mworion/MountWizzard4/README.rst

MountWizzard4
=============

.. note:: MountWizzard4 Version3 moved to a new repository
          https://github.com/mworion/MountWizzard4v3
          Only in case of interests in version 3, please
          refer to this repo. From now on MountWizzard4 repo
          is for version 4 and later.

Documentation:
--------------
There is a documentation available for MountWizzard4 (including the installation):
Please be noted that with the new installation you net not to install any python
package yourself!

https://mworion.github.io/MountWizzard4/index.html

Welcome to MountWizzard4 is a utility for 10micron users for improving the
workflow for astronomy work and imaging runs on Windows (10 and 11), OSx (Big Sur
- 26), Linux (Ubuntu 18.04 - 24.04) and some Linux ARM64 distributions
(Astroberry and StellarMate - both 64 bit). As a python application, it should
run in all environments supporting python 3.12-3.14 and PySide6 as a GUI
framework.

For being fully operational, MountWizzard4 needs either:

-   INDI server(s) (see: https://indilib.org) where your devices are connected to.

-   INDIGO server(s) (see: http://www.indigo-astronomy.org) where your devices
    are connected to.

-   ASCOM Alpaca remote server (see: https://ascom-standards.org/FAQs/Index.htm)
    abstracting your ASCOM devices or devices which speak native ASCOM Alpaca if
    you want to connect over IP with your environment.

-   For the core devices there is native ASCOM support (Windows platform only).
    Please be reminded, that ASCOM has 32bit and 64bit driver implementations
    and MW4 v4.x should **not** be installed in 32bit as it causes in some
    environments troubles. Please stay with a 64 bit python environment.

-   In addition an internet connection is used for some services which might be
    very helpful.

It is recommended to use mount firmware 3.4 or later as some
of the functions don't work with older firmware versions. It should not be a
problem using older versions. A HW pre2012 might also have some issues.

Versions, downloads
-------------------

(actually not relevant as no first release was issued)

|PYPI_VERSION| |PY_VERSIONS| |DownLoadsAbs| |DownLoadsMonth|

Code quality / tests:
^^^^^^^^^^^^^^^^^^^^^
|CODECOV| |PYTEST macOS| |PYTEST Windows| |PYTEST Ubuntu|

Code changes:
^^^^^^^^^^^^^
|OPEN_ISSUES| |CLOSED_ISSUES| |OPEN_PR|

Test install / run scripts:
^^^^^^^^^^^^^^^^^^^^^^^^^^^
|TEST_SCRIPTS_PYPI| |TEST_SCRIPTS_PACKAGES|

Test coverage:
^^^^^^^^^^^^^^
|CODECOV_CHART|

Commit status:
^^^^^^^^^^^^^^
|COMMITS_WEEK| |COMMITS_MAIN|

Changelog:

https://mworion.github.io/MountWizzard4/changelog/index.html

And there are some videos available for explanation in Youtube channel:

https://www.youtube.com/channel/UCJD-5qdLEcBTCugltqw1hXA/

Feedback discussions and issue reports:
---------------------------------------
Please report your issues: https://github.com/mworion/MountWizzard4/issues.
Please have a good description (maybe a screenshot if it‘s related to GUI) and
add the log file(s) to the issue. Any feedback welcome!

Please feel free to start any discussion:
https://github.com/mworion/MountWizzard4/discussions

Finally:
--------
MountWizzard4 is 'always' in development. The use this software is at your own
risk! No responsibility for damages to your mount or other equipment or your
environment, please take care yourself!

Hope this tool makes fun and helps for your hobby,

CS Michel

.. |PY_VERSIONS| image::
    https://img.shields.io/pypi/pyversions/mountwizzard4.svg

.. |PYTEST macOS| image::
    https://img.shields.io/github/actions/workflow/status/mworion/mountwizzard4/unit_macOS.yml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

.. |PYTEST Windows| image::
    https://img.shields.io/github/actions/workflow/status/mworion/mountwizzard4/unit_win.yml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

.. |PYTEST Ubuntu| image::
    https://img.shields.io/github/actions/workflow/status/mworion/mountwizzard4/unit_ubuntu.yml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

.. |CODECOV| image::
    https://codecov.io/gh/mworion/MountWizzard4/branch/main/graph/badge.svg
    :target: https://codecov.io/gh/mworion/MountWizzard4

.. |CODECOV_CHART| image::
    https://codecov.io/gh/mworion/MountWizzard4/branch/main/graphs/icicle.svg
    :target: https://codecov.io/gh/mworion/MountWizzard4
    :width: 80%
    :align: top

.. |OPEN_ISSUES| image::
    https://img.shields.io/github/issues-raw/mworion/mountwizzard4
    :target: https://github.com/mworion/MountWizzard4/issues

.. |CLOSED_ISSUES| image::
    https://img.shields.io/github/issues-closed-raw/mworion/mountwizzard4

.. |OPEN_PR| image::
    https://img.shields.io/github/issues-pr-raw/mworion/mountwizzard4

.. |COMMITS_MAIN| image::
    https://img.shields.io/github/commits-since/mworion/mountwizzard4/main
    :target: https://github.com/mworion/MountWizzard4/commits/main

.. |COMMITS_WEEK| image::
    https://img.shields.io/github/commit-activity/w/mworion/mountwizzard4

.. |TEST_SCRIPTS_PYPI| image::
    https://img.shields.io/github/actions/workflow/status/mworion/mountwizzard4/test_scripts_pypi.yml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

.. |TEST_SCRIPTS_PACKAGES| image::
    https://img.shields.io/github/actions/workflow/status/mworion/mountwizzard4/test_scripts_packages.yml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

.. |PYPI_VERSION| image::
    https://img.shields.io/pypi/v/mountwizzard4.svg
    :target: https://pypi.python.org/pypi/mountwizzard4

.. |DownLoadsAbs| image::
    https://static.pepy.tech/badge/mountwizzard4
    :target: https://pepy.tech/project/mountwizzard4

.. |DownLoadsMonth| image::
    https://static.pepy.tech/badge/mountwizzard4/month
    :target: https://pepy.tech/project/mountwizzard4
