mworion/MountWizzard4/2026-09-26-review.md

# MountWizzard4 – Project Review (2026-09-26)

Scope: `src/mw4` (excluding generated `src/mw4/gui/widgets`), `tests/`, `pyproject.toml`,
repository hygiene. Version reviewed: `4.0.0b34`.

Severity: **H** = likely bug / correctness risk, **M** = robustness / maintainability risk,
**L** = style / cleanup.

---

## 1. Overview

| Metric | Value |
|---|---|
| Python source files (w/o widgets, `__init__`) | 204 |
| Unit test files | 205 |
| Source lines (w/o widgets) | ~31.6k |
| Largest modules | `logic/buildData/alignstars.py` (840), `mountcontrol/obsSite.py` (740), `gui/styles/styleSheets.py` (703), `gui/mainWaddon/tabMount_Sett.py` (530) |
| `# pragma: no cover` in src | 0 |
| Fixture scopes | 166× `module`, 4× `function`  |

Overall the code base is in good shape: consistent src layout, near complete type
annotations, f‑strings, dataclasses/TypedDict, pathlib, context managers, timeouts on all
`requests` calls, no `eval`/`pickle`/`shell=True`/unsafe `yaml.load`, and a test file for
almost every module. The findings below are mainly about threading details, error
handling, protocol parsing robustness and architectural coupling.

---

## 2. Architecture

### 2.1 Strengths
- Clear layering `base` → `logic`/`mountcontrol` → `gui`; no `QtWidgets`/`QtGui` or
  `mw4.gui` imports found in `logic`, `base` or `mountcontrol`.
- `DeviceRegistry` + `DeviceEntry` give a uniform device lifecycle
  (`initConfig`/`storeConfig`/`startDevices`/`stopDevices`).
- Central `TimeManager` for cyclic updates instead of many scattered `QTimer`s.
- Generic worker infrastructure (`base/tpool.py`) with a per-worker mutex that prevents
  overlapping runs of the same job.
- Driver abstraction (INDI / ALPACA / ASCOM / SGPro / NINA) via common base classes
  (`AlpacaAscomCommon`, `DriverData`).

### 2.2 Findings

| # | Sev | Location | Finding |
|---|-----|---|---|
| A1 | M | `src/mw4/mainApp.py:34-111` | `MountWizzard4` acts as service locator / god object: 25 app-wide signals plus `threadPool`, `config`, `dReg`, `mainW`, `buildPoint`, `hipparcos`, `ephemeris`. Every component receives `app` and reaches through it (`self.app.dReg["mount"].obsSite...`), so dependencies are implicit and hard to test in isolation. Consider injecting only the needed collaborators or grouping signals into dedicated signal objects (UI, model, satellite). |
| A2 | M | `src/mw4/base/deviceEntry.py:28-80` | `DeviceEntry` re-exports many attributes of the wrapped instance (`signals`, `data`, `run`, `framework`, `obsSite`, `setting`, `location`, `timeJD`, `model`, …). This is a growing proxy that encodes mount-specific knowledge in a generic entry and encourages long attribute chains (law of Demeter). A typed accessor (`dReg.mount -> MountDevice`) would be clearer and type-checkable. |
| A3 | M | `src/mw4/base/deviceRegistry.py:47-52` | Test-only branch in production code: `if hasattr(app, "mount") and app.mount is not None:  # Test only`. The registry also writes back `app.mount = ...` as side effect. Test injection should happen via fixtures/monkeypatching, not via production branches. |
| A4 | M | `src/mw4/gui/mainWaddon/tabMount_Command.py:75` | GUI tab builds a `Connection` to the mount directly and talks the protocol. Protocol access belongs to `mountcontrol`; the tab should call a method on `MountDevice`. |
| A5 | M | `src/mw4/gui/mainWaddon/tabModel.py:44-46`, `tabModel_BuildPoints.py` | Model data handling (`ModelData`, model lists, point generation dispatch) lives in GUI mixins. Moving it to `logic/modelBuild` would improve testability and follow the stated logic/GUI separation. |
| A6 | L | `src/mw4/gui/mainWindow/mainWindow.py:72-88` | Main window wires many mount signals directly. Acceptable, but a single "mount state" view‑model signal would reduce coupling. |
| A7 | L | `src/mw4/logic/*` (34 files) | Logic depends on `PySide6.QtCore` (`QObject`, `Signal`, `QTimer`, `QMutex`). This is a deliberate design (Qt signals as event bus) and fine, but it means logic cannot be used headless without Qt. Document this decision. |
| A8 | L | camera, dome, cover, filter, focuser, lightPanel, telescope | Identical framework-dispatch boilerplate (`self.run = {"indi": ..., "alpaca": ..., "ascom": ...}`, `startCommunication`/`stopCommunication` forwarding). A shared `FrameworkDevice` base class would remove duplication. |

---

## 3. Threading / Concurrency

| # | Sev | Location | Finding |
|---|-----|---|---|
| T1 | H | `src/mw4/base/tpool.py:120-128` and `:80-82` | `worker.mutex.tryLock()` is executed in the calling (GUI) thread, `worker.mutex.unlock()` in the pool thread (`Worker.run` → `finally`). Qt documents that unlocking a `QMutex` from a different thread than the one that locked it is an error / undefined behaviour. It works today with the futex implementation but is not guaranteed. Use a thread-agnostic primitive (`threading.Lock`, a `QSemaphore(1)`, or an atomic "busy" flag) instead. |
| T2 | M | `src/mw4/base/tpool.py:115-126` | When an existing worker is reused, new `resultMethod`/`finishedMethod` arguments are silently ignored (only `args`/`kwargs` are replaced). Callers passing different callbacks on subsequent calls get the old ones. Either document or assert. |
| T3 | M | `src/mw4/base/alpacaAscomCommon.py:42,63,69,86,105` | `propertyExceptions` (plain `list`) is appended from the communication loop thread and read by other callers; membership test is O(n). Use a `set` and keep it thread-confined or protected. |
| T4 | M | `src/mw4/logic/camera/cameraSGPro.py:68-92` | Busy-wait loops `while self.parent.exposing and "..." not in self.data...: time.sleep(0.1)` have no timeout. If SGPro stops updating `Device.Message` (crash, disconnect) the worker thread spins until the user aborts; with `MAX_THREAD_COUNT = 30` a few stuck workers can starve the pool. Add a deadline. |
| T5 | M | `src/mw4/gui/mainWindow/mainWindow.py:171` | `closeEvent` blocks the GUI thread up to 10 s in `threadPool.waitForDone(10000)`; afterwards it continues regardless, so still-running workers may emit signals into destroyed Qt objects. Signal stop to long-running loops first and consider shorter, staged waits. |
| T6 | L | `src/mw4/logic/powerswitch/kmRelay.py:151`, `base/sgproClass.py:142` | `time.sleep` in workers – acceptable in pool threads, but not interruptible on shutdown. Prefer `threading.Event.wait()` like in `AlpacaAscomCommon`. |

---

## 4. Mount Communication (`mountcontrol`)

| # | Sev | Location | Finding |
|---|-----|---|---|
| M1 | H | `src/mw4/mountcontrol/obsSite.py:511-524` | `parsePointing` checks the number of chunks, but not the number of comma-separated fields: `responseSplit[0..7]` and `response[4].split(",")[1..4]` raise `IndexError` on a truncated/garbled answer. The exception escapes to `Worker.run` and is only logged as critical; polling state stays half-updated. Validate `len(responseSplit)` before assignment. |
| M2 | H | `src/mw4/mountcontrol/obsSite.py:553-560` | `parseSetTargetResponse` accesses `response[0][0:2]` and `response[0][2]` **before** the `len(response) != 4` check and without checking `len(response[0]) >= 3` → `IndexError` for short answers. Reorder checks. |
| M3 | M | `src/mw4/mountcontrol/firmware.py:54-58`, `obsSite.py:734` | Same pattern: direct index access on responses without length validation. |
| M4 | M | `src/mw4/mountcontrol/connection.py:334,358,377,413,463` | `except (OSError, Exception)` / `except (OSError, ValueError, TypeError, Exception)` – listing `Exception` makes the specific types meaningless and hides programming errors (e.g. `AttributeError`) as "socket error". Catch the concrete expected exceptions; let the rest reach the worker's error path. |
| M5 | M | `src/mw4/mountcontrol/connection.py:417-419` | `decode("ASCII")` raises `UnicodeDecodeError` for any non-ASCII byte besides `0xDF`; it is outside the `try` block (in `else`) and therefore escapes `receiveData`. Use `errors="replace"` or move into the guarded block. |
| M6 | M | `src/mw4/mountcontrol/connection.py:430-442` | A new `QTcpSocket` is created, connected and aborted for every command (connect timeout 10 s). This adds latency to every poll and many TIME_WAIT sockets on the mount; with 10+ concurrent pollers a hung mount blocks up to 10 workers for 10 s each. Consider a persistent, serialized connection or at least a shorter connect timeout. |
| M7 | L | `src/mw4/mountcontrol/connection.py:463-468` | `communicateRaw` returns the literal string `"Exception"` as value – callers cannot distinguish it from a real response. |
| M8 | L | `src/mw4/mountcontrol/mount.py:74,94` | `self.mountIsUp: bool = False` assigned twice in `__init__`. |

---

## 5. Device Drivers / Logic

| # | Sev | Location | Finding |
|---|-----|---|---|
| D1 | H | `src/mw4/base/alpacaAscomCommon.py:62-110` | Any exception – including transient `OSError`/timeouts – permanently blacklists the property/method in `propertyExceptions` for the lifetime of the object. If e.g. `Connected` times out once, `connectDevice()` and the disconnect detection in `runnerCommunicationLoop` stop working until restart. Distinguish "not implemented" (`NotImplementedException`, `AttributeError`) from transient communication errors and do not blacklist the latter (at least never `Connected`). |
| D2 | H | `src/mw4/base/alpacaAscomCommon.py:182-186` | `stopCommunication` sets `stopEvent` and then queues `Connected = False`. The loop exits on the next `stopEvent` check without processing the queue, so the device is never actually disconnected. Process the queue (or call `setDeviceProp` directly in the loop's exit path) before leaving. |
| D3 | L | `src/mw4/base/alpacaAscomCommon.py:54-55` | Dead code: `if valueProp == "ImageArray": pass`. |
| D4 | M | `src/mw4/logic/plateSolve/plateSolve.py:62-85` | `self.process` is an instance attribute shared across solves; `int(self.process.returncode)` after the `try` relies on it. Keep the `Popen` local (`with subprocess.Popen(...) as proc:`) to guarantee pipe cleanup; `stdout.decode()` should use `errors="replace"` (solver output may be non‑UTF‑8 on Windows). |
| D5 | L | `src/mw4/logic/dome/dome.py:196-200` | Without geometry, `x`/`y` are `None` and are passed on to `checkSlewNeeded`, which builds `np.array([x, y])`. Currently guarded by `checkTargetConditions()`, but the contract is implicit; return `None` explicitly or type as `float | None`. |
| D6 | L | `src/mw4/logic/dome/dome.py:161` | `targetInDomeShutter` uses `M - A` in the BC check; mathematically equivalent for a rectangle (AB ⟂ BC) but differs from the referenced formula (`M - B`) and is confusing. Also typo "mez" at line 172. |
| D7 | L | `src/mw4/logic/modelBuild/modelRun.py:118` | `next(self.modelRunIterator, False)` uses `False` as sentinel; use `None` for clarity and typing. |

---

## 6. Application Core / Configuration

| # | Sev | Location | Finding |
|---|-----|---|---|
| C1 | H | `src/mw4/mainApp.py:116-117` vs `:128` | Asymmetric config: `initConfig` reads the log level from `config["SettingUpdate"]["loglevel"]`, but `storeConfig` writes `config["loglevel"]` (top level). The stored value is never read back. |
| C2 | M | `src/mw4/gui/mainWindow/mainWindow.py:101-143`, `gui/extWindows/setting/tabSettUpdate.py:54` | `storeConfig` pattern `config[x] = {}` then refill: an exception half way leaves an empty section that is then saved. Build the dict locally and assign once. |
| C3 | L | `src/mw4/mainApp.py:105` | Commented-out code `# self.application.aboutToQuit.connect(...)`. |
| C4 | L | `src/mw4/mainApp.py:110-111` | Raw `sys.argv[1]` is pushed as a message; argument parsing belongs to `cli.py`. |

---

## 7. Python Usage & Tooling

| # | Sev | Location | Finding |
|---|-----|---|---|
| P1 | M | `pyproject.toml:34`, `README.rst:22`, `.github/copilot-instructions.md` | Inconsistent Python support: `requires-python = ">=3.12,<3.15"`, README says 3.11–3.13, instructions say 3.11. Align all three. |
| P2 | M | `pyproject.toml:36` vs `:27` | Classifier `Development Status :: 5 - Production/Stable` on beta version `4.0.0b34`. |
| P3 | M | `pyproject.toml:58-87` | All runtime dependencies hard pinned with `==`. Good for an application lock, but `uv.lock` already provides reproducibility; exact pins in `[project]` make installation next to other packages (e.g. in a user venv) fail easily. Consider `>=x,<next-major` in `pyproject` and keep exact versions in the lock file. |
| P4 | M | `pyproject.toml:150-153` | Ruff rule set lacks `B` (bugbear), `BLE`, `ANN`, `PL`, `N`, `TRY`. `ignore = ["N999", "BLE001"]` ignores rules from groups that are not even selected. Enabling `BLE` and `B` would have flagged M4; `ANN` would enforce the "type annotations everywhere" rule. No static type checker (mypy/pyright) is configured. |
| P5 | M | ~27 methods, e.g. `gui/extWindows/simulator/*.py`, `gui/styles/styles.py:70,155`, `gui/mainWindow/externalWindows.py:35,142`, `gui/mainWaddon/tabModel.py:210`, `gui/mainWaddon/tabModel_Manage.py:186`, `gui/extWindows/hemisphere/*.py` | Missing return type annotations (and some parameter annotations like `parent`, `mainW`), violating the project rule. |
| P6 | L | `src/mw4/base/tpool.py:45` | `os.path.basename` – use `Path(...).name` for consistency with the rest of the code base. |
| P7 | L | `pyproject.toml:9`, several files in `src_add/` | Header still says "GUI with PyQT5"; project uses PySide6. |
| P8 | L | `pyproject.toml:126` | `filterwarnings = ["ignore::DeprecationWarning"]` hides upcoming breakages of NumPy/Astropy/PySide6 in tests. Prefer `error::DeprecationWarning` for `mw4` modules only. |

---

## 8. Tests & Repository Hygiene

| # | Sev | Location | Finding |
|---|-----|---|---|
| R1 | M | `tests/unit_tests/mainApp/test_mainApp.py:~75` | Fixture teardown calls `app_instance.shutdown()`, which does not exist on `MountWizzard4`; the `AttributeError` is swallowed, so the app is never torn down between modules (threads/timers may leak into other tests). |
| R2 | M | `tests/unit_tests/logic/profiles/test_profile.py` | Real file I/O into `tests/work/config`; use `tmp_path` to avoid order dependence and parallel (`xdist`) conflicts. |
| R3 | L | 166 module-scoped fixtures | Consistent with the project rule, but state mutated in one test leaks into the next; tests must not rely on order. Keep an eye on this when running with `pytest-xdist`. |
| R4 | L | git index | Tracked `.DS_Store` files: `.github/`, `doc/`, `doc/config/`, `doc/workflows/`, `src/mw4/assets/`, `tests/` although `.gitignore` lists them. Remove with `git rm --cached`. |
| R5 | L | `tests/work/test.run`, `tests/work/empty.txt`, `log/` | Leftover artefacts / runtime logs in the working tree; verify they are intended. |

---

## 9. Recommended Priorities

1. **Correctness (H):** T1 (cross-thread mutex unlock), D1/D2 (ALPACA/ASCOM blacklisting and
   missing disconnect), M1/M2 (response parsing), C1 (log level config).
2. **Robustness (M):** M4/M5 (exception handling & decoding in `Connection`), T4 (timeouts in
   SGPro loops), T5 (shutdown sequence), R1 (test teardown).
3. **Tooling:** P1/P2 consistency, extend Ruff rules (`B`, `BLE`, `ANN`), add a type checker.
4. **Architecture (longer term):** A1/A2 reduce `app`/`DeviceEntry` reach-through, A4/A5
   move protocol and model logic out of GUI mixins, A8 shared framework-device base class.
