mworion/MountWizzard4/work_agent/2026-10-20_review_copilot.md

# MountWizzard4 – Code Review (2026-10-20)

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

## 1. Summary

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

| Area | Rating | Comment (re-rated 2026-10-23; was Architecture B, Maintainability B) |
|---|---|---|
| Architecture | A- | Layers enforced by import-linter, role protocols, typed registry, controllers; raw-dict configuration remains (A3) |
| Pythonic style  | B+ | Modern 3.12 typing, dataclasses, generators; some `hasattr`/dict plumbing |
| Maintainability | A- | Consistent conventions, shared `DeviceFacade`, tab controllers; ~12 long functions and docstring quality remain |
| Quality | A- | ruff clean, pyrefly 0 errors, 100 % coverage, few broad excepts (all justified), shared HTTP helper (Q3); thread-safety rule undocumented (Q5) |
| Testability | A- | 5.1k tests, strict 1:1 test-per-module layout (verified); heavy Qt/app stubbing, stress tests not in CI scope |
| Readability | B+ | camelCase consistent, short methods; a few outliers; origin visible in log format (R2 closed) |

## 2. Key figures

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

## 3. Strengths

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

## 4. Findings and recommendations

Priority: **H** high value, **M** medium, **L** low / cosmetic.

### 4.1 Architecture

| # | Pri | Finding | Recommendation |
|---|-----|---|---|
| A1 | H | ✅ **Done 2026-10-20 (WP 6.1–6.6)**: 8 role protocols in `base/appProtocol.py`, `AppProtocol` is their composition, signals grouped in `base/appSignals.py` (`app.signals.ui/.hemisphere/.model/.system`). **`app` is a god object.** `AppProtocol` exposes ~35 members including 25 signals; 842 `self.app.` uses in the GUI. Every tab/device implicitly depends on everything. | Split the Protocol into narrow role protocols (`HasConfig`, `HasThreadPool`, `HasDevices`, `HasMessaging`, `HasSignals`) and type each consumer with the smallest one. Group the 25 signals into 3–4 sub-objects (`app.signals.hemisphere`, `.model`, `.satellite`, `.ui`), mirroring the already existing `MountSignals`. |
| A2 | H | ✅ **Done 2026-10-20 (WP 5.1–5.6): typed `dReg.<device>` properties + `Literal` overloads.** **Stringly-typed device access**: 521 × `dReg["camera"]` etc. A typo is a runtime `KeyError`, no IDE completion, no typing of the returned instance (`DeviceEntry.instance` is effectively `Any`). | Expose typed attributes (`dReg.camera: Camera`, `dReg.dome: Dome`) or a `Literal[...]` key with `@overload` on `__getitem__`. Keep the dict internally for iteration. |
| A3 | H | **Configuration is an untyped nested dict** (`app.config[...]`, 438 accesses), each tab reads/writes its own keys in `initConfig`/`storeConfig`. Schema, defaults and migration are implicit and scattered. | Introduce per-component `@dataclass` config objects (already the case for device `run[framework].config`, see `collectConfigFromSingleDevice`) with `from_dict`/`to_dict` and defaults in one place. Add a schema/version field and a single migration hook. |
| A4 | M | ✅ **Done 2026-10-22 (plan A4):** `deviceRegistry` (composition root) moved out of `base`; `lint-imports` enforces `gui > logic > mountcontrol > base`, controllers ↛ drivers, independent controller areas, Qt-free foundations/controllers (2 documented QObject workers); ruff `TID251` bans `QtWidgets`/`QtGui`/`QtCharts` outside `gui`. Earlier: (◐ re-check 2026-10-20: `logic`/`mountcontrol` no longer import `gui`; only the type-only import in `base/appProtocol.py` remains; `audioManager` still uses `app.mainW`; 22 `logic` + 8 `mountcontrol` files import PySide6) **Layer leakage.** `logic` (15 files) and `mountcontrol` (4) import PySide6 – acceptable for `Signal`/`QThreadPool`, but `base/audioManager.py` reaches into `app.mainW` (a GUI object) and `logic` imports 1 GUI module. The stated "clear separation business logic vs GUI" is therefore only approximate. | Limit Qt in `logic` to `QObject`/`Signal`; pass a parent/handle into `AudioManager` instead of `app.mainW`; remove the `logic → gui` import (move shared item to `base`). Consider a small import-linter contract (`gui → logic → base`, never the reverse). |
| A5 | M | ✅ **Done 2026-10-22 (plan A5, phases 1–3):** controllers in `logic/controllers/{mount,image,satellites}`, tabs own a controller; tabs now 301 / 430 / 373 L (`tabMount_Sett` / `tabImage_Manage` / `tabSat_Track`). Earlier: (◐ partly done: image stats, tilt geometry and satellite track calculations moved to `logic/`; other tabs have only UI wiring left) **Inheritance/mixin for GUI composition.** Tabs are mixins plus `TabAddon`; several tabs (e.g. `tabMount_Sett.py` 504 L, `tabImage_Manage.py` 477 L, `tabSat_Track.py` 436 L) hold UI wiring, state and calculations together. | Keep widget wiring in the tab, move calculations/state transitions into plain classes in `logic` (testable without Qt). Prefer composition (tab owns a controller) over adding further mixins. |
| A6 | M | ✔ *done 2026-10-23: emitter/listener ownership documented in `base/appSignals.py`.* **Tab → tab decoupling** is largely honoured (only `TabAddon` is imported across tabs), but communication goes through the global `app` signals (`refreshModel`, `redrawHemisphere`, …). That is loose coupling in code, tight coupling in behaviour (any tab can fire any global signal). | Document ownership of each global signal (emitter vs. listeners); see A1 for grouping. |
| A7 | L | `MountWizzard4.__init__` has strict ordering requirements (`dReg` → `audioMgr` → `initConfig` → `buildPoint` → `mainW`) but this is encoded only by line order. | Split into small `setup*` steps with docstrings stating dependencies, or a tiny builder. |

### 4.2 Pythonic style

| # | Pri | Finding | Recommendation |
|---|-----|---|---|
| P1 | M | ✔ *done 2026-10-23, see `plan_P1_getattr_review.md`.* `hasattr`/`getattr` used 50 × (re-run 2026-10-20) (e.g. `hasattr(self.d[entry.name].instance, "signals")`, `hasattr(run[framework], "config")`). | Make "has signals / has config" part of a Protocol (`HasSignals`) or give every device default attributes; use `isinstance` against a runtime-checkable protocol. |
| P2 | M | Repeated `self.d[device].run[framework].config` chains in `DeviceRegistry.collectConfigFromSingleDevice` (4 evaluations per iteration). | Use local variables, and `dataclasses.asdict(config)` instead of manual field loop. |
| P3 | M | ◐ *2026-10-23: `run` typed, camera data keys are constants, `ProfileConfig` alias; see `plan_P3_typed_carriers.md`.* `dict[str, Any]` is the default data carrier (`Camera.data`, `run`, `config`). | Use `TypedDict` or dataclasses where keys are fixed; `run: dict[str, Any]` could be `dict[str, FrameworkDriver]` with a shared Protocol. |
| P4 | M | ✅ **Done 2026-10-20.** 173 logging calls used f-strings; all converted to lazy `%`-style, `G004` now enforced in ruff. | – |
| P5 | L | ✅ **Done 2026-10-20.** `generateAlignStars()` (825 lines) now returns a copy of the `ALIGN_STARS` constant in `logic/buildData/alignstars.py`; public API unchanged, the `PLR0915` ignore was dropped. | – |
| P6 | L | Many "constants" are instance attributes initialised to magic values (`posXASCOM`, `widthASCOM`, `exposureTime1`/`N`). Leading-underscore *attributes* (`_binning`, `_subFrame`) with property wrappers contradict the "no underscore" convention only partially. | Group into small dataclasses (`SubFrame`, `Binning`), keeping convention intact. |
| P7 | L | `# type: ignore` (3) and pyrefly `sub-config` that disables `bad-argument-type`, `bad-return`, `bad-assignment` for **all** of `mountcontrol`. | Accept as pragmatic for numpy/skyfield stubs, but track the 54 suppressed errors and tighten per-file over time (`pyrefly check --min-severity=warn` shows 30 additional warnings). |
| P8 | L | ✅ **Done 2026-10-20 (WP 8).** `base/platformInfo.py` is the only caller of `platform.system()` (was ≈60 hits); modules use `platformInfo.IS_WINDOWS` and `registerWindowsBackends`, tests patch the constants. Platform handling by `if platform.system() == "Windows":` in many modules (≈60 `platform` hits). | Centralise in `base/platform.py` (`IS_WINDOWS`) and use a back-end factory so devices don't branch inline. |

### 4.3 Maintainability

| # | Pri | Finding | Recommendation |
|---|-----|---|---|
| M1 | H | ✅ **Largely done 2026-10-23:** 6 functions > 50 L remain (largest 65 L, mostly declarative builders); A5 follow-up controllers for almanac/model exist. Earlier: **Oversized functions** (✅ roadmap 7: all `PLR0915` ignores removed, largest function 293 → 91 L, 25 → 16 over 50 L; remaining are mostly data tables, global statement budget still open): `measureAddons.dataPlots` 293 L, `devicePopupW.__init__` 154 L, `simulator/materials.__init__` 140 L, `simulator/telescope.create` 122 L, `tabSettDevice.__init__` 103 L, native-Qt dialog constructors 98–99 L. 25 functions > 50 lines in total. (mccabe ≤ 10 passes because they are linear, not branchy.) | Split into builder helpers (`createPlotAxes`, `createMaterial`, …); table-drive repetitive widget creation. Add a ruff `PLR0915` (too-many-statements) budget to prevent regrowth. |
| M2 | M | **Long parameter lists** in a few places: `qtInputDialog.__init__` 12 args, `tabSat_Search.calcSat` 9, `updateListSats` 8, `astroObjects.__init__` 8. | Use dataclass parameter objects or keyword-only args (`*,`). |
| M3 | M | ✅ **Done 2026-10-22 (plan M3).** The framework back-ends were already DRY (`*AlpacaAscomBase` + 9-line shells); the copy-paste sat in the nine device facades. They now share `logic/drivers/frameworks/deviceFacade.py` (`DeviceFacade[AppT]`: signals, back-end table, start/stop), −321 net source lines. Deliberately kept as they are (own signals, custom start/stop or fixed framework): `Measure`, `PlateSolve`, `Remote`, `KMRelay`, `SeeingWeather`, `DirectWeather`, `HidController`, `Keypad`. **Duplicated framework wrappers.** Per device there is `deviceIndi`, `deviceAlpaca`, `deviceSGPro`, `deviceAscom` plus shared `*Class.py` in `base`. This is a good pattern but likely contains copy-paste across devices (camera/focuser/dome/filter/cover). | Run a duplication scan (e.g. `pylint --enable=duplicate-code` or `jscpd`) and extract common bases/mixins for connect/disconnect/poll/error handling. |
| M4 | M | ✅ **Done:** driver framework classes live in `logic/drivers/frameworks/`, device packages under `logic/drivers/`, GUI-independent logic under `logic/controllers/<GUI area>/`; `base/` keeps infrastructure. `base/` mixes infrastructure (`tpool`, `loggerMW`, `bootstrap`) with domain-ish helpers (`transform`, `timeManager`, `ascomClass`, `sgproClass`, `indiClass`). | Move driver-protocol classes to `logic/drivers/` (or `base/drivers/`) to keep `base` dependency-free. |
| M5 | M | ✅ **Done 2026-10-20 (WP 8).** QSS moved to `assets/styles/{basic,mac,nonMac}.qss` templates with placeholders, rendered by `gui/styles/styles.py`; a golden-file test (`../tests/testData/styleGolden.json`) guards the output. Styles: `gui/styles/styleSheets.py` is 691 lines of Python-embedded QSS. | Move to `.qss` templates with placeholders; makes theming testable and diffable. |
| M6 | M | ✅ **Done 2026-10-20; signals now declared once in `AppSignals` (A1)** (contract test `test_concreteAppProvidesAllProtocolMembers`). `AppProtocol` is kept manually in sync with `MountWizzard4` (signals declared twice). `drawHorizonPoints` exists only on the concrete class but nothing consumes it, so its absence from the Protocol is intended. | Longer term: derive the signal list from one place (see A1). |
| M7 | L | Docstring style/language quality varies (e.g. typos in `alignstars` docstring: "assdataets", lower-case sentence starts, mixed numpy/rst). | Pick one style (Google or NumPy) and let ruff `D`-rules (limited subset) check public APIs. |
| M8 | L | `DeviceRegistry.addDevices(app)` takes `app` although `self.app` already exists; `("refraction", lambda _app: None, None, False)` is a placeholder device entry. | Remove the redundant parameter; model "no instance" explicitly rather than with a lambda returning `None`. |

### 4.4 Quality, robustness, error handling

| # | Pri | Finding | Recommendation |
|---|-----|---|---|
| Q1 | M | ✅ **Done 2026-10-20.** `Worker.run` now has one `except Exception` branch that logs the full `traceback.format_exc()` and emits a short error string; the manual `tb_next` walk and `formatTbFrame` are gone. | – |
| Q2 | M | Broad excepts in `alpacaAscomCommon` (3) are justified by the driver boundary and documented in `per-file-ignores` – good. Keep a regression test per classification branch of `handleDeviceError`. | – |
| Q3 | M | ✅ **Done 2026-10-23:** `base/httpClient.py` (`request` with default timeout and retry on connection errors/timeouts, `safeRequest` logs and returns `None`); all `requests` calls in `src` use it. Earlier: (◐ re-check 2026-10-20: `S113` is enforced and every `requests` call has a `timeout`; no shared helper or retry policy yet) Network/IO paths (`requests`, `websocket-client`, `astroquery`, mount TCP in `mountcontrol/connection.py`, 462 L) – verify consistent timeouts, retries and error-to-signal mapping. | Introduce one `base/ethernet.py`-style helper for HTTP with default timeout and shared error handling; forbid bare `requests.get` without `timeout=` via ruff `S113`. |
| Q4 | L | `ascomClass.py` builds a Python snippet as a string (`"print(result if result else '', end='')"`) for execution via a subprocess. | Fine as a pragmatic COM isolation; make sure the string composition never includes user-controlled input (security review recommended, Windows only). |
| Q5 | L | Thread-safety relies on `QThreadPool` max 30 and a busy lock; shared mutable state (`Camera.data`, `app.config`) is mutated from workers and GUI thread. | Document the rule "workers return data via signals, GUI thread mutates state" and test it. |

### 4.5 Testability

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

### 4.6 Readability

| # | Pri | Finding | Recommendation |
|---|-----|---|---|
| R1 | M | Consistent camelCase (a deliberate, documented deviation from PEP 8; `N999` ignored). Reasonable for a Qt code base, but ruff `N`-rules cannot help enforce it. | Keep; add a tiny custom check or pre-commit grep for `snake_case` defs if drift appears. |
| R2 | M | ✅ **Closed 2026-10-23, no change:** the log format already prints file name and line number (`%(filename)20.20s`/`%(lineno)4s`), so the origin is not lost; migrating would break `setCustomLoggingLevel` on the `"MW4"` logger. Earlier: Module-level `log = logging.getLogger("MW4")` as a *class attribute* in 60 classes. | One logger per module (`logging.getLogger(__name__)`) is idiomatic and gives per-module filtering; current single-name logger loses origin unless the formatter prints `%(module)s`. |
| R3 | L | ✅ Partly done 2026-10-20: commented-out code in `keypad.py` removed. ✔ Done: long section banners replaced by one-line comments (src, src_add, tests). | – |
| R4 | L | ✔ Done: typos fixed, docstrings start capitalised, no German found. `continous` kept (UI/config key). | – |
| R5 | L | Header banner in `../pyproject.toml` (ASCII art) and per-file headers are noise-free, but the file header in modules differs from the project banner. ✔ Done: all modules, tests, tasks, doc and src_add use the 3-line project header. | – |

### 4.7 Repository hygiene and delivery

| # | Pri | Finding | Recommendation |
|---|-----|---|---|
| H1 | H | (◐ re-check 2026-10-22: `gists/`, `../work` and `log/` are no longer tracked; `.git` is 1.2 GB, almost all of it old history, mainly the generated `mw4/resource/resources.py`; `HEAD` still has 70 MB test images and duplicated runtime data, see `work_agent/plan_H1_repository_slimming.md`; **Decision 2026-10-23: no history rewrite (`git filter-repo`) – rejected due to broken hashes/forks/PRs/tags; history stays as is.**) `.git` is **1.4 GB**; large binaries (ephemeris `de440_mw4.bsp`, finals data, assets 16 MB) historically committed. | Move runtime dirs (`../work`, `log/`) out of version control (`.gitignore`), keep `gists/` in a separate repo or docs. Consider `git lfs` or download-on-first-start for big data; `git filter-repo` history rewrite is rejected (decision 2026-10-23). |
| H2 | M | `../.idea` and `.coverage` present in the working tree. (re-check 2026-10-20: `.coverage` is ignored, `.idea/` is still untracked and **not** in `.gitignore`.) | Add `../.idea` to `.gitignore`. |
| H3 | M | Exact pins on core scientific packages (`numpy==2.5.4`, `astropy==8.0.2`, `pyside6==6.12.0`, `photutils==3.1.1`) – good for reproducibility, but libraries consumers of the PyPI package get over-constrained. | Fine for an application. Keep Renovate/Dependabot to bump regularly; document the pin policy. |
| H4 | L | ✅ **Done 2026-10-20.** Console scripts reduced to `mw4` and `mountwizzard4`. | – |
| H5 | L | ✅ **Done 2026-10-20.** Classifier changed to `Development Status :: 4 - Beta`. | – |

## 5. Suggested roadmap

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

## 6. Conclusion

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
