mworion/MountWizzard4/doc/index.rst

Welcome to MountWizzard4!
-------------------------
MountWizzard4 is a general utility for 10micron users for improving the workflow 
for astronomy work. It runs on Windows11, Windows10, Mac OSX (beginning from
10.12 to 26.x) and Linux (Ubuntu from 16.04 to 26.04). If you have some knowledge
around Raspberry Pi's and other SOC, you might be able to install MountWizzard4 on
a RPi4 or RPi5.

The PDF version of the documentation could be found here: https://mworion.github.io/MountWizzard4/mountwizzard4.pdf

.. hint::   MountWizzard4 version 4 is a major release with many new features
            and improvements. Please check the changelog for details:
            https://mworion.github.io/MountWizzard4/changelog/changelog.html.
            Actually this is a beta version ! Please check the known limitations
            and report any issues you find. Install it to a new workdir and do not
            overwrite your existing v3 installation. You can have both versions
            installed at the same time.

Before starting
===============
First let us have a look to the basic architecture: MountWizzard4 is an application
installed on your external computer which is connected to the mount computer via
an IP connection. The best choice is to use a wired connection. As the 10micron
mounts also support a serial line, please be reminded MountWizzard4 does not! 
Many of the features are handled on the mount computer itself and MountWizzard4 
does the GUI frontend for the user by using the command protocol provided by 
10micron.



The basic idea is that MountWizzard4 will try to generate "digital twin" for 
the mount. All parameter changes for the mount will be sent to it and changes 
of it's state are polled to make status visible in MountWizzard4. Therefore 
regular polling of data is needed.

Overview
========
Beside this documentation there is a youtube channel available with descriptions,
previews, explanations:

https://www.youtube.com/channel/UCJD-5qdLEcBTCugltqw1hXA

For full operation MountWizzard4 supports several frameworks: INDI / INDIGO,
ASCOM, Alpaca and in addition Sequence Generator Pro and N.I.N.A. as camera device.

Known limitations
=================
MountWizzard4 v4 does support python 3.11 - 3.14 right now. The reason for that
is the lack of precompiled packages. Some features are limited to windows as 
they need the original 10micron updater program for execution. As python moves
with its releases forward, also MountWizzard4 will follow.

On windows please check if you are working in a 32bit or 64bit environment. You
need to choose the ASCOM setup (drivers etc.) and the python install accordingly.

If you are using the 10micron updater features on windows, MountWizzard4 remote
controls the updater application. Please do not interrupt this automation.

Reporting issues
================
To have an eye on your setup here are some topics which you could check:

- Mount connection available and stable. Wifi might have performance problems.
  Look for right network settings in mount and local setup.

- Good counter check is review settings, status bars, message window if something
  is going wrong.

To improve quality and usability any feedback is highly welcome! To maintain a 
good transparency and professional work for my, please respect the following
recommendations how to feed back.

.. note:: Please report issues / bugs here:

          https://github.com/mworion/MountWizzard4/issues.

          And if you have feature requests discussions or for all other topics of
          interest there is a good place to start here:

          https://github.com/mworion/MountWizzard4/discussions

In case of a bug report please have a good description (maybe a screenshot if it‘s
related to GUI) and add the log file(s). Normally you just could drop the log file
(or PNG in case of a screen shot) directly to the webpage issues on GitHub. In
some cases GitHub does not accept the file format (unfortunately for example FITs
files). I this case, please zip them and drop the zipped file. This will work. If
you have multiple files, please don‘t zip them to one file! I need them separated
and zipped causes more work.

If changes are made due to a feedback, new releases will have a link to the closed
issues on GitHub.

Table of contents
=================

.. toctree::
    :maxdepth: 3

    features
    install/index
    config/index
    workflows/index
    help/index
    architecture/index
    changelog/changelog
