mworion/MountWizzard4/gists/work_agent/2026-09-29-review.md

# MountWizzard4 – Code & Architecture Review

**Date:** 2026-09-29
**Previous review:** [2026-06-10-review.md](2026-06-10-review.md)
**Scope:** `src/mw4` (logic, gui, base, mountcontrol) and `tests/unit_tests`
**Baseline:** `671cdfce6` (beta34, 567 commits since the previous review)
**Dimensions reviewed:** PySide6 / Qt6 usage, Pythonic style, architecture,
simplicity, performance, maintainability, test health.

> This is an assessment with prioritized recommendations. It does **not** change
> any code. Findings point to concrete files and symbols so they can be acted on
> directly.

---

## 1. Executive Summary

Since the June review the codebase has improved noticeably. Six of the ten
recommendations are **fully resolved**: the pragmas, misplaced docstrings,
magic mount status codes, repetitive `addDevices`, per-second twilight and disk
computation, hard-coded thread count, and the missing `TabAddon` contract. Ruff
reports no findings and the full suite (4545 tests) passes serially.

The open items are the same structural ones as before: the **nested event loop
sleep** (`mainThreadSleep`), which now also runs inside the model build **logic**
layer, the **`app: Any` seams**, and the **untyped app-level signal hub**. The
new findings are about **dead leftovers from the reverted Alpaca server
discovery**, **test isolation under `pytest-xdist`**, and a **coverage setup
that does not yet match the Windows-only coverage policy**.

**Overall maturity rating:** Strong (4 / 5), trending up.

| Dimension | Jun | Sep | Short note |
|---|:---:|:---:|---|
| PySide6 / Qt6 | 4/5 | 4/5 | Blocking sleep still in 9 places, 3 `processEvents` loops |
| Pythonic style | 4/5 | 5/5 | Docstrings/pragmas fixed; Ruff clean |
| Architecture | 4/5 | 4/5 | `MountStatus` + `TabAddon` added; `app: Any` remains |
| Simplicity | 3/5 | 4/5 | Registry and status GUI now data-driven |
| Performance | 4/5 | 4/5 | Twilight/disk moved to 30 s; model loop busy-waits |
| Maintainability | 4/5 | 4/5 | Dead Alpaca-server code; xdist-unsafe tests |
| Test health |  –  | 4/5 | 4545 passed, 99 % coverage (Windows-only gaps on macOS) |

> **Status 2026-09-29:** recs 1–9 and 11 are done. `mainThreadSleep` is gone
> (the model run is event-driven), `app: Any` is gone, the signal payloads are
> typed, the `-n auto` runs are stable, and coverage is 100 % (4583 passed).
> Open: 10. See section 10.

---

## 2. Status of the 2026-06-10 Recommendations

| #  | Recommendation (June) | Status | Evidence |
|----|---|---|---|
| 1  | Replace `mainThreadSleep` nested loop | ✅ Done (Sep) | Implemented 2026-09-29 as Sep recs 1 + 2: all call sites replaced, `base/threadUtils.py` deleted (see section 10) |
| 2  | Remove `# pragma: no cover` | ✅ Done | No pragmas left in `src/mw4` |
| 3  | Fix misplaced string "docstrings" in `mainApp.py` | ✅ Done | Converted to `#` comments |
| 4  | `App` `Protocol` instead of `app: Any` | ✅ Done (Sep) | Implemented 2026-09-29 as Sep rec 6: `base/appProtocol.py`; 0 × `app: Any`, 0 × `mainW: Any` left (see section 10) |
| 5  | Split app-level signal hub into typed groups | 🟡 Partial | Time signals moved to `TimeManager`. Hub payloads typed in Sep rec 9 (`msg` is `(int, str, str, str)`); the split into groups is still open |
| 6  | Mount status enum / helpers | ✅ Done | `MountStatus(IntEnum)`, `ObsSite.isTracking`, `ObsSite.isParked`, used in `updateStatusGUI` |
| 7  | Data-drive `addDevices` and `updateStatusGUI` | ✅ Done | `deviceSpec` table in `DeviceRegistry.addDevices`; tuple list in `updateStatusGUI` |
| 8  | Move disk/twilight to a slower cadence | ✅ Done | `updateTwilightAndDisk` on `timeMgr.update30s` |
| 9  | `TabAddon` base for addon lifecycle hooks | ✅ Done | All tabs subclass `TabAddon`; `hasattr` guards removed from `MainWindowAddons` |
| 10 | Use `MAX_THREAD_COUNT` instead of hard-coded `30` | ✅ Done | `mainWindow.py` reads `self.app.MAX_THREAD_COUNT` |
| –  | Test hooks in production code (section 6) | ❌ Open | `MountWizzard4(test: int = 0)`, `hasattr(app, "mount")` injection in `DeviceRegistry.__init__` |

---

## 3. PySide6 / Qt6

### 3.1 `mainThreadSleep` now also drives model build logic (High) – ✅ resolved 2026-09-29 (recs 1 + 2)

[`base/threadUtils.py`](../../src/mw4/base/threadUtils.py) still runs a nested
`QEventLoop` to "sleep". Current call sites:

| File | Line(s) | Use |
|---|---|---|
| `logic/modelBuild/modelRun.py` | 211, 307  | Wait/pause loop and **main batch loop** |
| `gui/mainWaddon/tabModel.py` | 196 | 1 s pause |
| `gui/mainWindow/externalWindows.py` | 180 | 50 ms between window closes |
| `gui/extWindows/video/videoBase.py` | 142 | 1 s pause |
| `gui/extWindows/downloadPopupW.py` | 156 | 500 ms pause |
| `gui/extWindows/uploadPopupW.py` | 202, 209  | Polling + pause |
| `gui/extWindows/analyseW.py` | 464 | `mainThreadSleep(0)` used as `processEvents()` |

The worst case is `ModelRun.runThroughModelBuildData`:

```python
while not self.cancelBatch and not self.endBatch and not self.checkModelFinished():
    mainThreadSleep(500)
```

For the whole model run, the application runs inside a nested event loop. Any
re-entrant signal (start another model, close the window, switch profile) runs
on top of that stack. The code is also in the **logic** layer but depends on a
Qt event loop helper, which weakens the logic/GUI separation.

**Recommendation:** Make the model run event-driven. Replace the batch loop with
a state machine that moves forward on the existing signals (slew finished, image
saved, solve result), and use `QTimer.singleShot` for the timed waits. The GUI
helpers in `externalWindows`, `videoBase`, and the popups can use
`QTimer.singleShot(ms, continuation)` directly.

### 3.2 `QApplication.processEvents()` inside population loops (Medium)

[`tabAsteroid.py`](../../src/mw4/gui/mainWaddon/tabAsteroid.py) (l. 172),
[`tabComet.py`](../../src/mw4/gui/mainWaddon/tabComet.py) (l. 173) and
[`tabTools_Rename.py`](../../src/mw4/gui/mainWaddon/tabTools_Rename.py) (l. 142)
call `processEvents()` once per table row. This has the same re-entrancy risk as
3.1, and it slows large lists because every row triggers a full event pass.

**Recommendation:** Fill the table with `setUpdatesEnabled(False)` / `True`
around the loop, or insert the rows in chunks with `QTimer.singleShot(0, …)`.
For large catalogs, a `QAbstractTableModel` with a `QTableView` removes the
per-item cost completely.

### 3.3 Untyped signal payloads (Low/Medium, unchanged) – ✅ resolved 2026-09-29 (rec 9)

There are still 53 `Signal(object, …)` declarations. The main ones are
`mountcontrol/mountSignals.py` (12), `mainApp.py` (10) and
`gui/extWindows/keypadW.py` (8). `MountWizzard4.msg = Signal(object, object,
object, object)` is emitted with `(int, str, str, str)` everywhere and should be
typed like that.

### 3.4 Teardown noise in the test run (Low)

A serial full run ends with `QMutex: destroying locked mutex` and `RuntimeError:
Signal source has been deleted` from `MountTime.runnerMountUp`. That means a
worker still emits after its owning `QObject` has been deleted. It is harmless
in tests, but at application shutdown the same pattern can crash. Wait for the
worker or disconnect it before the owner goes away (the same approach as
`threadPool.waitForDone` in `closeEvent`).

---

## 4. Architecture

### 4.1 `app: Any` seams (Medium, unchanged) – ✅ resolved 2026-09-29 (rec 6)

53 constructors take `app: Any` and 24 take `mainW: Any`. This is still the
biggest gap between the strong typing policy and the real dependency surface.
The proposal in
[`2026-06-10-proposal-rec4-AppProtocol.md`](2026-06-10-proposal-rec4-AppProtocol.md)
is still valid. Now that `TabAddon`, `DeviceRegistry`, and `TimeManager` are
stable, it is a good time to implement it.

### 4.2 Dead code left from the reverted Alpaca server discovery (Medium, new)

Commit `9640a77f1` moved server discovery to a feature branch, but
[`devicePopupW.py`](../../src/mw4/gui/extWindows/devicePopupW.py) still contains:

- `setAlpacaServer()` (l. 278–283), which reads `self.ui.alpacaServerList`. That
  widget no longer exists in the generated UI or in `src_add/widgets`.
- The `elif framework == "alpacaServer":` branch in `discoverDevices` (l. 299–300),
  which calls `deviceInstance.discoverDeviceServer()`. That method is not
  defined anywhere in `src/mw4`.

Both paths are unreachable today and would raise `AttributeError` if they were
reached. They are also the only uncovered non-Windows lines in that module.

**Recommendation:** Remove both on the main branch and keep them only on the
feature branch.

### 4.3 Test hooks in production code (Low, unchanged)

`MountWizzard4(test: int = 0)` (connects `update10s` to `mainW.close`) and the
`hasattr(app, "mount")` injection in `DeviceRegistry.__init__` are still there.
Passing the mount instance (or a factory) into `DeviceRegistry` would keep the
production path free of test concerns.

---

## 5. Correctness Observations

### 5.1 Unit of `waitTimeExposure` (Low, needs checking) – ✅ fixed 2026-09-29 (rec 8, with rec 1)

In `ModelRun.startNewImageExposure`:

```python
waitTime = self.waitTimeExposure
while self.pauseBatch or waitTime > 0:
    mainThreadSleep(500)
    waitTime -= 1
```

The spin box (`waitTimeExposure`, 0–300, 0 decimals) reads as seconds. The loop
takes off one unit every 500 ms, so the real wait is **half** the configured
value. Check which unit is intended and either sleep 1000 ms per step or
subtract 0.5. This goes away with the timer-based rewrite from 3.1.

### 5.2 Broad `except Exception` in `tabSat_Search` (Low) – ✅ fixed 2026-09-29 (rec 11)

`SatSearch` (l. 280) catches `Exception` around the whole filter loop and logs
at `debug`. Real failures are hidden, and `sat` may be unbound in the log
message if the exception happens before the first iteration. Catch only the
expected exceptions and log at `warning`.

### 5.3 Dead branch in `AlpacaAscomCommon.getDeviceProp` (Low) – ✅ fixed 2026-09-29 (rec 11)

```python
if valueProp == "ImageArray":
    pass
```

This branch does nothing (l. 54–55). It is the only uncovered line in the
module. Remove it.

### 5.4 `PlateSolve.runSolverBin` (Informational) – ✅ fixed 2026-09-29 (rec 11)

The recent refactor to `communicate(timeout=…)` with `kill()` + drain on
timeout is correct and fully covered. Small cleanup: in the timeout branch,
`stdout, _ = self.process.communicate()` assigns a value that is never used, so
`self.process.communicate()` alone is enough.

---

## 6. Performance

- The single 100 ms timer with fan-out and the move of twilight/disk to 30 s are
  good.
- `ModelRun` busy-waits every 500 ms for the whole run (3.1). An event-driven
  flow removes that wake-up and the nested loop.
- `processEvents()` per table row (3.2) is the main UI performance problem for
  large asteroid/comet catalogs.
- Blocking `time.sleep` only runs in worker threads (`cameraSGPro`,
  `sgproClass`, `kmRelay.runnerPulse`), which is fine.

---

## 7. Test Health

| Metric | Result |
|---|---|
| Ruff check / format | ✅ clean (463 files) |
| Serial run (`pytest tests/unit_tests`) | ✅ 4545 passed, 38 skipped, ~19 s |
| Parallel run (`-n auto`) | ❌ 10 failed, 44 skipped (all pass serially) |
| Coverage (macOS, serial) | 99 % (63 of 18,461 statements missed) |

### 7.1 Tests are not isolated under `pytest-xdist` (Medium, new)

`pytest-xdist` is installed, but with `-n auto` these tests fail. All of them
pass serially:
`test_tabMount_Sett::test_updateSettingGUI_10..14`,
`test_measure::test_checkStart_1/2`, `test_modelRun::test_checkModelFinished_2`,
`test_modelRunSupport::test_loadModelsFromFile_2`,
`test_profile::test_loadProfileStart_3`.
The likely causes are the shared `tests/work/*` directories that module-scoped
fixtures write to and delete (e.g. `glob.glob("tests/work/image/*.fit*")` +
`os.remove`), and test-order-dependent module fixture state.

**Recommendation:** Use `tmp_path` / `tmp_path_factory` for file artifacts, or
mark the affected modules with `xdist_group`. Also set values that a test
depends on inside that test rather than relying on earlier tests.

### 7.2 Coverage config does not match the Windows policy (Low/Medium, new)

The project policy is to write Windows tests but count them for coverage only on
Windows. On macOS almost all of the missing 1 % is Windows-only code:
`base/ascomClass.py` (37 %), `logic/camera/cameraAscom.py` (0 %), and the
`if platform.system() == "Windows":` imports/branches in `camera`, `cover`,
`dome`, `filter`, `focuser`, `lightPanel`, `sensorWeather`, `telescope`, and
`pegasusUPB`. `[tool.coverage]` has no platform-dependent exclusion, so a
100 % gate can never pass on macOS or Linux.

**Recommendation:** Add platform-conditional coverage (for example
`coverage-conditional-plugin` with a `sys_platform != "win32"` rule, or a
per-OS `omit` for the `*Ascom*.py` modules). After that, the only real
non-Windows gaps are `alpacaAscomCommon.py:55` (5.3),
`indiClass.py:144` (`discoverMutex.tryLock()` contention path, needs a test),
and `devicePopupW.py:279-283, 300` (4.2, to be deleted).

---

## 8. Prioritized Recommendations

Effort: S (small), M (medium), L (large). Impact: ★ low → ★★★ high.

| #  | Recommendation | Impact | Effort |
|----|---|:---:|:---:|
| 1  | ✅ Make `ModelRun` event-driven; remove `mainThreadSleep` from logic layer  |  ★★★ | L |
| 2  | ✅ Replace remaining GUI `mainThreadSleep` calls with `QTimer.singleShot` |  ★★ | M |
| 3  | ✅ Remove dead Alpaca-server code from `devicePopupW.py` |  ★★ | S |
| 4  | ✅ Make tests xdist-safe (`tmp_path`, no shared `tests/work` mutation) |  ★★ | M |
| 5  | ✅ Platform-conditional coverage so the 100 % gate works on every OS |  ★★ | S |
| 6  | ✅ Introduce the `App` `Protocol` (see June proposal) |  ★★★ | M |
| 7  | ✅ Replace per-row `processEvents()` in Asteroid/Comet/Rename tabs |  ★★ | S |
| 8  | ✅ Check/fix the `waitTimeExposure` unit (half-wait) |  ★★ | S |
| 9  | ✅ Type the remaining `Signal(object, …)` payloads, starting with `msg` | ★ | M |
| 10 | Remove test hooks from `MountWizzard4` / `DeviceRegistry` | ★ | S |
| 11 | ✅ Small cleanups: `ImageArray` no-op branch, broad `except` in `tabSat_Search`, unused `stdout` in `runSolverBin`, add a test for `indiClass.py:144` | ★ | S |

### Suggested sequencing

1. **Quick wins (S):** 3, 5, 7, 8, 11. These are low risk and bring
   non-Windows coverage to a real 100 %.
2. **Test infrastructure (M):** 4. This makes `-n auto` usable and shortens
   feedback loops.
3. **Typing (M):** 6, then 9 on top of the `Protocol`.
4. **Concurrency refactor (L/M):** 1, then 2. This needs a short plan first
   because it touches `ModelRun`, `tabModel`, and the model status GUI.

---

## 9. Closing Note

Most of the June review has been implemented, and the code is cleaner, more
data-driven, and easier to type. The remaining structural risk is in one place:
the nested event loop used to sequence long operations, which now sits at the
core of the model build. Fixing that (#1) is the most valuable change. The
cheapest wins are removing the dead Alpaca-server code (#3) and making coverage
platform-aware (#5), which together let the project enforce its 100 % coverage
rule on every OS.

---

## 10. Implementation Update (2026-09-29)

Recommendations **1–9 and 11** are implemented (plans:
`plan-review-2026-09-29-rec-3-5-11.md`,
`plan-review-2026-09-29-rec-7-processEvents.md`,
`plan-review-2026-09-29-rec-4-xdist.md`,
`plan-review-2026-09-29-rec-6-AppProtocol.md`,
`plan-review-2026-09-29-rec-2-mainThreadSleep.md`,
`plan-review-2026-09-29-rec-1-modelRunEventDriven.md`,
`plan-review-2026-09-29-rec-9-typedSignals.md`).

| #  | Change | Status  |
|----|---|---|
| 2  | 3.1: GUI `mainThreadSleep` calls replaced. `analyseW.drawAll` drops the `mainThreadSleep(0)` event pass; `videoBase.restartVideo` and `downloadPopupW.closePopup` use `QTimer.singleShot`; `externalWindows.closeExtendedWindows` drops the 50 ms stagger (stays synchronous for the `closeEvent` path); `uploadPopupW.closePopup` no longer busy-waits — finalization is driven by the poll worker `finished` signal (`finishPollStatus` / `finalizeUpload`) and the close is a `QTimer.singleShot`. The `modelRun.py` sleeps (211, 307) and `tabModel.clearAlignAndBackup` (196) were done with rec 1 (see its row). | ✅ Done |
| 3  | `setAlpacaServer()` and the `alpacaServer` branch in `discoverDevices` removed from `devicePopupW.py` | ✅ Done |
| 5  | `coverage-conditional-plugin` added (dev). On non-Windows, `if platform.system() == "Windows":` blocks are excluded by a regex rule (no pragmas in source), and `base/ascomClass.py` and `logic/camera/cameraAscom.py` are omitted. On Windows, all of this code is still counted. | ✅ Done |
| 11 | `ImageArray` no-op removed; `runnerCalcSatList` now catches only `ArithmeticError`, `AttributeError`, `IndexError`, `TypeError`, `ValueError`, logs at `warning`, and uses the satellite name (never unbound); unused `stdout` removed from the `runSolverBin` timeout branch; new test `test_discoverDevices_mutexLocked` for `indiClass.py:144` | ✅ Done |
| 7  | 3.2: `fillAsteroidListName` / `fillCometListName` fill in one batch (`setRowCount(n)` instead of per-row `insertRow`, `setUpdatesEnabled(False)` inside `try/finally`, no `processEvents()`); the cell setup is data-driven and the number column uses the row index. `filterListAsteroids` / `filterListComets` get the same repaint suppression. Rename: file work moved to `runnerRenameFiles` in the thread pool (`workerRenameFiles`). The GUI thread snapshots the file list, target dir, object name and selector texts. Progress comes back through `RenameSignals.progress`, and the result message comes from the worker `result`. `renameStart` is disabled until the worker `finished` signal. The file is now renamed after it is closed. Snapshotting the list also fixes the glob-while-renaming issue. The unused `getNumberFiles` was removed. | ✅ Done |
| 4  | 7.1: `tests/conftest.py` gives each xdist worker its own sandbox. It symlinks the repo and copies `tests/work`, so no worker changes another worker's files. `--dist=loadfile` in `addopts` keeps each module on one worker, which protects module-scoped fixtures. Order-dependent tests were fixed in 33 modules: each test now sets the state it needs, autouse fixtures reset shared state, and locked workers are released. Leaks found along the way: real `TimeManager` timers left running by the `mainWindow` / `mainApp` fixtures (the `mainApp` fixture called a non-existent `shutdown()`), `SatData.satellites` class state, `groupImageActions` left disabled, and a cleanup that deleted the tracked `tests/work/config/empty.txt`. `mainApp.py:111` was only covered through pytest's own `argv`; it now has `test_init_withArgument`. Verified with a temporary order harness (per-module reverse order plus 12 shuffle seeds, `-n 8`): only the 3 native dialog `exec` tests fail, and those fail by design of the harness. | ✅ Done |
| 6  | 4.1: `base/appProtocol.py` with one `@runtime_checkable AppProtocol` (consumer surface only: 16 attributes, 23 signals as `SignalInstance`, `initConfig`, `storeConfig`; type-only `mw4` imports, no cycles). All 53 `app: Any` sites use `AppProtocol`, and all 24 `mainW: Any` sites use `"MainWindow"` (import under `TYPE_CHECKING`, which is excluded from coverage). `app: Any = None` defaults were removed. Latent production bugs fixed: `app.relay`, `app.measure` and `app.deviceStat` existed only on the test stub and now read via `app.dReg[...]`. `KMRelay.switch` / `pulse` return `bool`. Tests: `test_appProtocol.py`, plus `test_satisfiesAppProtocol` against the real `MountWizzard4`. Details below. | ✅ Done |
| 1, 8 | 3.1 / 5.1: `ModelData` is event-driven. `runModel` only starts the run. A pass ends when `collectPlateSolveResult` finds all points processed and queues `finishPass` (`QTimer.singleShot(0, …)` plus a `passActive` guard against re-entrancy from the "Slew not possible" path). `finishPass` starts the next retry pass or calls `finishModel`, which emits the new `finished(cancelled)` signal. `cancelRun` / `endRun` finish at once. The exposure wait is a single-shot `QTimer` (`checkPauseAndExpose`, 500 ms pause poll) and waits the full configured seconds (5.1 fixed). GUI: `runBatch` → `clearAlignAndBackup(startBatch)` (1 s `QTimer` instead of the sleep) → `startBatch` → `finishBatch` slot. `runFileModel` → `programFileModel` as continuation. Also fixed: the timing selection was ignored (`timing` vs `modelTiming`), the model name was never stored (`name` vs `modelName`), and combining several model files would raise `TypeError` (`Path + str`). `base/threadUtils.py` was deleted, and the stress tests use `QTest.qWait`. New tests include a 3-point flow run with a retry pass (`qtbot.waitSignal`). | ✅ Done |
| 9  | 3.3: 53 → 12 `object` declarations. Rules: PySide6 silently coerces primitives (`None`→`0`/`''`) and copies `dict`/`list` (a dict with non-`str` keys arrives as `{}`), so primitives are used only where every emit is proven, `dict`/`list` are never used, and domain classes (`Path`, `ObsSite`, `Model`, `TLEParams`, skyfield `Time`, …) are passed through by identity. Examples: `msg` `(int, str, str, str)`, `operationRunning` `(int)`, `playSound` / `remoteCommand` `(str)`, `showImage` / `showAnalyse` / `solveImage` `(Path)`, all `MountSignals` done-signals typed with their domain class, `mountIsUp` `(bool)`, HID / keypad / popup / `WorkerSignals.error` typed. The dead signals `material` and `domeDone` were removed. The test stub mirrors the hub types. Checked by a full serial `-s` run searched for `Cannot copy-convert`: 2 hits, both **real bugs** (a `cv2.error` object and a stray-comma **tuple** in `tabSat_Track.startProg` were shown as message text), fixed, then 0 hits. The remaining 12 `object` declarations are deliberate (lists, shared dicts, worker results, `None`-able payloads). | ✅ Done |

**Decision:** Windows-only code does not need 100 % coverage on macOS/Linux. It
is verified for coverage on Windows CI.

**Result (macOS, after rec 9):** Ruff clean. Serial: 4583 passed, 38
skipped, ~10.5 s. `-n auto`: 4583 passed, 38 skipped, ~8.5 s. Coverage **100 %**
both serially and with `-n auto` (18,492 statements, 0 missed).

**Remaining `processEvents()` calls** (outside the scope of 3.2):
`gui/utilities/pyqtgraph/gPlotBase.py:154` and
`gui/extWindows/splashScreen.py:31` (splash repaint at startup, acceptable).

**Found during rec 4 (not fixed, out of scope):** `MountMove.moveRaDecHid()`
turns a centred joystick (`[0, 0]`) into `"STOP"` and passes it to `moveRaDec()`.
`setButtons` has no `"STOP"` key, so this raises `KeyError`. The
`coord == [0, 0]` branch in `moveRaDec()` is unreachable.

**Still open:** 10 (and the `MountMove.moveRaDecHid` `"STOP"` bug above).
Follow-ups outside this list: `parent: Any` (51 sites), a static type checker
in CI, calling `modelData.cancelRun()` from `closeEvent` while a model is
running (3.4), splitting the app signal hub into groups (June rec 5), and
`test_loader_main::test_main_1`, which fails only under `pytest -s`.

### Rec 6 – `App` Protocol (plan: `plan-review-2026-09-29-rec-6-AppProtocol.md`) – ✅ Done

- `base/appProtocol.py`: one `@runtime_checkable AppProtocol`. It lists only the
  surface that consumers use (16 attributes, 23 signals as `SignalInstance`,
  `initConfig`, `storeConfig`). All `mw4` imports are type-only, so there are
  no import cycles.
- All 53 `app: Any` sites use `AppProtocol`, and all 24 `mainW: Any` sites use
  `"MainWindow"` (import under `TYPE_CHECKING`). `app: Any = None` defaults were
  removed (production always passes the app).
- Latent bugs found while mapping the surface and fixed: `app.relay`,
  `app.measure` and `app.deviceStat` existed only on the test stub
  (`AttributeError` in production). They now read via `app.dReg[...]`.
  `KMRelay.switch` / `pulse` now return `bool`, which `doRelayAction` expects.
  The stub no longer has these attributes.
- Tests: `test_appProtocol.py`, plus `test_satisfiesAppProtocol` against the
  real `MountWizzard4`. Coverage excludes `if TYPE_CHECKING:` blocks
  (`exclude_also`).
- Result: Ruff clean, 4559 passed, 38 skipped (serial and `-n auto`),
  coverage 100 %.
- Follow-ups: `parent: Any` (51 sites), static checker in CI (decision D3).
