mworion/MountWizzard4/gists/work_agent/CONVENIENCE_PROPERTIES_FEATURE.md

# DeviceEntry Convenience Properties - Implementation Complete ✅

## Feature Summary

Added convenience properties to `DeviceEntry` class to enable shorthand access to common instance attributes without requiring `.instance` prefix.

## Benefits

- **Cleaner syntax**: `dReg["device"].signals` instead of `dReg["device"].instance.signals`
- **Reduced verbosity**: Commonly-used attributes are directly accessible
- **Type safety**: Proper error handling when accessing on None instances
- **Backward compatible**: Old `.instance.attribute` syntax still works
- **Intent-revealing**: Makes code more readable and self-documenting

## Implementation

### Convenience Properties Added to DeviceEntry

| Property | Accesses | Use Case |
|---|---|---|
| `.signals` | `instance.signals` | Connect to device event signals |
| `.data` | `instance.data` | Access device data dictionary |
| `.framework` | `instance.framework` | Check/set INDI/ALPACA framework |
| `.run` | `instance.run` | Access available device drivers |

### Usage Examples

**Before (still supported):**
```python
camera_signals = app.dReg["camera"].instance.signals
camera_data = app.dReg["camera"].instance.data
framework = app.dReg["camera"].instance.framework
```

**After (new shorthand):**
```python
camera_signals = app.dReg["camera"].signals  # ✅ Cleaner!
camera_data = app.dReg["camera"].data  # ✅ Cleaner!
framework = app.dReg["camera"].framework  # ✅ Cleaner!
```

## Error Handling

When accessing convenience properties on devices with `instance=None`, a clear `AttributeError` is raised:

```python
# Raises AttributeError: Device 'refraction' instance is None
app.dReg["refraction"].signals
```

## Test Coverage

Added 6 new unit tests:

1. ✅ `test_deviceEntrySignalsProperty` - Verify signals property access
2. ✅ `test_deviceEntryDataProperty` - Verify data property access
3. ✅ `test_deviceEntryFrameworkProperty` - Verify framework property access
4. ✅ `test_deviceEntryRunProperty` - Verify run property access
5. ✅ `test_deviceEntrySignalsPropertyRaisesWhenInstanceNone` - Error handling
6. ✅ `test_deviceEntryDataPropertyRaisesWhenInstanceNone` - Error handling

**Test Results**: 23/23 passing (up from 17 initially)

## Implementation Details

### Code Structure

```python
@property
def signals(self) -> Any:
    """Convenience property to access instance.signals directly."""
    if self.instance is None:
        raise AttributeError(f"Device '{self.name}' instance is None")
    return self.instance.signals
```

**Advantages of this approach:**
- Clear error message (includes device name)
- Lazy evaluation (only creates property when accessed)
- Type hints for IDE support
- Consistent error handling across all properties

### Design Decisions

1. **Read-only properties**: These are convenience accessors, not setters
2. **None checks**: Explicit validation with meaningful error messages
3. **Limited scope**: Only added for most commonly-accessed attributes
4. **Backward compatible**: Existing `.instance` access still works

## Integration Path

This feature can be adopted gradually:
- Existing code using `.instance.signals` continues to work
- New code can use the shorter `.signals` syntax
- Both patterns can coexist during migration

## Commonly-Accessed Attributes on Devices

From codebase analysis, typical device instances have:
- `signals` - Qt signals for device events (used everywhere)
- `data` - Dictionary storing device state
- `framework` - Current INDI/ALPACA framework (used by logic)
- `run` - Dictionary of available drivers
- `defaultConfig` - Default configuration
- `deviceName` - Device identifier string

**Rationale for selected properties:**
- `signals`, `data`, `framework`, `run` are accessed most frequently
- These are stable attributes across all device types
- Others like `defaultConfig` are rarely accessed directly

## Files Modified

1. `src/mw4/base/deviceRegistry.py`
   - Added 4 convenience properties to DeviceEntry

2. `tests/unit_tests/base/test_deviceRegistry.py`
   - Added 6 new test functions (all passing)

## Future Enhancements

Could extend with additional convenience properties if needed:
- `defaultConfig` property
- Setter properties for writable attributes
- Method shortcuts for common operations

## Testing & Verification

✅ All unit tests passing (23/23)
✅ Convenience properties work with real device instances
✅ Error handling verified
✅ No breaking changes to existing code
✅ Backward compatible with `.instance` access

---

**Status**: ✅ **FEATURE COMPLETE AND TESTED**

The convenience properties provide a cleaner API while maintaining full backward compatibility.
