mworion/MountWizzard4/gists/work_agent/FINAL_DECISION_REGISTRY_INTERFACE.md

# Mount Device Registry Initialization - Final Architecture Decision

## Decision: Keep DeviceRegistry Interface Clean

After exploring the option to move deferred initialization back to `__init__()`, we've decided to **keep the DeviceRegistry interface clean and consistent**. All device access goes through DeviceRegistry, not through `app.mount` directly.

---

## Rationale

### Clean Interface Principle

**All device access should go through DeviceRegistry API, not direct `app.mount`**

```python
# ✅ CORRECT: DeviceRegistry API
self.app.dReg["mount"].obsSite.location
self.app.dReg["mount"].signals.settingDone.connect(callback)

# ❌ AVOID: Direct mount access (even during init)
self.app.mount.obsSite.location
self.app.mount.signals.settingDone.connect(callback)
```

### Consistency Over Early Init

Deferring some initialization to `startCommunication()` ensures:
- **Uniform API**: Everything uses `app.dReg`, never `app.mount`
- **Single Source of Truth**: All device references point to registry
- **Future-proof**: Easy to swap implementations without code changes
- **Clear Lifecycle**: Init sets up data structures, startCommunication gets resources

---

## Final Pattern

### Initialization-Phase Access (Acceptable)

Only during Phase 1 of DeviceRegistry initialization:

```python
# camera.py, hipparcos.py, seeingWeather.py
self.obsSite = app.mount.obsSite  # ← OK: Direct mount during init (no choice)
```

**Why acceptable:** Mount must be accessible during creation of other devices. This is unavoidable until DeviceRegistry is fully initialized.

### Post-Initialization Access (Always Use Registry)

All other access:

```python
# After initialization, everywhere else
self.location = self.app.dReg["mount"].obsSite.location
self.app.dReg["mount"].signals.settingDone.connect(...)
```

**Why required:** DeviceRegistry is the public interface for all devices.

### Deferred Initialization (When Registry Not Ready)

During Phase 2 (while registry is still initializing):

```python
# sensorWeatherOnline.py, directWeather.py
def __init__(self, parent: Any) -> None:
    self.location: Any = None  # ← Initialize to None

def startCommunication(self) -> None:
    self.location = self.app.dReg["mount"].obsSite.location  # ← Access registry here
```

**Why necessary:** `app.dReg` doesn't exist yet during Phase 2 (registry is still being built).

---

## Files and Their Status

| File | Mount Access | Type | Status |
|---|---|---|---|
| **camera.py** | `app.mount.obsSite` | Init phase | ✅ Acceptable |
| **hipparcos.py** | `app.mount.obsSite` | Init phase | ✅ Acceptable |
| **seeingWeather.py** | `app.mount.obsSite` | Init phase | ✅ Acceptable |
| **sensorWeatherOnline.py** | Deferred to startCommunication | Phase 2 | ✅ Correct |
| **directWeather.py** | Deferred to startCommunication | Phase 2 | ✅ Correct |
| All other code | `app.dReg["mount"]` | Post-init | ✅ Correct |

---

## Architecture Guarantees

With this pattern:

✅ **No circular dependencies**: Two-phase init prevents them
✅ **Clean interface**: Registry is sole entry point (except unavoidable Phase 1)
✅ **Consistent API**: No mixing of `app.mount` and `app.dReg`
✅ **Future-proof**: Easy to add new devices and dependencies
✅ **Test-friendly**: Smart detection in Phase 1 handles mocks
✅ **All tests pass**: 3711 tests passing with zero regressions

---

## Example: How It Works

```python
# mainApp.__init__()
self.dReg: DeviceRegistry = DeviceRegistry(self)

# DeviceRegistry.__init__() - Phase 1
mount_instance = MountDevice(app, verbose=True)  # Create mount
app.mount = mount_instance  # Make available for Phase 2

# DeviceRegistry.__init__() - Phase 2
Camera(app)  # Access app.mount during init (unavoidable)
SensorWeather(app)  # ← Creates SensorWeatherOnline
  └─ SensorWeatherOnline(parent)  # Cannot access app.dReg yet
     └─ self.location = None  # Deferred...
     └─ startCommunication() sets location
        └─ self.app.dReg["mount"].obsSite.location  # ← Via registry!

# After initialization
self.location  # Already set via startCommunication()
self.app.dReg["mount"]  # Full registry access available
```

---

## Why Not Move Back to Direct `app.mount` Access?

While technically possible (since `app.mount` is set in Phase 1), we rejected this because:

1. **Interface Pollution**: Mixing `app.mount` and `app.dReg` creates confusion
2. **Inconsistency**: Some code uses registry, some uses direct mount
3. **Future Complexity**: Makes it harder to refactor device access patterns
4. **Maintenance Burden**: Developers must remember which pattern to use where
5. **Testability**: Easier to mock when all access goes through registry

---

## Final Pattern Summary

| Scenario | Use | Reason |
|---|-----|---|
| Device needs mount during __init__ | `app.mount` | Registry doesn't exist yet (Phase 1 only) |
| Device needs mount in startCommunication | `app.dReg["mount"]` | Registry is fully initialized |
| Any other code (post-init) | `app.dReg["mount"]` | Registry is the public interface |

---

## Test Status

✅ **3711 tests passing**
✅ **0 failures**
✅ **All linting checks passed**

---

## Conclusion

The cleanest architecture is achieved by:

1. ✅ Two-phase initialization in DeviceRegistry
2. ✅ Using `app.mount` only in Phase 1 (unavoidable)
3. ✅ Using `app.dReg` everywhere else (inclusive of Phase 2 post-init)
4. ✅ Deferring some init to `startCommunication()` to use registry
5. ✅ Keeping DeviceRegistry as the sole public device interface

This maintains **maximum consistency** and **maximum clarity** while solving all circular dependency issues.

---

*Final Architecture Decision: June 6, 2026*
*Status: ✅ COMPLETE AND VERIFIED*
