mworion/MountWizzard4/gists/work_agent/HIDCONTROLLER_COVERAGE_IMPROVEMENT.md

# HidController Test Coverage Improvement

## Summary
Successfully improved test coverage for the `hidController` module from 98% to 100%.

## Issue Identified
The initial test coverage report showed 4 uncovered lines (167-170) in the `runnerHidController` method:
- Line 167: Warning log for device disconnection during runtime
- Line 168: Call to `handleDisconnect` method
- Line 169: Setting `deviceConnected` flag to False
- Line 170: Continue statement in the loop

These lines handle the scenario where a device becomes disconnected while the runner is actively monitoring it.

## Tests Added

### 1. `test_runnerHidController_handlesDisconnectionDuringRun()`
- **Purpose**: Tests the code path when a device is disconnected during runtime
- **Scenario**: Device initially connects successfully, then raises an OSError during read operations
- **Coverage**: Lines 166-170 in `runnerHidController`
- **Expected Behavior**: Runner gracefully handles the disconnection and exits properly

### 2. `test_runnerHidController_unknownDeviceType()`
- **Purpose**: Tests the code path when `convertData` receives a device name that doesn't match any known device type
- **Scenario**: Uses an "Unknown Controller" device
- **Coverage**: `convertData` method with unknown device type
- **Expected Behavior**: Returns default zero array [0, 0, 0, 0, 0, 0, 0]

### 3. `test_convertData_unknownDevice()`
- **Purpose**: Additional test for `convertData` with unknown device names
- **Scenario**: Passes raw input data to unknown device converter
- **Coverage**: Unknown device type fallback case
- **Expected Behavior**: Returns all zeros array

## Results
- **Initial Coverage**: 98% (164/164 statements, 4 missed)
- **Final Coverage**: 100% (164/164 statements, 0 missed)
- **Total Tests**: 54 tests (added 3 new tests)
- **All Tests Passing**: ✓ Yes
- **Code Quality**: ✓ Ruff formatting applied
- **Linting**: ✓ All checks passed

## Files Modified
- `tests/unit_tests/logic/hidController/test_hidController.py` - Added 3 new test functions

## Verification Steps Taken
1. Ran full test suite with coverage report
2. Applied Ruff formatting to ensure code quality
3. Verified all linting checks pass
4. Confirmed 100% code coverage on all statements
