mworion/MountWizzard4/gists/work_agent/SIGNAL_REFACTORING_SUMMARY.md

# Signal Refactoring Summary: Moved HID Controller Signals to Local Class

## Completion Status
✅ **COMPLETED** - All signals moved successfully, all tests passing

## Summary of Changes

### Signals Removed from mainApp.py
The following signals were removed from the main application class as they are no longer needed globally:
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
