mworion/MountWizzard4/doc/architecture/image/sat2_altitude.png

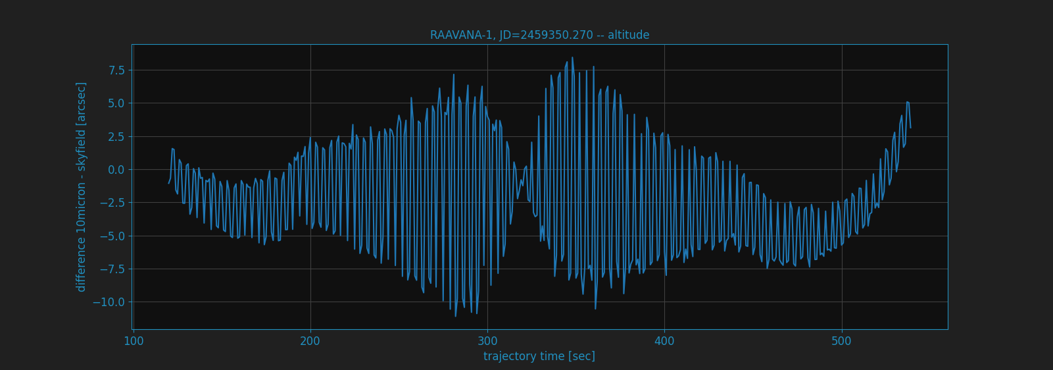
doc/architecture/image/sat2_altitude.png
