mworion/MountWizzard4/doc/architecture/image/sat2_azimuth.png

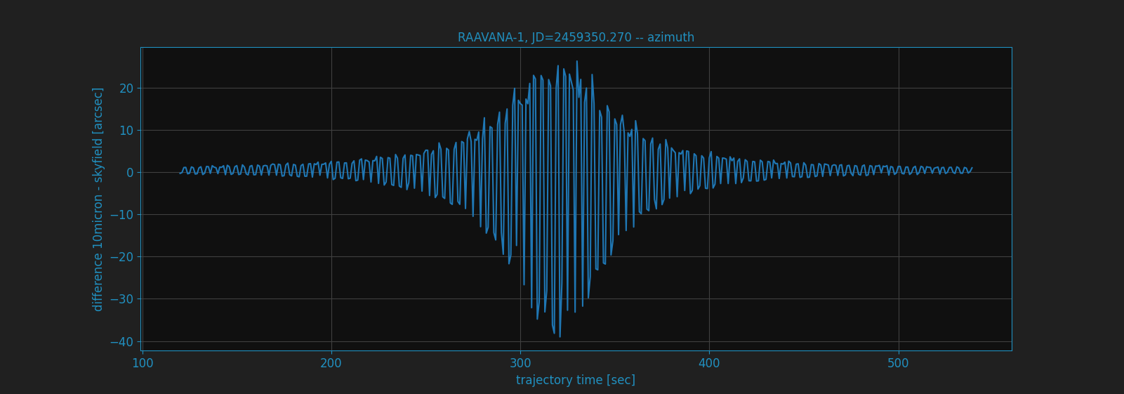
doc/architecture/image/sat2_azimuth.png
