mworion/MountWizzard4/doc/architecture/image/sat2_ra.png

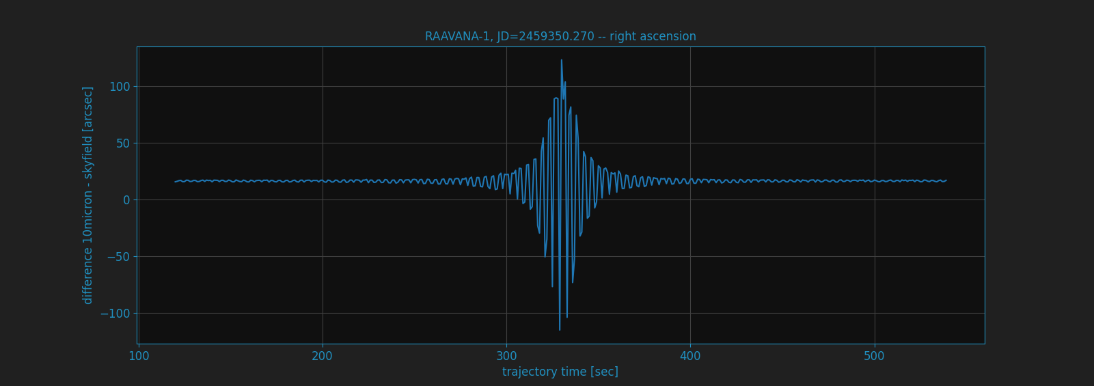
doc/architecture/image/sat2_ra.png
