mworion/MountWizzard4/doc/architecture/image/sat2_track.png

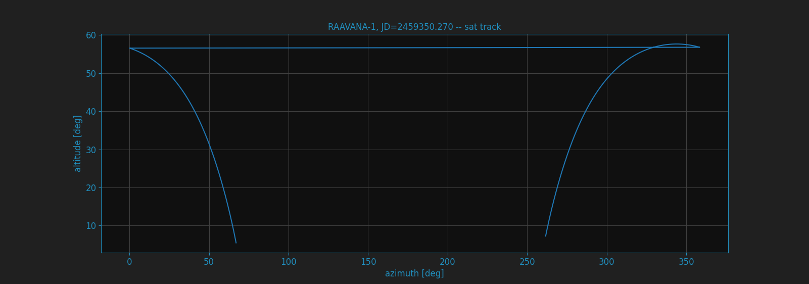
doc/architecture/image/sat2_track.png
