mworion/MountWizzard4/doc/architecture/image/sat_altitude.png

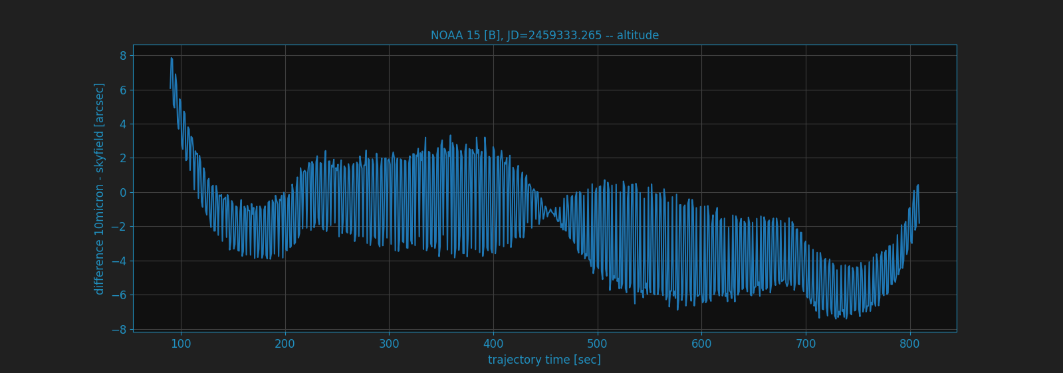
doc/architecture/image/sat_altitude.png
