mworion/MountWizzard4/doc/architecture/image/sat_azimuth.png

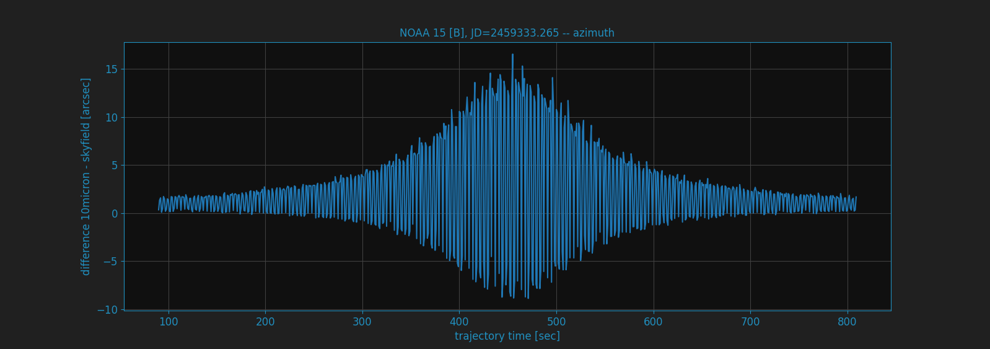
doc/architecture/image/sat_azimuth.png
