mworion/MountWizzard4/doc/architecture/image/sat_dec.png

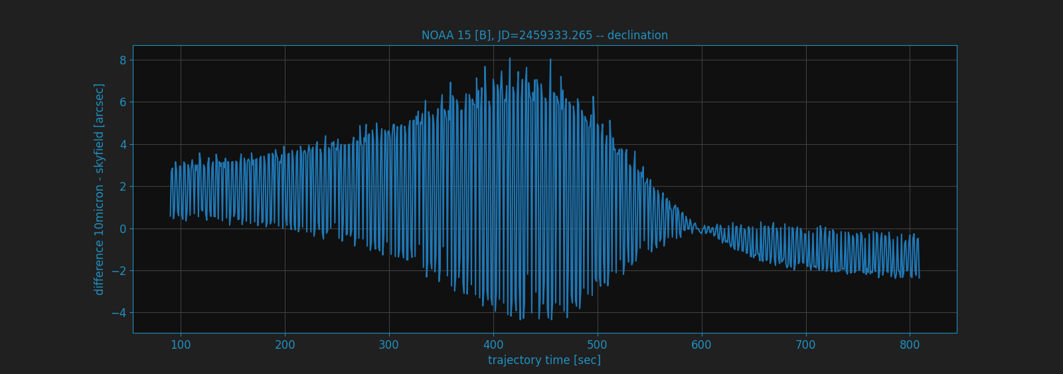
doc/architecture/image/sat_dec.png
