mworion/MountWizzard4/doc/architecture/image/sat_ra.png

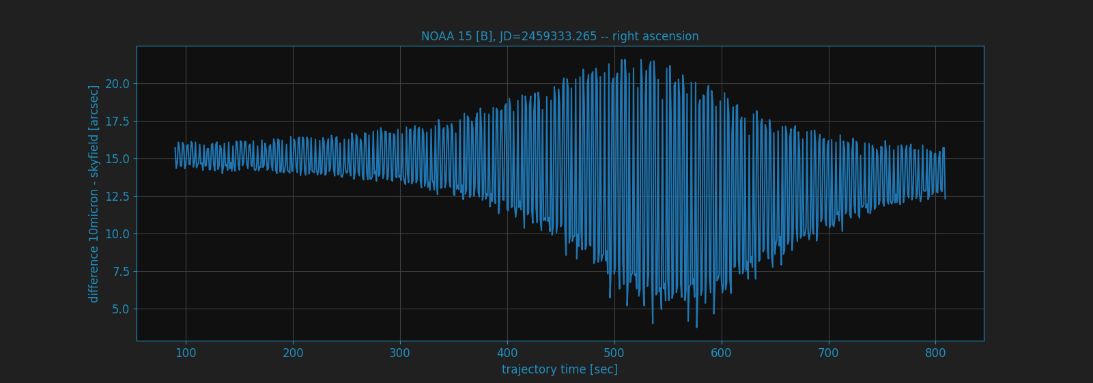
doc/architecture/image/sat_ra.png
