mworion/MountWizzard4/doc/architecture/image/sat_track.png

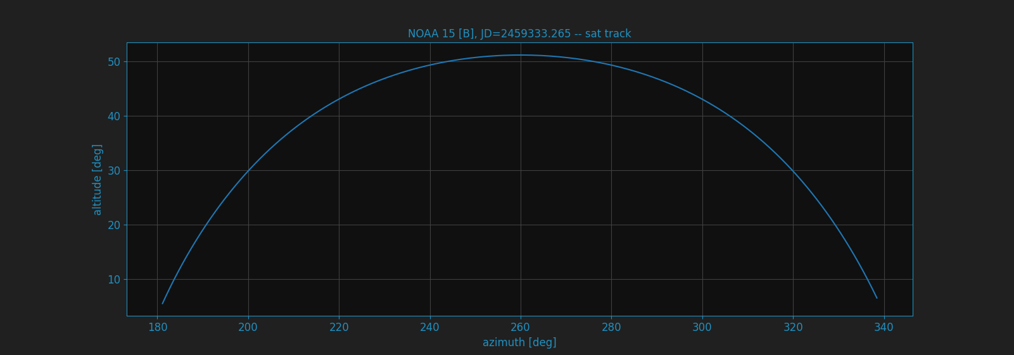
doc/architecture/image/sat_track.png
