mworion/MountWizzard4/doc/config/camera/image/camera_01.png

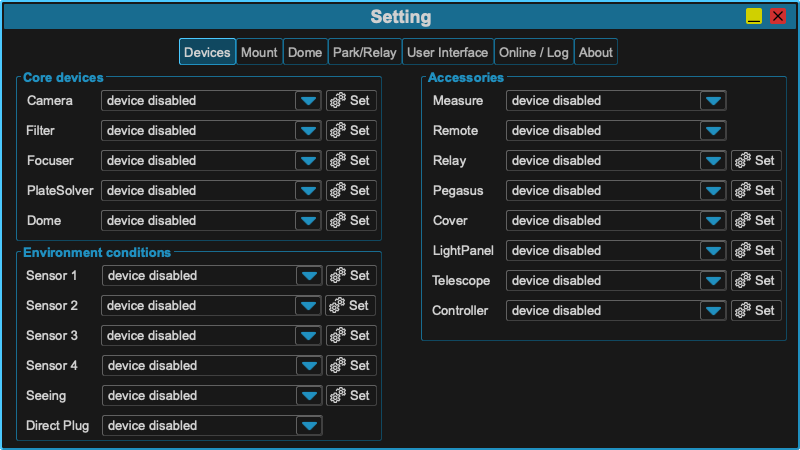
doc/config/camera/image/camera_01.png
