mworion/MountWizzard4/doc/config/camera/image/camera_02.png

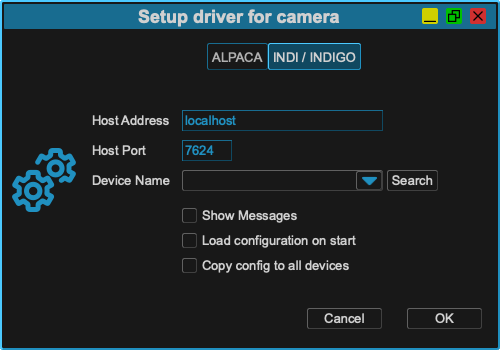
doc/config/camera/image/camera_02.png
