mworion/MountWizzard4/doc/config/camera/image/nina_alpaca_plugin.png

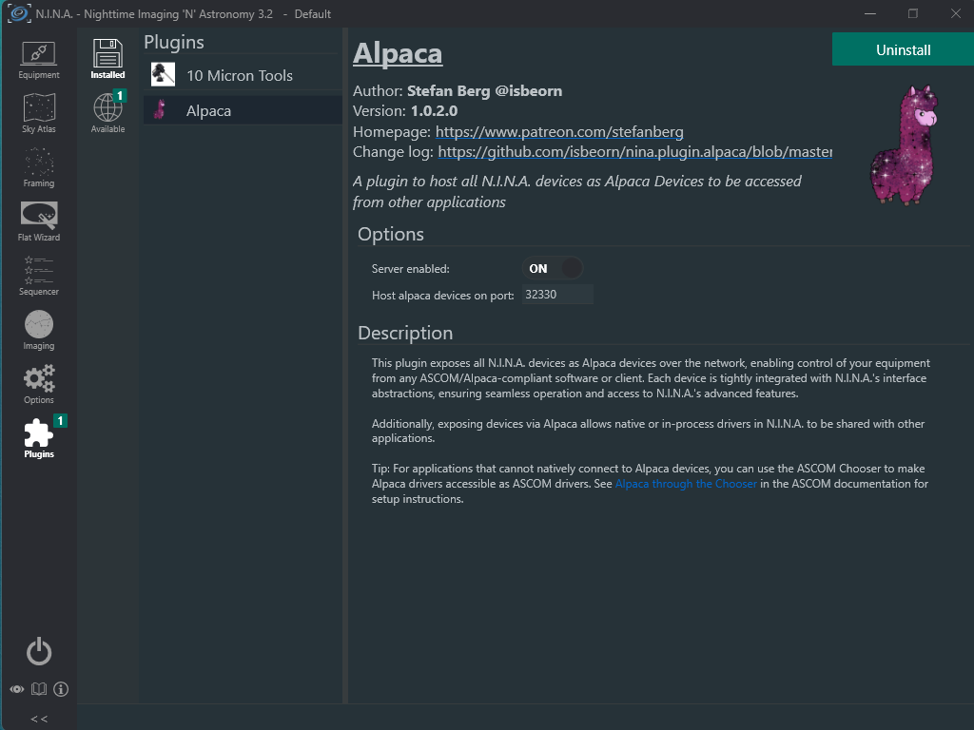
doc/config/camera/image/nina_alpaca_plugin.png
