mworion/MountWizzard4/doc/config/camera/image/nina_camera.png

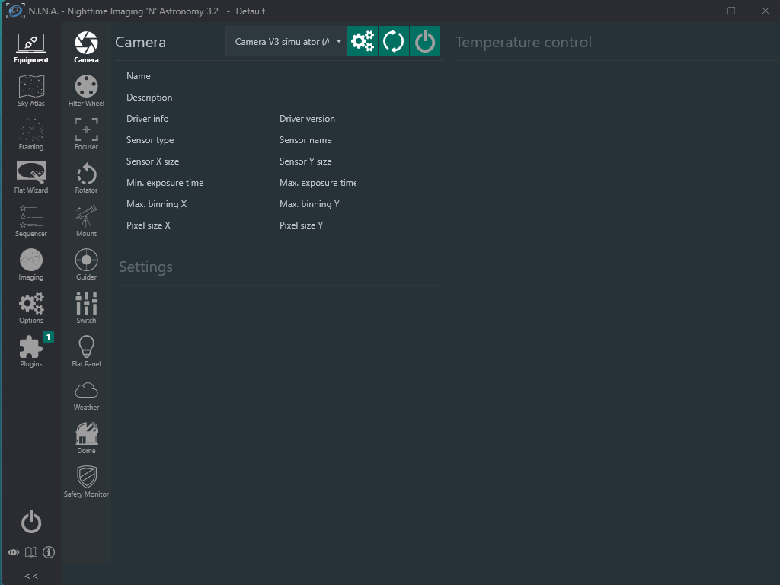
doc/config/camera/image/nina_camera.png
