mworion/MountWizzard4/doc/config/camera/image/select_nina.png

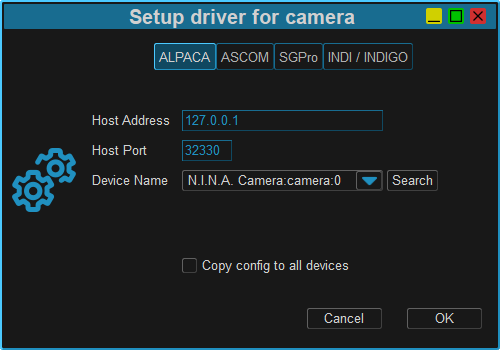
doc/config/camera/image/select_nina.png
