mworion/MountWizzard4/doc/config/dome/image/dome_clear_opening.png

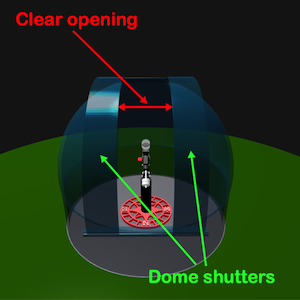
doc/config/dome/image/dome_clear_opening.png
