mworion/MountWizzard4/doc/config/dome/image/dome_clearance_zenith.png

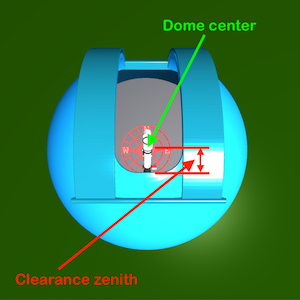
doc/config/dome/image/dome_clearance_zenith.png
