mworion/MountWizzard4/doc/config/dome/image/dome_opening_hysteresis.png

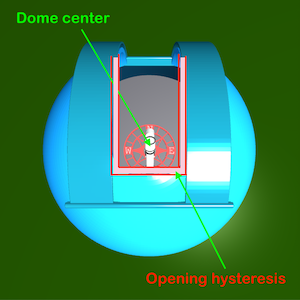
doc/config/dome/image/dome_opening_hysteresis.png
