mworion/MountWizzard4/doc/config/dome/image/dome_settings.png

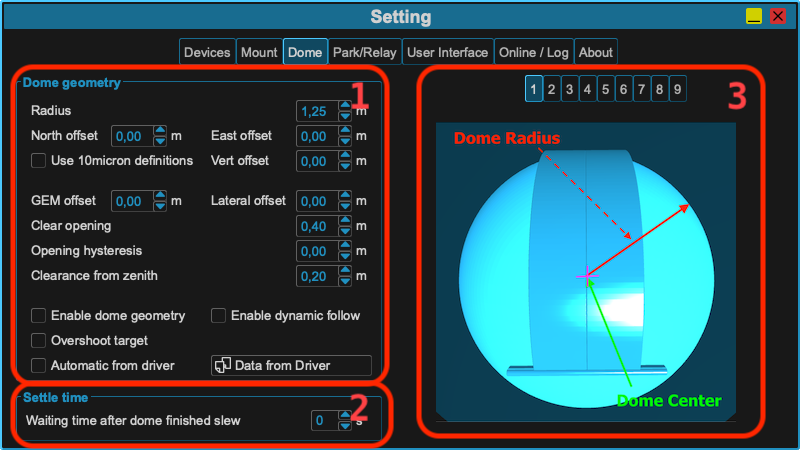
doc/config/dome/image/dome_settings.png
