mworion/MountWizzard4/doc/config/dome/image/east.png

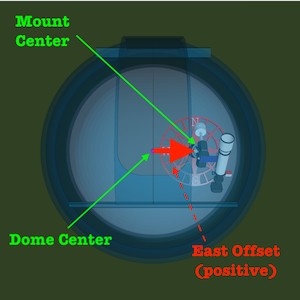
doc/config/dome/image/east.png
