mworion/MountWizzard4/doc/config/dome/image/gem.png

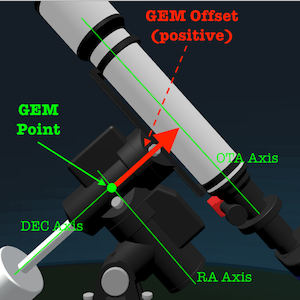
doc/config/dome/image/gem.png
