mworion/MountWizzard4/doc/config/dome/image/lat.png

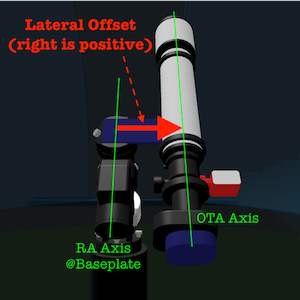
doc/config/dome/image/lat.png
