mworion/MountWizzard4/doc/config/dome/image/north.png

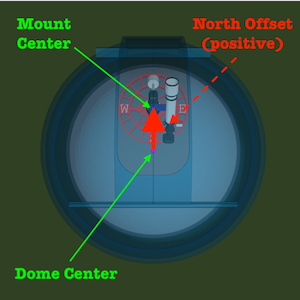
doc/config/dome/image/north.png
