mworion/MountWizzard4/doc/config/dome/image/radius.png

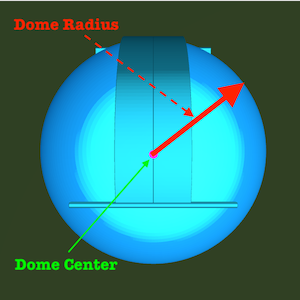
doc/config/dome/image/radius.png
