mworion/MountWizzard4/doc/config/dome/image/z_10micron.png

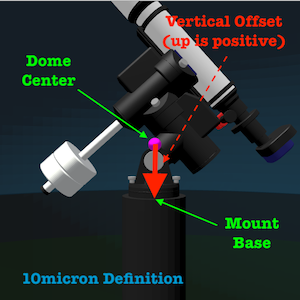
doc/config/dome/image/z_10micron.png
