mworion/MountWizzard4/doc/config/dome/image/z_ascom.png

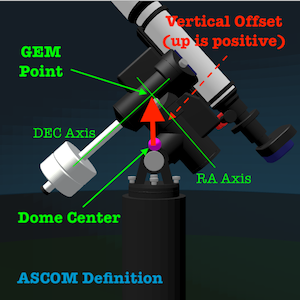
doc/config/dome/image/z_ascom.png
