mworion/MountWizzard4/doc/config/imaging/image/image_train.png

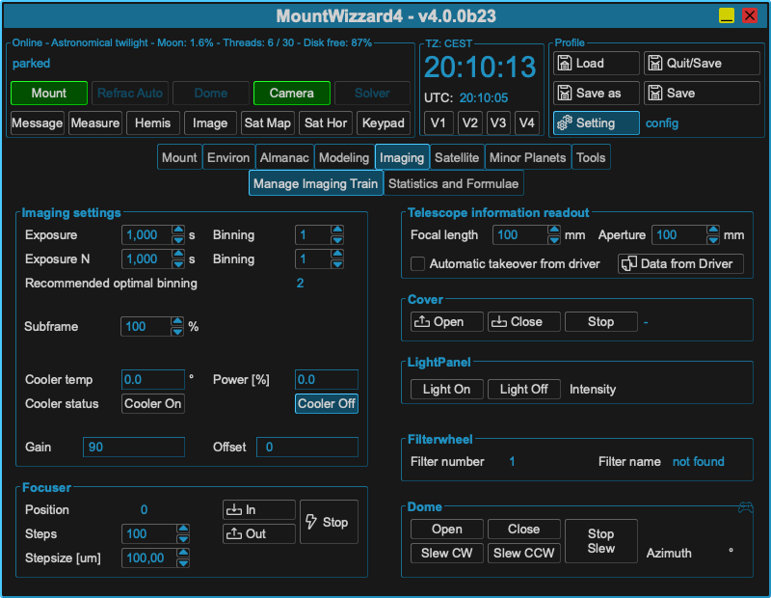
doc/config/imaging/image/image_train.png
