mworion/MountWizzard4/doc/config/imaging/image/parameters.png

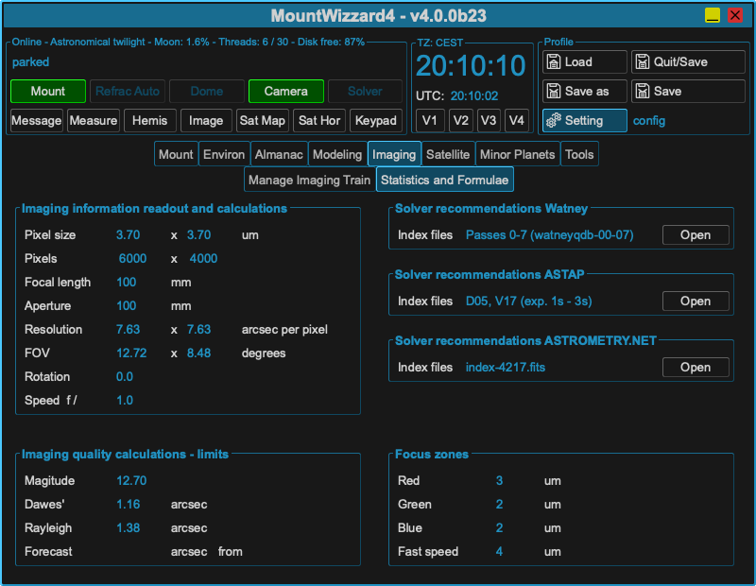
doc/config/imaging/image/parameters.png
