mworion/MountWizzard4/doc/config/mount/image/mount1.png

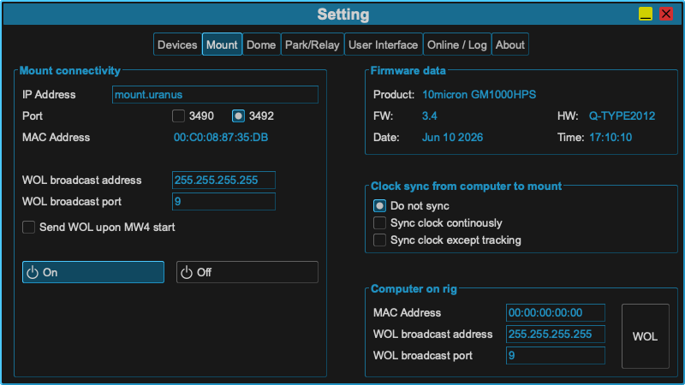
doc/config/mount/image/mount1.png
