mworion/MountWizzard4/doc/config/mount/image/mountSettlingTime.png

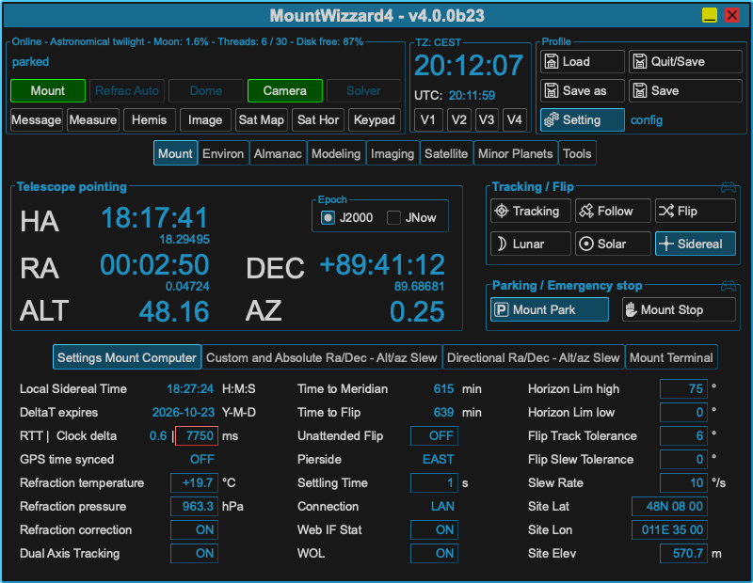
doc/config/mount/image/mountSettlingTime.png
