mworion/MountWizzard4/doc/config/mount/image/waitingTime.png

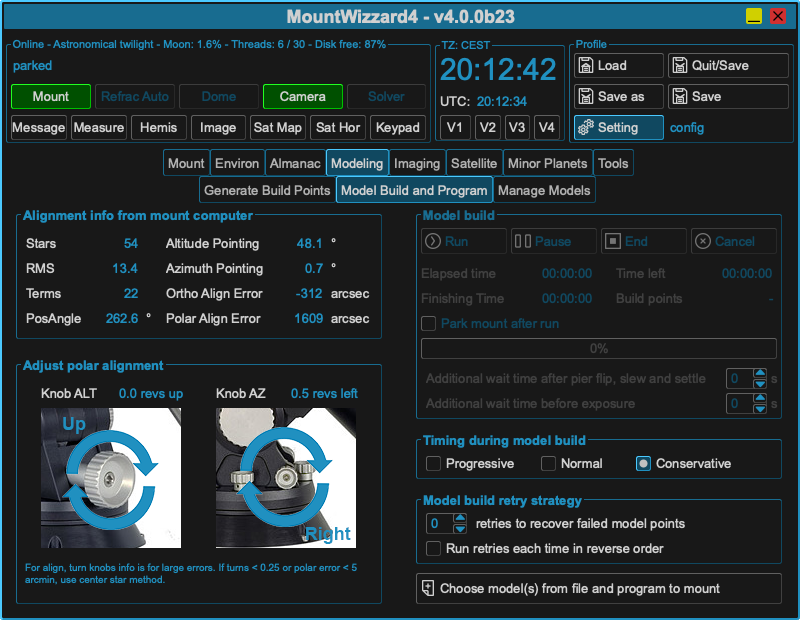
doc/config/mount/image/waitingTime.png
