mworion/MountWizzard4/doc/config/parkpos/image/parkpos.png

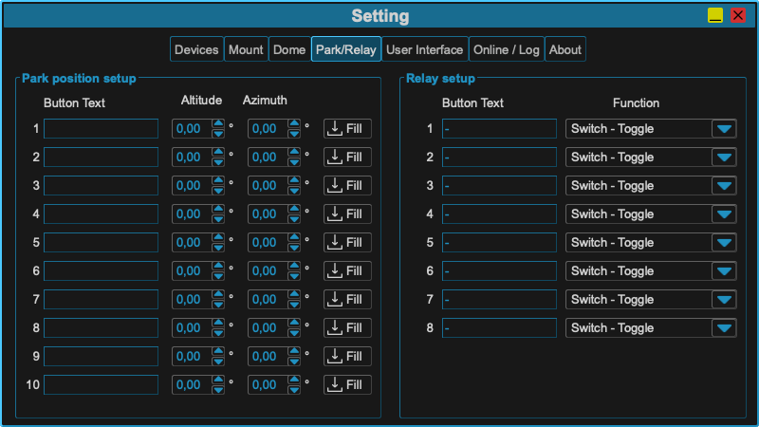
doc/config/parkpos/image/parkpos.png
