mworion/MountWizzard4/doc/config/terrain/image/teleport360.png

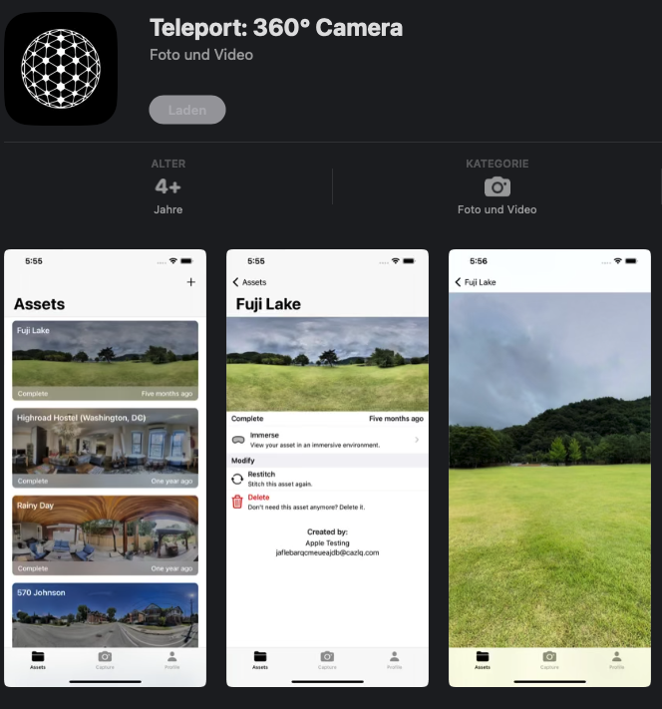
doc/config/terrain/image/teleport360.png
