mworion/MountWizzard4/doc/config/terrain/image/terrain.png

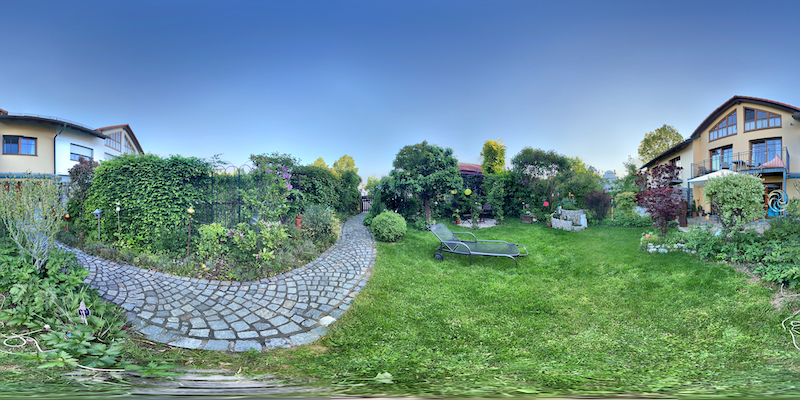
doc/config/terrain/image/terrain.png
