mworion/MountWizzard4/doc/config/terrain/image/terrain_hemisphere.png

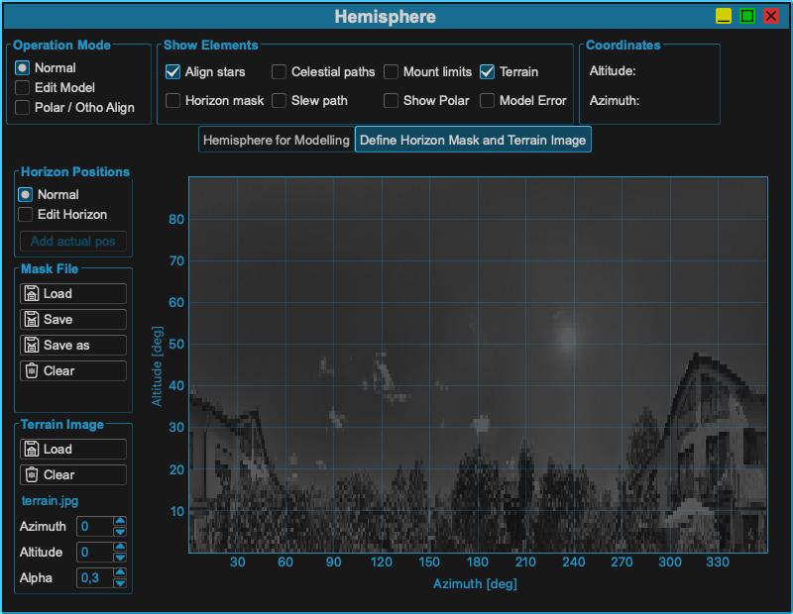
doc/config/terrain/image/terrain_hemisphere.png
