mworion/MountWizzard4/doc/config/terrain/image/terrain_hemisphere_polar.png

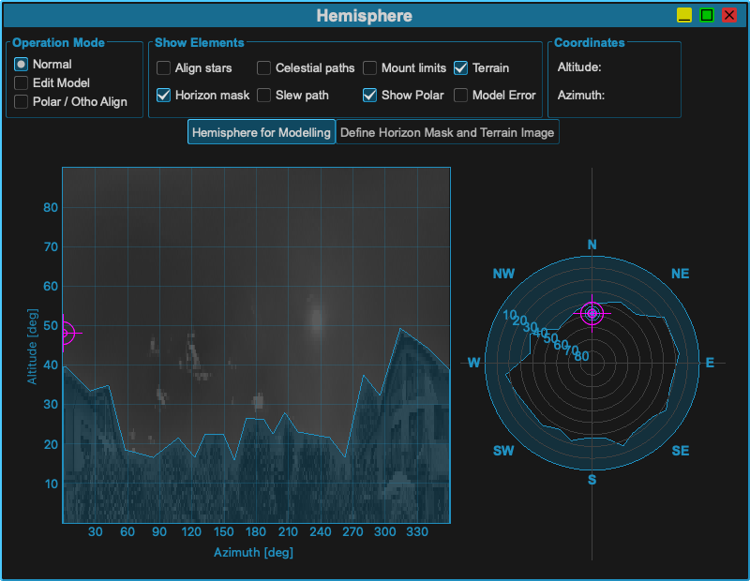
doc/config/terrain/image/terrain_hemisphere_polar.png
