mworion/MountWizzard4/doc/config/themes/image/light_day.png

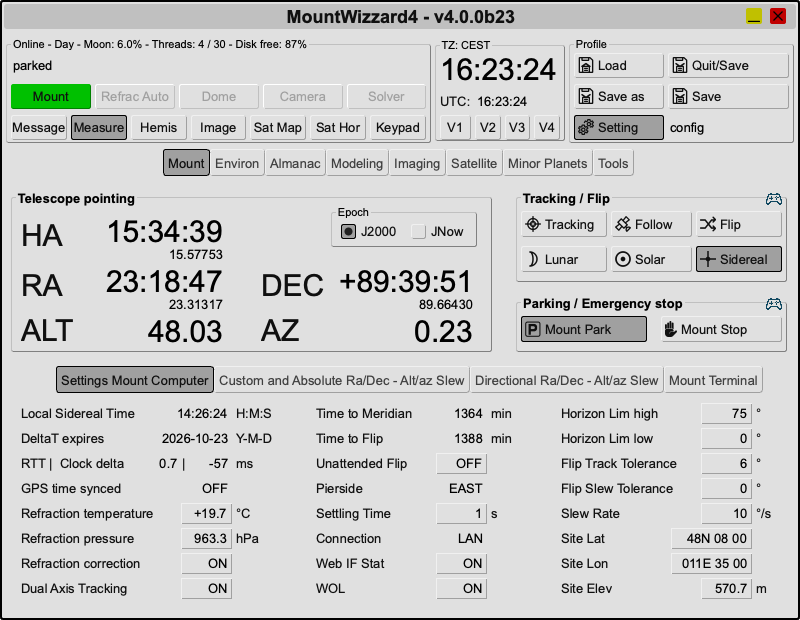
doc/config/themes/image/light_day.png
