mworion/MountWizzard4/doc/config/themes/image/main_30.png

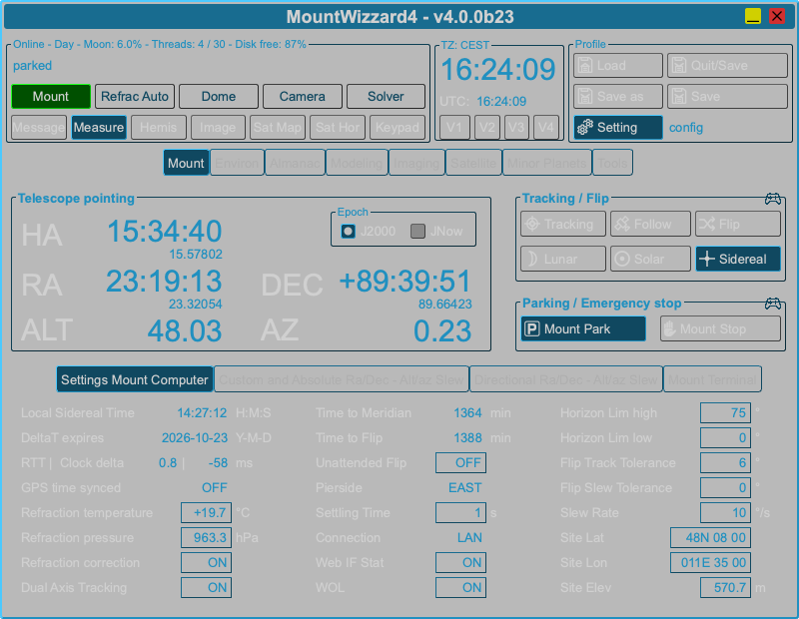
doc/config/themes/image/main_30.png
