mworion/MountWizzard4/doc/config/themes/image/main_50.png

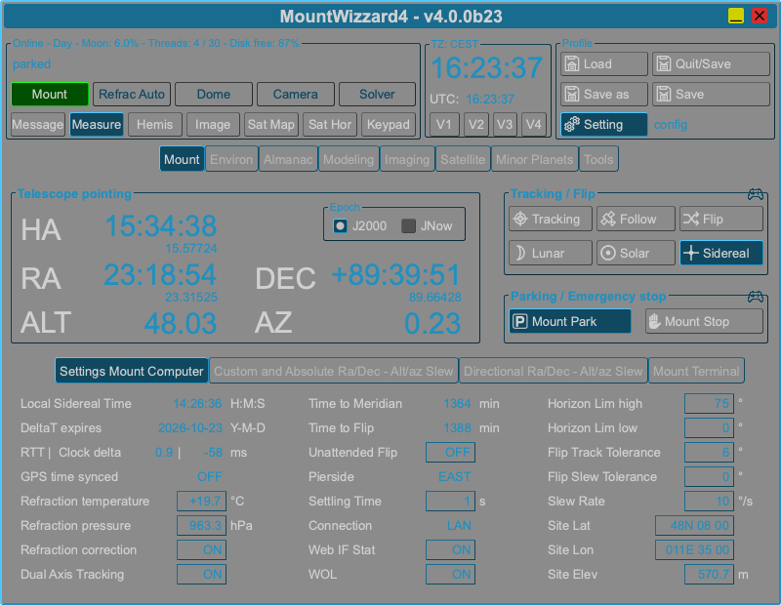
doc/config/themes/image/main_50.png
