mworion/MountWizzard4/doc/config/themes/image/red_night.png

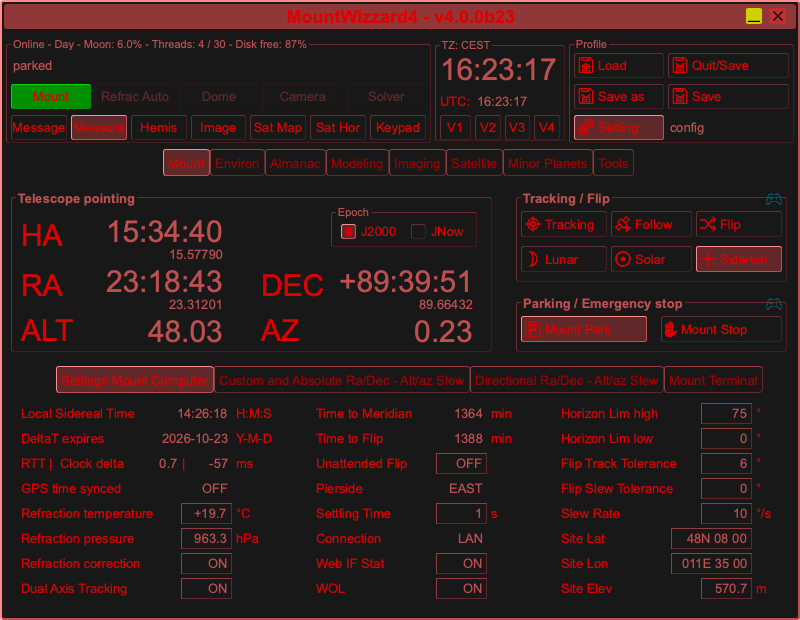
doc/config/themes/image/red_night.png
