mworion/MountWizzard4/doc/config/themes/image/red_night_50.png

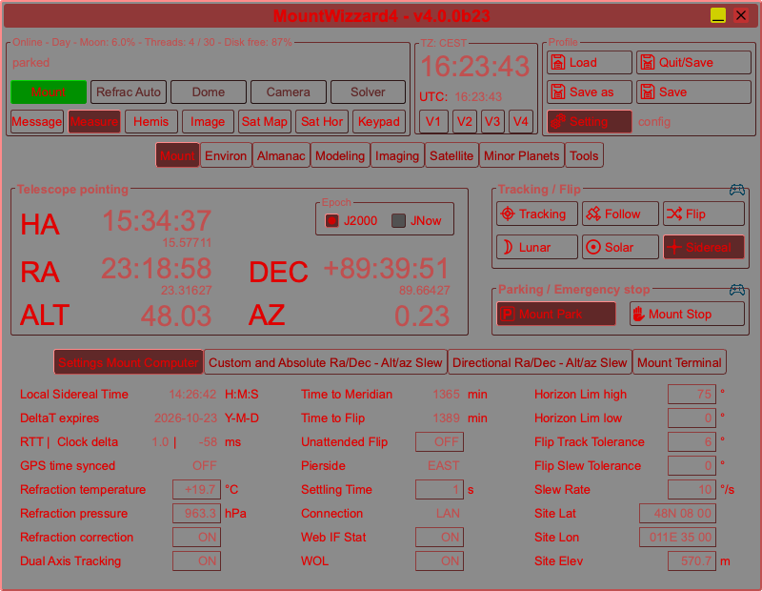
doc/config/themes/image/red_night_50.png
