mworion/MountWizzard4/doc/config/themes/image/theme_selector_1.png

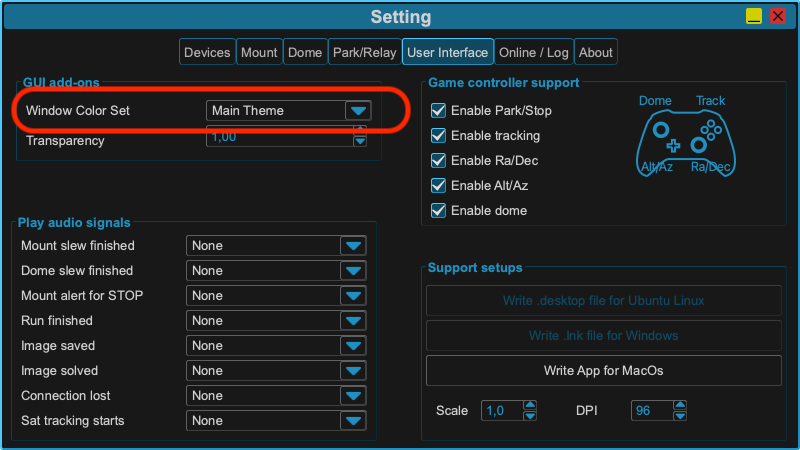
doc/config/themes/image/theme_selector_1.png
