mworion/MountWizzard4/src/mw4/assets/dome/east.png

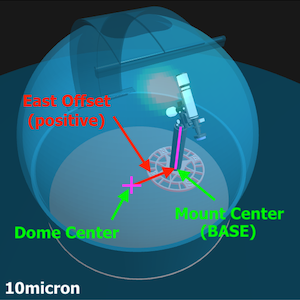
src/mw4/assets/dome/east.png
