mworion/MountWizzard4/src/mw4/assets/dome/hysteresis.png

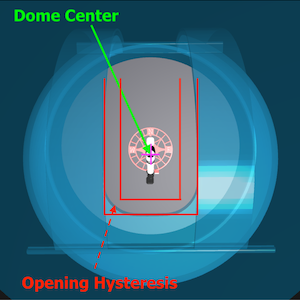
src/mw4/assets/dome/hysteresis.png
