mworion/MountWizzard4/src/mw4/assets/dome/northGEM.png

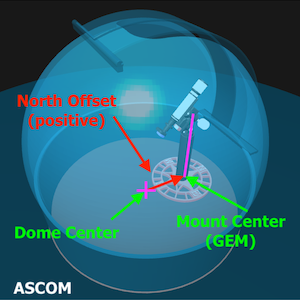
src/mw4/assets/dome/northGEM.png
