mworion/MountWizzard4/src/mw4/assets/dome/radius.png

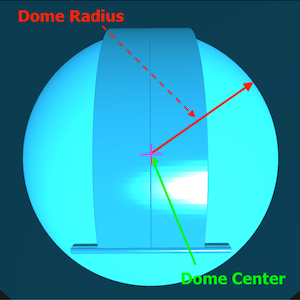
src/mw4/assets/dome/radius.png
