mworion/MountWizzard4/src/mw4/assets/dome/shutter.png

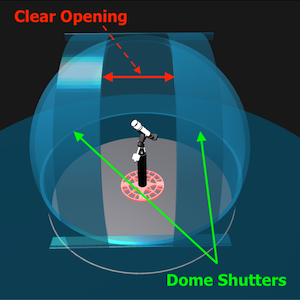
src/mw4/assets/dome/shutter.png
