mworion/MountWizzard4/src/mw4/assets/dome/vert.png

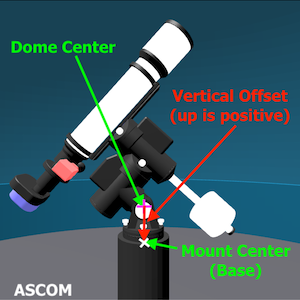
src/mw4/assets/dome/vert.png
