mworion/MountWizzard4/src/mw4/assets/dome/vertGEM.png

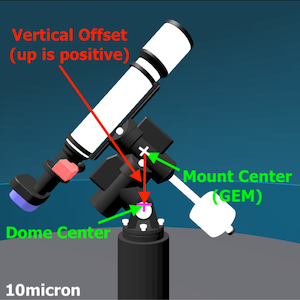
src/mw4/assets/dome/vertGEM.png
