mworion/MountWizzard4/src/mw4/assets/pics/altitude.png

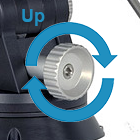
src/mw4/assets/pics/altitude.png
