mworion/MountWizzard4/src/mw4/assets/pics/azimuth.png

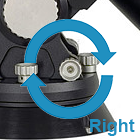
src/mw4/assets/pics/azimuth.png
