mworion/MountWizzard4/src/mw4/assets/pics/moon.png

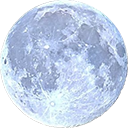
src/mw4/assets/pics/moon.png
