mworion/MountWizzard4/src/mw4/assets/model3D/dome-sphere.stl

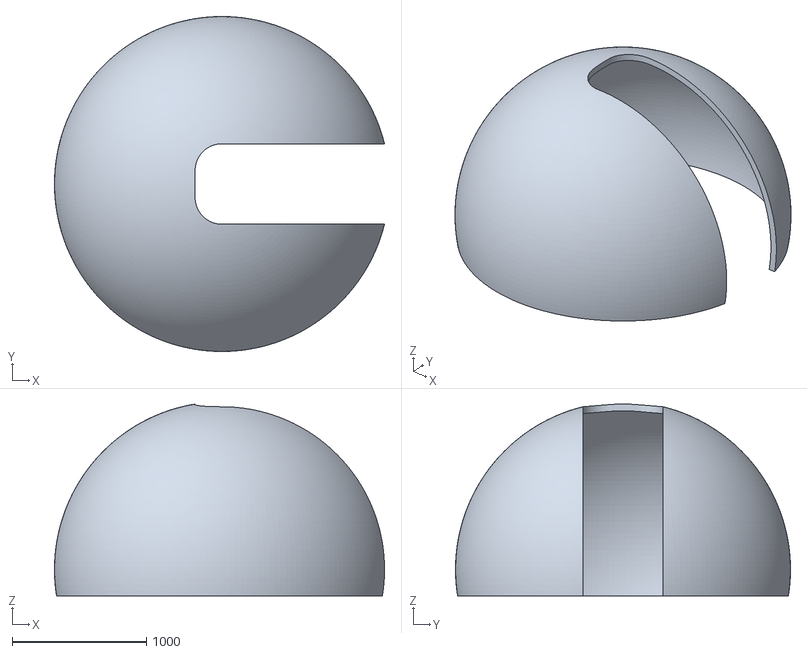
[picture p52: CAD file, 2021-01-07]
src/mw4/assets/model3D/dome-sphere.stl
2463.1 x 2499.6 x 1432.0
