mworion/MountWizzard4/src/mw4/assets/model3D/dome-slit2.stl

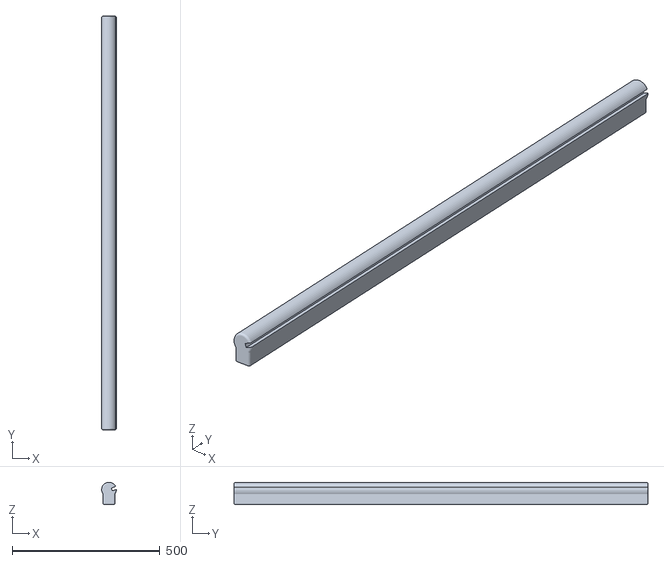
[picture p53: CAD file, 2020-06-21]
src/mw4/assets/model3D/dome-slit2.stl
49.9 x 1400.0 x 76.0
