mworion/MountWizzard4/src/mw4/assets/model3D/dome-slit1.stl

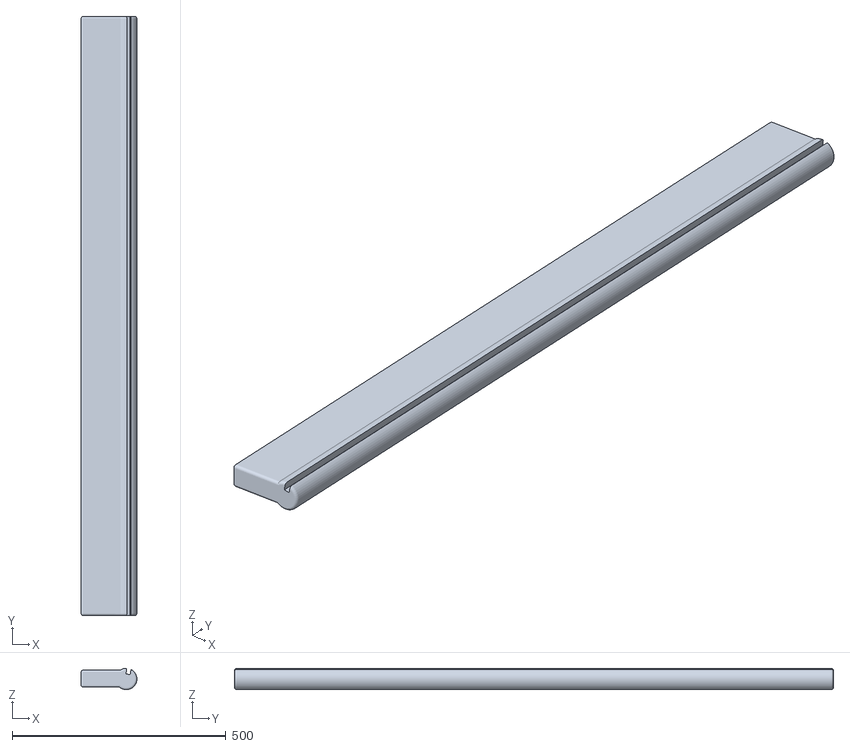
[picture p54: CAD file, 2020-06-21]
src/mw4/assets/model3D/dome-slit1.stl
130.5 x 1400.0 x 49.9
