mworion/MountWizzard4/src/mw4/assets/model3D/dome-door2.stl

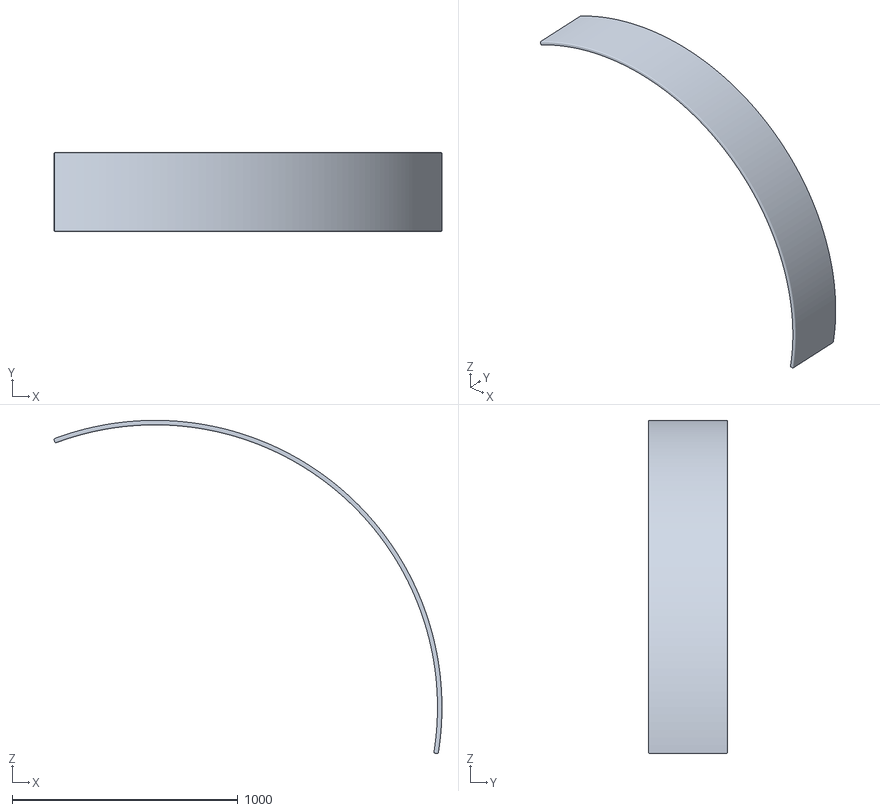
[picture p55: CAD file, 2020-06-20]
src/mw4/assets/model3D/dome-door2.stl
1717.1 x 350.0 x 1474.8
