mworion/MountWizzard4/src/mw4/assets/model3D/dome-wall.stl

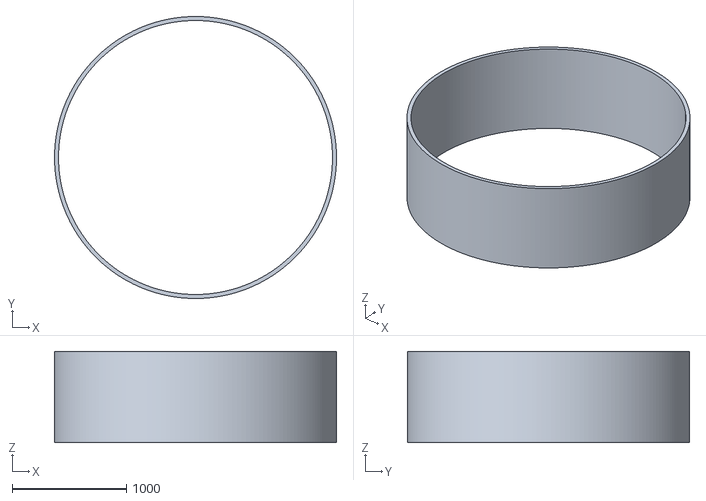
[picture p56: CAD file, 2020-06-20]
src/mw4/assets/model3D/dome-wall.stl
2470.6 x 2470.7 x 800.0
