mworion/MountWizzard4/src/mw4/assets/model3D/dome-column.stl

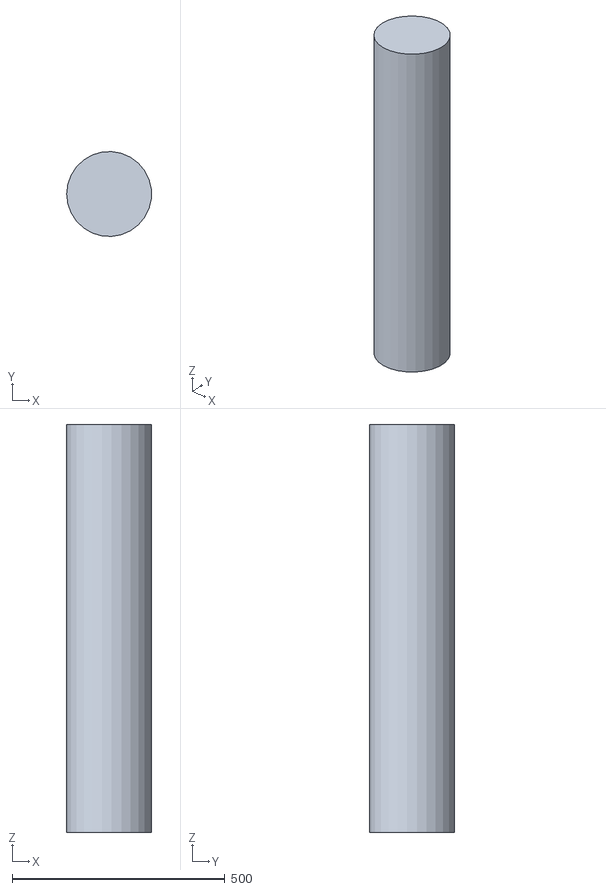
[picture p57: CAD file, 2020-06-18]
src/mw4/assets/model3D/dome-column.stl
199.3 x 199.7 x 960.0
