mworion/MountWizzard4/src/mw4/assets/model3D/mount-head-knobs.stl

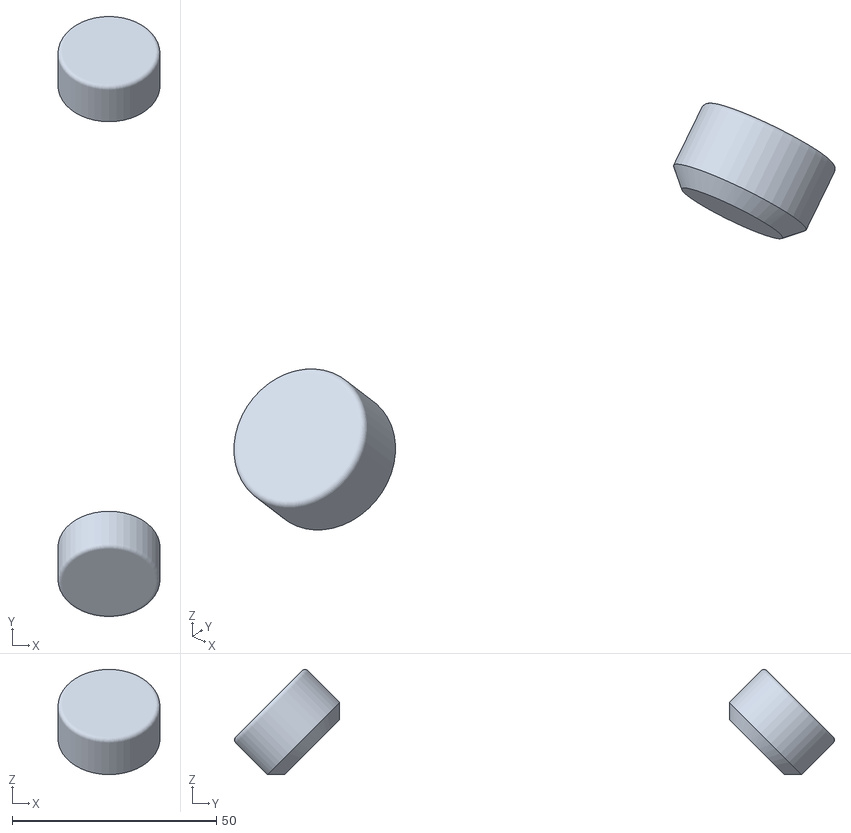
[picture p58: CAD file, 2020-06-18]
src/mw4/assets/model3D/mount-head-knobs.stl
25.0 x 146.8 x 25.7
