mworion/MountWizzard4/src/mw4/assets/model3D/mount-dec-knobs.stl

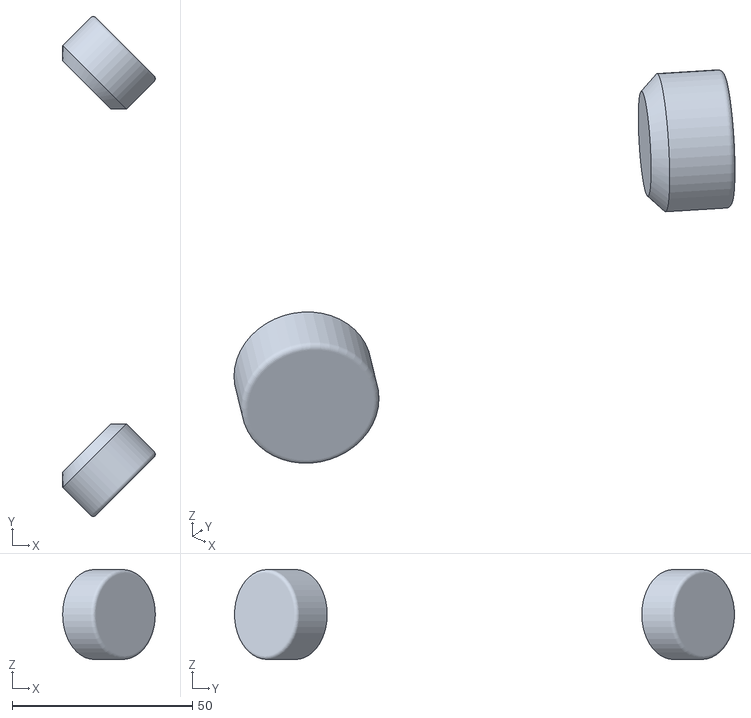
[picture p59: CAD file, 2020-06-18]
src/mw4/assets/model3D/mount-dec-knobs.stl
25.7 x 138.9 x 25.0
