mworion/MountWizzard4/src/mw4/assets/model3D/dome-base.stl

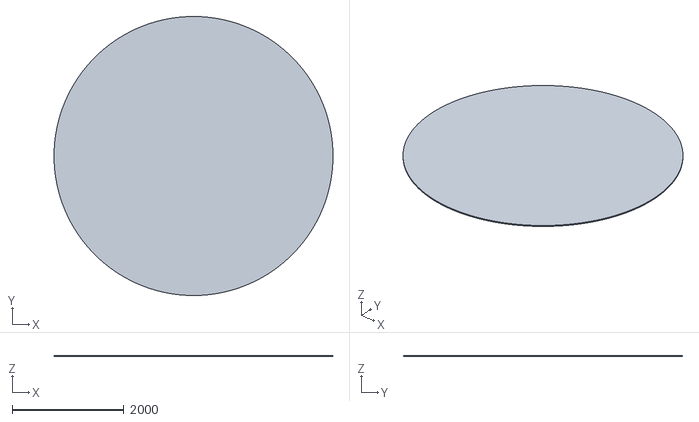
[picture p60: CAD file, 2020-06-13]
src/mw4/assets/model3D/dome-base.stl
4999.2 x 4999.6 x 20.0
