mworion/MountWizzard4/src/mw4/assets/model3D/dome-rose.stl

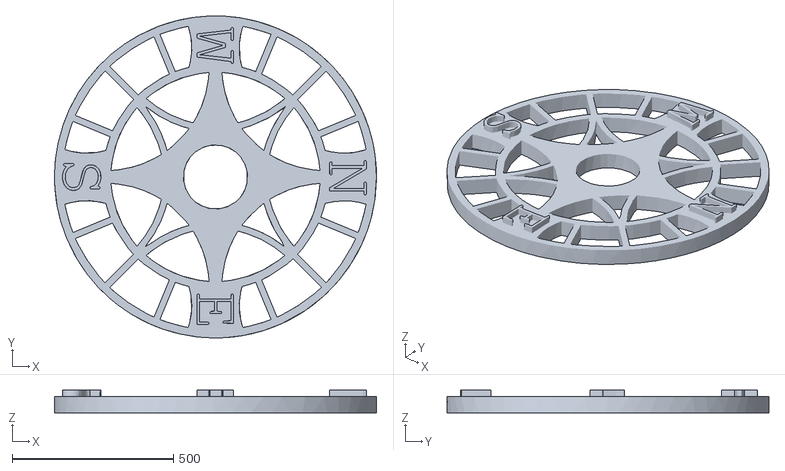
[picture p61: CAD file, 2020-06-13]
src/mw4/assets/model3D/dome-rose.stl
999.6 x 999.3 x 70.0
