mworion/MountWizzard4/src/mw4/assets/model3D/dome-rose-char.stl

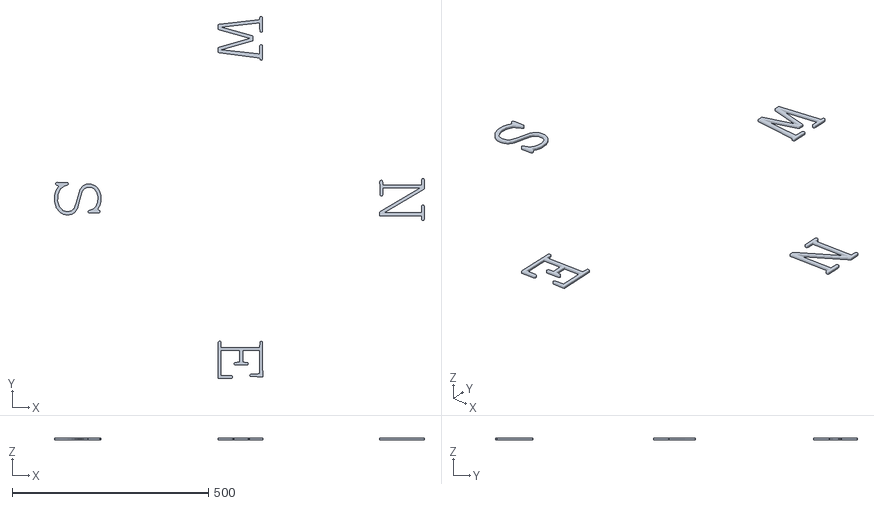
[picture p62: CAD file, 2020-06-13]
src/mw4/assets/model3D/dome-rose-char.stl
942.7 x 922.8 x 5.00
