mworion/MountWizzard4/src/mw4/assets/model3D/dome-floor.stl

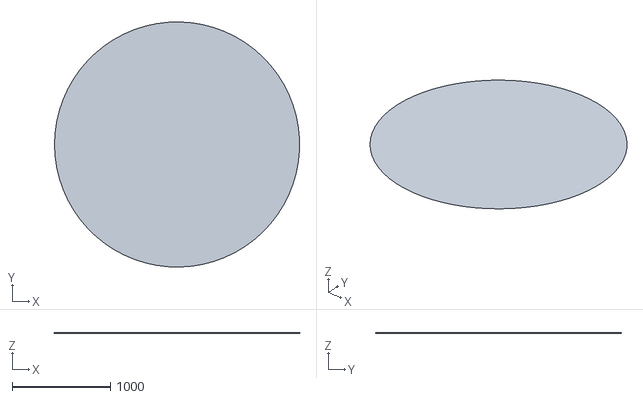
[picture p63: CAD file, 2020-06-13]
src/mw4/assets/model3D/dome-floor.stl
2498.6 x 2499.3 x 2.00
