mworion/MountWizzard4/src/mw4/assets/model3D/mount-ra.stl

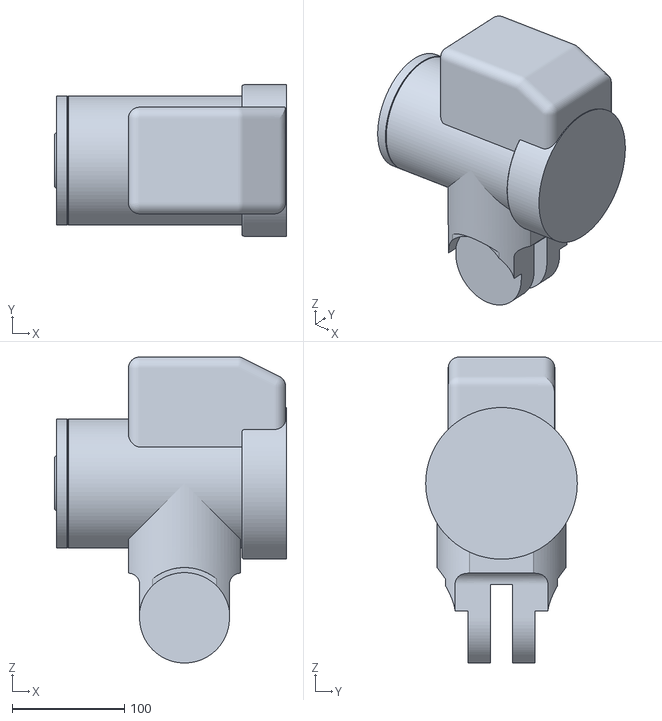
[picture p64: CAD file, 2020-06-12]
src/mw4/assets/model3D/mount-ra.stl
207.0 x 135.0 x 272.5
