mworion/MountWizzard4/src/mw4/assets/model3D/mount-dec.stl

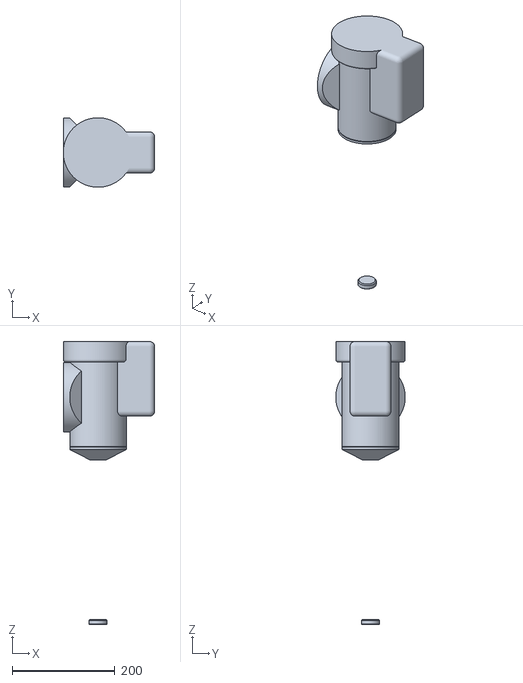
[picture p65: CAD file, 2020-06-12]
src/mw4/assets/model3D/mount-dec.stl
177.5 x 135.0 x 550.0
