mworion/MountWizzard4/src/mw4/assets/model3D/mount-dec-weights.stl

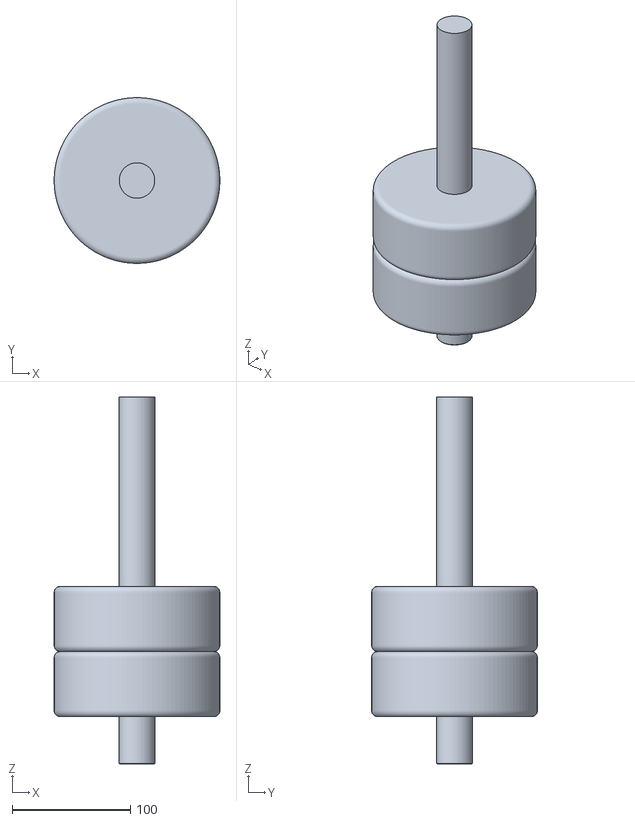
[picture p66: CAD file, 2020-06-12]
src/mw4/assets/model3D/mount-dec-weights.stl
140.0 x 140.0 x 310.0
