mworion/MountWizzard4/src/mw4/assets/model3D/ota-focus.stl

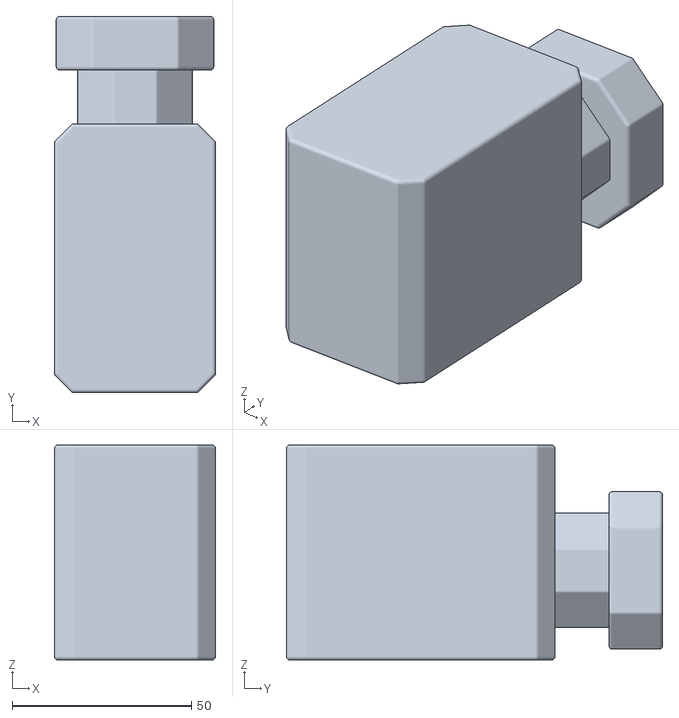
[picture p67: CAD file, 2020-06-12]
src/mw4/assets/model3D/ota-focus.stl
45.0 x 105.0 x 60.0
