mworion/MountWizzard4/src/mw4/assets/model3D/ota-imagetrain.stl

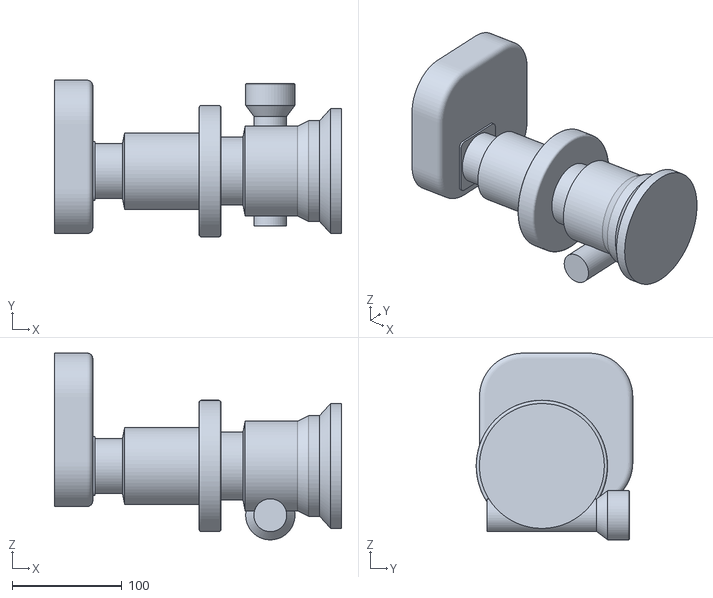
[picture p68: CAD file, 2020-06-12]
src/mw4/assets/model3D/ota-imagetrain.stl
262.0 x 143.0 x 170.5
