mworion/MountWizzard4/src/mw4/assets/model3D/ota-ccd.stl

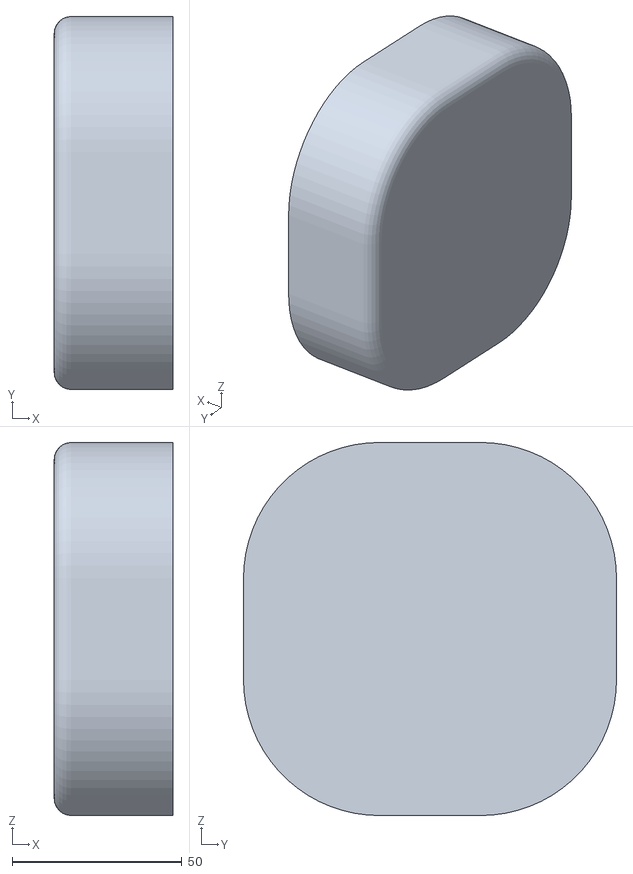
[picture p69: CAD file, 2020-06-12]
src/mw4/assets/model3D/ota-ccd.stl
35.0 x 110.0 x 110.0
