mworion/MountWizzard4/src/mw4/assets/model3D/ota-ring-s.stl

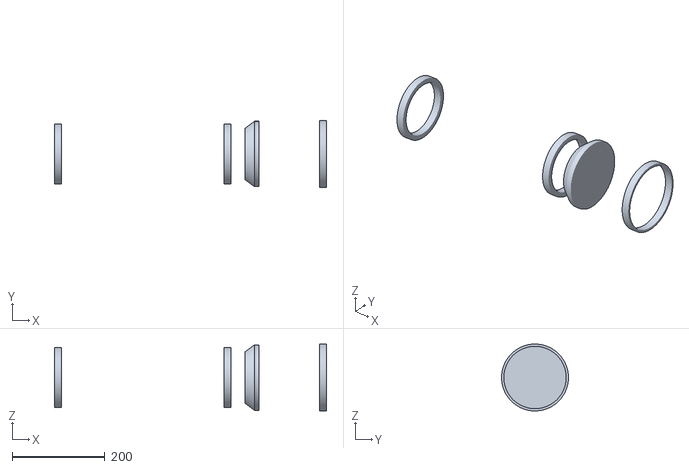
[picture p70: CAD file, 2020-06-12]
src/mw4/assets/model3D/ota-ring-s.stl
585.0 x 144.0 x 144.0
