mworion/MountWizzard4/src/mw4/assets/model3D/mount-base.stl

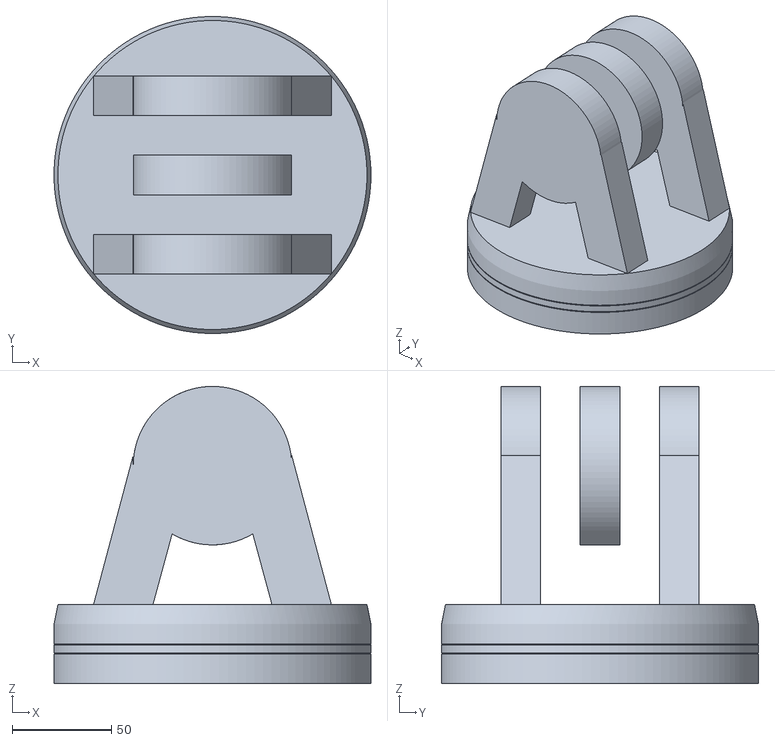
[picture p71: CAD file, 2020-06-12]
src/mw4/assets/model3D/mount-base.stl
160.0 x 160.0 x 150.0
