mworion/MountWizzard4/src/mw4/assets/model3D/mount-base-knobs.stl

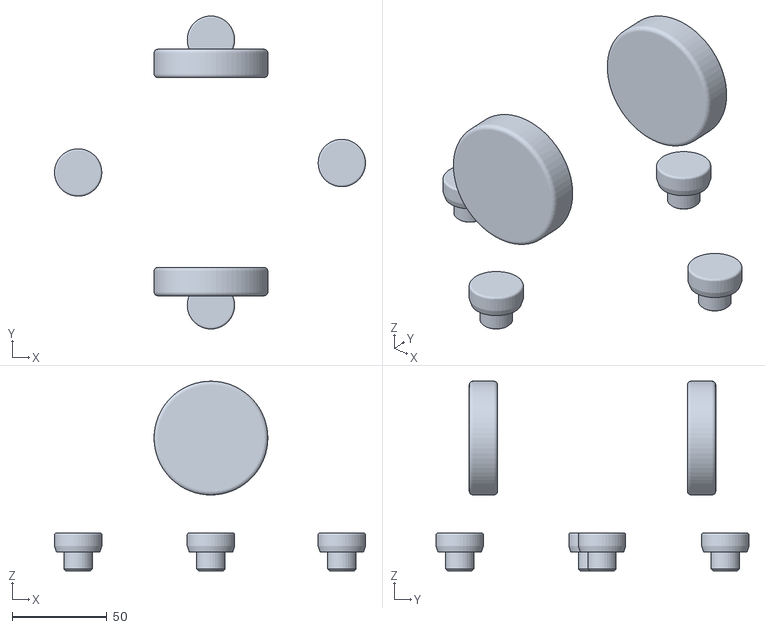
[picture p72: CAD file, 2020-06-12]
src/mw4/assets/model3D/mount-base-knobs.stl
164.0 x 165.0 x 100.0
