mworion/MountWizzard4/src/mw4/assets/model3D/ota-focus-top.stl

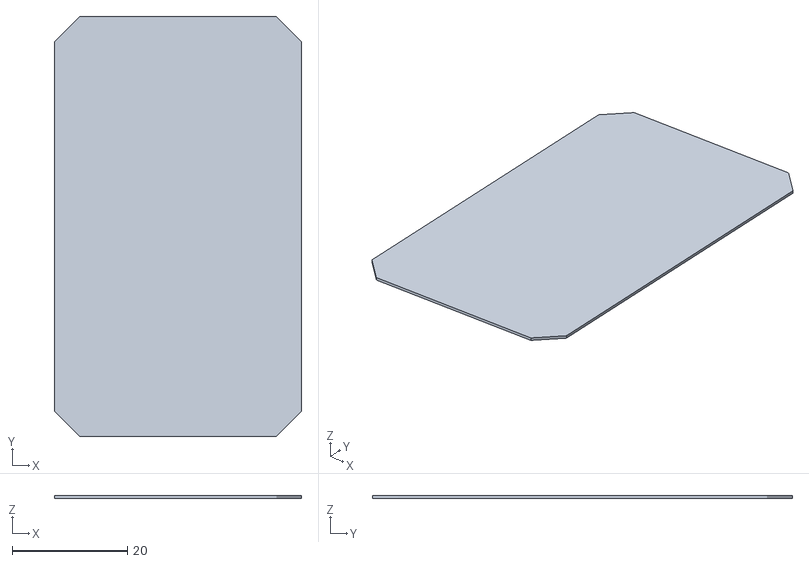
[picture p73: CAD file, 2020-06-12]
src/mw4/assets/model3D/ota-focus-top.stl
43.0 x 73.0 x 0.5
