mworion/MountWizzard4/src/mw4/assets/model3D/mount-head.stl

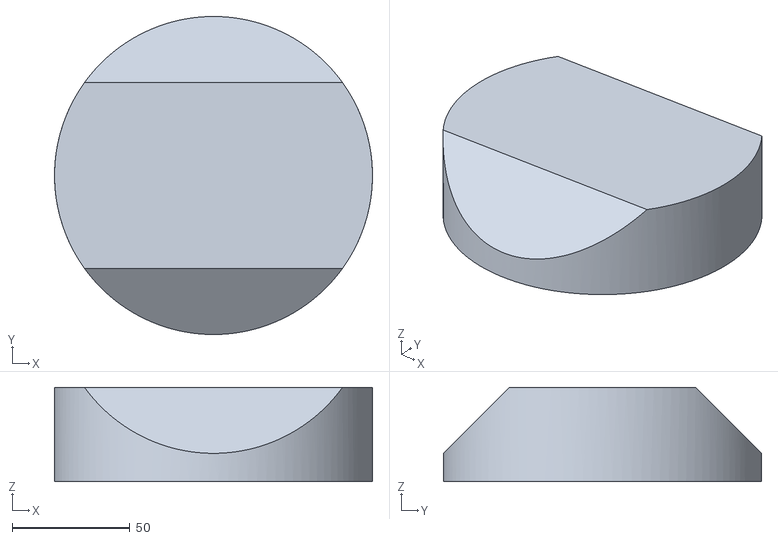
[picture p74: CAD file, 2020-06-12]
src/mw4/assets/model3D/mount-head.stl
135.0 x 135.0 x 40.0
