mworion/MountWizzard4/src/mw4/assets/model3D/ota-tube-s.stl

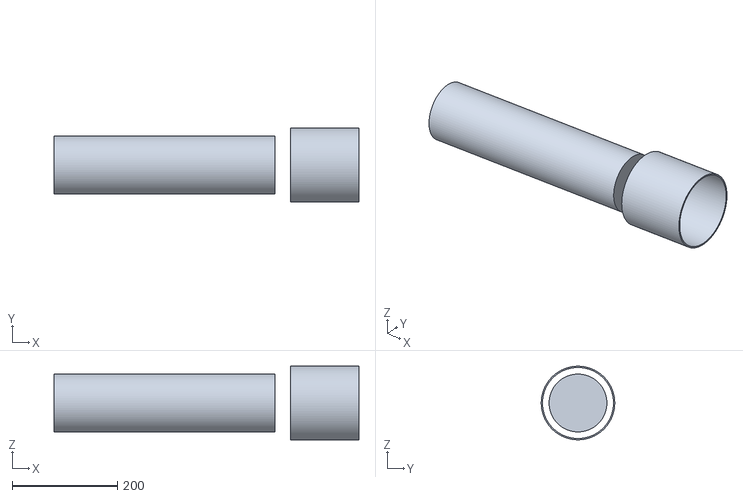
[picture p75: CAD file, 2020-06-12]
src/mw4/assets/model3D/ota-tube-s.stl
580.0 x 140.0 x 139.9
