mworion/MountWizzard4/src/mw4/assets/model3D/ota-plate.stl

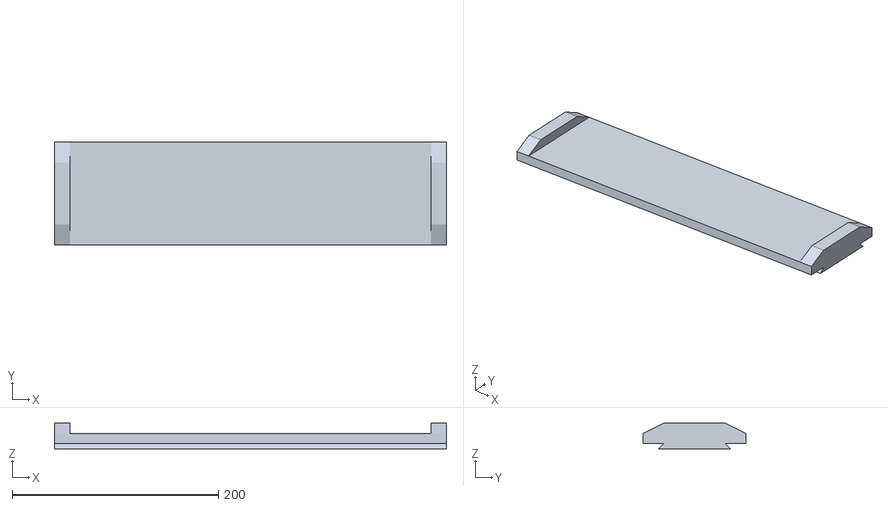
[picture p76: CAD file, 2020-06-12]
src/mw4/assets/model3D/ota-plate.stl
380.0 x 100.0 x 25.0
