mworion/MountWizzard4/(list of files, cad)

Other CAD files:
src/mw4/assets/model3D/dome-door1.stl
