mworion/MountWizzard4/docs/source/install_python.rst

Python Installation
===================
MW4 is a python3 application based on some python libraries and uses Qt as framework for
GUI. Different to past versions of MW there will be no one box solution (MAC bundle, EXE
File, etc.) available. As MW4 is python3 and comes with internal update functionality, it
uses a standard python3 environment. Ideally it is recommended in a virtualenv.

MW4 is tested on python3.7.6. The first step is to install the python3.7.x package if not
already installed. For all platforms there is an installer available. Please follow the
descriptions that comes with the installers. To give a short overview here are some quick
installation hints for all platforms. The installers for Windows and OSx can be downloaded
from python.org.

.. warning::
    Please do not use a newer version of python than 3.7.x! Some libraries bring precompiled
    binaries with them and they might not be available for a newer python version. The actual
    python3.7 version is python3.7.6! A good overview what could run is in the readme on
    github.

If you already have python3.7.x installed, you can skip this section and go directly to the
MW4 installation process. If you have to install python3.7.x this has to be done only once for
as many MW4 installations you might want.

There is a video on youtube with the install process python: https://youtu.be/xJxpx_SmrVc.

Windows
-------
Depending on your Windows version please download or directly run the web installer for 3.7.6
from:

https://www.python.org/ftp/python/3.7.6/python-3.7.6-amd64-webinstall.exe

and follow the installation procedure.

.. warning::
    Please take care, that during the installation the checkbox "Add Python Path" is selected.

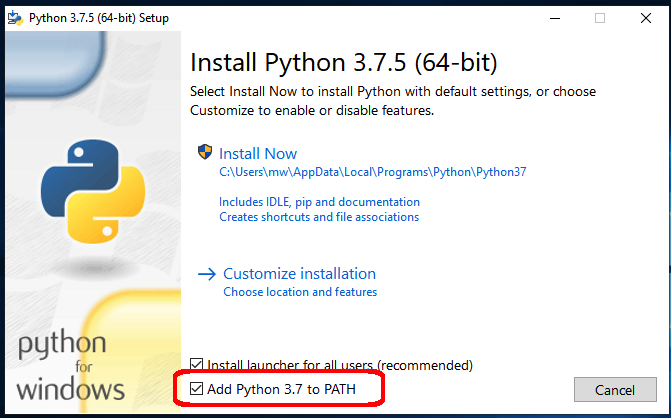
[picture p92: docs/source/_static/install_python_win_path.png]


Depending on your preference you could install python 3.7 for a single user or for all
users. MW4 does not need admin rights to run, so please feel free to choose the variant
you would like to use.

Mac OSx
-------
Depending on your OSx version please download the installer for 3.7 from:

https://www.python.org/downloads/mac-osx/

and follow the installation procedure. Depending on your preference you could install python
3.7.x for a single user or for all users. MW4 does not need admin rights to run, so please
feel free to choose the variant you would like to use.

Ubuntu
------
Referring to Ubuntu 18.04 LTS as it comes only with python3.6, you need to upgrade to
python3.7.x. This could be done by adding an appropriate repo, which enables this version.

.. warning::
    Please update to python3.7.x in a way, which fits best to your environment. There are many
    descriptions out, so please search for it in case you don't know exactly.

An example is from: https://linuxize.com/post/how-to-install-python-3-7-on-ubuntu-18-04/

.. code-block:: python

    sudo add-apt-repository ppa:deadsnakes/ppa
    sudo apt-get update
    sudo apt-get upgrade
    sudo apt-get install python3.7

Please check the right version and the availability of virtualenv in your setup.
