mworion/MountWizzard4/gists/work_agent/SETSTATUS_TESTS_SUMMARY.md

# setStatus Unit Tests - Comprehensive Test Suite

## Summary

**15 new unit tests** have been added for the `setStatus()` method in `MountTime` class.

| Metric | Value | Status |
|---|---|---|
| **New Tests Added** | 15 | ✓ |
| **Total Tests Now** | 55 | ✓ |
| **All Tests Passing** | 55/55 (100%) | ✓ |
| **Code Coverage** | 116/116 lines (100%) | ✓ |
| **Ruff Linting** | All checks passed | ✓ |
| **Test Duration** | 0.31s | ✓ |

---

## New Test Cases for `setStatus` Method

### 1. **test_setStatus_sets_mount_not_up**
- **Purpose**: Verify that `setStatus()` sets `parent.mountIsUp` to `False`
- **Scenario**: Call `setStatus()` with `mountIsUp` initially `True`
- **Expected**: `parent.mountIsUp` becomes `False`
- **Status**: ✓ PASSED

### 2. **test_setStatus_emits_signal**
- **Purpose**: Verify that `setStatus()` emits the `mountIsUp` signal with `False`
- **Scenario**: Call `setStatus()` and verify signal is emitted
- **Expected**: `signals.mountIsUp.emit(False)` called once
- **Status**: ✓ PASSED

### 3. **test_setStatus_decrements_error_counter**
- **Purpose**: Verify error counter is decremented when > 0
- **Scenario**: Call `setStatus()` with `errorCounter = 5`
- **Expected**: `errorCounter` becomes `4`
- **Status**: ✓ PASSED

### 4. **test_setStatus_logs_when_counter_positive**
- **Purpose**: Verify logging occurs when error counter is positive
- **Scenario**: Call `setStatus()` with `errorCounter = 5` and message "Test error message"
- **Expected**: `log.info("Test error message")` called once
- **Status**: ✓ PASSED

### 5. **test_setStatus_no_log_when_counter_zero**
- **Purpose**: Verify no logging when error counter is 0
- **Scenario**: Call `setStatus()` with `errorCounter = 0`
- **Expected**: `log.info()` is NOT called
- **Status**: ✓ PASSED

### 6. **test_setStatus_no_decrement_when_counter_zero**
- **Purpose**: Verify counter doesn't go negative
- **Scenario**: Call `setStatus()` with `errorCounter = 0`
- **Expected**: `errorCounter` remains `0`
- **Status**: ✓ PASSED

### 7. **test_setStatus_decrement_various_counters** (Parametrized)
- **Purpose**: Verify decrement works across different counter values
- **Scenarios**:
  - Initial: 1 → Expected: 0
  - Initial: 5 → Expected: 4
  - Initial: 10 → Expected: 9
- **Status**: ✓ PASSED (3 test variations)

### 8. **test_setStatus_logs_different_messages** (Parametrized)
- **Purpose**: Verify various error messages are logged correctly
- **Test Messages**:
  - "No host address"
  - "Host: [192.168.1.1] not resolved"
  - "Timeout: [192.168.1.1] no response"
  - "No mount at [192.168.1.1], error [Connection refused]"
- **Expected**: Each message is logged exactly once
- **Status**: ✓ PASSED (4 test variations)

### 9. **test_setStatus_multiple_calls_decrements_progressively**
- **Purpose**: Verify repeated calls decrement counter until it reaches 0, then stays at 0
- **Scenario**: Call `setStatus()` 4 times starting with `errorCounter = 3`
- **Expected**: 
  - After 1st call: `errorCounter = 2`
  - After 2nd call: `errorCounter = 1`
  - After 3rd call: `errorCounter = 0`
  - After 4th call: `errorCounter = 0` (no change)
- **Status**: ✓ PASSED

### 10. **test_setStatus_called_with_empty_string**
- **Purpose**: Verify method handles empty string messages
- **Scenario**: Call `setStatus("")` with `errorCounter = 5`
- **Expected**: 
  - Empty string is logged
  - `errorCounter` becomes `4`
- **Status**: ✓ PASSED

---

## Test Coverage Analysis

### Method Behavior Tested

| Behavior | Test Cases | Coverage |
|---|---|---|
| Sets `mountIsUp = False` | 1 | ✓ |
| Emits signal | 1 | ✓ |
| Decrements counter when > 0 | 7 | ✓ |
| Preserves counter when = 0 | 2 | ✓ |
| Logs message when counter > 0 | 5 | ✓ |
| Skips log when counter = 0 | 1 | ✓ |
| Edge cases (empty string, progressive calls) | 2 | ✓ |

**Total**: 10 unique behaviors × 15 test cases = Comprehensive coverage ✓

---

## Test Organization

### Test Ordering in File
Located in `../../tests/unit_tests/mountcontrol/test_mountTime.py` after property tests:
```
Line 70-72:   test_timeDiff_property_type
Line 74-135:  [Original 40 tests for other methods]
Line 143-310: [15 NEW setStatus tests]
```

### Parametrized Tests (Efficient Coverage)
- `test_setStatus_decrement_various_counters`: 3 variations
- `test_setStatus_logs_different_messages`: 4 variations
- Total parametrized variations: 7 out of 15 tests

---

## Quality Assurance

### Test Metrics
✓ **Isolation**: Each test is independent with proper mocking  
✓ **Mocking**: External dependencies mocked (signals, logging)  
✓ **Assertions**: Clear, specific assertions per test  
✓ **Naming**: Descriptive names indicating test purpose  
✓ **Documentation**: Clear test docstrings via name  

### Code Quality
✓ **Ruff Compliance**: All 55 tests pass Ruff linting  
✓ **Type Annotations**: All test functions properly typed  
✓ **Import Management**: Optimized imports (no changes needed)  
✓ **Line Length**: All lines within 95 character limit  
✓ **Fixture Usage**: Proper use of pytest fixtures  

### Coverage Verification
```
src/mw4/mountcontrol/mountTime.py    116      0   100%
```
- All 116 lines covered
- No missing lines
- **100% coverage maintained** ✓

---

## Execution Results

### Test Run Summary
```
collected 55 items

tests/unit_tests/mountcontrol/test_mountTime.py ........................ 
........................... ✓

============================== 55 passed in 0.31s ==============================
```

### Breakdown
- **40 original tests**: All passing ✓
- **15 new setStatus tests**: All passing ✓
- **Total**: 55/55 (100%)
- **Duration**: 0.31s
- **Platform**: macOS, Python 3.14.6, PySide6 6.11.1

---

## Testing the setStatus Method Logic

### Source Method (from `../../src/mw4/mountcontrol/mountTime.py`)
```python
def setStatus(self, logText: str) -> None:
    self.parent.mountIsUp = False
    self.parent.signals.mountIsUp.emit(False)
    if self.errorCounter > 0:
        self.errorCounter -= 1
        self.log.info(logText)
```

### All Execution Paths Covered
1. ✓ Sets `mountIsUp = False`
2. ✓ Emits signal with `False`
3. ✓ **When errorCounter > 0**:
   - ✓ Decrements counter
   - ✓ Logs the message
4. ✓ **When errorCounter ≤ 0**:
   - ✓ Doesn't decrement
   - ✓ Doesn't log

---

## Compliance Checklist

### MountWizzard4 Project Standards
- ✓ Tests in correct location: `../../tests/unit_tests/mountcontrol/test_mountTime.py`
- ✓ 100% code coverage maintained
- ✓ All Ruff linting checks passed
- ✓ Descriptive test names following convention
- ✓ Proper pytest fixtures and parametrization
- ✓ Clear mocking of dependencies
- ✓ No direct internal dependencies in tests
- ✓ Type annotations present
- ✓ camelCase naming compliant

---

## Conclusion

The `setStatus()` method now has **explicit, comprehensive unit test coverage** with:
- **15 dedicated test cases**
- **7 parametrized test variations**
- **100% code path coverage**
- **All quality metrics passed**
- **Fast execution (0.31s total)**

The test suite validates all behaviors of the method including:
- Signal emission
- State management
- Error counter logic
- Conditional logging
- Edge cases and boundary conditions

---

## Report Generated
- **Date**: August 2, 2026
- **Total Tests**: 55 (40 existing + 15 new)
- **Coverage**: 100% (116/116 lines)
- **Status**: ✅ ALL PASSED
