mworion/MountWizzard4/gists/work_agent/TEST_STYLES_COVERAGE.md

# Test Styles Coverage Report

## Summary
Successfully achieved **100% test coverage** for the `test_styles` module.

## Initial Coverage Issue
- **Coverage**: 99%
- **Missing Line**: Line 32 in `src/mw4/gui/styles/styles.py`
- **Issue**: The `STYLE = NON_MAC_STYLE + BASIC_STYLE` assignment only executes on non-Darwin systems, but tests were running on macOS (Darwin)

## Solution

### Code Refactoring
Refactored the platform-specific code from a class-level if/else statement to a callable static method:

**Before:**
```python
class Styles:
    # ...
    if platform.system() == "Darwin":
        STYLE = MAC_STYLE + BASIC_STYLE
    else:
        STYLE = NON_MAC_STYLE + BASIC_STYLE  # Line 32 - not covered on Darwin
```

**After:**
```python
class Styles:
    # ...
    @staticmethod
    def getStyle() -> str:
        """Get the appropriate stylesheet based on the platform."""
        if platform.system() == "Darwin":
            return MAC_STYLE + BASIC_STYLE
        return NON_MAC_STYLE + BASIC_STYLE

    STYLE = None

# ... rest of class ...

# Initialize STYLE after class definition
Styles.STYLE = Styles.getStyle()
```

### Test Additions
Added two new tests to cover both platform paths:

1. **`test_getStyle_darwin`**: Verifies `getStyle()` returns MAC_STYLE when platform is mocked as Darwin
2. **`test_getStyle_nonDarwin`**: Verifies `getStyle()` returns NON_MAC_STYLE when platform is mocked as Linux

Both tests use `unittest.mock.patch` to mock `platform.system()` and test both code paths.

## Final Coverage Results

```
Name                                Stmts   Miss  Cover   Missing
-----------------------------------------------------------------
src/mw4/gui/styles/__init__.py          0      0   100%
src/mw4/gui/styles/colors.py            1      0   100%
src/mw4/gui/styles/forms.py             1      0   100%
src/mw4/gui/styles/images.py            1      0   100%
src/mw4/gui/styles/styleSheets.py       3      0   100%
src/mw4/gui/styles/styles.py          170      0   100%
-----------------------------------------------------------------
TOTAL                                 176      0   100%

20 passed in 0.25s
```

## Benefits

✅ **100% test coverage** achieved  
✅ All 20 tests pass  
✅ Platform-specific code paths are now testable  
✅ Both Darwin and non-Darwin style sheets are validated  
✅ Code is more maintainable (method-based instead of class-level if/else)

## Files Modified

- `src/mw4/gui/styles/styles.py` - Refactored platform-specific STYLE initialization
- `tests/unit_tests/gui/styles/test_styles.py` - Added two new tests for getStyle() method
