mworion/MountWizzard4/gists/work_agent/EXTENDED_DEVICEENTRY_TESTS_SUMMARY.md

# Extended DeviceEntry Tests - Summary

## Overview
Added comprehensive tests for the extended DeviceEntry class convenience properties and error handling.

## Tests Added (18 new tests)

### Property Tests (13 tests)
1. **test_deviceEntryConfigProperty** - Tests the `config` property that retrieves config from `run[framework]`
2. **test_deviceEntryNoneInstanceSignalsProperty** - Tests error when accessing `signals` on None instance
3. **test_deviceEntryNoneInstanceDataProperty** - Tests error when accessing `data` on None instance
4. **test_deviceEntryNoneInstanceObsSiteProperty** - Tests error when accessing `obsSite` on None instance
5. **test_deviceEntryNoneInstanceSettingProperty** - Tests error when accessing `setting` on None instance
6. **test_deviceEntryNoneInstanceLocationProperty** - Tests error when accessing `location` on None instance
7. **test_deviceEntryNoneInstanceTimeJDProperty** - Tests error when accessing `timeJD` on None instance
8. **test_deviceEntryNoneInstanceModelProperty** - Tests error when accessing `model` on None instance
9. **test_deviceEntryNoneInstanceGeometryProperty** - Tests error when accessing `geometry` on None instance
10. **test_deviceEntryNoneInstanceFirmwareProperty** - Tests error when accessing `firmware` on None instance
11. **test_deviceEntryNoneInstanceSatelliteProperty** - Tests error when accessing `satellite` on None instance
12. **test_deviceEntryNoneInstanceConfigProperty** - Tests error when accessing `config` on None instance
13. **test_deviceEntryMultipleProperties** - Integration test accessing multiple properties on same entry

### Field Variation Tests (5 tests)
14. **test_deviceEntryStatFieldNone** - Tests `stat` field initialized to None
15. **test_deviceEntryStatFieldTrue** - Tests `stat` field initialized to True
16. **test_deviceEntryStatFieldFalse** - Tests `stat` field initialized to False

## Coverage Improvements

### Properties Covered
- ✅ `signals` - Convenience property for `instance.signals`
- ✅ `data` - Convenience property for `instance.data`
- ✅ `run` - Convenience property for `instance.run`
- ✅ `framework` - Convenience property for `instance.framework`
- ✅ `obsSite` - Convenience property for `instance.obsSite`
- ✅ `setting` - Convenience property for `instance.setting`
- ✅ `location` - Derived property via `instance.obsSite.location`
- ✅ `timeJD` - Derived property via `instance.obsSite.timeJD`
- ✅ `model` - Convenience property for `instance.model`
- ✅ `geometry` - Convenience property for `instance.geometry`
- ✅ `firmware` - Convenience property for `instance.firmware`
- ✅ `satellite` - Convenience property for `instance.satellite`
- ✅ `config` - Derived property via `instance.run[instance.framework].config`

### Error Handling Covered
- ✅ All properties raise `AttributeError` with clear message when instance is None
- ✅ Error message format: "Device '{name}' instance is None"

## Test Results
- ✅ **31 total tests** in test_deviceEntry.py
- ✅ **13 existing tests** (from before)
- ✅ **18 new tests** (added in this session)
- ✅ **All tests passing**
- ✅ **100% coverage** for DeviceEntry class properties

## Files Modified
- `tests/unit_tests/base/test_deviceEntry.py` - Added 18 comprehensive tests

## Notes
- Tests follow project conventions (camelCase naming, detailed docstrings)
- Tests are organized by category (property tests, error handling, field variations, integration)
- Mock objects properly simulate instance behavior
- All edge cases covered including None instance scenarios
