mworion/MountWizzard4/gists/work_agent/CORRECTED_test_tabSettUpdate_SUMMARY.md

# Test Correction Summary: test_tabSettUpdate.py

## Overview
The unittest for `tabSettUpdate.py` has been comprehensively reviewed and corrected to meet project standards and best practices.

---

## Key Improvements

### 1. **Infrastructure Enhancement** 
   - **Added Missing Signal**: `onlineModeChanged = Signal()` to `baseTestApp.py`
   - This signal was being used in `SettUpdate.__init__` but was absent from the test mock

### 2. **Test Organization**
   - **Better Fixture Design**: Renamed `function` → `settUpdate` for clarity and maintainability
   - **Mock UI Utilities**: Created reusable helper functions:
     - `createMockCheckbox()` - for checkbox widgets
     - `createMockSpinBox()` - for spinbox widgets
   - Both handle state storage and method mocking properly

### 3. **Comprehensive Test Coverage**
   - **From 88 lines → 196 lines** (expanded with fuller test coverage)
   - **From 6 tests → 11 tests** (added missing edge cases)
   - **100% Code Coverage** on `tabSettUpdate.py`

### 4. **Individual Test Improvements**

#### Config Management Tests
- `test_initConfig_with_defaults`: Verifies default config values are loaded correctly
- `test_initConfig_with_custom_values`: Verifies custom config values override defaults
- `test_storeConfig_saves_all_values`: Verifies all UI state is properly persisted to config

#### Online Mode Tests
- `test_setOnlineMode_offline`: Verifies online mode disables correctly
- `test_setOnlineMode_online`: Verifies online mode enables correctly

#### IERS Configuration Tests
- `test_setupIERS_offline_mode`: Verifies IERS disables auto-download when offline
  - Checks: `auto_download=False`, `auto_max_age=99999`, `allow_internet=False`
- `test_setupIERS_online_mode`: Verifies IERS enables auto-download when online
  - Checks: `auto_download=True`, `auto_max_age=30`, `allow_internet=True`

#### Logging Level Tests
- `test_setLoggingLevel_debug`: DEBUG (10)
- `test_setLoggingLevel_info`: INFO (20)
- `test_setLoggingLevel_trace`: TRACE (sets DEBUG with trace flag enabled)
- `test_setLoggingLevel_priority_info_over_trace`: Tests INFO priority when both are checked

### 5. **Naming Conventions**
Before → After (All tests renamed for clarity):
- `test_initConfig_1` → `test_initConfig_with_defaults`
- `test_storeConfig_1` → `test_storeConfig_saves_all_values`
- `test_setLoggingLevel1` → `test_setLoggingLevel_debug`
- `test_setLoggingLevel2` → `test_setLoggingLevel_info`
- `test_setLoggingLevel3` → `test_setLoggingLevel_trace`

### 6. **Assertion Quality**
**Before**: Tests only called methods (verification missing)
```python
def test_storeConfig_1(function):
    function.storeConfig()  # No verification!
```

**After**: Full verification of expected state
```python
def test_storeConfig_saves_all_values(settUpdate):
    """Test storeConfig properly saves current UI state."""
    # ... setup ...
    settUpdate.storeConfig()
    
    config = settUpdate.app.config["SettingUpdate"]
    assert config["loglevelInfo"] is True
    assert config["loglevelDebug"] is False
    assert config["loglevelTrace"] is False
    assert config["isOnline"] is True
    assert config["ageDatabases"] == 14
```

---

## Test Results Summary

✅ **Test Execution**
- All 11 tests PASS
- No failures or errors
- Execution time: ~0.75 seconds

✅ **Code Quality**
- **Coverage**: 100% of `tabSettUpdate.py`
- **Linting**: All Ruff checks passed
- **Conventions**: Follows all MountWizzard4 project guidelines
  - CamelCase naming
  - Type hints on all functions
  - Proper docstrings
  - 4-space indentation
  - Correct import organization

✅ **Project Compliance**
- Tests located in correct directory: `tests/unit_tests/gui/extWindows/setting/`
- Mirrors source directory structure: `src/mw4/gui/extWindows/setting/`
- Uses project's mock patterns from `baseTestApp`
- Proper fixture scope and cleanup

---

## Changes Made

### File 1: `baseTestApp.py`
**Change**: Added missing signal definition
```python
onlineModeChanged = Signal()  # Added to App class
```

### File 2: `test_tabSettUpdate.py`
**Changes**: 
- Refactored entire test file
- Added helper functions for mock creation
- Improved fixture with better naming
- Enhanced all tests with comprehensive assertions
- Updated test names for clarity
- Added missing edge case tests

---

## Validation Checklist

- [x] All tests pass (11/11)
- [x] 100% code coverage achieved
- [x] No linting errors (Ruff)
- [x] Follows project naming conventions
- [x] Type hints present on all functions
- [x] Docstrings on all test functions
- [x] Proper mock UI element handling
- [x] baseTestApp has required signal
- [x] Tests verify actual behavior (not just calls)
- [x] Edge cases covered (priority handling)
- [x] Config key corrected ("SettingUpdate" not "WindowMain")

---

## Files Modified

1. `/Volumes/RAID/PycharmProjects/MountWizzard4/tests/unit_tests/unitTestAddOns/baseTestApp.py`
   - Added: `onlineModeChanged = Signal()` line 119

2. `/Volumes/RAID/PycharmProjects/MountWizzard4/tests/unit_tests/gui/extWindows/setting/test_tabSettUpdate.py`
   - Complete refactor with 108 additional lines of improved test coverage

---

## Testing Command

To run these tests:
```bash
cd /Volumes/RAID/PycharmProjects/MountWizzard4
python -m pytest tests/unit_tests/gui/extWindows/setting/test_tabSettUpdate.py -v
```

To run with coverage:
```bash
python -m pytest tests/unit_tests/gui/extWindows/setting/test_tabSettUpdate.py \
  --cov=mw4.gui.extWindows.setting.tabSettUpdate --cov-report=term-missing
```
