mworion/MountWizzard4/gists/work_agent/PLAN_test_tabSettUpdate.md

# Plan: Fix unittest for tabSettUpdate

## Issues Identified and RESOLVED ✅

### 1. **Missing Signal in baseTestApp** ✅
   - **Issue**: `onlineModeChanged` signal was used in SettUpdate.__init__ but not defined in App stub
   - **Solution**: Added `onlineModeChanged = Signal()` to baseTestApp.py App class
   - **File**: `/Volumes/RAID/PycharmProjects/MountWizzard4/tests/unit_tests/unitTestAddOns/baseTestApp.py`

### 2. **Test Configuration Issues** ✅
   - **Issue**: test_initConfig_1 used wrong config key "WindowMain" instead of "SettingUpdate"
   - **Solution**: Fixed to use correct config key "SettingUpdate"
   - **Enhancement**: Added two test cases - one for defaults and one for custom values with full assertions
   - **Tests**: 
     - `test_initConfig_with_defaults` - verifies default values are loaded
     - `test_initConfig_with_custom_values` - verifies custom config values are loaded

### 3. **Poor Test Naming & Structure** ✅
   - **Issue**: Fixture named "function" instead of descriptive name
   - **Solution**: Renamed fixture to `settUpdate` for clarity
   - **Enhancement**: Added helper functions `createMockCheckbox()` and `createMockSpinBox()` to create proper mock UI elements
   
   - **Issue**: Test names used numeric suffixes (test_setLoggingLevel1, etc.)
   - **Solution**: Renamed tests with descriptive names:
     - `test_setLoggingLevel1` → `test_setLoggingLevel_debug`
     - `test_setLoggingLevel2` → `test_setLoggingLevel_info`
     - `test_setLoggingLevel3` → `test_setLoggingLevel_trace`

### 4. **Missing Test Coverage** ✅
   - **Issue**: Multiple tests didn't verify actual behavior
   - **Solution**: Added comprehensive assertions to all tests:
     - `test_storeConfig_1` → `test_storeConfig_saves_all_values` (now verifies config is stored)
     - `test_setupIERS_1/2` → `test_setupIERS_offline_mode` / `test_setupIERS_online_mode` (now verifies state changes)

### 5. **Missing Edge Cases** ✅
   - **Issue**: No tests for priority handling when multiple options checked
   - **Solution**: Added `test_setLoggingLevel_priority_info_over_trace`
   - **Coverage**: 100% of source code

### 6. **Mock UI Elements** ✅
   - **Issue**: UI fixture wasn't creating necessary mock widgets
   - **Solution**: Created helper functions to generate:
     - `createMockCheckbox()` - creates checkbox with proper isChecked()/setChecked() behavior
     - `createMockSpinBox()` - creates spinbox with proper value()/setValue() behavior
   - **Applied to**: loglevelInfo, loglevelDebug, loglevelTrace, isOnline, ageDatabases

---

## Test Results

✅ **All Tests Pass**: 11/11 tests passed
✅ **Code Coverage**: 100% of tabSettUpdate.py
✅ **Linting**: All checks passed (Ruff)
✅ **Follows Project Guidelines**:
   - Proper fixture naming
   - Comprehensive assertions
   - Descriptive test names
   - Mock UI elements with proper behavior
   - Type hints on helper functions
   - Docstrings on all functions
   - CamelCase naming conventions

---

## Files Modified

1. **`tests/unit_tests/unitTestAddOns/baseTestApp.py`**
   - Added: `onlineModeChanged = Signal()` to App class

2. **`tests/unit_tests/gui/extWindows/setting/test_tabSettUpdate.py`**
   - Entire file refactored with improvements listed above
   - From 88 lines to 196 lines (added comprehensive tests and helper functions)
   - Improved code quality and maintainability
