mworion/MountWizzard4/gists/work_agent/TEST_REVIEW_tabMount_Park.md

# Test Review: test_tabMount_Park.py

**Status**: ⚠️ **NEEDS FIXES** (1 failing test + multiple issues)

---

## Issues Found

### 🔴 Critical Issues

#### 1. **Failing Test: `test_updateParkButtonText_default_text`**
- **Location**: Line 152-153
- **Issue**: Test expects `"-"` but actual implementation returns empty string
- **Reason**: When config doesn't contain a key, `config.get()` returns `None`, and `setText(None)` results in an empty string, not `"-"`
- **Fix**: Change assertion to `assert function.parkButtons[0].text() == ""`

#### 2. **Incorrect slewToPark Tests**
- **Location**: Lines 157-247 (all `test_slewToPark_*` tests)
- **Issue**: Tests create mock attributes (`posAlt`, `posAz`, `posTexts`) that don't exist in the actual implementation
- **Root Cause**: The actual code uses `Angle(degrees=config.get(...))` to get values directly from config, not from instance attributes
- **Impact**: Tests pass but don't actually test the real implementation behavior
- **Fix**: Refactor these tests to properly mock config values and verify actual behavior

---

### ⚠️ Code Quality Issues

#### 3. **Non-Descriptive Fixture Name**
- **Location**: Line 9
- **Issue**: Fixture named `function` is too generic and unclear
- **Impact**: Reduces test readability and maintainability
- **Fix**: Rename to descriptive name like `park_widget` or `park_tab`
- **Project Rule**: Follow camelCase naming convention consistently

#### 4. **Repetitive Mock Pattern in Tests**
- **Location**: Lines 140-152, 165-174, 180-189, 195-204
- **Issue**: Multiple tests repeat the same pattern:
  ```python
  mock_msg = mock.MagicMock()
  original_msg = function.msg
  function.msg = mock_msg
  try:
      # test code
  finally:
      function.msg = original_msg
  ```
- **Fix**: Extract into a pytest fixture or context manager for better code reuse

#### 5. **Module-Scoped Fixture**
- **Location**: Line 8
- **Issue**: `scope="module"` on fixture means state is shared across all tests
- **Impact**: Tests might affect each other if any test modifies state
- **Fix**: Change to `scope="function"` for test isolation
- **Project Rule**: Tests should be independent

#### 6. **Superficial Attribute Existence Tests**
- **Location**: Lines 23-82
- **Issue**: Tests like `test_park_has_parkButtons_attribute` only check if attribute exists
- **Poor Value**: These tests add no real value; they'll pass as long as the class doesn't break
- **Fix**: Remove trivial tests or merge into behavioral tests

#### 7. **Missing Type Annotations on Test Functions**
- **Example**: `def test_park_class_exists():` (line 23)
- **Project Rule**: "Type annotations must be used for all functions"
- **Fix**: Add return type annotations (typically `-> None`)

#### 8. **No Test Documentation**
- **Issue**: Tests lack meaningful docstrings explaining WHAT is being tested and WHY
- **Example**: `test_updateParkButtonText_with_config` doesn't explain the purpose
- **Fix**: Add docstrings following project patterns

---

### 📋 Missing Test Coverage

#### 9. **Edge Cases Not Tested**
- Invalid park indices (< 0 or >= 10) in `slewToPark()`
- None/missing config values with different data types
- Empty config dictionary behavior
- Rapid consecutive calls to `slewToPark()`

#### 10. **Signal Connections Not Verified**
- Line 32-33 of implementation: parkButtons signal connections aren't tested
- `parkChanged` signal connection isn't tested

#### 11. **Button Enabled/Disabled State Not Verified**
- Implementation sets `setEnabled(bool(text))` but no test verifies this

---

## Test Execution Results

```
29 PASSED ✓
1 FAILED  ✗

FAILED: test_updateParkButtonText_default_text
- Expected: "-"
- Actual: ""
- Reason: setText(None) produces empty string
```

---

## Recommendations

### Essential (Before Merging)
1. ✅ Fix the failing test `test_updateParkButtonText_default_text`
2. ✅ Refactor `slewToPark` tests to match actual implementation
3. ✅ Change fixture scope from "module" to "function"
4. ✅ Rename fixture from `function` to `park_widget`

### Recommended (Code Quality)
5. Add type annotations to all test functions (return `-> None`)
6. Extract repeated mock setup pattern into fixture
7. Add docstrings to test functions
8. Add tests for signal connections
9. Add tests for button enabled/disabled state
10. Add edge case tests for invalid indices

### Optional (Nice to Have)
11. Remove trivial attribute existence tests
12. Add more comprehensive integration tests

---

## Test File Summary Statistics

| Metric | Value |
|---|---|
| Total Tests | 30 |
| Passing | 29 |
| Failing | 1 |
| Pass Rate | 96.7% |
| Line Length Max | 74 ✓ (limit: 95) |
| Imports | ✓ Organized |
| Code Coverage | Needs verification |

---

## Next Steps

1. **Run test with fixes** to achieve 100% pass rate
2. **Verify code coverage** is 100% for tabMount_Park.py
3. **Run ruff linter** to check for any style issues
4. **Re-run full test suite** to ensure no regressions
