mworion/MountWizzard4/gists/work_agent/TEST_UPDATES_VERIFICATION.md

# Test Updates Complete - Code Changes Synchronized

## Summary
Updated all tests in `test_qtInputDialog.py` to align with code changes in `qtInputDialog.py`.

## Key Changes Made

### 1. Parameter Name Update
- **Changed**: `defaultValue` → `actualValue` across all tests
- Updated 55 test functions and test fixture

### 2. Code Robustness
- Added proper None value handling
- Implemented upfront value parsing before widget assignment
- Graceful fallback to defaults (0 for int, 0.0 for double, "" for text)

### 3. Ternary Operator Optimization
Simplified if-else blocks to use Python ternary operators:
```python
# Format: value if condition else fallback
parsedValue = int(float(str(actualValue))) if actualValue is not None else 0
```

### 4. Method Improvements
- `validateInput()`: Properly validates input and handles spinbox auto-enforcement
- `onAccept()`: Converts widget values to strings for consistency
- `exec()`: Focuses on input widget and cleans up unnecessary code

## Test Results

| Metric | Result |
|---|---|
| Input Dialog Tests | 55/55 PASSED ✅ |
| Utilities Tests | 328/328 PASSED ✅ |
| Ruff Linting | CLEAN ✅ |
| Type Annotations | COMPLETE ✅ |

## Files Updated

### Modified
- `tests/unit_tests/gui/utilities/test_qtInputDialog.py` - Parameter names aligned
- `src/mw4/gui/utilities/qtInputDialog.py` - Code improvements and bug fixes

## All Tests Verified

✅ Text mode with default values
✅ Integer mode with range validation
✅ Float mode with decimal precision
✅ Echo mode support (Normal, Password)
✅ Min/max boundary enforcement
✅ Widget type verification
✅ Minimum height enforcement (25px)
✅ Class method functionality

## Status: ✓ COMPLETE

Tests are now fully synchronized with code changes. All functionality verified and working correctly.
