mworion/MountWizzard4/gists/work_agent/TESTING_PLAN.md

# Unit Test Review and Corrections Plan

## Summary
✅ **COMPLETED** - All 40 unit tests are now passing and properly aligned with source code.

---

## Issues Identified and Fixed

### 1. test_settingW.py - FIXED ✅
**Issue**: Test `test_window_has_all_tabs` checked for non-existent tabs in the source code.
- Line 120: Removed assertion for `tabSettMisc` (doesn't exist in source)
- Line 121: Removed assertion for `tabSettParkPos` (intentionally commented out in source)
- Line 122: Removed assertion for `tabSettRelay` (doesn't exist in source)

**Source Code Reality**: SettingWindow actually implements:
- ✅ tabSettDevice
- ✅ tabSettMount
- ✅ tabSettDome
- ✅ tabSettUpdate
- ✅ tabSettGui
- ✅ tabSettAudio

**Fix Applied**: 
- Updated test to only assert for tabs that actually exist in the source
- **Result**: 8/8 tests pass ✅

---

### 2. test_tabSettGui.py - FIXED ✅

**Issue 1**: Missing `gameControllerIsRunning` signal in test App mock
- The signal exists in `mainApp.py` (line 48) but was missing from `baseTestApp.py`
- **Fix**: Added `gameControllerIsRunning = Signal(bool)` to baseTestApp.py App class

**Issue 2**: Invalid UI element references
- Test referenced `unitTimeUTC` and `unitTimeLocal` which don't exist in the source code
- Test referenced `soundSatStartTracking` which wasn't initialized in the fixture
- **Fix Applied**:
  - Updated fixture to add `soundSatStartTracking` QComboBox with proper items
  - Updated `test_initConfig_with_defaults` to remove invalid assertions
  - Updated `test_storeConfig_saves_all_values` to remove invalid assertions and test only valid attributes

**Result**: 27/27 tests pass ✅

---

### 3. test_tabSettAudio.py - No Issues ✅
All tests already passing correctly. No changes needed.
**Result**: 5/5 tests pass ✅

---

## Test Results
```
collected 40 items

test_settingW.py                               8 PASSED  ✅
test_tabSettAudio.py                          5 PASSED  ✅
test_tabSettGui.py                           27 PASSED  ✅
                                    ─────────────────────
                           TOTAL:             40 PASSED  ✅
```

---

## Code Quality
- ✅ Ruff formatting: All checks passed
- ✅ No style violations
- ✅ All tests pass with correct functionality
- ✅ Fixture setup matches source code expectations

---

## Files Modified
1. `/Volumes/RAID/PycharmProjects/MountWizzard4/tests/unit_tests/unitTestAddOns/baseTestApp.py`
   - Added missing `gameControllerIsRunning` signal

2. `/Volumes/RAID/PycharmProjects/MountWizzard4/tests/unit_tests/gui/extWindows/setting/test_settingW.py`
   - Removed assertions for non-existent tabs

3. `/Volumes/RAID/PycharmProjects/MountWizzard4/tests/unit_tests/gui/extWindows/setting/test_tabSettGui.py`
   - Added `soundSatStartTracking` QComboBox to fixture
   - Updated `test_initConfig_with_defaults` to test valid attributes
   - Updated `test_storeConfig_saves_all_values` to test valid attributes

---

## Verification Commands
```bash
# Run all three test files
python -m pytest tests/unit_tests/gui/extWindows/setting/ -v

# Check Ruff formatting
python -m ruff check tests/unit_tests/
```

All tests pass successfully! ✅ 🎉
