mworion/MountWizzard4/tests/testData/mpc_comet_test.txt

    CJ71E010  1971 04  8.4027  1.261019  1.000557  152.2158  103.2844  110.5572  20201010   9.0  4.0  C/1971 E1 (Toba)                                          83,   64
    CJ72E010  1972 03 19.2791  0.961492  0.997901  258.5328  161.4653  124.1129  20201010   9.0  4.0  C/1972 E1 (Bradfield)                                    MPC  4601
    CJ72F010  1970 12 26.3603  3.359649  0.996044  128.9354   24.7360  175.6179  20201010   9.0  4.0  C/1972 F1 (Gehrels)                                       83,   64
    CJ72L010  1972 12 18.7167  4.229730  1.003255   56.4877  225.5180   79.5142  20201010   9.0  4.0  C/1972 L1 (Sandage)                                       83,   64
    CJ72U010  1973 01 31.4826  2.091435  0.999874  334.2303   43.4826  141.7866  20201010   9.0  4.0  C/1972 U1 (Kojima)                                        83,   64
    CJ72X010  1972 12 12.6180  4.830404  0.998199  266.9350  314.3401  112.7567  20201010   9.0  4.0  C/1972 X1 (Araya)                                         83,   64
    CJ73A010  1972 10 27.9749  2.518392  0.999573  346.5138  176.2246  138.2805  20201010   9.0  4.0  C/1973 A1 (Heck-Sause)                                    83,   64
    CJ73D010  1973 06 13.2229  1.321048  0.997267   73.6772  164.0036  121.5380  20201010   9.0  4.0  C/1973 D1 (Kohoutek)                                      83,   64
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
    CK18N010  2018 08  1.9195  1.309330  0.996194  354.6079  292.4428  159.4451  20201010  15.5  4.0  C/2018 N1 (NEOWISE)                                      MPC112393
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
