mworion/MountWizzard4/tests/testData/forecast.png

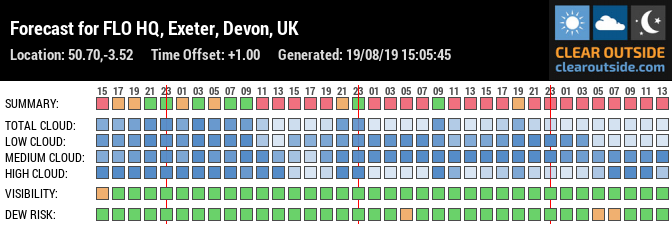
tests/testData/forecast.png
