mworion/MountWizzard4/tests/work/config/terrain.jpg

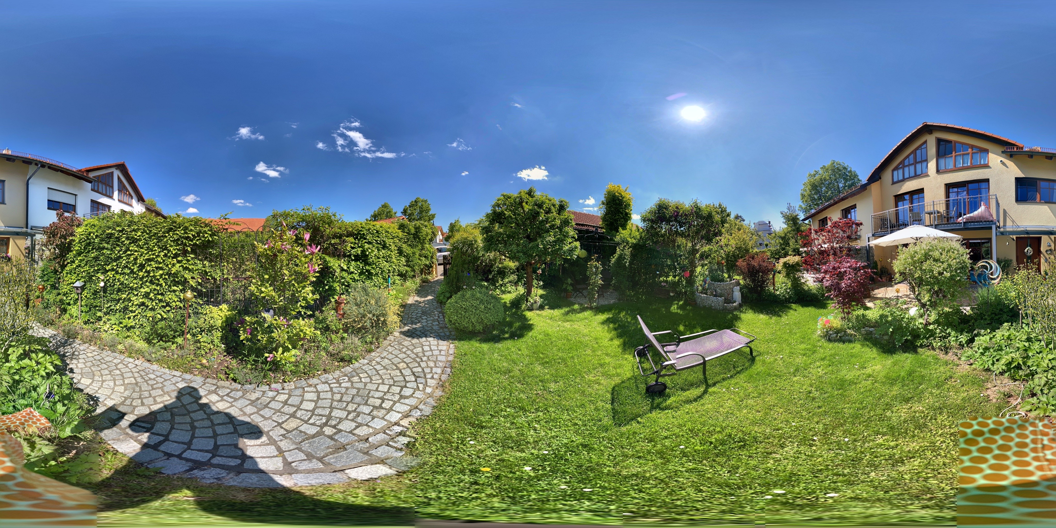
tests/work/config/terrain.jpg
