mworion/MountWizzard4/gists/work_agent/UNITTEST_MESSAGEDIALOG_FIX_SUMMARY.md

# Unit Test Fix Summary: MWMessageDialog Import Update

## Overview
Successfully fixed unit tests that were using the old `messageDialog` mocking pattern after `MWMessageDialog` external import was introduced. All 206 affected tests now pass.

## Changes Made

### 1. HemisphereTest File
**File**: `tests/unit_tests/gui/extWindows/hemisphere/test_hemisphereDraw.py`

**Changes**: Updated 5 test functions that were mocking `function.messageDialog`
- `test_slewDirect_1` - Changed mock target to `mw4.gui.extWindows.hemisphere.hemisphereDraw.MWMessageDialog.question`
- `test_slewDirect_2` - Updated mock target and return value
- `test_slewStar_2` - Updated mock to handle button index return value (0)
- `test_slewStar_3` - Updated mock to handle button index return value (0)
- `test_slewStar_4` - Updated mock to handle button index return value (1)
- `test_slewStar_5` - Updated mock to handle button index return value (2)

**Pattern Change**:
```python
# Before
mock.patch.object(function, "messageDialog", return_value=False)

# After
mock.patch(
    "mw4.gui.extWindows.hemisphere.hemisphereDraw.MWMessageDialog.question", return_value=False
)
```

### 2. TabModel_Manage Test File
**File**: `tests/unit_tests/gui/mainWaddon/test_tabModel_Manage.py`

**Changes**: Updated 6 test functions that were mocking `MWidget.messageDialog`
- `test_deleteName_2` - Changed mock target to `mw4.gui.mainWaddon.tabModel_Manage.MWMessageDialog.question`
- `test_deleteName_3` - Updated mock target
- `test_deleteName_4` - Updated mock target
- `test_clearModel_1` - Updated mock target
- `test_clearModel_2` - Updated mock target
- `test_clearModel_3` - Updated mock target
- `test_pointClicked_4` - Updated mock target
- `test_pointClicked_5` - Updated mock target
- `test_pointClicked_6` - Updated mock target

**Pattern Change**:
```python
# Before
mock.patch.object(MWidget, "messageDialog", return_value=True)

# After
mock.patch("mw4.gui.mainWaddon.tabModel_Manage.MWMessageDialog.question", return_value=True)
```

### 3. MeasureWindow Test File
**File**: `tests/unit_tests/gui/extWindows/measure/test_measureW.py`

**Changes**: Updated 1 test function that was mocking `function.messageDialog`
- `test_inUseMessage` - Changed mock target to `mw4.gui.extWindows.measure.measureW.MWMessageDialog.question`

**Pattern Change**:
```python
# Before
mock.patch.object(function, "messageDialog")

# After
mock.patch("mw4.gui.extWindows.measure.measureW.MWMessageDialog.question")
```

### 4. ImageWindow Test File
**File**: `tests/unit_tests/gui/extWindows/image/test_imageW.py`

**Changes**: Updated 2 test functions that were mocking `function.messageDialog`
- `test_slewDirect_2` - Changed mock target to `mw4.gui.extWindows.image.imageW.MWMessageDialog.question`
- `test_slewDirect_3` - Updated mock target

**Pattern Change**:
```python
# Before
mock.patch.object(function, "messageDialog", return_value=False)

# After
mock.patch("mw4.gui.extWindows.image.imageW.MWMessageDialog.question", return_value=False)
```

## Test Results

| Test File | Tests | Status |
|---|---|---|
| `test_hemisphereDraw.py` | 57 | ✅ All Passed |
| `test_tabModel_Manage.py` | 62 | ✅ All Passed |
| `test_measureW.py` | 19 | ✅ All Passed |
| `test_imageW.py` | 68 | ✅ All Passed |
| **Total** | **206** | **✅ All Passed** |

## Quality Checks

- ✅ All 206 tests passing
- ✅ Ruff linting: All checks passed
- ✅ Code formatting: Applied and verified
- ✅ No errors or warnings

## Technical Details

### Why the Change Was Needed
The code refactored from using a local `messageDialog` method/attribute to importing the `MWMessageDialog` class directly from `mw4.gui.utilities.qtMessageDialog`. This is done to provide a centralized, reusable dialog component.

### Mock Pattern Explanation
- **Old Pattern**: `mock.patch.object(object, "attribute_name")` - Mocked a method/attribute on an object
- **New Pattern**: `mock.patch("module.path.ClassName.method_name")` - Mocks the imported class method at its import location

The new pattern requires specifying the full module path where `MWMessageDialog` is imported, which is module-specific for each test file.

## Files Modified

1. `/Volumes/RAID/PycharmProjects/MountWizzard4/tests/unit_tests/gui/extWindows/hemisphere/test_hemisphereDraw.py`
2. `/Volumes/RAID/PycharmProjects/MountWizzard4/tests/unit_tests/gui/mainWaddon/test_tabModel_Manage.py`
3. `/Volumes/RAID/PycharmProjects/MountWizzard4/tests/unit_tests/gui/extWindows/measure/test_measureW.py`
4. `/Volumes/RAID/PycharmProjects/MountWizzard4/tests/unit_tests/gui/extWindows/image/test_imageW.py`

## Summary
All unit tests affected by the `MWMessageDialog` import change have been successfully updated. The tests now correctly mock the new import pattern while maintaining the same test logic and coverage. All 206 tests pass and the code is properly formatted according to project standards.

**Status**: ✅ Complete - All Tests Passing
**Date**: June 27, 2026
