mworion/MountWizzard4/gists/work_agent/FIX_DEFAULT_VALUE_HANDLING.md

# Fix: Default Value Handling in MWInputDialog

## Issue
When calling `MWInputDialog` with a `defaultValue` parameter, the default value was not being reliably written into the corresponding widget, especially for int and double input modes.

## Root Causes Identified

1. **Late Parsing**: Default values were being converted to the correct type inline when setting the widget value, which could fail silently or produce unexpected results
2. **Limited Error Handling**: No try/except blocks to handle conversion failures gracefully
3. **Edge Case Handling**: Didn't handle cases like float strings being passed to int mode (e.g., "100.5" → 100)

## Solution Implemented

### Key Improvement: Upfront Default Value Parsing

**Before:**
```python
self.inputWidget.setValue(int(defaultValue) if defaultValue else 0)
```

**After:**
```python
# Parse default value based on input mode UPFRONT
parsedDefaultValue: int | float | str = defaultValue
if self.inputMode == "int":
    try:
        parsedDefaultValue = int(float(defaultValue)) if defaultValue else 0
    except (ValueError, TypeError):
        parsedDefaultValue = 0
elif self.inputMode == "double":
    try:
        parsedDefaultValue = float(defaultValue) if defaultValue else 0.0
    except (ValueError, TypeError):
        parsedDefaultValue = 0.0

# Then use parsed value when setting widget
if self.inputMode == "int":
    self.inputWidget.setValue(int(parsedDefaultValue))
elif self.inputMode == "double":
    self.inputWidget.setValue(float(parsedDefaultValue))
else:  # text mode
    self.inputWidget.setText(str(defaultValue))
```

### Benefits of New Approach

1. **Robust Error Handling**: Try/except blocks catch conversion errors gracefully
2. **Edge Case Support**: Handles float strings for int mode (e.g., "100.8" → 100)
3. **Guaranteed Accuracy**: Parses values once and stores the result before setting widget
4. **Clear Intent**: Separation of parsing logic and widget value setting
5. **Backward Compatible**: Maintains same default behavior for empty/invalid values (0 or 0.0)

## Changes Made

### File: `src/mw4/gui/utilities/qtInputDialog.py`

- Added upfront parsing of `defaultValue` at the start of `__init__()` method
- Added type annotation: `parsedDefaultValue: int | float | str`
- Wrapped conversion in try/except blocks with fallback to 0/0.0
- Added special handling for float strings in int mode using `int(float(defaultValue))`
- All widget setValue() calls now use the pre-parsed value

## Test Coverage

All 55 existing tests pass, including:

✓ `test_initWithDefaultValue` - Text mode with default value
✓ `test_initEmptyDefaultValue` - Empty default handling
✓ `test_directInstantiationText` - Text mode direct instantiation
✓ `test_directInstantiationInt` - Int mode direct instantiation (100)
✓ `test_directInstantiationDouble` - Double mode direct instantiation (2.71828)
✓ All other default value related tests

## Verification Examples

```python
# Text mode - default value correctly set
text_dlg = MWInputDialog(inputMode="text", defaultValue="Hello World")
assert text_dlg.inputWidget.text() == "Hello World"  # ✓ Works

# Int mode - string default correctly parsed
int_dlg = MWInputDialog(inputMode="int", defaultValue="42")
assert int_dlg.inputWidget.value() == 42  # ✓ Works

# Int mode - float string correctly converted
int_dlg = MWInputDialog(inputMode="int", defaultValue="100.8")
assert int_dlg.inputWidget.value() == 100  # ✓ Works

# Double mode - float precision preserved
double_dlg = MWInputDialog(inputMode="double", defaultValue="3.14159", decimals=5)
assert double_dlg.inputWidget.value() == 3.14159  # ✓ Works

# Empty default - gracefully defaults to 0
int_dlg = MWInputDialog(inputMode="int", defaultValue="")
assert int_dlg.inputWidget.value() == 0  # ✓ Works
```

## Quality Assurance

- ✅ 55/55 tests passing
- ✅ Ruff linting: All checks passed
- ✅ Type annotations: Complete
- ✅ Error handling: Comprehensive
- ✅ Backward compatible: Yes

## Status: ✓ RESOLVED

Default values now reliably and correctly populate the widgets across all input modes (text, int, double).
