mworion/MountWizzard4/(threads)

Thread 5 (2020-01-16):

MW4 device settings do not switch to Alapaca when selected to do so.

ACMBakx, 2020-01-16:
I installed MW4 on my in-house laptop as per recommended procedure.
Only ASI1600 camera to connect physically.
Installation went without a problem.
MW4 starts up and runs update too.
In sett/config - devices I can select the dome driver only to switch to alpaca.
Other devices only show disabled and indi. No alpaca. Not even after selecting alpaca in the setup.
Camera is connected ok, because SGP and CCDCile can make contact and asco- rest shows green buttons.
Image downloads are really slowthrough alapaca by the way.
From 1-2 sec to 15-18 sec with ASI1600 and ASI071

Unless I can connect through alpaca I cannot do a test of MW4.

Just installed MW4 on my dome computer.
Same result.
All equipment is up and running, but MW4 sees only the dome as a Alpaca device.

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

[mw4-2020-01-16.log](https://github.com/mworion/MountWizzard4/files/4071799/mw4-2020-01-16.log)

rgds
Arie

mworion, 2020-01-17:
Hi Arie,

good to hear that installing went OK. I have to look into, what’s happening. As I said the first test I try to get the dome working, because we than could check if the geometry calculations are going well. I check and write later.

Michel

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

mworion, 2020-01-21:
Other devices still in 0.146b5 are not finished beside dome. So this will take some more time to implement. I currently doing implementation on the camera side as it is the next step for modeling.

Michel

Closed 2020-01-21.

Thread 6 (2020-01-18):

Tried to install MW4 on MacBook

ACMBakx, 2020-01-18:
I have an old MacBookPro (mid 2009) with OSX 10.11.6 on it.
To try to take a sneak peek at MW4 I wanted to install it on my Mac.
That's all INDI, so should not be a problem. I used the cloudmasters.eu suite years ago.
Installed Pyhon 3.7.1. (for OSX 10.9 and later) and ran the MW4 install script.
After installation ran run script and get a error message that some module is written for OSX 10.12 and later. So this was a unsuccessful attempt. My MBP is to old for this . . . . . maybe I am too?
 :-)
Just to let you know.

ACMBakx, 2020-01-18:
Last login: Sat Jan 18 14:28:25 on ttys000
MacBook-Pro-van-Arie:~ arie$ /Users/arie/Desktop/MAC_Scripts/MW4_Run.command ; exit;
Traceback (most recent call last):
  File "./venv/lib/python3.7/site-packages/mw4/loader.py", line 35, in <module>
    import PyQt5.QtCore
ImportError: dlopen(/Users/arie/Desktop/MAC_Scripts/venv/lib/python3.7/site-packages/PyQt5/QtCore.so, 2): Symbol not found: __os_activity_create
  Referenced from: /Users/arie/Desktop/MAC_Scripts/venv/lib/python3.7/site-packages/PyQt5/Qt/lib/QtCore.framework/Versions/5/QtCore (which was built for Mac OS X 10.12)
  Expected in: /usr/lib/libSystem.B.dylib
 in /Users/arie/Desktop/MAC_Scripts/venv/lib/python3.7/site-packages/PyQt5/Qt/lib/QtCore.framework/Versions/5/QtCore
logout
Saving session...
...copying shared history...
...saving history...truncating history files...
...completed.

[Proces voltooid]

mworion, 2020-01-18:
Hi Arie,

oh that’s a good point I have to add to the documentation. Some of the frameworks need 10.12 or later. I can’t do anything about this.

I uploaded a new version, where dome slew should work. Still the Alpaca part for camera is not finished. The download time look not that good as you state. Hopefully they get it improved soon (at least I read about it)

If you have a chance to test the dome (therefore you only need to setup the dome driver), you open the hemisphere window and double click in the chart. This is a traget point for slewing. if you accept, MW4 will slew dome and mount there. If you enabled the geometry correcting in setting / dome tab, it should be ok. Any deviations, please let me know.

Michel

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

ACMBakx, 2020-01-18:
Michel.

I shall test it a.s.a.p. in my dome and give you feedback.

Arie

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

ACMBakx, 2020-01-19:
What I see is that MW4 now takes the easy route by slaving the dome-driver to the mount. You can tell by the RED letters "Scope Sync ON" in the dome driver window. This is what I do currently when using MW3. But I have to set some 30s settling time for the mount, to allow the dome to catch up at high azimuth. Low azimuth is not so much a problem.

[1st testrunMW4&scopedome.zip](https://github.com/mworion/MountWizzard4/files/4082965/1st.testrunMW4.scopedome.zip)

Like that the calculations are done by the dome driver. Which is not a problem of course all beit that you need to get confirmation from the dome that it really has finished its slew before taking an image again. You  notice that the dome sometimes slews in 2 steps. At high alt the dome is turning sometimes in the opposite direction to line up the slot. These slews take a long time. When the mount does a flip to cross the meridian, the dome tries to chase it and goes often in the wrong direction. All this can be prevented like SGP does it, First send the dome to the required azimuth and then send the mount to follow. This means that MW has to do the calculation. This is not happening at the moment,
In MW4 I still cannot alter the geometry settings. They are in blue but I cannot change them.

Hope this helps for a first step.

mworion, 2020-01-21:
Hi Arie,

thanks for the video, it helped a lot. Please update to 0.146b5 (you have to enable beta releases in updater by checking the box). There should be no slaving. I just send two slew commands: one for the mount, one for the dome and MW will wait for both to end. MW4 will know in advance on which pier side the mount will be and calculates the correction for dome azimuth (hopefully correctly). How both devices reach their targeted position, MW4 does not care.

With 0.146b5 you should be also able to change the settings.

Michel

ACMBakx, 2020-01-21:
Michel,

I run the update script and do not see a button for beta releases

Arie

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

ACMBakx, 2020-01-21:
Found te button, but the INSTALL button remains black.
Actual version        0.145
Available version  [e connections a]  ??  I can not edit this line.
Should there be a path set to your repository?

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

mworion, 2020-01-21:
Arie, there might be a misunderstanding. I meant the update inside MW4, attached a picture showing that:
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
Michel

ACMBakx, 2020-01-22:
Hi,
I found this button. Available version is empty (fragment of text). Button INSTALL is dark.
I click the Beta button. Nothing happens. Still no version available.
Save&Quit MW.
Run update script.
Run run script.
Not updated.
Arie

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

mworion, 2020-01-22:
OK strange. Last question: Is the checkbox online above the installer checked as well ? If no, please check it, than the button should be available. Otherwise please post a log file for further investigations.
Michel

ACMBakx, 2020-01-22:
MW keeps on presenting surprises for me!
Found the button. Shows now version 0.146b to be available.
See attached.
Press button INSTALL. It lights up bright blue, but nothing happens still.
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
[mw4-2020-01-22.log](https://github.com/mworion/MountWizzard4/files/4099005/mw4-2020-01-22.log)
Ran update.bat a few times while MW was running and not running.

Arie

mworion, 2020-01-22:
Arie,
thanks for the log it makes things easier to debug. Has nothing to do with MW4. First for some reason the package manager found older version on the internet. I don't know why. I uploaded just for the sake of being consistent a new version 0.146 plain (which should be usable from the internal updater as well from the manual part (which btw does not install betas). I checked it and at least in my test environment i could make this update.
You could enable the message window (Button Message) on main window to follow the update process when doing it internally. There might be the rare situation that the first try end with an error, but you see that and just a second chance will do it.
It the log I see an error when accessing the work directory. That's not good. MW4 should install without admin rights and running as well without it. For some reason some directories are not accessible. Could you check permissions or did you do some part of the installation as admin ?
Michel

ACMBakx, 2020-01-23:
Update was ok this time. I set the dome and mount dimensions as I usually do.
Watch the video. The slews of both mount and dome run nicely simultanios, but the calculations are slightly off. Here you have some homework to do, :-)
[bandicam 2020-01-23 14-54-34-488.zip](https://github.com/mworion/MountWizzard4/files/4103437/bandicam.2020-01-23.14-54-34-488.zip)
[Uploading mw4-2020-01-23.log…]()

mworion, 2020-01-25:
Hi Arie,

thanks for testing and the feedback. the video helps. unfortunately the log file is not readable, but this does not matter,

Some things changed:

I definitly had a bug in calculation the GEM Offset as I store the specific mount geometry and just calculate the resulting value. My guess is, that you measured (as in other programs) the distance GEM point (cross point ra/dec) to center of OTA (0.26m). As I intended to make life easier, I though measuring just the OTA radius and getting the rest for free was not a good idea. My fault was to add the GM2000 distance GEM point to OTA plate, which lead to a bigger number in your case. This cause a major error.
-> I went back to the traditional GEM - OTA distance and dusted the image and texts as well. So it should be like all other programs now.

I wonder the 0.85m for you dome radius. I looked for small domes myself, never found it. Is this number right= ScopeDomes I’ve seen start from 1m radius. Why I am asking: With the big scope in a small dome, the correction reacts very sensitive on these numbers.

Another question: the offset north, east, vertical are measured from the center of your base pate of the mount where it is attached to the pier.

When I reviewed many use cases I’ve seen, that some users have domes, where the radius changes over height. Do you have such a setup as well ?

In any case I made all the correction and fixes to v0.147.1. I added some logging for geometry a well. So whenever you have the time and mood to test again, please update, set logging to deep debug. Im case of problems, please post log and the video (which really helped a lot)

Michel

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

ACMBakx, 2020-01-25:
Michel,

I think you nailed it!

Just ran a quick test. No logs no video's.
Impressive accuracy and behavior.
Also near and at the zenith.

Maybe it would be nice that as soon as the mount is un-parked the sync function would start.
It now starts at the first slew to a point.
Same as when you park the mount again. But maybe other users may not like this.

I tried to fool MW4 by manually positioning the dome in a wrong position. But he recovers very well from that.
I had to increase the dome radius to 1 m. Now the accuracy is even better.
SGP and the Scopedomedriver work best with 85cm. Don't ask me why.
I usually have to play a bit with the GEM numbers to get the best fit.

My dome is indeed tight. Only 2m in (outer)diameter.
With the Esprit100 it offers enough space, but with my 10"lacerta newton it is very tight.
The telescope is very close to the roof (and shutter motor).

I will produce a proper (deep)log and video at a later stage.
But for now I congratulate with the result.

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

mworion, 2020-01-25:
Arie,

thanks for the quick testing. To explain: I don't have a sync function implemented. I only slew the dome when i issue a slew command when explicit slewing the mount or during modeling process.

I would assume that you have a sync anyway when using SGPro.

And to be honest: when I issue the slew commands, I know where the mount will go before really starting the slewing of mount and dome. If SGPro or another software will issue a mount slew command I cannot step in and sync.

The radius should be the real one. Hopefully just measuring the distances and putting them in should result automatically in the optimal sync. I've seen some different implementations of how to calculate the deviations, some of them might be simpler, but approximations. I did it the hard way using plain straight forward 3d transformations for each element. So from mathematics it should be ok. Intension was to be able to show up a virtual 3d model of the mount geometry like it is done in APCC.

As soon as we are sure that we fixed this problem, watched the video and checked the logs, I will close the issue.

Michel

ACMBakx, 2020-01-26:
[MW4Test 2020-01-26 15-02-48-277.zip](https://github.com/mworion/MountWizzard4/files/4113588/MW4Test.2020-01-26.15-02-48-277.zip)
[MW4Test-2020-01-26.log](https://github.com/mworion/MountWizzard4/files/4113589/MW4Test-2020-01-26.log)

As promised the log and a video.
Dome setting: Radius set at 100cm and GEM hight at 12cm. Gem offset at 24cm The rest at zero.
These work best for my situation.
Tried to connect the camera as well. All green, but imaging hangs. Also with Simulator camera selected.
Hoped to run a small model. A failed image and failed solve would hopefully be ignored and skipped..
But MW stops after the 1st slew and waits indefenitely. Solve time-out was set at 30s.
I am sure you are working on this. Or I am overlooking a setting (as usual)

Arie

mworion, 2020-01-26:
Hi Arie,

thanks for continuously test with patience :-)
The camera could not work at all. Still working on it, but will take some time as I have right now limited time due to my job.
What I have seen in the video, at that i would like to understand, that I loose connection to dome (at least the button gets red from time to time. That's not good. I will do another release to get some more logging -> 0.147.3

Michel

ACMBakx, 2020-01-26:
Yep, everytime when the dome finishes the slew, it disconnects. Then it quickly reconnects to ascom rest.

If you could find a way to connect the camera and manage to transfer the image data quickly, you have a winner. MW is becoming more versatile than just a model builder.

Would it be very difficult to put the dome slewing into mw3. That would satisfy a lot of ascom users. But I guess that is not a priority right now.
Kay has presented you with a lot of homework already.

Glad to help.
Arie

Verstuurd vanaf mijn iPad

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

mworion, 2020-01-26:
OK, that's strange. As I only could check it with the dome simulator I don't see this behavior. What I did in 0.147.3 is to extend the timeout to 5 sec. But anyway, next time with the changed logging I should clear it up. As long as I don't have to first device on Alpaca up and running without problems, I will do the next one. If you don't mind post the log of the alpaca server as well.
Camera I should be able to manage, the speed is related to the actual transfer, but I've read that the would like to improve this situation, too.
Michel

ACMBakx, 2020-01-27:
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
I think I solved the issue with the disconnecting dome.
I recalled a reference made to ACP. I tried MaximDL a while ago and had dome connecting issues. Then I found out that I needed to set a certain tick in the Scopedome driver. (see attached)
With that set, there was no issue wit the dome anymore.
Up till today I had this option unselected. MaximDL is removed from my computer.
I started a testrun with the option unchecked and as expected the dome disconnected everytime after a slew. I stopped, changed the setting in the Scopedomedriver and restarted the testrun. As by magic the problem had disappeared.
It appears there is more happening under the hood of the Scopedomedriver than just setting aasynchronous model. What it is exactly you will have to ask the developer Jacek Palek at info@scopedome.com
Arie

mworion, 2020-02-04:
Close it right now. When having the camera working, starting a new issue, if upcoming or reopen if issues with the dome happen.

mworion, 2020-02-09:
Arie,

v0.148.2 should be able to connect to the ascom camera and do a picture. It's not ready, but you could check download speed. Please also update to the latest ASCOM ALPACA server (which has also some updates).

Hope you're equipment is save because of the thunderstorm coming soon.

Michel

Closed 2020-02-04.

Thread 8 (2020-01-25):

Some minor issues in MountWizzard4 GUI

kaythriemer, 2020-01-25:
Hi Michel,

first of all a big compliment for MountWizzard4.
During todays test I found some minor issues in the GUI.

* If I go to "Model Points" and open the "Hemisphere" Window I have the issue, that every mouse click on a up or down arrow (e.g. Points) results in two steps.
E.g. I want to increase the golden spiral from 50 to 75 point and I press once on the up arrow, it will be decreased  to 75 and than to 100.
If the Hemisphere Window is closed. The behaviour is as expected.

* The Polar Diagram in Hemisphere Window is not shown if I activate this option.

* Sometimes an empty tooltip box appears, e.g. if you move the mouse over the "Mount", "Environ",... Tabs or every "white" text in the Mount area, e.g. "HA", "RA",... "Local Sidereal Time",...

* there are also some wrong "mouse over" message texts. E.g. if you move your mouse to "WakeOnLan" to "ON"/"OFF" the wrong text is shown. There are many others, if you want I can summarize the findings.

* Mount-> Parking/Emergency stop -> "Mount Park" Button : wrong text, I think, it should be "Switches the parking state on and off..."

Thank you.
Take care.

Kay

mworion, 2020-01-25:
Hi Kay,

thanks for the kind feedback. To your issues:

> If I go to "Model Points" and open the "Hemisphere" Window I have the issue, that every mouse click on a up or down arrow (e.g. Points) results in two steps.
E.g. I want to increase the golden spiral from 50 to 75 point and I press once on the up arrow, it will be decreased to 75 and than to 100.
If the Hemisphere Window is closed. The behaviour is as expected.

Never saw that, because I'm on MAC. There it's not the case, but I could reproduce it like you explained on Ubuntu. Have to check why.

> The Polar Diagram in Hemisphere Window is not shown if I activate this option.

True. I removed it temporarily. I did some performance optimization for drawing (cpu usage went down from 70% to 8%), but it is complicated tweaking of matplotlib. Having two diagrams with moving points at the same time caused to much troubles. I'll recap that later on, but i should remove the entry.

> Sometimes an empty tooltip box appears, e.g. if you move the mouse over the "Mount", "Environ",... Tabs or every "white" text in the Mount area, e.g. "HA", "RA",... "Local Sidereal Time",...

Issue of the framework. You have the mouse over a widget (which is the case for showing up a tooltip), but it is empty. I have to find out how I could address this.

> there are also some wrong "mouse over" message texts. E.g. if you move your mouse to "WakeOnLan" to "ON"/"OFF" the wrong text is shown. There are many others, if you want I can summarize the findings.

That would be great to let me know. It's always a bunch of work and I miss often changes on this side.

Michel

kaythriemer, 2020-01-25:
Hi Michel,
here my summary.

Following tooltips are probably not correct.

* Mount
 -> "Parking/Emergency stop"
  --> "Mount Park" (Switches the parking state on and **off** ...)

 -> "Status and settings from mount computer"
 --> "DeltaT expires" typo in text
 --> "WakeOnLan" wrong text
 --> "Connection is" wrong text

* Environ
 -> Moon phase
  --> xx % -> typo in text

* Model Points
-> Generate model points as grid
 --> AltMin wrong text
 --> AltMax wrong text

-> Generate model points equally distributed
 --> Points wrong text
 --> green tick is missing on "Generate Golden Spiral"

-> Generate model points from tracks
 --> TimeShift wrong text

-> Auto sort points
 --> No Sorting wrong text

* Model Build
-> Alignment info from mount computer
 --> Stars  wrong text
 --> PosAngle  wrong text
 --> Altitude Pointing  wrong text
 --> Azimuth Pointing wrong text

* Manage Model
 -> Optimize actual model
 --> Show error values in polar plot: wrong text

* Satellite
 -> Satellite data file
  --> "drop down list" typo  in text  (shoufl --> should)

 -> TLE satellite data calculation
  --> unfortunately all fields containing the same text

* Sett./Conf.
 -> Imaging
 --> Actual parameters
  ---> Resolution shows "Configuration of settings"
  ---> FOV shows "Configuration of settings"

-> Mount /WeatherAPI
 ---> OpenWeatherMap API Key shows "Configuration of settings"
 ---> Computer on rig -> MAC Address shows "Configuration of settings"

-> Dome / Cover
 --> all values showing "Configuration of settings"

-> ParkPositions
  ---> all values showing default texts

-> Misc/Audio
--> Internet online connection
--->  online and update data files if necessary : wrong text

--> Update
---> Actual Version showing "Configuration of settings"
---> Available Version showing "Configuration of settings"
---> Release/Beta/Alpha  wrong text

--> Firmware data
  ---> all values showing "Configuration of settings"

--> Logging
---> Info/Debug/Deep Debug  wrong text

--> Play audio signals
 ---> Modeling finished wrong text
 ---> Image save wrong text
 ---> image solved wrong text

I understand, that keeping the tooltips up to date is a huge work and it is not funny.

Kay

mworion, 2020-01-25:
Kay,

no worries. If you fall over some more, please report back. Beside you first topic (double steps when increasing the number of points), other parts should be fixed in 0.147.2

Michel

kaythriemer, 2020-01-26:
Hi Michel,
thanks for the very fast deployment of version 0.147.2 .
I have already updated and will collect other findings.

Kay

One thing I found this morning: the tooltip for the Keypad has the same text as Satellite.
It is very pleasant, that the empty tooltip boxes are not occurring anymore.

mworion, 2020-01-26:
Kay,

> If I go to "Model Points" and open the "Hemisphere" Window I have the issue, that every mouse click on a up or down arrow (e.g. Points) results in two steps.
E.g. I want to increase the golden spiral from 50 to 75 point and I press once on the up arrow, it will be decreased to 75 and than to 100.
If the Hemisphere Window is closed. The behaviour is as expected.

with 0.147.6 the issue about double up when pressing should be solved. I don't see it anymore on ubuntu. If you could verify, please close the issue and open new ones if necessary.
Michel

kaythriemer, 2020-01-26:
Hi Michel,
now it works with version 0.147.6 also in Ubuntu, one klick on an up/down arrow decreases/increases the value one step.

Thank you for your support.
Kay

Closed 2020-01-26.

Thread 11 (2020-02-02):

Generate model points as grid - not generating points

kaythriemer, 2020-02-02:
Hi Michel,
actually I am faced with another issue during my tests of MW4. Sorry.

When I try to "Generate model points as grid" and press Generate grid no model points will be created/shown in Hemisphere view.
The other generate model methods (e.g. Golden Spiral) are working.
I am using MW4 v0.148.0 on Ubuntu 18.04.

Kay.

mworion, 2020-02-02:
Kay,

need a log for that. On my Ubuntu 18.04 system I get the points in hemisphere window.

Michel

kaythriemer, 2020-02-02:
Hi Michel,
please find attached the log.
I started MW4 and wait until mount and camera was connected . At 2020-02-02 21:14:00 I pressed the Generate button.
Unfortunately I don't see anything in the log. I activated deep debug
[mw4-2020-02-02.log](https://github.com/mworion/MountWizzard4/files/4145237/mw4-2020-02-02.log)

Thank you.
Kay

mworion, 2020-02-02:
Kay,

don't see anything either. Is it repeatable for you ? Please check if the limits set in Grid fit to the horizon limits set in the mount (they should be within the range). Otherwise MW4 removes them, because the mount won't slew to them.

Michel

kaythriemer, 2020-02-03:
Michel,
yes it is repeatable. It always does not create any model points, when I use "Generate model points as grid". In previous versions it was working.
 Also horizon limit in the mount is set to 0°.
If I use all the other methods , e.g. Golden Spiral, it generates the model points as expected.
Can I do any other debugging ?
Kay

mworion, 2020-02-03:
I think I will do a special build for testing that. Otherwise it will take too long.

kaythriemer, 2020-02-04:
Michel,
a short video,

just to show that other methods generating points and "Generate model points as grid" not.
[MW4.zip](https://github.com/mworion/MountWizzard4/files/4151459/MW4.zip)
Kay

mworion, 2020-02-04:
Video explained a lot. Problem is that you need equal numbers in columns. I put that constraint in the gut, but for some reason you have an unequal number in there. I have to fix it to avoid this situation. If you set an equal number in cols it should work.

Michel

kaythriemer, 2020-02-04:
Hi Michel,
thank you for your support. I will check this.
Kay.

kaythriemer, 2020-02-04:
Yes, using even number for columns solves this issue.
Thank you.
Kay

Closed 2020-02-04.

Thread 13 (2020-02-09):

Camera connection through Alpaca

ACMBakx, 2020-02-09:
Installed version 0.148.2 (internal update did not work, used update.bat instead)
[mw4-2020-02-09.log](https://github.com/mworion/MountWizzard4/files/4177278/mw4-2020-02-09.log)
Managed to connect everything (ignore weatherdevice) through Alpaca.
All green.
Opened image window and pressed Expose.
Image taken? But no download of it . . . . .

Checked in SGP. Alpaca connects camera ok. Download time is a lot shorter now.
8 seconds from a ASI071.

mworion, 2020-02-09:
Might be a problem on my side: You ASI071 is a color cam right? I transfer the image just to a simple array. This works flawless with the Simulator. I try to get another camera attached. But with the log out of now I learned that I used a property which is not supported by the ASI driver. I have to find out another one to do the same, but which is standard.

mworion, 2020-02-09:
Did a version 0.148.3 with a revised property. Hope this goes further. But still for the performance: I tried to implement fast download (but I do not know if the ASI supports it) and I don't know about the download speed via network. I tested it from a virtual machine (but the same computer) and my QSI690 size (3388x2712) takes about 5 seconds for download via network and 2 for the download from camera itself.

ACMBakx, 2020-02-09:
[mw4-2020-02-09.log](https://github.com/mworion/MountWizzard4/files/4177649/mw4-2020-02-09.log)
As of 20:47hrs
Still no image downoad in the image window.
ASI071 is indeed a OSC camera,
Shall I try with a ASI1600Mono camera? Tomorrow?.
I have a Atik16200 mono CCD too.

mworion, 2020-02-09:
OK one step further, did v0.148.4. Please try it with your ASC camera.

ACMBakx, 2020-02-10:
Worse. Image not even taken now.
[mw4-2020-02-10.log](https://github.com/mworion/MountWizzard4/files/4180154/mw4-2020-02-10.log)

mworion, 2020-04-15:
Hi,

please give 0.150.3 a try. Alpaca for camera and dome should work in a beta. I had it run for a full model in simulation mode (as I don't have ans ASCOM equipment running).

I close this point. In case of any problems, please reopen it.

Michel

mworion, 2020-04-18:
Hi Arie,

uploaded 0.150.5. Alpaca should be full functioning. Closing this point. If you find any new issues, please open a dedicated on.

Michel

ACMBakx, 2020-04-19:
I get everything connected now.
The camera even takes a picture.
But the image doesn’t look right when taking a single image.
Need further investigating.

Arie

Verstuurd vanaf mijn iPad

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

Closed 2020-04-18.

Thread 14 (2020-02-10):

Model build doesn't start

fenriques, 2020-02-10:
hi Michel,
tonight I tried to build a model with the new version 0.148.4, the telescope slews to the first point (labeled with '0'), engage tracking but doesn't image.
I then tested if camera was connected :  I used the 'image' tab and tried to capture 1s photo and solve it. Everything went fine.
I also tried different point generation algorithm and number of points but got the same results.
Attached the deep log.
Ferrante
[mw4-2020-02-10.log.zip](https://github.com/mworion/MountWizzard4/files/4182997/mw4-2020-02-10.log.zip)

mworion, 2020-02-12:
Hi Ferrante,

out of the log I don't see why. I will upload a new version 0.148.5 with more logging to it. If you only had 1 or two points on the hemisphere window, your were able to start modeling, but that was wrong, the mount needs at least 3 points and I kill the modeling process too late. This is corrected.
Never seen that before.

Michel

fenriques, 2020-02-12:
hi Michel,
ok I will update and try again. unfortunately not this evening because the weather is not good at the observatory location.

ferrante

fenriques, 2020-02-13:
hi Michel,
updated version and tried again but the model building doesn't work yet. It slews to first point, then doesn't start imaging.
Everything else is working fine: expose and solve from 'image' tab are giving the expected result.
Attached the log.
Hope you can find what I'm doing wrong.
ferrante
[mw4-2020-02-13.log.zip](https://github.com/mworion/MountWizzard4/files/4201240/mw4-2020-02-13.log.zip)

mworion, 2020-02-16:
Ferrante:
question: Do you use a dome? For me it seem's that MW4 wait for the dome to finish slew before starting the first image. As you are using a Talon, that's a Roll-On Roll-Off roof ? If so, please disable the dome driver as it only makes a following for the dome slit to be able to image.
Michel

fenriques, 2020-02-16:
hi Michel,
yes, I'm using the Talon 6 Roll on Roof. And you're right it was preventing imagining to start.
In the older version (MW3) I was not using it but configuring the the new one I activated it.
Thanks again for helping.

Btw I saw that in the new version you added a lot of features and MW is getting better and better. It's really a great software.

Closed 2020-02-16.

Thread 20 (2020-04-15):

Random crashes when leaving MW4 alone during image

Raddock, 2020-04-15:
Not sure what's causing this, but here's the latest log if it shows something. During an image session, while MW4 is regularly updating environmental data, it randomly crashes. Not sure what's causing this, as usually I'm away from the computer and notice it's crashed when I come back.

[mw4-2020-04-14.log.zip](https://github.com/mworion/MountWizzard4/files/4479083/mw4-2020-04-14.log.zip)

mworion, 2020-04-15:
Hi Andrew,

from the log I see:
- MW4 started 2 times
- In both cases MW4 was closed with save/quit
- I do not see in the log a broken sequence.
- I do see a reconnect error to the camera -> tried a fix with 0.150.1
- I see one connection error on the physical side (IP connection) which say's the the host closed the connection (means the Indi server).

I try to keep MW4 now open for many hours with an ASI178 connected, we'll see.

Michel

Raddock, 2020-04-15:
Strange, these crashes happen about once or twice a night. But having said that, I managed to run all night after the above crash and there were no more crashes. However I did see a message in the log about not being able to get data from the camera, but then it continued showing captured images. Anyhow, I thought I would attach another log so you could see the message. It would be towards the end of the log. Thanks for all your help Michel.

[mw4-2020-04-14.log 2.zip](https://github.com/mworion/MountWizzard4/files/4481190/mw4-2020-04-14.log.2.zip)

Raddock, 2020-04-15:
So, it's strange on my end. I have all the equipment wired right now. But my iMac Pro which I run KStars and MW4 on has both ethernet and WIFI. They connect simultaneously. I don't know how the computer determines which connections to go over WIFI or ethernet, but when I run a program like LAN scan, it shows some connections over WIFI and some over ethernet. I might just turn off WIFI on the computer and see if I can have everything going through ethernet.

mworion, 2020-04-15:
I have a Mac Pro and as soon as I go via LAN I disable the WiFi. Never had good results letting the Mac deciding what to do.

Raddock, 2020-04-19:
I ran over LAN during the last session. I think this was 0.150.2. It was a perfect run with no issues or disconnects. I didn't see any devices disconnect in the status window. I'll have another clear night next week and will try the latest version. I have not seen another crash, and woke up in the morning to MW4 still running. So I'll close this issue.

Closed 2020-04-19.

Thread 21 (2020-04-22):

MW4 - Virtual KeyPad does not connect

mhambuch, 2020-04-22:
Hi, i have installed MW4 on a W10 environment with Alpaca. The App works fine with the only exception of the virtual keypad that keeps trying to connect. The IP is correct 10.0.0.197 but it uses port 8000 and i dont know where this comes from. The virtual keypad is not defined as device in MW4 nor in on the ASCOM remote server.

Get this error in MW4

 js: WebSocket connection to 'ws://10.0.0.197:8000/' failed: Error in connection establishment: net::ERR_CONNECTION_REFUSED

This is the original 10Micron virtual keypad config

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

mworion, 2020-04-22:
Marc,

Two points: You have to enable web services in your physical or the 10micron virtual keypad (under settings / network). A good test ist to use a Webbrowser and enter the ip of your mount in the address selector. If you see the keypad, then your are done.

I discovered the situation even still it is enabled if you have the physical handed connected (I have a GM1000), you don’t get connection on the browser (and the MW4) side.

Michel

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

mhambuch, 2020-04-22:
Hi Michel, that was it, thx. I have another question, other subject, on the mount tab there is a field "DeltaT expires", in my case framed in red as expired since 24.11.2019. I dont understand this, i have a gps (MGbox V2) connected physically to the mount control box. From the Mgbox i get gps, time, refraction data (according to my understanding...) So what does this expiration mean and what should i do ? Under local data on the keypad i have "use gps data" set to on, "boot gps syn" also set to On and GPS_UTC diff shows 18s

mworion, 2020-04-22:
Hi Marc,

DeltaT has nothing to do with actual time. It’s a table which contains a list of DeltaT’s for UTC to TAI time, but more important earth rotation data. This alters over time and will be calculated and offered for download from different source. With the 10micron updater you could program it to the mount. This has to be done about once a year. It’s not critical if you are overtime, but astronomical calculations in the mount become larger errors over time.

BTW: if you still have MW3 installed, the is an automation routine build in to update this values. I cannot do this va commands, so MW3 calls the 10micron updater for you and does all the stuff.

Michel

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

mhambuch, 2020-04-23:
Many thanks for the explanations

Closed 2020-04-23.

Thread 22 (2020-04-24):

Plate Solving ASCAP

mhambuch, 2020-04-24:
Hi Michel, I could test MW4 last night, very good!

I have one issue with plate solving that systematically fails.

Here what I see. This has been done this morning; image window; open FITS from last night and click on solve. I see a little pop up screen for less than one second and then get the error message back. CCD and mount are not connected, i guess this is fine.

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

Within ASCAP it always defaults the Field Height Image Field with 0,48degrees. That then fails as the correct value is 0,95. When  I change in ASCAP to 0,95 and start the solving in ASCAP it works. When i set it to auto and leave ASCAP, go to MW4 load the FITS and ask to solve i have the error message.

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

mhambuch, 2020-04-24:
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

mhambuch, 2020-04-24:
wrong button... closed the issue while editing it ....

mhambuch, 2020-04-24:
If you need the FITS i can provide it I didnt find a way to attach it it only allow image files

mhambuch, 2020-04-24:
pixel size is 2,4 and i was binning 2x2

mworion, 2020-04-24:
FITS file would be good. If FITS does not work, just ZIP it and try it again. Will have a look this evening.

Michel

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

mhambuch, 2020-04-24:
Hi Michel, here is the fits, thanks a lot

[2020-04-23-19-53-23-exposure.zip](https://github.com/mworion/MountWizzard4/files/4528412/2020-04-23-19-53-23-exposure.zip)

mworion, 2020-04-24:
Thanks Marc,

found the issue. I missed the binning parameter in size calculation. The solving used the wrong scale hint -> no solution. You have to make a new image to test it.

Michel

mhambuch, 2020-04-24:
Thanks Michael,

Just for my understanding, i now run the mw4 update script to get the latest version with the bug fix or do you publish new releases  regularly with several improvements/bux fixes?

Envoyé de mon iPad

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

mworion, 2020-04-24:
Marc,

within MW4 under settings/misc there is an internal updater. If you enable the online connection (just above in case you did not already do it) there should be the hint in Message window that there is a new version available. Just press install, wait for finish you could watch it in the message window and restart MW4. Then it's done. Normally you don't need the scripts for updating, it's just for fallback.

Michel

mworion, 2020-04-25:
Marc please use 0.150.8 as there might be another issue introduce with the changes.

mhambuch, 2020-04-25:
Thanks for having notified
-------- Message d'origine --------De : Michael <notifications@github.com> Date : 25/04/2020  12:28  (GMT+01:00) À : mworion/MountWizzard4 <MountWizzard4@noreply.github.com> Cc : mhambuch <mhambuch@laposte.net>, State change <state_change@noreply.github.com> Objet : Re: [mworion/MountWizzard4] Plate Solving ASCAP (#22)
Marc please use 0.150.8 as there might be another issue introduce with the changes.

—You are receiving this because you modified the open/close state.Reply to this email directly, view it on GitHub, or unsubscribe.
[
{
"@context": "http://schema.org",
"@type": "EmailMessage",
"potentialAction": {
"@type": "ViewAction",
"target": "https://github.com/mworion/MountWizzard4/issues/22#issuecomment-619357289",
"url": "https://github.com/mworion/MountWizzard4/issues/22#issuecomment-619357289",
"name": "View Issue"
},
"description": "View this Issue on GitHub",
"publisher": {
"@type": "Organization",
"name": "GitHub",
"url": "https://github.com"
}
}
]

Closed 2020-04-24.

Thread 23 (2020-04-24):

Image Binning bug on Mac

Raddock, 2020-04-24:
Michel I've come across a new bug introduced in the version between 0.1.5. and the current. I have always had my camera set to bin 3x3 since the files are so large, 50 megapixel in size. Their large size takes about 9 seconds to download over my LAN network, and longer to MW4 for some reason. This makes it prohibitive to use 1x1 binning with my camera.

So today, I updated to the latest version, and started a model, I noticed my screens were not getting plate solved. The images also looked very small in the image window. Also, after a good polar align, the images that were plate solving had as much as 800 error in pointing. It turns out that binning is not working properly. With the binning set to anything different from 1x1 the images get cropped to a small size, not binned. So at 1x1 you see the full image, at 2x2 you see less of the full image, and so on to 4x4 where there is so little image left, that platesolvign no longer works.

I've attached screenshots of my MW4 settings, the log, and some of the images that were captured during the model making showing sizes for Bin 1x1, 2x2, and 3x3 so you can see the difference. I did not reposition the telescope during this time, so the 3 images are the same field, and you can see what was happening when they got cropped, and not properly binned.

I have to use dropbox for the images because the fits are too large.
https://www.dropbox.com/s/46w2l6tpmbc6xdp/MW4%20Binning%20Bug.zip?dl=0
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

[mw4-2020-04-23.log](https://github.com/mworion/MountWizzard4/files/4531749/mw4-2020-04-23.log)

mworion, 2020-04-25:
Found the issue. I worked on the Alpaca side. For unknown reasons INDI and ALPACA drivers behave different when calculation the Frame when binning is more than 1. So correction should be in 0.150.8.
Sorry about this regression.

Raddock, 2020-04-27:
Thanks, this appears to be fixed now.

Closed 2020-04-27.

Thread 24 (2020-04-27):

Large amount of error when plate solving

Raddock, 2020-04-27:
Tonight I put on my 102mm refractor. And despite the issue with the binning that was fixed, I'm still seeing a large amount of error with each plate solve. This log should show when running a 32 point model that most points have large amounts of error. Polar align was pretty good. I ran the optimize model after it completed as Model RMS was around 800-900. Optimizing the model deleted almost all the points except for 8, and now the model RMS says 4.3 with polar align error 1.31 arc min. Any suggestions to why this might be? My refractor sits very close to the saddle compared to my larger scopes, would this have anything to do with it?

[mw4-2020-04-26.log.zip](https://github.com/mworion/MountWizzard4/files/4537333/mw4-2020-04-26.log.zip)

mworion, 2020-04-27:
Could you post the model file as well ? It's under the directory /model in the work folder. Thank I'm able to program the same model to my mount and can compare....

Raddock, 2020-04-27:
Thanks for taking a look. Here's the model file, along with the points I used to create it, and a new log, because I woke up this morning and it was crashed.

[Archive.zip](https://github.com/mworion/MountWizzard4/files/4539375/Archive.zip)

mworion, 2020-04-27:
Andrew,
the crash I can't review. The log without any hints stopped at some point in time. If you have seen something on the terminal, that would be good. Anyway I go the long way doing automated stress tests hopefully next weekend to find something which I could fix.

I could load the model. The only thing I've seen was a focal length set to 100mm ? Which might be a very wide field. But anyway this might only lead in not solved, but this did not happen. The deviations are very high. I've never seen this on this broad distribution with my 570mm focal length.

My thoughts about this: there is too much distortion (although you might have a flat field on the ccd), which is not corrected and this is not correctly solved (because distorted). If so you might try another solver (ASTAP) for another test. If you keep the images, we could check this later on either with astrometry.net online or a windows toll called PinPoint (which does some type of distortion correction before solving. Checking this. If I know something I let you know.

Michel

Raddock, 2020-04-27:
I only have this image left over from that session. I must have deleted the other images, because my drive was filling up with them. I do have a flat field corrector installed on this scope. Focal length should have been 571.2mm. A .8x reduction from 714mm focal length. The attached image was a bin 3 image. I'll have another clear night in two days and I'll try again.

[2020-04-27-02-02-02-exposure.fits.zip](https://github.com/mworion/MountWizzard4/files/4541592/2020-04-27-02-02-02-exposure.fits.zip)

mworion, 2020-04-28:
Hi Andrew,

interestingly I tested your image with 3 different solvers:
1: ASTAP
2: KStars - Astrometry.net
3: Cloudmakers - Astrometry.net
4. nova.astrometry.net Online - Astrometry.net

where 1, 2, 4
[Archiv.zip](https://github.com/mworion/MountWizzard4/files/4547812/Archiv.zip)
 show similar results (with small errors) and 3 is different with high errors. I attach the WCS files from 2 + 3 for you. Some parts are identical, some very different. This explains your problem. My recommendation: move to ASTAP or KStars as I use them, ASTAP on a regular bases and I had noch problems.

I posted this to cloudmakers for check as well. We'll see what's the outcome.

Michel

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

Raddock, 2020-04-28:
Interesting. So the solve that provided the largest error was Cloudmakers? I thought I had it set to KStars. Maybe somehow I switched this, as I never got errors like this before. I'll try switching it back to KStars or ASTAP. I find ASTAP doesn't always work unless there's a lot of stars. Longer exposures are sometimes required. But good to know anyway. Hope there's some solution from Cloudmakers.

mworion, 2020-04-29:
Andrew,

in the log there was Cloudmakers set. Peter from cloudmakers response was that he has no final clue why this happens.

Michel

Raddock, 2020-04-29:
Ok, thanks for looking into it. I'll consider this solved, and use KStars or ASTAP from now on.

Closed 2020-04-29.

Thread 25 (2020-05-03):

Add INDIGO Support

rumengb, 2020-05-03:
Please add INDIGO support:
http://www.indigo-astronomy.org
If you need any information and help please let us know.

mworion, 2020-05-04:
Hi rumengb,

Would be happy to switch from INDI to INDIGO as INDIGO is backward compatible to INDI. I need a  python only implementation for an INDIGO client. If there is one available, please let me know.

Michel

polakovic, 2020-05-07:
Pls. check this: https://github.com/taxelrod/indigo_cffi

mworion, 2020-05-22:
Hi Peter,
already seen. But this is a python wrapper around the C++ implementation. Is this available on all platforms as binary wheel? In my case all should be installable with pip without having the need of starting a compiler (as it seldom succeeds on the users base). In INDI it is not the case as I did a pure python implementation of INDI. And that's not a good point doing that for many frameworks.
Any ideas about this ?
Michel

Ruediger3, 2020-05-22:
I would also deeply appreciate native INDIGO support, since I am running:

-Unihedron SQM
-Pegasus UPBv2
-MGPBox

via INDIGO

mworion, 2020-05-22:
Rüdiger,

Indigo normally should be backwards compatible with Indi in a degradation mode. So normally you should see the devices.

Michel

rumengb, 2020-05-22:
Hi the trouble is that INDI has no standard properties for AUX devices and
basically every paricular auxiliary device has its own set of properties.
On the other hand we have standard properties for all classes of auxiliary
devices: Powerboxes, general purpose input output devices devices etc in
Indigo. On the other hand INDI changes the standard property set so we can
not maintain the property mapping even for more standard devices like Domes
for example. In other words nowadays compatibility is maintained on
protocol level but not on property and device level. Which means that
devices may not be seen if they are not classified as we classify them
 (interface item of the info property), and may not have the same
properties at all. The good news is that you can use your INDI code
unchanged to communicate with INDIGO, but only relay on different
properties for those devices...

Rumen

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

polakovic, 2020-05-22:
Hi Michel, the main difference between INDI and INDIGO is, that while an INDI the driver is always a separate process talking to the client side with a quite ineffective XML protocol over pipes or sockets, INDIGO driver is a dynamic library loaded into the server (or client) process, connected to a software bus and called at procedure execution speed. Pipe or network protocol is implemented by protocol adapter connected to the same bus. This gives INDIGO a performance gain (about 1000x faster than INDI) and also higher flexibility (multiple network protocols, etc).

So if you want to use FULL INDIGO, you need full bus implementation and I doubt it is possible to do in python effectively. That's why INDIGO_CFFI is just python wrapper over native C code. Full binary packages are available for 32/64 bit Intel/ARM Linux and for macOS. Client part of the library (no drivers) is also available for Windows. If it is sufficient, you probably can bundle it with a python code and that's it.

If you want just talk to remote INDIGO server, you may use some protocol client implementation. We have one in JavaScript (a part of webGUI) and one in C# (a part of ASCOM bridge), both talking JSON protocol. It is quite straightforward, you can find source code here:

https://github.com/indigo-astronomy/indigo/blob/master/indigo_server/resource/indigo.js (single server access)

https://github.com/indigo-astronomy/indigo_ascom/blob/master/indigo/Indigo.cs (multiple server access with bonjour discovery)

Unfortunately, we don't have such code in python, because nobody from our team develops in python. But you may use also any INDI client, including that python one. INDIGO server will detect it and fall back to XML protocol v1.7 used by INDI. Nevertheless, the performance is degraded, specifically for BLOB transfer. If you know how to modify the code to speak XML protocol v2.0, it will improve performance (with 2.0 protocol only the URL is transferred instead of BLOB in BASE64 encoding and pulled by client when needed over http).

You can find protocols description here:

https://github.com/indigo-astronomy/indigo/blob/master/indigo_docs/PROTOCOLS.md

Another level of complexity is semantics of the properties as Rumen mentioned. But if you want to write your own python, it is not an issue.

Peter

mworion, 2020-05-22:
Thanks, this helps in understanding. Adding the support in my python Indi implementation still keeps the problem of different properties. So that has to be addressed anyway. But as result as a single person doing this beside work means another framework (not from protocol, but for each device the properties) to be maintained. This effort will kill me. No clue how to dress this. Somebody has to maintain the device properties on both sides in a table if they are not the same.

Michel

rumengb, 2020-05-22:
Well,
The thing is that INDIGO properties are not changing unlike INDI. We do not
change properties. So maintaining INDIGO set will not be a problem. We were
trying to maintain INDI - INDIGO mapping in the framework for some time
until it became impossible.  INDI properties are changing not only
semantically, which is easily addressed, but some of them mutated to a
different types (for example from number to switch) or changed the purpose
of their items. So we had to invent complex mapping algorithms to maintain
this and we gave up this effort. Bu the way this was one of the reasons
INDIGO exists, INDI is maintained together with its fronted Ekos/Kstars and
newer versions with Ekos can not work with older INDI and vice versa. Not
speaking about third party products, and the results are in Pixinsight
dumped INDI in favor of indigo. APT uses INDIGO not INDI. And several
prominent professional observatories are using or migrating to INDIGO. So
maintaining INDIGO will not be a big deal.

you say: "Somebody has to maintain the device properties on both sides in a
table if they are not the same." it is not that easy. in the beginning we
did so until INDI changed the type some standard properties and the meaning
of their fields. Recently I got a report about INDIGO controlled domes not
working with the new Ekos any more (but tey used to work) and I figured out
that the dome interface was changed and properties can not be mapped at
all. The property set changed. Which was addressed in Ekos immediately and
made this change transparent to INDI/Ekos users but causing problems to the
third party clients. And sure enough Ekos dome control stopped working with
the older indi server.
This is what we are trying to avoid in INDIGO. And this is why we can not
maintain such a table :(

Rumen

Ruediger3, 2020-05-23:
Hello All,

I have tried to connect Unihedron SQM, UPBv2 and MGPBox to MW4 via INDIGO, but I can state there are serious problems and it is not working.
My findings:
1. Device can not be reconnected. You have to disconnect device in INDIGO in order to make it available in MW4 again after it was disabled.
2. SQM shows no data
3. UPBv2 shows no data

Conclusion: Either it is not compatible, or there are some issues to fix in MW4 side.

Thank you all!

Cheers
Ruediger

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

mworion, 2020-07-18:
Hi Rumen,

I would like to support INDIGO (at least in translating Properties) for important devices. I recognized for example, that the INDIGO Server show some strange DRIVER_INFO.DRIVER_INTERFACEnumbers. The PowerBox shows in my case 4489216 I would expect the interface for Switch / Observing conditions or at least AUX. INDIGO server does it for CCD for example right.

Same to SQM Unihedron driver.

Where is the trick ? Thanks in advance.

Michel

rumengb, 2020-07-18:
Hi Michel,
and thank you!

4489216 is a decimal bit mask of the interfaces (device types), for AUX
devices AUX bit is set and a bitmask of the particular features they have.
So in this case 4489216 = INDIGO_INTERFACE_AUX_POWERBOX |
INDIGO_INTERFACE_AUX_WEATHER,
so this is most likely a Powerbox with temperature and humidity sensor.
On the other hand non AUX devices have only one bit set. So if we have a
CCD camera with st4 guider port, two separate devices will be presented
with interfaces INDIGO_INTERFACE_CCD (decimal 2) and NDIGO_INTERFACE_GUIDER
(decimal 4). See the definitions in indigo_bus.h:

/** Device interface (value should be used for
INFO_DEVICE_INTERFACE_ITEM->text.value)
 */
typedef enum {
INDIGO_INTERFACE_MOUNT     = (1 << 0),   ///< Mount interface
INDIGO_INTERFACE_CCD       = (1 << 1),     ///< CCD interface
INDIGO_INTERFACE_GUIDER    = (1 << 2),     ///< Guider interface
INDIGO_INTERFACE_FOCUSER   = (1 << 3),   ///< Focuser interface
INDIGO_INTERFACE_WHEEL     = (1 << 4),     ///< Filter wheel interface
INDIGO_INTERFACE_DOME      = (1 << 5),     ///< Dome interface
INDIGO_INTERFACE_GPS       = (1 << 6),     ///< GPS interface
INDIGO_INTERFACE_AO        = (1 << 8),     ///< Adaptive Optics Interface
INDIGO_INTERFACE_ROTATOR   = (1 << 12),   ///< Rotator interface
INDIGO_INTERFACE_AGENT     = (1 << 14),   ///< Agent interface
INDIGO_INTERFACE_AUX       = (1 << 15),     ///< Auxiliary interface
INDIGO_INTERFACE_AUX_JOYSTICK  = (1 << 15) | (1 << 16), ///< Joystick AUX
interface
INDIGO_INTERFACE_AUX_SHUTTER   = (1 << 15) | (1 << 17), ///< Shutter AUX
interface
INDIGO_INTERFACE_AUX_POWERBOX  = (1 << 15) | (1 << 18), ///< Powerbox AUX
interface
INDIGO_INTERFACE_AUX_SQM       = (1 << 15) | (1 << 19), ///< SQM AUX
interface
INDIGO_INTERFACE_AUX_DUSTCAP   = (1 << 15) | (1 << 20), ///< Dust Cap AUX
Interface
INDIGO_INTERFACE_AUX_LIGHTBOX  = (1 << 15) | (1 << 21), ///< Light Box AUX
Interface
INDIGO_INTERFACE_AUX_WEATHER   = (1 << 15) | (1 << 22), ///< Weather AUX
interface
INDIGO_INTERFACE_AUX_GPIO      = (1 << 15) | (1 << 23) ///< General purpose
IO AUX interface
} indigo_device_interface;

Some additional confusion may be caused by the type of the
DRIVER_INFO.DRIVER_INTERFACE type which is text. So you have to convert it
to 32bit integer and check individual bits. Well this is something I do not
like but for the sake of INDI compatibility we had to adopt it.

I hope this answers your question :)
If you have any other questions please feel free to ask.

Regards,
Rumen

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

mworion, 2020-07-19:
Hi Rumen,

Pegasus UPB, UPBv2, UniHedron SQR (and Camera..) work now. Just with the pity to translate the Properties. So I never could support all devices.

Closing this so far. Thanks for the support. I'll coma back if I move forward.

Michel

rumengb, 2020-07-20:
What do you mean by translate the properties? you should not support any particular device but a class of devices. depending on the interface.

mworion, 2020-07-21:
Rumen,

I raised the question in INDI to standardize the Properties and Elements addressed. If so does it make some sense to sync it to the INDIGO list as well ? Even though it may be different name for compatibility reasons, but finally a 1:1 list.

Michel

rumengb, 2020-07-21:
Hi Michael,
The problem is that we have been doing this for years. I mean following the
changes in INDI properties and we have a translation table (see
https://github.com/indigo-astronomy/indigo/blob/master/indigo_libs/indigo_version.c).
The trouble is that INDI properties are so mutable not only in semantically
but they change the types and items which made it impossible to follow and
map any more.
By the way this is one of the reasons we started indigo. Peter was one of
the core INDI developers and I was a developer too. We were trying to make
properties immutable but the problem is that nobody was on our side and
this makes it next to impossible to maintain a third party product that
uses INDI. So the truth is that if Jasem needs some property change for
Ekos he changes INDI without any notice and all of the sudden all existing
software stops working. Even Ekos is incompatible with the previous
versions of INDI.  Even more what I see in indi is that they started to
change property names from capital plus underscore notation to camel case
(like SOME_PROPERTY -> SomeProperty).
On the other hand in INDIGO properties are immutable so (SOME_PROPERTY will
always be SOME_PROPERTY and its meaning and existing items will will not
change). In that copying some properties standardized in INDI is not an
option for us. First because we already have some standatized properties
which we can not change, as many products rely on them. Second because
there is no such thing as standard in INDI.  Another problem is that there
are basically no standard properties for auxiliary devices in INDI. Each
driver provides its own set of properties for the same things. This makes
indi incompatible with itself in some areas, most prominent being auxiliary
devices. On the other hand we have a list of Standard indigo properties
here
https://github.com/indigo-astronomy/indigo/blob/master/indigo_libs/indigo/indigo_names.h
, not well documented which is our fault but we have it, we can extend it
but it is too late to change it as several major players on the market
relay on it (Pixinsight, APT, Astro tools from CloudMakers etc) and several
professional observatories that have their own proprietary clients...
So we are open to standardizing some properties, but we are not willing to
change or duplicate the ones that we have, but we can adopt the ones that
we do not have.
Does this make sense?

Rumen

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

rumengb, 2020-07-21:
I was trying to find on indi forum where is the topic about this issue but
I was unable to find it. Can you please provide a link?

On Tue, Jul 21, 2020 at 7:53 PM Rumen Bogdanovski <rumen@skyarchive.org>
wrote:

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

Closed 2020-07-19.

Thread 28 (2020-05-22):

Problem installing update 0.150.16b1

SimonWalsh1000, 2020-05-22:
Hi Michel,

I am having problems using the Updater to get this latest update. I think the issue relates to pip and is presumably related to my environment although I can't be sure. When I installed MW4 all the packages installed correctly and I have updated pip and the setuptools. Please find my logs attached. The salient log is also posted here:

2020-05-21 21:03:18][C][      loader.py][ 285] ----------------------------------------------------
[2020-05-21 21:03:18][C][      loader.py][ 286]
[2020-05-21 21:03:18][C][      loader.py][ 287]  MountWizzard 4.0 started !
[2020-05-21 21:03:18][C][      loader.py][ 288]
[2020-05-21 21:03:18][C][      loader.py][ 289] ----------------------------------------------------
[2020-05-21 21:03:18][C][      loader.py][ 290]  Platform         : Windows
[2020-05-21 21:03:18][C][      loader.py][ 291]  Release          : 10
[2020-05-21 21:03:18][C][      loader.py][ 292]  Machine          : AMD64
[2020-05-21 21:03:18][C][      loader.py][ 293]  Python runtime   : 32bit
[2020-05-21 21:03:18][C][      loader.py][ 294]  CPU              : Intel64 Family 6 Model 158 Stepping 9, GenuineIntel
[2020-05-21 21:03:18][C][      loader.py][ 295]  Python           : 3.8.2
[2020-05-21 21:03:18][C][      loader.py][ 296]  PyQt5            : 5.14.2
[2020-05-21 21:03:18][C][      loader.py][ 297]  Qt               : 5.14.2
[2020-05-21 21:03:18][C][      loader.py][ 298]  Node             : WINDOWS-V63COM5
[2020-05-21 21:03:18][C][      loader.py][ 299]  IP addr.         : WINDOWS-V63COM5
[2020-05-21 21:03:18][C][      loader.py][ 300]  Actual workdir   : C:\Users\slfwa\OneDrive\Desktop\MW4
[2020-05-21 21:03:18][C][      loader.py][ 301]  mountwizzard4    : 0.150.15
[2020-05-21 21:03:18][C][      loader.py][ 302]  indibase         : 0.133
[2020-05-21 21:03:18][C][      loader.py][ 303]  mountcontrol     : 0.163
[2020-05-21 21:03:18][C][      loader.py][ 304]  sys.executable   : C:\Users\slfwa\OneDrive\Desktop\MW4\venv\Scripts\python.exe
[2020-05-21 21:03:18][C][      loader.py][ 305] ----------------------------------------------------
[2020-05-21 21:03:18][C][      loader.py][ 306]
[2020-05-21 21:03:18][I][     obsSite.py][ 205] Loader: expire:[False], dir:[C:\Users\slfwa\OneDrive\Desktop\MW4/data]
[2020-05-21 21:03:19][I][     mainApp.py][ 428] Message window: [Enabled device:      [directWeather]]
[2020-05-21 21:03:19][I][     mainApp.py][ 428] Message window: [Enabled device:      [onlineWeather]]
[2020-05-21 21:03:20][I][     kmRelay.py][  93] Host value not configured
[2020-05-21 21:03:23][I][    geometry.py][ 168] using [10micron GM2000HPS] geometry
[2020-05-21 21:03:24][I][     mainApp.py][ 428] Message window: [Actual satellite is  [STARLINK-1070]]
[2020-05-21 21:03:25][I][     mainApp.py][ 428] Message window: [Align model data refreshed]
[2020-05-21 21:03:25][I][     mainApp.py][ 428] Message window: [Model names refreshed]
[2020-05-21 21:03:25][W][      loader.py][ 189] Click Button  : [loadFrom]
[2020-05-21 21:03:26][W][      loader.py][ 199] Click Object  : [qt_scrollarea_viewport]
[2020-05-21 21:03:26][W][      loader.py][ 199] Click Object  : [QFileDialogWindow]
[2020-05-21 21:03:26][W][      loader.py][ 199] Click Object  : [qt_scrollarea_viewport]
[2020-05-21 21:03:26][W][      loader.py][ 199] Click Object  : [QFileDialogWindow]
[2020-05-21 21:03:27][W][      loader.py][ 189] Click Button  : []
[2020-05-21 21:03:27][W][      loader.py][ 199] Click Object  : [QFileDialogWindow]
[2020-05-21 21:03:27][W][      loader.py][ 189] Click Button  : []
[2020-05-21 21:03:27][W][      loader.py][ 199] Click Object  : [QFileDialogWindow]
[2020-05-21 21:03:28][I][     mainApp.py][ 428] Message window: [Profile: [FSQ] loaded]
[2020-05-21 21:03:29][I][     mainApp.py][ 428] Message window: [Disabled device:     [directWeather]]
[2020-05-21 21:03:29][I][     mainApp.py][ 428] Message window: [Enabled device:      [directWeather]]
[2020-05-21 21:03:29][I][     mainApp.py][ 428] Message window: [Disabled device:     [onlineWeather]]
[2020-05-21 21:03:29][I][     mainApp.py][ 428] Message window: [Enabled device:      [onlineWeather]]
[2020-05-21 21:03:29][I][     kmRelay.py][  93] Host value not configured
[2020-05-21 21:03:29][W][      loader.py][ 189] Click Button  : [loadFrom]
[2020-05-21 21:03:32][W][      loader.py][ 185] Click Tab     : [Misc / Audio]
[2020-05-21 21:03:37][W][      loader.py][ 191] Click Radio   : [versionBeta]:False
[2020-05-21 21:03:38][W][      loader.py][ 189] Click Button  : [getVersion]
[2020-05-21 21:03:40][W][      loader.py][ 189] Click Button  : [openMessageW]
[2020-05-21 21:03:44][W][      loader.py][ 193] Click Group   : [groupBox_59]:False
[2020-05-21 21:03:44][W][      loader.py][ 195] Click Checkbox: [isOnline]:False
[2020-05-21 21:03:45][W][      loader.py][ 191] Click Radio   : [versionRelease]:False
[2020-05-21 21:03:47][W][      loader.py][ 189] Click Button  : [getVersion]
[2020-05-21 21:03:48][W][      loader.py][ 191] Click Radio   : [versionBeta]:False
[2020-05-21 21:03:49][W][      loader.py][ 189] Click Button  : [getVersion]
[2020-05-21 21:03:49][I][     mainApp.py][ 428] Message window: [A new version of MountWizzard is available]
[2020-05-21 21:03:52][W][      loader.py][ 189] Click Button  : [installVersion]
[2020-05-21 21:03:52][I][ tabSettMisc.py][ 230] venv: [True], hasReal:[False], hasBase:[True]
[2020-05-21 21:03:52][I][     mainApp.py][ 428] Message window: [Installing selected version ... please wait]
[2020-05-21 21:03:52][I][ tabSettMisc.py][ 305] pip install took 0.04388093948364258s return code: 1 stderr:
[2020-05-21 21:03:52][I][     mainApp.py][ 428] Message window: [Could not install update installation ]
[2020-05-21 21:04:47][W][      loader.py][ 185] Click Tab     : [Sett. / Conf.]
[2020-05-21 21:05:17][I][     mainApp.py][ 428] Message window: [Disabled device:     [directWeather]]
[2020-05-21 21:05:17][I][     mainApp.py][ 428] Message window: [Disabled device:     [onlineWeather]]
[2020-05-21 21:05:17][I][     mainApp.py][ 428] Message window: [MountWizzard4 manual stopped]

SimonWalsh1000, 2020-05-22:
[mw4-2020-05-21 (2).log](https://github.com/mworion/MountWizzard4/files/4666345/mw4-2020-05-21.2.log)
[install.log](https://github.com/mworion/MountWizzard4/files/4666343/install.log)
[update.log](https://github.com/mworion/MountWizzard4/files/4666344/update.log)

mworion, 2020-05-22:
Hi Simon,

I cannot see an issue right now. I will extend logging, but this helps only in future versions.
If you are using the MW4_Update.bat (Batch script), it does no beta versions. That's intended.

If you feel good with using python, please try to do it manually with:
Open powershell and change to your work directory. start with command:

venv\Scripts\activate

then you should see a prefix in the prompt in the powershell, most likely:

(venv) PS c:\Users....

then update manually with command

pip install mountwizzard4==0.150.16b1

This should do the trick or showing the real error what happens wrong.

Michel

SimonWalsh1000, 2020-05-22:
Hi Michel,

I tried this but the following error arises
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

SimonWalsh1000, 2020-05-22:
Just to add, I see I omitted the "4" from mountwizzard4 - I tried again but got the same error..."The system cannot find the file specified"

SimonWalsh1000, 2020-05-22:
Interestingly, I work with python on my mac laptop and I ran

pip install mountwizzard4==0.150.16b1

and it worked fine. Just isn't working on my pier computer

mworion, 2020-05-22:
Helps a lot.
What I see that you have two different virtual environments which interfere. Normally the venv used in MW4 should be in your work directory. But the upper image tells me that it is loaded elsewhere.

mworion, 2020-05-22:
For whatever reason the command venv/Scripts/activate point to another virtualenv.

mworion, 2020-05-22:
I have seen you are using the OneDrive. Is there anything mapped from on computer to the other one ? What makes me nervous os that the python interpreter is loaded from the Download folder.

SimonWalsh1000, 2020-05-22:
Hi Michel,

I switched off OneDrive

I uninstalled everything and then reinstalled and it works.

I can also connect to my camera. Many thanks!

I am going to give it a test run tonight

mworion, 2020-05-22:
Hi Simon,
sound great. I will finish today a beta 2 which supports dome as well. I don't know if you need dome support on ASCOM.
I close it right now, please reopen if something happens again.
Michel

Closed 2020-05-22.

Thread 30 (2020-05-22):

Satellite Module: float division by zero

Ruediger3, 2020-05-22:
When selecting database and and object a 'Division by Zero' is thrown in cmd window. See screen shots.
Active.txt and visuals.txt get updated and contain valid data. They are also attached.

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
[active.txt](https://github.com/mworion/MountWizzard4/files/4668337/active.txt)
[visual.txt](https://github.com/mworion/MountWizzard4/files/4668338/visual.txt)

mworion, 2020-05-22:
Rüdiger,

I think I found the problem: Your PC is set to German, right ? The library has a problem parsing the TLE strings when not set to English. If you could give it a try, you're welcome, but I wait now for the response of Brandon, who is maintainer of the skyfield package.

Michel

Ruediger3, 2020-05-22:
Hi Michel,
yes, you were right! Switching to US solved it, but this is no persistent solution, since all the other applications do not work anymore :(
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

Ruediger3, 2020-05-22:
Hi Michel,
0.150.17b1 works with German separator.
Thank you!

mworion, 2020-05-22:
I built a 0.150.17b1, which should be able to run with German setting. It would be nice to give it a try.
Michel

mworion, 2020-05-28:
Actually reproducible.

Ruediger3, 2020-05-28:
Are you sure about 17b since we have been already at 20b?
Not visible for installation yet

mworion, 2020-05-28:
Hi Rüdiger,
are you willing to make a counter test now ? if so please go to the non functioning v0.150.20.
Check if it's still broken.
Close MW4.
Open power shell
goto your work directory
go to  virtual environment with command:

venv/Scripts/activate

- prompt should change to heading (venv) ....

install new library with command

pip install https://github.com/brandon-rhodes/python-sgp4/archive/master.zip

close powershell and start MW4 v0.150.20 again. This should do the trick.

Please let me know if you do so.
Michel

Ruediger3, 2020-05-28:
Hi Michel,
I can confirm this works. I had to manually install sgp4.
Do I have to that anytime I install an update?

Thanks Rüdiger

BTW: there is also an issue with the first pass. It is always in the past (red box)

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

mworion, 2020-05-28:
Thanks for testing,
Brandon will release the new library when we sign it off (what we will do now). from That point on I will release 0.150.21. Then it's done.
I've seen the point with the first pass. I played around. I this version I will have a better selection !
Michel

Ruediger3, 2020-05-28:
Thanks Michel for your great support!

Closed 2020-05-28.

Thread 33 (2020-05-23):

MGPBox cannot be connected via INDIGO

Ruediger3, 2020-05-23:
It is not possible to select the MGPBox in "Sensor Weather" (v 0.150.17b1):
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

Ruediger3, 2020-06-07:
Just for information:
MGPBox is officially supported in INDIGO since version 122 from 05.06.2020

mworion, 2020-06-07:
Rüdiger,

Since you are using INDIGO as you main environment, it probably makes more sense to go for the different properties defined I INDOGO. This is valid for SQM and Pegasus Box. As INDIGO Splits Pegasus into different devices (Focuser, Switch etc) we’ll see how it works.

Does this make sense. Is there any change to get an running INDIGO server for testing ?

Michel

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

Ruediger3, 2020-06-07:
Hi Michel,

you are definitely right that INDIGO will be the primary platform to use, but currently some more applications are in massive delay of INDIGO integrating (e.g. APT, NINA). Hence I am running sometimes ASCOM, sometimes INDIGO. Depends on the clients APPs.

To get a an IDIGO Server running is quite trivial. Just download image and copy to a micro SD, plug it into a RPi and INDIGO Server is running. There is almost no configuration necessary, except password of Pi and WLAN access. That's all. :)

Alternatively I can also grant remote INDIGO access to one of the development systems, if this helps.

If I can support you in any way, please let me know. Thanks!

mworion, 2020-07-19:
Rüdiger,

I installed INDIGO Server for MAC, but I don't see a MGBox driver. Where to find ?

Michel

Ruediger3, 2020-07-19:
Hello Michel,
Usally you load the driver via Web-Interface or Control Pannel. See screen shots below.

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

mworion, 2020-07-19:
OK,
I run the server on MAC and there is no Astromi.Ch driver. Nor I have the INDIGO Control Panel as you to pay for it.

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

Ruediger3, 2020-07-19:
Hi Michel,
Which version to you use? I use 122. MGPBox is quite new. I think it was included 120.

Ruediger3, 2020-07-20:
Hello Michel,
I had tried to connect the devices, but it did not work. Neither MGPBox, nor SQM nor UPB was connected.
Please find attached Screenshot and Log file.

Thank you!

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

[mw4-2020-07-20.log](https://github.com/mworion/MountWizzard4/files/4945813/mw4-2020-07-20.log)

mworion, 2020-07-20:
Hi Rüdiger,
the log you sent was during the lifecycle you updated. So this log is from 0.150.28 not 0.150.29b. There should be another one.
Michel

Ruediger3, 2020-07-20:
Hi Michael,
no that was the correct one. I also fond no entries indication any INDIGO activity.

I have re-run the test after I have deleted the log and created one from the scratch. Nothing has changed to my first try but had a crash in between. please find screenshot attached. This happened when disconnecting the non-existent camera and wheel.

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

[mw4-2020-07-20.log](https://github.com/mworion/MountWizzard4/files/4949308/mw4-2020-07-20.log)

mworion, 2020-07-20:
Rüdiger,
checked it, works for UPBv2:

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

mworion, 2020-07-20:
Rüdiger,
the issue with the camera I have seen and already fixed.
Michel

Ruediger3, 2020-07-20:
Just tried to connect UPB, but it does not work.

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

mworion, 2020-07-20:
UniHedron as well works
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

mworion, 2020-07-20:
Problem might be that you connect to a running Indi server ?

INDIGO reports UPBv2 as Ultimate Powerbox and INDI Server as Pegasus UPB

Michel

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

mworion, 2020-07-20:
I upload 0.150.29b2 to avoid the nasty ASCOM failure.

Ruediger3, 2020-07-20:
That is wired. you have first to connect in MW to an unconnected device and then connect it INDIGO server. That is totally strange.
MW shows power, but wrong values, buttons not working. Some throw errors.
MGPBos cannot be connected at all. it is not found. The drop down is empty.

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

mworion, 2020-07-20:
astromi.ch I didn't had a look so far. That's why indigo server on lac does not support it, but only the raspbee server. So I installed this.

Strange UPB v2 works for me (all functions). But I've seen that connection on indigo sky for USB has to be tuned on my side (I don't know which USB device for what physical device.

Could you send a log?

Ruediger3, 2020-07-20:
Here we are:
[mw4-2020-07-20.log](https://github.com/mworion/MountWizzard4/files/4949531/mw4-2020-07-20.log)

mworion, 2020-07-21:
Tested MGBox as well: works. Only point: did test Stickstation: does not work !

mworion, 2020-07-21:
Upload 0.150.29b3 with some more logging on INDIGO side. Please test with that version. Please run a search in any case again.

Michel

Ruediger3, 2020-07-21:
Hi Michel, the update fails due to files in access. Please see screen shot.
Manual update via batch fails also and brings up a warning.

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

Ruediger3, 2020-07-21:
I used the workaround via activate and pip install. Now the version is updated.

mworion, 2020-07-21:
OK strange. I really like windows....

Ruediger3, 2020-07-21:
Hello Michel,
first results:
1. UPB connects properly and also the data is available. Looks much better. When selecting UPB the driver is automtically connected in INDIGO and gets green.
2. SQM gets green in MW4 but does not start the driver. No values are provided.
3. Sensor. MGPBox is found but neither MW4 gets green, nor the driver is started.

Log and snap attached.

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

[mw4-2020-07-21.log](https://github.com/mworion/MountWizzard4/files/4955296/mw4-2020-07-21.log)

Ruediger3, 2020-07-21:
Hi Michel,
got it to work. It is INDIGO server side, not MW. I have to drill down, but the server restarts after connecting. The first issue was, the USB ports were not properly identified in INDIGO, though they were saved in the INDIGO profile 0.
I will get in touch with Rumen.

mworion, 2020-07-21:
Good to hear it works. Invade some struggles with the server as well to get all devices up and running.

Michel

Von meinem iPad gesendet

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

mworion, 2020-07-22:
If you have it tested nicely, please feed back or close the issue.

Thanks for testing.

Michel

Ruediger3, 2020-07-22:
Hi Michel,
Rumen was working a few hours remotely on the system. He found an issue in the MGPBox driver which made the INDIGO server restart.

By that we found some issue in MW. E.g. You cannot reconnect after disconnect or restart. Also UPB does not show any values or data.

I was not able to get it work again. I wanted to retest again in structured way, but it is for sure there are multiple issue.

Rumen is going to join in here or via email, since some changes must be done. I will support with testing and providing remote access to the devices.

rumengb, 2020-07-22:
Michael,
the indigo issue was in SQM driver, it was developed without a hardware access and when connecting to a device that does not respond after the timeout we were using uninitialized buffer... i have fixed it...

However there are some issues in MW4... You have to check if the device is connected and connect only if it is not connected. Otherwise your connect request will be discarded. Many third party indigo clients were facing this problem. This is done because if it is already connected and we reconnect this will reinitialize the device breaking its current state, if we return ALERT on second connect this will make other clients think that the device is inoperable, and if we return connect in change property some clients may initialize their own device initialization. So the safest bet is just to ignore such request. So what you have to do is to check the state of this CONNECT property and if not connected trigger a connect. in this case all device properties will be enumerated and it will work as it is now. if connected then you can either use cached properties in your client or if you do not have them cached to send an enumeration request. this can be done via indigo_enumerate_properties() call or sending a message "
```
<getProperties version='2.0'/>
```

Rumen

mworion, 2020-07-23:
Rumen,

that was the intension. As I keep the connection state and handle all communication evens this should be possible. If not I have an issue and I have to sort it out. Do you see to attempts to connect in logs ?

For aligning the interaction to the INDIGO server:
MW4 establishes for each! device it's own tcp connection.
When MW4 changes drivers it disconnects cuts TCP connection and reconnects from tcp on connection.
If you load a new profile with many drivers configured, this could happen in a short time.

Does this target behaviour harm an INDIGO server ?

Michel

rumengb, 2020-07-23:
Michel
I do not have any logs. Maybe Ruediger can provide them.

Establishing many TCP connections should not be an issue, but this is not how indigo is intended to be used. INDIGO is a bus and all define update or delete property messages will be distributed over each connection and your client will accept same messages many times (once per connection) and will generate a lot of chatter.

The issue described by Ruediger looks like a known issue of some existing clients(APT):
Device.CONNECTION.CONNECT=ON is for all clients, and does not guarantee exclusive access. To have it you need to use INDIGO device access control. Which means that in standard setup this means that This device is attached to the bus and ready
to be used. if connected by APT for example, MW4 can use it too and the last command wins...
However the problem if no data is shown from my experience with third party apps is that they send Device.CONNECTION.CONNECT=ON request manometer if it is connected or not. and they wait for update Device.CONNECTION.CONNECT=ON and Device property enumeration. But if it is already connected this will never happen as this will confuse the already connected clients. In this case there is noting to let you know those properties are defined if you ignored the property enumeration when your client attached to the bus. In this case you can request another enumeration.

Rumen

mworion, 2020-07-23:
Hi, uploaded v0.150.29b5,

I checked it in my environment: I only send CONNECT once. Now before sending CONNECT or DISCONNECT I check if SWTICH status is already set and if so do nothing.

As is ask for properties first, the status in my client show be the one of the server. So If any other client already connected, than I should know about it and act accordingly.

Hope this will solve the issue.

Michel

Ruediger3, 2020-07-24:
Hi Michel, Hi Rumen,

I have done more testing.
It works fine when you start MW and the devices are not connected in INDIGO server. On starting MW they get connected and deliver data. But...
When you close MW and start MW again, the devices keep connected in INDIGO (what is expected) but MW can not read any data or shows green state. If you manually disconnect the devices in INDIGO control panel before starting MW a second time it works as expected and described above.

See snaps attached. Log also.

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

[mw4-2020-07-24.log](https://github.com/mworion/MountWizzard4/files/4973115/mw4-2020-07-24.log)

rumengb, 2020-07-24:
Looks like you are missing the initial property enumeration. When you
attach to the bus you need to request enumeration. please see:
https://github.com/indigo-astronomy/indigo/blob/master/indigo_docs/CLIENT_DEVELOPMENT_BASICS.md
it is intended for C developers but anyway it can give some clues. But it
looks to me that you are missing initial property enumeration.

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

mworion, 2020-07-25:
Hi Rumen, Rüdiger,

attached the communication to INDIGO server (version 2.0-122) with all three device attached. So first start MW4 was without having the devices connected on INDIGO server:

> [2020-07-25 09:57:38.219][C][      loader.py][ 287] ----------------------------------------------------
[2020-07-25 09:57:38.220][C][      loader.py][ 288]
[2020-07-25 09:57:38.220][C][      loader.py][ 289]  MountWizzard 4.0 started !
[2020-07-25 09:57:38.220][C][      loader.py][ 290]
[2020-07-25 09:57:38.220][C][      loader.py][ 291] ----------------------------------------------------
[2020-07-25 09:57:38.220][C][      loader.py][ 292]  Platform         : Darwin
[2020-07-25 09:57:38.220][C][      loader.py][ 293]  Release          : 19.6.0
[2020-07-25 09:57:38.220][C][      loader.py][ 294]  Machine          : x86_64
[2020-07-25 09:57:38.228][C][      loader.py][ 295]  Python runtime   : 64bit
[2020-07-25 09:57:38.228][C][      loader.py][ 296]  CPU              : i386
[2020-07-25 09:57:38.228][C][      loader.py][ 297]  Python           : 3.8.2
[2020-07-25 09:57:38.228][C][      loader.py][ 298]  PyQt5            : 5.14.2
[2020-07-25 09:57:38.228][C][      loader.py][ 299]  Qt               : 5.14.2
[2020-07-25 09:57:38.228][C][      loader.py][ 300]  Node             : Neptun.fritz.box
[2020-07-25 09:57:38.228][C][      loader.py][ 301]  IP addr.         : Neptun.fritz.box
[2020-07-25 09:57:38.228][C][      loader.py][ 302]  Actual workdir   : /Users/mw/PycharmProjects/MountWizzard4
[2020-07-25 09:57:38.229][C][      loader.py][ 303]  mountwizzard4    : 0.150.29b5
[2020-07-25 09:57:38.231][C][      loader.py][ 304]  indibase         : 0.135.1
[2020-07-25 09:57:38.232][C][      loader.py][ 305]  mountcontrol     : 0.171
[2020-07-25 09:57:38.232][C][      loader.py][ 306]  sys.executable   : /Users/mw/PycharmProjects/Envs/mw4/bin/python3.8
[2020-07-25 09:57:38.232][C][      loader.py][ 307] ----------------------------------------------------
[2020-07-25 09:57:38.233][C][      loader.py][ 308]
[2020-07-25 09:57:38.420][I][     obsSite.py][ 209] Loader: expire:[False], dir:[/Users/mw/PycharmProjects/MountWizzard4/data]
[2020-07-25 09:57:38.891][D][  tabEnviron.py][ 386] http://clearoutside.com/forecast_image_medium/48.12/11.58/forecast.png: 200
[2020-07-25 09:57:38.901][I][ tabSettMisc.py][ 185] Package Alpha  : ['0.150.26a1', '0.150.25a6', '0.135a4', '0.135a3', '0.135a1', '0.134a5', '0.134a3', '0.134a2', '0.134a1', '0.131a1']
[2020-07-25 09:57:38.901][I][ tabSettMisc.py][ 186] Package Beta   : ['0.150.29b5', '0.150.29b4', '0.150.29b3', '0.150.29b2', '0.150.29b1', '0.150.27b1', '0.150.26b2', '0.150.26b1', '0.150.25b12', '0.150.25b11']
[2020-07-25 09:57:38.901][I][ tabSettMisc.py][ 187] Package Release: ['0.150.28', '0.150.27', '0.150.26', '0.150.25', '0.150.24', '0.150.23', '0.150.22', '0.150.21', '0.150.20', '0.150.19']
[2020-07-25 09:57:39.034][D][  tabEnviron.py][ 386] http://clearoutside.com/forecast_image_medium/48.12/11.58/forecast.png: 200
[2020-07-25 09:57:39.835][I][     mainApp.py][ 433] Message window: [Enabled device:      [sensorWeather]]
[2020-07-25 09:57:39.840][D][    indiBase.py][ 751] SendCmd: [b'<getProperties version="1.7" device="MGBox Weather" />']
[2020-07-25 09:57:39.840][I][   indiClass.py][ 154] INDI watch: MGBox Weather, watch: result:True
[2020-07-25 09:57:39.929][I][     mainApp.py][ 433] Message window: [Enabled device:      [skymeter]]
[2020-07-25 09:57:39.932][D][    indiBase.py][ 751] SendCmd: [b'<getProperties version="1.7" device="Unihedron SQM" />']
[2020-07-25 09:57:39.932][I][   indiClass.py][ 154] INDI watch: Unihedron SQM, watch: result:True
[2020-07-25 09:57:39.945][I][     mainApp.py][ 433] Message window: [Enabled device:      [power]]
[2020-07-25 09:57:39.947][D][    indiBase.py][ 751] SendCmd: [b'<getProperties version="1.7" device="Ultimate Powerbox" />']
[2020-07-25 09:57:39.947][I][   indiClass.py][ 154] INDI watch: Ultimate Powerbox, watch: result:True
[2020-07-25 09:57:39.961][I][     mainApp.py][ 433] Message window: [Enabled device:      [astrometry]]
[2020-07-25 09:57:39.963][I][astrometryASTAP][ 303] ASTAP OK, app:/Applications/ASTAP.app/Contents/MacOS/astap index:/usr/local/opt/astap/*.290
[2020-07-25 09:57:39.968][I][     mainApp.py][ 433] Message window: [ASTROMETRY found:    [ASTAP]]
[2020-07-25 09:57:40.337][D][    indiBase.py][ 992] INDI XML chunk: defTextVector (AUX_OUTLET_NAMES, MGBox Weather, rw, Ok)   defText (GPIO_OUTLET_NAME_1) 'Switch name' Pulse switch
[2020-07-25 09:57:40.338][I][     mainApp.py][ 433] Message window: [INDI device found:   [MGBox Weather]]
[2020-07-25 09:57:40.338][W][    indiBase.py][ 870] New device [MGBox Weather]
[2020-07-25 09:57:40.338][D][    indiBase.py][ 992] INDI XML chunk: defNumberVector (AUX_DEW_THRESHOLD, MGBox Weather, rw, Ok)   defNumber (AT_SENSOR_1) 'Temperature difference (°C)' 2
[2020-07-25 09:57:40.338][D][    indiBase.py][ 992] INDI XML chunk: defTextVector (DRIVER_INFO, MGBox Weather, ro, Ok)   defText (DRIVER_NAME) 'Device name' MGBox Weather   defText (DRIVER_VERSION) 'Driver version' 2.0.0.1   defText (DRIVER_INTERFACE) 'Interface' 12615680   defText (DEVICE_MODEL) 'Model' MGBoxV2   defText (DEVICE_FIRMWARE_REVISION) 'Firmware Rev.' 1.1
[2020-07-25 09:57:40.338][D][    indiBase.py][ 992] INDI XML chunk: defSwitchVector (CONFIG_PROCESS, MGBox Weather, rw, Ok)   defSwitch (CONFIG_LOAD) 'Load' Off   defSwitch (CONFIG_SAVE) 'Save' Off   defSwitch (REMOVE) 'Remove' Off
[2020-07-25 09:57:40.339][D][    indiBase.py][ 992] INDI XML chunk: defSwitchVector (PROFILE, MGBox Weather, rw, Ok)   defSwitch (PROFILE_0) 'Profile #0' On   defSwitch (PROFILE_1) 'Profile #1' Off   defSwitch (PROFILE_2) 'Profile #2' Off   defSwitch (PROFILE_3) 'Profile #3' Off   defSwitch (PROFILE_4) 'Profile #4' Off
[2020-07-25 09:57:40.339][D][    indiBase.py][ 992] INDI XML chunk: defTextVector (DEVICE_PORT, MGBox Weather, rw, Ok)   defText (PORT) 'Device name or URL' /dev/ttyUSB1
[2020-07-25 09:57:40.339][D][    indiBase.py][ 992] INDI XML chunk: defTextVector (DEVICE_BAUDRATE, MGBox Weather, rw, Ok)   defText (BAUDRATE) 'Baud rate (bps)' 38400
[2020-07-25 09:57:40.339][D][    indiBase.py][ 992] INDI XML chunk: defSwitchVector (DEVICE_PORTS, MGBox Weather, rw, Ok)   defSwitch (REFRESH) 'Refresh' Off   defSwitch (/dev/ttyUPB) '/dev/ttyUPB' Off   defSwitch (/dev/serial1) '/dev/serial1' Off   defSwitch (/dev/ttyUSB2) '/dev/ttyUSB2' Off   defSwitch (/dev/ttyUSB1) '/dev/ttyUSB1' Off   defSwitch (/dev/ttyUSB0) '/dev/ttyUSB0' Off   defSwitch (/dev/ttyAMA0) '/dev/ttyAMA0' Off
[2020-07-25 09:57:40.339][D][    indiBase.py][ 992] INDI XML chunk: defSwitchVector (CONNECTION, MGBox Weather, rw, Ok)   defSwitch (CONNECT) 'Connected' Off   defSwitch (DISCONNECT) 'Disconnected' On
[2020-07-25 09:57:40.345][W][    indiBase.py][ 826] Device [MGBox Weather] disconnected
[2020-07-25 09:57:40.345][W][    indiBase.py][ 469] Device [MGBox Weather] unconnected - connect it now
[2020-07-25 09:57:40.345][D][    indiBase.py][ 751] SendCmd: [b'<newSwitchVector device="MGBox Weather" name="CONNECTION"><oneSwitch name="CONNECT">On</oneSwitch><oneSwitch name="DISCONNECT">Off</oneSwitch></newSwitchVector>']
[2020-07-25 09:57:40.345][D][    indiBase.py][ 992] INDI XML chunk: defTextVector (DRIVER_INFO, Unihedron SQM, ro, Ok)   defText (DRIVER_NAME) 'Device name' Unihedron SQM   defText (DRIVER_VERSION) 'Driver version' 2.0.0.5   defText (DRIVER_INTERFACE) 'Interface' 557056
[2020-07-25 09:57:40.346][W][   indiClass.py][ 181] INDI device snoop: Unihedron SQM
[2020-07-25 09:57:40.346][W][    indiBase.py][ 870] New device [Unihedron SQM]
[2020-07-25 09:57:40.346][D][    indiBase.py][ 992] INDI XML chunk: defSwitchVector (CONFIG_PROCESS, Unihedron SQM, rw, Ok)   defSwitch (CONFIG_LOAD) 'Load' Off   defSwitch (CONFIG_SAVE) 'Save' Off   defSwitch (REMOVE) 'Remove' Off
[2020-07-25 09:57:40.346][D][    indiBase.py][ 992] INDI XML chunk: defSwitchVector (PROFILE, Unihedron SQM, rw, Ok)   defSwitch (PROFILE_0) 'Profile #0' On   defSwitch (PROFILE_1) 'Profile #1' Off   defSwitch (PROFILE_2) 'Profile #2' Off   defSwitch (PROFILE_3) 'Profile #3' Off   defSwitch (PROFILE_4) 'Profile #4' Off
[2020-07-25 09:57:40.346][D][    indiBase.py][ 992] INDI XML chunk: defTextVector (DEVICE_PORT, Unihedron SQM, rw, Ok)   defText (PORT) 'Device name or URL' /dev/ttyUSB0
[2020-07-25 09:57:40.346][D][    indiBase.py][ 992] INDI XML chunk: defSwitchVector (DEVICE_PORTS, Unihedron SQM, rw, Ok)   defSwitch (REFRESH) 'Refresh' Off   defSwitch (/dev/ttyUPB) '/dev/ttyUPB' Off   defSwitch (/dev/serial1) '/dev/serial1' Off   defSwitch (/dev/ttyUSB2) '/dev/ttyUSB2' Off   defSwitch (/dev/ttyUSB1) '/dev/ttyUSB1' Off   defSwitch (/dev/ttyUSB0) '/dev/ttyUSB0' Off   defSwitch (/dev/ttyAMA0) '/dev/ttyAMA0' Off
[2020-07-25 09:57:40.347][D][    indiBase.py][ 992] INDI XML chunk: defSwitchVector (CONNECTION, Unihedron SQM, rw, Ok)   defSwitch (CONNECT) 'Connected' Off   defSwitch (DISCONNECT) 'Disconnected' On
[2020-07-25 09:57:40.352][W][    indiBase.py][ 826] Device [Unihedron SQM] disconnected
[2020-07-25 09:57:40.353][D][    indiBase.py][ 992] INDI XML chunk: defTextVector (X_AUX_OUTLET_NAMES, Ultimate Powerbox, rw, Ok)   defText (USB_PORT_NAME_1) 'Port #1' Port #1   defText (USB_PORT_NAME_2) 'Port #2' Port #2   defText (USB_PORT_NAME_3) 'Port #3' Port #3   defText (USB_PORT_NAME_4) 'Port #4' Port #4   defText (USB_PORT_NAME_5) 'Port #5' Port #5   defText (USB_PORT_NAME_6) 'Port #6' Port #6   defText (POWER_OUTLET_NAME_1) 'Outlet #1' Outlet #1   defText (POWER_OUTLET_NAME_2) 'Outlet #2' Outlet #2   defText (POWER_OUTLET_NAME_3) 'Outlet #3' Outlet #3   defText (POWER_OUTLET_NAME_4) 'Outlet #4' Outlet #4   defText (HEATER_OUTLET_NAME_1) 'Heater #1' Heater #1   defText (HEATER_OUTLET_NAME_2) 'Heater #2' Heater #2   defText (HEATER_OUTLET_NAME_3) 'Heater #3' Heater #3
[2020-07-25 09:57:40.353][W][   indiClass.py][ 181] INDI device snoop: Ultimate Powerbox
[2020-07-25 09:57:40.353][W][    indiBase.py][ 870] New device [Ultimate Powerbox]
[2020-07-25 09:57:40.353][D][    indiBase.py][ 992] INDI XML chunk: defTextVector (DRIVER_INFO, Ultimate Powerbox, ro, Ok)   defText (DRIVER_NAME) 'Device name' Ultimate Powerbox   defText (DRIVER_VERSION) 'Driver version' 2.0.0.15   defText (DRIVER_INTERFACE) 'Interface' 4489216   defText (DEVICE_MODEL) 'Model' Unknown   defText (DEVICE_FIRMWARE_REVISION) 'Firmware Rev.' Unknown
[2020-07-25 09:57:40.353][D][    indiBase.py][ 992] INDI XML chunk: defSwitchVector (CONFIG_PROCESS, Ultimate Powerbox, rw, Ok)   defSwitch (CONFIG_LOAD) 'Load' Off   defSwitch (CONFIG_SAVE) 'Save' Off   defSwitch (REMOVE) 'Remove' Off
[2020-07-25 09:57:40.353][D][    indiBase.py][ 992] INDI XML chunk: defSwitchVector (PROFILE, Ultimate Powerbox, rw, Ok)   defSwitch (PROFILE_0) 'Profile #0' On   defSwitch (PROFILE_1) 'Profile #1' Off   defSwitch (PROFILE_2) 'Profile #2' Off   defSwitch (PROFILE_3) 'Profile #3' Off   defSwitch (PROFILE_4) 'Profile #4' Off
[2020-07-25 09:57:40.353][D][    indiBase.py][ 992] INDI XML chunk: defTextVector (DEVICE_PORT, Ultimate Powerbox, rw, Ok)   defText (PORT) 'Device name or URL' /dev/ttyUSB2
[2020-07-25 09:57:40.354][D][    indiBase.py][ 992] INDI XML chunk: defSwitchVector (DEVICE_PORTS, Ultimate Powerbox, rw, Ok)   defSwitch (REFRESH) 'Refresh' Off   defSwitch (/dev/ttyUPB) '/dev/ttyUPB' Off   defSwitch (/dev/serial1) '/dev/serial1' Off   defSwitch (/dev/ttyUSB2) '/dev/ttyUSB2' Off   defSwitch (/dev/ttyUSB1) '/dev/ttyUSB1' Off   defSwitch (/dev/ttyUSB0) '/dev/ttyUSB0' Off   defSwitch (/dev/ttyAMA0) '/dev/ttyAMA0' Off
[2020-07-25 09:57:40.354][D][    indiBase.py][ 992] INDI XML chunk: defSwitchVector (CONNECTION, Ultimate Powerbox, rw, Ok)   defSwitch (CONNECT) 'Connected' Off   defSwitch (DISCONNECT) 'Disconnected' On
[2020-07-25 09:57:40.359][W][    indiBase.py][ 826] Device [Ultimate Powerbox] disconnected
[2020-07-25 09:57:40.361][D][    indiBase.py][ 992] INDI XML chunk: defTextVector (X_AUX_OUTLET_NAMES, Ultimate Powerbox, rw, Ok)   defText (USB_PORT_NAME_1) 'Port #1' Port #1   defText (USB_PORT_NAME_2) 'Port #2' Port #2   defText (USB_PORT_NAME_3) 'Port #3' Port #3   defText (USB_PORT_NAME_4) 'Port #4' Port #4   defText (USB_PORT_NAME_5) 'Port #5' Port #5   defText (USB_PORT_NAME_6) 'Port #6' Port #6   defText (POWER_OUTLET_NAME_1) 'Outlet #1' Outlet #1   defText (POWER_OUTLET_NAME_2) 'Outlet #2' Outlet #2   defText (POWER_OUTLET_NAME_3) 'Outlet #3' Outlet #3   defText (POWER_OUTLET_NAME_4) 'Outlet #4' Outlet #4   defText (HEATER_OUTLET_NAME_1) 'Heater #1' Heater #1   defText (HEATER_OUTLET_NAME_2) 'Heater #2' Heater #2   defText (HEATER_OUTLET_NAME_3) 'Heater #3' Heater #3
[2020-07-25 09:57:40.361][I][     mainApp.py][ 433] Message window: [INDI device found:   [Ultimate Powerbox]]
[2020-07-25 09:57:40.361][W][    indiBase.py][ 870] New device [Ultimate Powerbox]
[2020-07-25 09:57:40.362][D][    indiBase.py][ 992] INDI XML chunk: defTextVector (DRIVER_INFO, Ultimate Powerbox, ro, Ok)   defText (DRIVER_NAME) 'Device name' Ultimate Powerbox   defText (DRIVER_VERSION) 'Driver version' 2.0.0.15   defText (DRIVER_INTERFACE) 'Interface' 4489216   defText (DEVICE_MODEL) 'Model' Unknown   defText (DEVICE_FIRMWARE_REVISION) 'Firmware Rev.' Unknown
[2020-07-25 09:57:40.362][D][    indiBase.py][ 992] INDI XML chunk: defSwitchVector (CONFIG_PROCESS, Ultimate Powerbox, rw, Ok)   defSwitch (CONFIG_LOAD) 'Load' Off   defSwitch (CONFIG_SAVE) 'Save' Off   defSwitch (REMOVE) 'Remove' Off
[2020-07-25 09:57:40.362][D][    indiBase.py][ 992] INDI XML chunk: defSwitchVector (PROFILE, Ultimate Powerbox, rw, Ok)
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

Thread 40 (2020-05-30):

MW4 stops after 3 images

InFINNity-Deck, 2020-05-30:
Hi Michel,

just tested the latest version. I use a 57 point model, but each time when I start it it stops after 3 images and 4 slews. The image viewer shows image-0002.fits.

I have uploaded the log file, there may be multiple starts in it.

kind regards,
Nicolàs

[mw4-2020-05-30.log](https://github.com/mworion/MountWizzard4/files/4706589/mw4-2020-05-30.log)

InFINNity-Deck, 2020-05-30:
I forgot to close MW4 before sending the log file, here is the complete one:

[mw4-2020-05-30.log](https://github.com/mworion/MountWizzard4/files/4706605/mw4-2020-05-30.log)

mworion, 2020-05-31:
Hi Nicolas,

For some reasons, the dome did not connect. I added robustness feature against unconnected ASCOM devices, but this would not change the fact. I will do a message, that is is a connection missing.

Did you experience that the mount status button in the main window was red ?

Michel

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

InFINNity-Deck, 2020-05-31:
Hi Michel,

I have noticed that at start-up MW4 rarely automatically detects the dome. Most times I have to go to settinges->devices and re-connect by going into the ASCOM set-up and press OK again. With SGP I never lost connection with the dome, so it does work reliable.

There were no red buttons when it stopped. I just ran the model again just now and noticed that it stops because MW4 thinks that the dome is still slewing, see attached screen dump (I also added the log, as you will see the first run it had not found the dome, so I needed to reconnect and restart).

Nicolàs

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
[mw4-2020-05-31.log](https://github.com/mworion/MountWizzard4/files/4707534/mw4-2020-05-31.log)

mworion, 2020-05-31:
Hi Nicolas,

I put a retry for ASCOM connection in for next beta. Now I'm recalling why I didn't want to go back to ASCOM. But anyway ASCOM is back in and I have to deal with it.

But this said, I addressed  the startup. What you are saying, that the ASCOM connection is lost during model run right? I currently see no exception for this. The missing connect at the beginning is in the log.

I put some more logging in, If you don't mind, you could give it a try:
v0.150.25b1

InFINNity-Deck, 2020-05-31:
Hi Michel,

the updater does not find the new version, "Requirement already
satisfied, skipping upgrade: " it says for all items.
Sadly enough there is no native driver for LesveDomeNet...

Nicolàs

Op 31-5-2020 om 16:38 schreef Michael:
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

--
Deze e-mail is gecontroleerd op virussen door AVG.
http://www.avg.com

mworion, 2020-05-31:
Nicolas,
If I upload beta version, the PyPi platform might take longer get it into effect if they have load problems (at least that was my understanding).
Version should be now available.
Michel

InFINNity-Deck, 2020-06-04:
Just an update for visitors: Michel and I have been in contact extensively in the past week by direct e-mail and he has made several huge improvements (thank you for that, Michel!). The ASCOM connection has much improved, a lateral offset has been added for side-by-side set-ups, and MW4 now finishes its runs correctly. Michel and I are now writing and testing an improved version of the underlying maths for the dome-azimuth calculations.

InFINNity-Deck, 2020-06-06:
Hi Michel,

could you please confirm you received my e-mail with the dome-control algorithms?

Nicolàs

mworion, 2020-06-06:
Hi Nicolas,

yes, I received it. I'm currently in the time I have on cleaning up things before moving to the dome issue. Too much open point which I'm closing now. Does it make sense to continue on the dome part in issue #46 ?

I had a quick look into. The routine I did for the dome is straight forward 3D geometry and regular transformations. That's easy. Difficulties are like you said: pier side, signs, references for measurement.

If you feel comfortable with stability, we could close that point. BTW. as tests numbers are increasing I have to optimize it on GitHub actions as the run now for 15 min. And I would like to add full applications test as well. Especially for the usage of ASCOM.

Michel

InFINNity-Deck, 2020-06-06:
Hi Michel,

I think issue #46 is not really an issue, but a nice-to-have implementation.

Implementing the algorithms I provided day before yesterday are of greater importance as they solve the general pointing accuracy of the dome azimuth, especially at low altitudes and correct dome radii. The tests I did using my algorithms always resulted in almost exact dome behaviour (i.e. within the slewing accuracy of the LesveDomeNet controller) and even at sub 1 degree altitude points (that is where the current MW4 algorithm produces erratic azimuths up to 180° in the wrong direction).

I tested my own algorithm by slewing the mount using the Goto Alt/Azi option and slewing the dome using SGP's Dome Goto option (using the dome azimuths calculated by my algorithm).

With MW4 I just did another test with four cardinal points at 1° altitude. MW4 was set-up with correct offsets to the base of the mount (0.01m east, 0.00m north, 0.08m up) and correct radius of the dome (1.50m):

Target Altitude [°] | Target Azimuth [°] | MW4 dome azimuth [°] | dome azimuth according to my algorithm [°]
1 | 0 | 27.40 | 17.12
1 | 90 | 114.20 | 100.92
1 | 180 | 149.70 | 161.50
1 | 270 | 251.80 | 266.46

The MW4 azimuths were taken from the MW4 log file. As you can see slewing errors up to 15 degrees occur. In practise this means that the telescope is pointing at and against the side of the slit (left side for north and east targets, west side for south and west). Only when entering a radius of 3m I get a workable solution, but even then the dome's azimuth is clearly incorrectly calculated.

Although MW-users will hardly ever create models with points this low, they may wish to be able to steer the dome in that direction for other purposes (azimuth verifications, start of satellite tracking, etc). Besides, it looks much better if dome-control is correct. ;-)

I am currently preparing a publication on the algorithms I sent you, will send you a sneak-preview outside this platform once ready (today or tomorrow).

Nicolàs

mworion, 2020-06-06:
Hi Nicolas,

That’s great to her. What I would like to do to compare it with my implementation. This is my next step to learn, where I made some faults.

If you don’t mind, I attached the geometry calc in python (but it’s really good described and it’s mostly vector math. If you see some mistakes, please let me know.

Thanks for the help.

Michel

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

InFINNity-Deck, 2020-06-06:
Hi Michel,

no problem to check your code, but the attachment is missing...

Nicolàs

Op 6-6-2020 om 16:46 schreef Michael:
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

--
Deze e-mail is gecontroleerd op virussen door AVG.
http://www.avg.com

InFINNity-Deck, 2020-06-06:
Hi Michel,

thanks for the attachments. I have sent a new version of my algorithm that follows the MW4 Cartesian coordinates convention.

Nicolàs

InFINNity-Deck, 2020-06-07:
Hi Michel,

I found one major factor that causes the up to 15 degrees slew errors: it is the GEM-offset, see attached image of the original screen:

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

In packages like SGP the offsets have to be entered from the dome's centre and from the mount's centre of rotation. Earlier I made the mistake by doing the same for MW when it comes to providing the offset from dome to mount (I gave then to the RA/DEC axis intersection as I did in SGP, whereas I should have provided them to the mount's base as the rest is calculated by MW based on the connected mount).
Reading your Python code I found this offGemPlate variable that was set to 0.233m for the GM3000. So instead of entering 0.42m for my actual GEM-offset I entered (0.42 - 0.23) = 0.19m GEM-offset and now it is bang-on in the centre of the slit at the four cardinal points at 1 degree altitude.

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

What still goes wrong is using sub 1 degree altitude points. In those cases the rear intersection point is calculated (the one at the camera side) instead of the forward one (the one at the objective side).

Nicolàs

mworion, 2020-06-07:
Nicolas,
thanks for this observation. Now we should (and please a proposal from your side as I'm too much into my code) define, what a user normally (without any special explanation) would use and set as geometry parameters. I will adjust my code accordingly.
Michel

mworion, 2020-06-07:
The last observation is easy to explain: I choose the point which hits the sphere at the highest level. If the mount looks down, It's the rear end. I have to change that.

InFINNity-Deck, 2020-06-07:
Ok, but if I use points at 0.05 degrees altitude it goes wrong as well.

Another thing is that I did above test with version 25b6. I just upgraded to 26b7 and pointing is off again. I tried it with both a positive and a negative LAT-offset, but that made no difference. So what did you change between 25b6 and 25b7?

Nicolàs

InFINNity-Deck, 2020-06-07:
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

Well, it does not matter too much as long as it is clear from the image on the set-up page. If the values you have predefined in the software are correct for all 10Micron models, then the GEM-offset could be changed into "Additional GEM-offset" with the image next to it modified to clearly indicate where that offset resides. I fear, however, that that still may be confusing, so perhaps it is better to let the user provide the actual GEM-offset, as that is a known figure to every GEM-owner. You could then use your predefined offset to check if the entered value makes any sense (the actual GEM-offset should after all be at least a few centimetres larger than the figure you hardcoded).
On the other hand, if you wish to be in line with other software packages, I would remove all the predefined offsets and let the user supply the offsets to point A and the actual GEM-offset A-B.

Of course this means that you will have to kill one of your darlings... :-(

Nicolàs

mworion, 2020-06-07:
I definitively would like to in line with the known packages. That was the reason internally calculating with this difference, but offering only the A-B measurement to the user. I wonder why you had to calculate the difference yourself as MW4 only asks for full GEM delta. So there is more to correct on my side. The values to be entered have to be 0.42m.

InFINNity-Deck, 2020-06-07:
Ok, I tested 0.42m with version 26b7, but it is way off again....

Nicolàs

mworion, 2020-06-07:
Still working on that issue. There were hardly any changes. But still there has to be a mismatch in there. Right now I try to get with your excel (thanks for that) some points.

One question: how is your definition of azimuth counting in the dome? It seems that I calculate the angle clockwise, so 90 degree is dome slit = azimuth in east.

Michel

mworion, 2020-06-07:
Another point to your observation having an angle 0.05 in altitude and getting the wrong direction: that might be due to the refraction correction in the mount. When I switch it on / off the apparent coordinates lead to a lower / higher point.
I will change the azimuth solution selection to a comparison which of the solutions is closer to the azimuth of the mount. This will be correct in all conditions.

Michel

InFINNity-Deck, 2020-06-07:
> One question: how is your definition of azimuth counting in the dome? It seems that I calculate the angle clockwise, so 90 degree is dome slit = azimuth in east.
That is correct: north = 0°, east = 90°, etc., so clockwise from north.

Nicolàs

mworion, 2020-06-07:
Nicolas,

First I made a mistake in shifting arctan in the right quadrant before extending it from -pi..pi to 0 ..2pi.

Second question in your excel chart: when looking north (first point in excel) and having pier side east, than the Ota is on the left (west side) of the mount looking east (per definition). If so, the resulting azimuth of the dome has to be(due the the geometry) on the upmost north east side, meaning that azimuth would be about 350 degrees or so.
Does this make sense for you ?

Michel

InFINNity-Deck, 2020-06-07:
At the first point (alt/azi 0°/0°) my Ota is hanging on the east side of the pier and by that is the lowest telescope in the array. The resulting azimuth in my sheet is thus correct, but I did not check whether the mount calls this east or west (east was a tricky assumption), I need to check that (will do so in a moment).

Nicolàs

InFINNity-Deck, 2020-06-07:
hmmm, it is called West for the first point..., so I will have to adapt my algorithm for that.

Nicolàs

InFINNity-Deck, 2020-06-07:
Ran some more tests using 25b7 (25b8 is available, but does not yet install):
north & east: mount reports pierside = west
south & west: mount reports pierside = east

GEM-offset still needs correction, so (0.42-0.23)=0.19m results in good azimuths
LAT-offset is positive for my set-up (azimuths are not spot-on when inverting the sign)

Nicolàs

mworion, 2020-06-07:
Nicolas,
coming closer. I will release a next beta for better testing soon. The choice of which solution to take is quite simple: it the on, the Ota looks to. As I have vectors, no issues with that. I Meade all corrections according to our results so far to get this new baseline.

GEM I checken. To the LAT definition: if the mount is pointing north if the OTA used for modeling is on the east from the center it's negativ, if it's west from the center it's positive.

My guess is that you are doing modeling with the refactor sitting beside the meade (not on top!),
it would be east of center an than negative.

Michel

mworion, 2020-06-07:
Uploaded 0.150.25b9

InFINNity-Deck, 2020-06-07:
Ok, just installed and tested it:
- GEM offset still needs correction for the built-in value of 0.233m;
- LAT-offset does not work at all;

I tried a LAT-offset of +0.15m, -0.50m and +0.50m, so the latter two should make a difference of 1m perpendicular to the equatorial plane when slewing east, which is 70cm in the horizontal plane. With all settings the dome arrived at exactly the same spot.

The GEM offset of 19cm works, but should of course be 0.42m.

Data from the log-file:

Delta's with GEM-offset @ 0.42m, LAT offset @ +0.15m:
north: -28.0°, so azimuth 28.0° (should be 18.34°)

Delta's with GEM-offset @ 0.19m, LAT offset @ +0.15m:
north: -18.0°, so azimuth 18.0° (should be 18.34°, so pretty close)
east: -10.7°, so azimuth 100.7° (should be 93.50°)

Delta's with GEM-offset @ 0.19m, LAT offset @ +0.50m:
north: -18.0°, so azimuth 18.0° (should be 22.04°)
east: -10.7°, so azimuth 100.7° (should be 82.09°)

Delta's with GEM-offset @ 0.19m, LAT offset @ -0.50m:
north: -18.0°, so azimuth 18.0° (should be 16.66°)
east: -10.7°, so azimuth 100.7° (should be 108.77°)

As you can see LAT-offset does nothing, I think you are rotating/translating into the wrong direction, so that the LAT-offset is displaced along the optical axis of the telescope. In my algorithm I calculate the perpendicular vector (by taking the cross product) of the vector towards the celestial object and the vector towards the GEM-offset.

Nicolàs

mworion, 2020-06-07:
I found a silly fault. As I added the lateral translation, I increased the vector numbers for all calculations afterwards except one. So all calculations were without LAT.

I made a quick bug fix. Hopefully it does the trick. If not I need a pause to reflect, what I'm doing and how.

I left the 3D window in the beta 0.150.25b10. There you could see nicely, when you change geometry, how it behaves. You could open the 3d test window with the button under settings / mount

Michel

InFINNity-Deck, 2020-06-07:
Hi Michel,

I just downloaded it, will test this evening. I started the 3D window while the mount is parked and it looks like this:

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

That top view does not seem right, is it?
When parked the RA axis should be pointing north-south, but it looks like south-east - north-west.
Also the LAT-offset should point east, but it is at an angle as well. Only the last line (the optical axis) seems correct.

Nicolàs

InFINNity-Deck, 2020-06-07:
Hi Michel,

good en less good news...
- Good news: it is spot-on! I tested it with 4 cardinal points @ 1degree altitude and 8 points @ 45 degrees altitude, 4 of which were cardinal points again, the other four in between, so at 45, 135, 225, and 315 degrees azimuth.
- Less good news: I still need to supply the GEM-offset corrected for the 0.233m mount geometry, so I have been running this test with 0.19m 'GEM-offset' (better to call it "Additional GEM-offset").

I can also confirm that the LAT-offset works fine now and that entering a positive figure for it in the GUI, produces the offset that is shown in the InFINNity Deck image. I have tested it with positive and negative values and it clearly makes a difference between correct and incorrect dome-azimuths.

The 3D window behaved very well when I restarted again this evening, but after parking it looked odd again. During the tests it behaved very well.

So now the only thing left for you to decide in this respect is what to do with the GEM-offset:
- leave it how it is now and modify the image to show what should be entered (and call that entry on the dome-TAB "Additional GEM-offset");
- leave the image how it is and modify MW4 not to use the preset GEM-offset.

The former makes MW4 very consistent, as all the mount's dimensions come from the program, which is easy to explain.
The latter is less confusing, unless it is very clearly stated that it is not a GEM-offset, but an addition to it. Choosing this option means we need to test again, but that is no problem.

I have no preference.

Nicolàs

mworion, 2020-06-07:
Hi Nicolas,

First of all many thanks for all your work and help. I did an update for the 3d window (I could make a quick release of it. And I tried to reproduce it with my mount. Something looks different. You also could resize the window and could change the views with the mouse in the grid. If you do too much, there might be a hang. I didn’t want to put too much work into the rendering. v0.150.25b12

I made a video, where you can see the change of the settings and the behavior of the mount. Actually it is in park position, which is pointing to Polaris, too.

https://www.dropbox.com/s/ikyn1dzr471bc7l/Bildschirmvideo%20aufnehmen%202020-06-07%20um%2021.34.07.mov?dl=0 <https://www.dropbox.com/s/ikyn1dzr471bc7l/Bildschirmvideo%20aufnehmen%202020-06-07%20um%2021.34.07.mov?dl=0>

If you like, I’ll do the beta now, but continue to work tomorrow.

Michel

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

InFINNity-Deck, 2020-06-07:
Hi Michel,

no hurry, MW4 is working fine now, while the weather will be too lousy for the coming days to do a real test.
Please let me know once you decided what to do with the GEM-offset (so whether or not you would like to receive a new image).

Thank you for al the work and quick responses, it felt like good teamwork! If you ever need a dome-tester again, you know where to find me. ;-)

cheers,
Nicolàs

mworion, 2020-06-10:
Thanks Nicolas,

as soon as you have some practical experiences. please let me know. I leave this point open until final clearance about geometry and documentation works.

Michel

mworion, 2020-06-13:
Hi Nicolas,
finally I watched the problem. The calculation go GEM and all the stuff was OK, the only point was the sequence of the initialization of the geometry values and the dome settings. The letter took place before the mount initialization was done and got overwritten. So if you test the settings now after MW4 start without changing the GEM value, you will see the fault. And therefore you adjusted the value. If you change this value after MW4 only once during this lifecycle, it would be OK without your correction. I changed this and it will be corrected in 0.150.25. So there is no reason not to go for the standard GEM values.
Michel

InFINNity-Deck, 2020-06-13:
Hi Michel,

thanks, good to hear, looking forward to the next edition.

Nicolàs

Closed 2020-06-13.

Thread 42 (2020-06-01):

RIP MW4

ACMBakx, 2020-06-01:
This morning MW4 was up and running.
This afternoon it did not start anymore........
Run.bat   Update.bat nor Install.bat are stopping after a initial startup.
The dome driver is started btw.
Attach the last log.

Arie
[mw4-2020-06-01.log](https://github.com/mworion/MountWizzard4/files/4712943/mw4-2020-06-01.log)

ACMBakx, 2020-06-02:
Fixed. It is running again.
Somehow a corrupted horizon points file was created by me.
Deleted it and now MW starts up again.

mworion, 2020-06-02:
Arie,
thanks for the log. The were two issue seen in the log and I added test against it.
- Reason was (for start) that if you had more than 5 retries to connect to an ASCOM driver -> MW4 will stop.
- Horizon file: I check boundaries, but I missed the case checking an empty one.

Fixed in the next beta.
Michel

Closed 2020-06-02.

Thread 46 (2020-06-03):

Dome geometry trial

ACMBakx, 2020-06-03:
[mw4-2020-06-03.log](https://github.com/mworion/MountWizzard4/files/4726090/mw4-2020-06-03.log)

Just ran a small golden cirkel model east/west order.
Found dome settings that give good accuracy for dome alignment.
However found accidentally 2 area's where things go wrong.
Sky points at 59 deg alt and az 36 and az 324
Point #16 in the model and the mirrored one.
Here the dome is send in the opposite direction.
In this dome position the telescope is looking against the dome roof,
When I rotate the dome at the same az as the telescope, the telescope just looks under top edge of the slot.
Points at a small distance from these 2 points cause the dome to find an acceptable position.
See the log #point16 was the troublemaker.
All the other points were well aligned within limits.
The numbers are ofcourse only valid for my set-up dimensions.
Regards
Arie

ACMBakx, 2020-06-03:
If the dome slot would have been 20cm longer over the top, this position would be ok,
But my dome slot stops just passed zenith. But with the dome and scope az being the same in these 2 positions, the telescope peeks just under the edge.

ACMBakx, 2020-06-04:
Checked today against theScopedomedriver telescope sync option.
This connects with the the telescope via poth.
Here the dome is pointed in the correct direction.

InFINNity-Deck, 2020-06-04:
The way dome azimuth is calculated, is by calculating the intersection between the line-of-sight from the OTA through the spherical shape of the dome. These intersections are calculated in 3D relatively to the dome's centre. The required azimuth is calculated from the horizontal coordinates of the intersection. The reason why the dome makes a (seemingly unnecessary) large slew is caused by the location, relatively to the dome's centre, where the line-of-sight intersects the dome. When taking a steep sight in for instance direction west, it can well be that the intersection occurs just east of the dome's centre. As a result of this the dome is steered east, while the scope is aimed west. How often this depend of course depends on how high the mount sits within the dome, its horizontal offset to the dome's centre, and the size of the mount itself, including the GEM- and lateral-offsets.

On itself these large dome slews can be avoided if the length and width of the slit and diameter of the OTA are known. As long as the distance from the dome centre remains smaller than the length and width of the slit (corrected for half the OTA's diameter on all three sides) the dome needs not to slew. For lower altitudes, the same is true when the azimuth of the target is within the width of the slit (again minus half the OTA's diameter on both sides).

The main problem in addressing this, is the accuracy with which the dome is steered. In my case it has an accuracy of about 2 degrees, which equals to about 5cm at a radius of 1.5 metres (about one-third the diameter of my deep-sky imaging scope). So for determining whether or not the dome should slew, this amount should be taken into in account when comparing the current dome's azimuth to the newly calculated azimuth. So if the newly calculated azimuth is away from the dome's slit-edge by (half OTA diameter + dome slew accuracy) then no slew is required. The slit of my dome is 80cm wide and runs 40cm overhead, making this marging 7.5 + 5 = 12.5cm, leaving a useable space within the slit of 55cm (roughly 20 degrees for my dome).

Nicolàs

mworion, 2020-06-13:
Hopefully a tested dome geometry calculation will be in 0.150.25 release soon.

ACMBakx, 2020-06-13:
The last geometry test I ran was very accurate Michael.

mworion, 2020-06-14:
Arie,
thanks for the feedback. Closing this issue now with the release of 0.150.25

InFINNity-Deck, 2020-06-14:
I confirm Arie's findings, indeed very accurate, thanks a bunch!

Nicolàs

Closed 2020-06-14.

Thread 48 (2020-06-07):

ASCOM Support for "Obeserving waether conditions Hub"

Ruediger3, 2020-06-07:
Hello Michel,
since integration for INDIGO will definitely take some more time, would it be possible to integrate ASCOM direct support for "Observer weather conditions hub" so SQM and MGPBox could be connected?

Thank you in advance!
Cheers Rüdiger

PS: I closely follow the current activities related to dome control with Nicolàs. Take your time to finish this first. This has definitely more important.

mworion, 2020-07-04:
Support added in 0.150.28 for sky meter and sensor weather

mworion, 2020-07-19:
Any news if this works in your environment ?

Ruediger3, 2020-07-19:
Hello Michel,

sorry for the delay. I was totally focused on the FW testing...

Just made a first test and it looks good. I get the data. Only with temperatures there is a small mix-up. It looks like that "Temperature" is taken for both Temperatures (also for Sky Temperature) though it is a different value coming from other device.
Please see screen shot. I hope I could make my point clear.

I have not included UPB in the environment hub data, since I i get more precise data from MGPBox.

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

mworion, 2020-07-19:
Rüdiger,

that's OK, because the SQM does not read sky temperature, but environment temperature, so I set the readout to temperature. The SQM driver does not provide the sky temperature, but temperature property.

Michel

mworion, 2020-07-19:
...is now online...

Ruediger3, 2020-07-19:
Hi Michel,
This is not a good idea, since thr SQM is contained in a sealed plastic pipe, which heats up - up to more than 20°C over ambient temperature. This value should be clearly separated and definitely not used for any calibration or post procession.

mworion, 2020-07-22:
Rüdiger,

you are right. I just show this number, MW4 does not process anything (beside measuring it). Other frameworks show this number, so nothing bad happens. I could not be used.

Michel

Ruediger3, 2020-07-22:
Hi Michel,
Showing the value was not the issue, but as you can see on the screenshot, the value is copied and used for sensor data, instead of using the correct temp of the observation hub.
If it would be only displayed then you were right, but it is overwriting the needed temperature.

Closed 2020-07-22.

Thread 56 (2020-06-16):

Almanac: 2 Improvement sugestions

Ruediger3, 2020-06-16:
Hello Michel,

I really do enjoy the Almanac. It is a very useful deature, but there are two things which are confusing to me:

1. In the right list the entries for "Darkness" is missing. You dont know where "astronomical Twilight" ends, and this is the most important information.

2. The yearly graph should be in the same time zone as the list. UTC is of course fail safe towards DST and similar things, but it forces you always to recalculate the times on the fly. Hence it would nice to align the graphic with the time zone chosen.

Thank you in advance!

Cheers
Rüdiger

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

mworion, 2020-06-18:
Rüdiger,

Point 1: could it be the case that your lat is not defined (as not connected to mount) and is set as default to Greenwich? If so, there is no dark.

Point 2: makes much work as I have to recalculate the positions (list is easy as just defining the time zone). I put it on the wish list.

Michel

Ruediger3, 2020-06-18:
Hello Michel,

1. No, the location is set properly (see screen shot)

I guess, darkness is not show, since currently there is none. But at least there should be an entry like: N/A or "--" to make that clear.

2. Second the diagram is not correct, since there is no astronomical darkness in the time period in the circle). Looks like it uses a wrong location.
Time zone could be easily adjusted with just shifting the the diagram along y-axes with an hourly offset.

Cheers
Rüdiger

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

mworion, 2020-06-18:
Hi Rüdiger,

point with the graphics valid. With you lat, there is right now no darkness. And you‘re right, when no Location is there, you will see „—-„

Michel

Ruediger3, 2020-06-18:
Hi Michel,

thank for the reply.

I meant with "--" these should be displayed if there is no darkness at you current location and time. So it makes absolutely clear, that it wont be dark tonight.
And if there is darkness. then there should be a lines about Darkness.
I would suggest to make it clear what is really meant:

Always to use the point of time when something starts
e.g the list could look alike (all start times). By that all intervals are well defined.:
Civil Twilight
Nautical Twilight
Astronomical Twilight
Dakrness
Astronomical Twilight
Nautical Twilight
Civil Twilight

mworion, 2020-06-20:
Hi Rüdiger,

I will go to an online version as calculation of world wide timezones, north / south hemisphere etc. Is simply too much to do. I will tale like for the Environment my online source. Not that nice, but OK.
Will be present in next version

Michel

Ruediger3, 2020-06-20:
Hi Michel,

For me ok since I am stationary, but keep in mind that there are a bunch of people who are mobile or have no internet at their observatory or location. At least you should keep MW's basic functions available offline.

Cheers
Rüdiger

Ruediger3, 2020-06-20:
Yet another point which you should consider: you are transferring user information to a third party service provider which raises legal issues. You need explicit confirmation of the users within EU in respect to GDPR.

mworion, 2020-06-20:
Hi Rüdiger,
not all could be done offline. But as you said the overview is prepared before, that's online, the timing calculation stays offline capable.

Right now I do not transmit any user data to a provider. Still there is the point that I load a webpage. There is no capability to store data from web locally as I do not have a local cache for it (make life offline harder). But I will add the hint of what could happen if you are online in the doc's and tooltips and you have to explicit enable the online mode. If you do not get online, you won't have any connection.

Michel

Ruediger3, 2020-06-20:
Hello Michel,

Nicolàs has a ready to use script even for offline use. I think he will happily share it. I think this should de easily to be integrated. So no need to re-envent the wheel ;)

http://www.dehilster.info/astronomy/astronomical_twilight.php

mworion, 2020-06-21:
Hi Rüdiger,
I tried to switch now to a local time only solution. You could give it a try it's:
0.150.26a1
As you normally not see alpha in the internal installer, you have to enter the version in the installer field manually.
Good point: you have DST and all other parts in.

Michel
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

Ruediger3, 2020-06-21:
Hi Michel,

that sounds really great! Just tried to install, but get an error.

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

Ruediger3, 2020-06-21:
After renaming the file I get the next error:
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

Ruediger3, 2020-06-21:
Here the log file. Tried to rename the complained files. But was not successful.
Please find attached log-file.

[mw4-2020-06-21.log](https://github.com/mworion/MountWizzard4/files/4809206/mw4-2020-06-21.log)

mworion, 2020-06-21:
OK
thanks to windows! The reason is that windows keeps the files locked for whatever reason (this does not happen on ubuntu and Mac). So the solution would be to do in manually:
Change to work dir

venv/Scripts/activate
pip install mountwizzard4==0.150.26a1
deactivate

and then start with the run script again. This should do the trick.
Just for information: when this might happen with an official release, there is the update script available as well. But this is not build for updating alpha or beta versions.

Michel

Ruediger3, 2020-06-21:
Hi Michel,

sometimes I use the update script, but I was looking for an option to pass a version ID to it. Now I know, it is not possible. But I will keep the "trick" above.

the graphic looks fine to me!

One minor suggestion: labeling of the x-axis: this is a bit hard to read. I would label every second month 1st and joust with month's short name "Feb", "Apr", "Jun" and so on. The grid I would keep month wise. So there is no need to have daily dates. What could be also improve could be a mouse over / mouse tooltipp
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
 showing the actual date you are currently pointing at at. The deluxe version could be when pointing at one of the "event" lines to show date and time as mouse tool tip. but this only nice to have, but would add additional value.

One question: If there is "darkness" is there an addition line and time displayed in the table section shown?

But the rest looks pretty nice to me. Thanks a lot for this offline version. Very much appreciated your work and sorry for all the extra work I produce. Just trying to support.

Cheers
Rüdiger

mworion, 2020-06-21:
Rüdiger,

the list to the right is the list the library brings up. There are only events when happen real, not the ones which exist, but don't happen. As it is an external library I'm not gonna change it.
Try to finalize the tooltip. The X axis I could change. Still some work as the exact day is always in the middle ! So the whole chart moves a little bit per day.
Mouse over is hard to implement. I would omit this part.

Michel

PS: It's not a good idea changing files in venv manually.

Ruediger3, 2020-06-21:
That's all fine to me. Thanks a lot!

mworion, 2020-06-21:
The final landing zone:

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

Michel

Closed 2020-06-21.

Thread 57 (2020-06-28):

ASTAP Solver Failed

jmhirschi, 2020-06-28:
Hello,

I try to solve my images with ASTAP from MW4 (v0.150.26)

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

I receive immediately the following message

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

When I try to solve the same image directly from ASTAP the solving is perfect.

Best regards,

Jean-Michel

mworion, 2020-06-29:
Hi Jean-Michel,

Just tried it, with a test image it works. So please do me a favour: zip this fits file and drag it to the GitHub issue and drop the log file as well. That’s the best and easiest way to find out

Michel

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

mworion, 2020-07-02:
Any news?

jmhirschi, 2020-07-02:
Hello Michel,

First of all many thanks for your support and quick answer. I should apologize for my late answer. I've attached the requested files but in the meantime I've been able to solve the image having uninstalled and reinstalled ASTAP on a different drive (on the drive C: now). I don't know if the move from D: to C: was the solution but at least I'm now able to solve images with ASTAP from MW4.

I'm now facing another issue when I run a Model Build. Everything work well (points, slew, image acquisition) but the solve stay at 0 and the model is not updated

Please look at the log from the 2020-06-29.

Many thanks.

[mw4-2020-06-28.log](https://github.com/mworion/MountWizzard4/files/4866364/mw4-2020-06-28.log)

[mw4-2020-06-29.log](https://github.com/mworion/MountWizzard4/files/4866415/mw4-2020-06-29.log)

mworion, 2020-07-03:
Hi,

the log files saying that calling ASTAP needs elevation in rights. So you may have the situation that ASTAP is installed with admin rights (which should not be necessary) and afterwards MW4 tries to run it as normal user.

Please check this.

Michel

jmhirschi, 2020-07-05:
Hi Michel,

I checked the installation parameters of the two software and neither Astrap nor MW4 have administrator rights.

Jean-Michel

mworion, 2020-07-06:
OK, understood,
did you disable UAC (User account control) ?
Michel

jmhirschi, 2020-07-06:
Hi Michel,

Thanky you so much for your active support. On my PC the UAC is **disabled**. See the screen shot below.

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

mworion, 2020-07-06:
OK, please let me know, where you now installed ASTAP exactly (Path). I will log that in future. I just log that everything is there, but not where.
Michel

jmhirschi, 2020-07-06:
ASTAP is installed under

C:\Program Files\astap

mworion, 2020-07-07:
Jean-Michel,
I can't reproduce your observations in my environment. Nor with different UAC settings nor with other tweaks. I will publish a test release with some extended logging to capture that.
Only point (from theory) left:
Where is the star database located ?
And: please move the work dir from desktop to a user folder (e.g. new folder or documents) as windows10 tends to treat the desktop as a restricted area and might ask for elevation when writing a file, too.
Michel

jmhirschi, 2020-07-07:
Michel,

The star database is stored in the same folder as ASTAP.

I've moved the work folder under c:/Program Files/work and ran a small model build but still same issue. The model build ran perfectly, capture the images but doesn't solve them

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
.
Another strange thing is that I don't receive any information about the time but it's a detail.

When I manually load and solve the saved images created by the model build then ASTAP is able to solve (and this fromMW4).

Cheers.

Jean-Michel

Ruediger3, 2020-07-07:
Hello both,
I had some similar issues the past few days. Solving did simply not work, No output in the log windows at all, Even restarting MW did not help. It turned out, there was always a stalled instance of ASTAP in the background, because ASTAP could not solve the very first image. Maybe this is a different case but it had the exact same symptoms.

mworion, 2020-07-09:
Rüdiger,
do you have a log for this event? Would be helpful.
Jean-Michel, could you comment on this ?
Michel

Ruediger3, 2020-07-09:
Hi Michel,
Yes I do have all the logs, but the problem is I cannot find the proper one, since I start MW every day and they are huge. I have attached the log of the day, where it likely happened, but I guess it is useless, since I cannot ensure it is the right one.

[mw4-2020-07-05.zip](https://github.com/mworion/MountWizzard4/files/4895594/mw4-2020-07-05.zip)
.

jmhirschi, 2020-07-09:
Hi Michel and Rüdiger,
I ran another test yesterday evening with no success. I do not detect any
instance of ASTAP running in the background like described by Rüdiger but
the final result is similar. No solving at all.

Le jeu. 9 juil. 2020 à 09:55, Michael <notifications@github.com> a écrit :

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

mworion, 2020-07-15:
@Ruediger3,
in the log, there is no problem with ASTAP. ASTAP solved within 0.9 - 1.2 sec.

@jmhirschi,
you said, you could solve the file through MW4 when loading it in image window and manual start solving. Right ?
The message about time is easy to explain: Their first update will be made after the first solve to estimate the overall process time. If you don't get a solve, no estimation possible -> not time display.

Michel

mworion, 2020-07-15:
No Problem and thanks for helping.

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

jmhirschi, 2020-07-18:
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

Hello Michel,

Correct, I can solve an image from MW4 without any problem.
[mw4-2020-07-08.log](https://github.com/mworion/MountWizzard4/files/4941669/mw4-2020-07-08.log)

mworion, 2020-07-22:
OK,

within the provided Log file there is no manual solve in it. An there is no model run in. Just that ASTAP is found and some interactions with satellite

Michel

jmhirschi, 2020-08-11:
Dear Michel,

I've entirely reinstalled MW4 on a NUC W10 PC and everything works well now. I know I'm no more in the same configuration as when I launched this request but today my initial issue is solved. Can we close this issue or you want to continue in order to solve the Ruediger's problem ?

mworion, 2020-08-11:
As Rüdiger is able to work without problems, you can close it.
Michel

Ruediger3, 2020-08-11:
I am fine with that. Currently every thing works as expected. Maybe only a hick up.

Closed 2020-08-11.

Thread 60 (2020-08-05):

Unable to select model, load/save preferences, or quit

Raddock, 2020-08-05:
Hi Michel, I was having trouble with the last working version connecting to INDI devices, so I updated to the latest version 0.150.29. I'm unable to load or save settings in the main window. I'm also unable to generate any model points, load an existing model, etc. No button presses seem to work on these panels. But I can change devices in device settings. The Pegasus UPBV2 is updated to firmware 1.5, but seems to report lots of debug errors to the messages window. See attached log.  I cannot save or quit, so I have to quit Pyton from the apple menu. The interface (only parts of it) seem to not be accepting mouse clicks. I did mange to save a working copy on my laptop, but thought you should know there are issues with this version. I have even reinstalled it from scratch in a new directory, with the same issues appearing. Thanks for your time.

[mw4-2020-08-05.log](https://github.com/mworion/MountWizzard4/files/5025943/mw4-2020-08-05.log)

mworion, 2020-08-07:
Hi Andrew,

the extensive logs of UPBv2 are normal and don't show any problematic topics. It's massive, because you set logging in EKOS / KStars to debug and in MW4 you enables show INDI messages. You could revert to any old version by entering the version number in the update field.

The behavior is related to Qt5 framework update 5.15 which I tested in my setup and works with windows, but has troubles with some OS X installations.

Michel

PS: uploaded 0.151.0 which should solve the issue

Raddock, 2020-08-08:
Hi Michel, This brought back all buttons and model loading. However the model making process stops always at the last star after solving, then does not upload the model into the mount. This is the same for 3 star models, or 50 star models.

I must have turned off logging in order to stop the UPB because these logs I attached don't show the modeling process. But there is one error or two in them which might be related or not.

[mw4-2020-08-08.log](https://github.com/mworion/MountWizzard4/files/5045227/mw4-2020-08-08.log)

[mw4-2020-08-07.log](https://github.com/mworion/MountWizzard4/files/5045220/mw4-2020-08-07.log)

mworion, 2020-08-08:
Hi Andrew,

if you want to stop logging UPB (which is done by EKOS), you have to disable debug in EKOS. If you want to reduce log load in MW4 from this source, please disable message out in the Indi UPB driver settings.

I don't see any issue in the log, but not much in. Last night I did 3 times modeling with the same software on my Mac and saw no issues. I used ASTAP for solving.

Michel

Raddock, 2020-08-14:
Worked perfect tonight with V 0.151.2. Thanks!

Closed 2020-08-14.

Thread 61 (2020-08-07):

Problem connecting to QSI camera via ASCOM

SimonWalsh1000, 2020-08-07:
Hi Michel - I am running MW4 v0.150.29

I can't connect to my QSI camera. I had previous be using an ASI 1600mm without problems but now, when I try to change the camera setting via camara>set>ASCOM device set up>QSI CCD Camera the field will not update to the QSI camera. It remains on ascom-ASICamera2.Camera. Do you have any suggestions please?
Best,
Simon

mworion, 2020-08-07:
Hi Simon,
I will try this during the weekend. As I own a QSI as well, but never used it from ASCOM, I'll give it a try. Did you try QSI with ASCOM or the native driver ?
Michel

SimonWalsh1000, 2020-08-07:
Hi Michel,

I tried to connect via the native driver.

ie selected ASCOM, then selected QSI CCD Camera from the drop down. But could get it to connect.

Simon

mworion, 2020-08-07:
Simon,

I think I found the issue. v 0.151.1 should do the trick. I used the actual QSI driver from their webpage 1.0.0.4 which was uploaded recently.

Michel

SimonWalsh1000, 2020-08-07:
Unfortunately there are issues with the new QSI driver and other programmes like Voyager and SGP. Does this version of MW work with the older driver?

Best,
Simon

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

mworion, 2020-08-07:
Basically it should be no problem, but I only took the recent driver for testing.
Michel

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

SimonWalsh1000, 2020-08-07:
Michel thanks very much for this and all your work; I will give it a go tonight!

Best,
Simon

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

SimonWalsh1000, 2020-08-07:
Hi Michel,

Unfortunately, I couldn't get it to connect to the camera either with the
new or legacy drivers. I find that the new drivers don't work for me in
Voyager or SGP and I have discussed this at length with QSI (although the
legacy drivers work fine). There are also some posts on CNs about it.

Not sure what the next step is - is there a way to debug this?

Best,
Simon

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

--

SLFWalsh MD MRCP FFRRCSI
Consultant Radiologist,
NIHR Clinician Scientist,
National Heart and Lung Institute,
Imperial College, London

Imaging Chair, European Respiratory Society
Associate Editor, European Respiratory Journal
http://erj.ersjournals.com

mworion, 2020-08-07:
Simon,

If you could post the Logfile that could help. Unfortunately I already put mit rig into the garden so I can‘t check QSI with ASCOM connection when using an older driver and debug it. Could be done probably tomorrow if the log does not tell anything.

Michel

SimonWalsh1000, 2020-08-07:
No worries!

Will do tomorrow.

Many thanks again.

Clear skies for tonight.

Best,
Simon

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

mworion, 2020-08-14:
Simon,
Any news about the QSI driver ?
Michel

SimonWalsh1000, 2020-08-15:
Hi Michel,

Sorry for the late response; I still can’t get my camera to connect using the legacy driver which is the only one that works for me otherwise. Incidentally, there are quite a few people having problems with the newest QSI driver and unfortunately ATIK (who now own QSI) seem indifferent to their customers.

It’s cloudy now but tomorrow I’ll create a log in MW4 so you can see what the issue is.

Thanks again for your interest.

Best,
Simon

SimonWalsh1000, 2020-08-24:
Just to add one thing Michel.

The imaging section in settings lists the camera parameters which seem to
be pulled from the camera driver. But my QSI does not have this listed in
the driver; is there a way to manually populate these fields?

Best,
Simon

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

--

SLFWalsh MD MRCP FFRRCSI
Consultant Radiologist,
NIHR Clinician Scientist,
National Heart and Lung Institute,
Imperial College, London

Imaging Chair, European Respiratory Society
Associate Editor, European Respiratory Journal
http://erj.ersjournals.com

mworion, 2020-09-06:
Simon,
park after model I add in one of the next releases.
I checked QSI quickly and I got the values, but I might have a second driver running. Still have to clarify this
Michel

mworion, 2020-09-12:
Simon,

I checked my QSI690 in detail. All parameters from camera (cooling status and temp, pixel size, resolution, download) are loaded from driver. I tested the 1.0.0.3 and the new 1.0.0.4. Both work. Still what I found that the connection to the camera through ASCOM is sometime not reliable.

If you still have the problem, please post the log and some screenshots of the Ascom configuration for QSI

Michel

mworion, 2020-11-01:
Simon, closing it as there are no new reports. Data comes with my QSI690. Hopefully it's fixed now.
Michel

Closed 2020-11-01.

Thread 65 (2020-09-02):

Flip Flat

mhambuch, 2020-09-02:
Hello Michael, i just invested in a Flip Flat device (i guess there is only one from Alnitak) and saw that there are some control buttons. Currently only indi is proposed, i use ascom via alpaca. Maybe you could add this communication channel in a future release, would be nice if i could at least open / close the cover from mw4. Thanks for considering.
Marc

mhambuch, 2020-09-02:
No ascom driver for this device so the request does not make sense. I will try to use indi.

mhambuch, 2020-09-02:
Reopened the issue just to ask if there is an other way to control the flip flat device as indi is not supporting w10. ?

mworion, 2020-09-02:
Marc,

with ascom 6.5 there is a cover device available. If you have a ascom driver (which should be the case) I will integrate this device.

Michel

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

mhambuch, 2020-09-02:
Hi  Michael, thanks a lo. Yes i have the new ascom 6.5 installed as well as alpaca.
Can you guide me to access this ascom cover driver?
Marc

mworion, 2020-09-06:
Marc:

Got it implemented in MW4. Only point so far: I could test it with the ASCOM simulator, but as I also have an Alnitak FlipFlat I see that there is no compliant ASCOM6.5 cover driver available from OPTEC. We both should address this.

Michel

mhambuch, 2020-09-06:
Thanks a lot Michel. I guess the only way is to contact Optect, i will contact them unless you you want to address it differently.
Nice WE
-------- Message d'origine --------De : Michael <notifications@github.com> Date : 06/09/2020  13:18  (GMT+01:00) À : mworion/MountWizzard4 <MountWizzard4@noreply.github.com> Cc : mhambuch <mhambuch@laposte.net>, State change <state_change@noreply.github.com> Objet : Re: [mworion/MountWizzard4] Flip Flat (#65)
Marc:
Got it implemented in MW4. Only point so far: I could test it with the ASCOM simulator, but as I also have an Alnitak FlipFlat I see that there is no compliant ASCOM6.5 cover driver available from OPTEC. We both should address this.
Michel

—You are receiving this because you modified the open/close state.Reply to this email directly, view it on GitHub, or unsubscribe.

mworion, 2020-09-06:
I wrote them as customer an email. Please do so as well.

Von meinem iPad gesendet

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

mhambuch, 2020-09-06:
just did it. thx

-------- Message d'origine --------De : Michael <notifications@github.com> Date : 06/09/2020  14:42  (GMT+01:00) À : mworion/MountWizzard4 <MountWizzard4@noreply.github.com> Cc : mhambuch <mhambuch@laposte.net>, State change <state_change@noreply.github.com> Objet : Re: [mworion/MountWizzard4] Flip Flat (#65)

I wrote them as customer an email. Please do so as well.

Von meinem iPad gesendet

> Am 06.09.2020 um 14:14 schrieb mhambuch <notifications@github.com>:

>

>

> Thanks a lot Michel. I guess the only way is to contact Optect, i will contact them unless you you want to address it differently.

> Nice WE

> -------- Message d'origine --------De : Michael <notifications@github.com> Date : 06/09/2020 13:18 (GMT+01:00) À : mworion/MountWizzard4 <MountWizzard4@noreply.github.com> Cc : mhambuch <mhambuch@laposte.net>, State change <state_change@noreply.github.com> Objet : Re: [mworion/MountWizzard4] Flip Flat (#65)

> Marc:

> Got it implemented in MW4. Only point so far: I could test it with the ASCOM simulator, but as I also have an Alnitak FlipFlat I see that there is no compliant ASCOM6.5 cover driver available from OPTEC. We both should address this.

> Michel

>

> —You are receiving this because you modified the open/close state.Reply to this email directly, view it on GitHub, or unsubscribe.

> —

> You are receiving this because you commented.

> Reply to this email directly, view it on GitHub, or unsubscribe.

—You are receiving this because you modified the open/close state.Reply to this email directly, view it on GitHub, or unsubscribe.

mworion, 2020-09-06:
We'll see. I close this point an we could reopen that once we could test.
Michel

mworion, 2020-09-09:
Hi Marc,

That’s the response I get:

Hello Michael,
We have an ASCOM and Alpaca ICovCal driver in progress. I don't have a solid ETA other than fairly soon. Ongoing effects from Covid lockdowns have caused major issues with our planned release schedule. In the meantime is there a reason that the current integrations no longer work for you?
Regards,
Daniel Van Noord
Optec, Inc.

BTW. On SGPro forum as they also updated to ASCOM6.5 the were loosing FlipFlat functions, too and need a new driver. This should make things run better.

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

mhambuch, 2020-09-09:
Hi Michel,
I got this reply from Jeff. Very responsive, sounds good.Marc
-------- Message d'origine --------De : Jeff Dickerman <jeff@optecinc.com> Date : 06/09/2020  19:32  (GMT+01:00) À : mhambuch <mhambuch@laposte.net> Objet : RE: Flip Flat Ascom 6.5

Hi Marc,
 
Thanks for your note.  Yes, we are working on a major update for the Alnitak drivers to include ASCOM and Alpaca for cross-platform compatibility.
 
Hope to have something in early October.
 
                Thanks again,
               
                Jeff.
 
 

Jeff Dickerman
–
President, Sales & Support
199 Smith Street - Lowell, Michigan  49331 - U.S.A.
Toll-free:  888-488-0381 - Office: 616-897-9351 - Fax: 616-897-8229

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

mworion, 2020-11-29:
Hi Marc,

I got a beta version of the ASCOM6.5 driver. You could use the FlipFlat with that, but is still buggy.

Michel

mhambuch, 2020-11-29:
Hi Michael,Great! Thanks a lot i will test it asap. You have the FlitFlat device as well right? My entire hardware setup is currently dismantled as i am setting up a fixed observatory.  Keep you posted. Nice WE
-------- Message d'origine --------De : Michael <notifications@github.com> Date : 29/11/2020  13:32  (GMT+01:00) À : mworion/MountWizzard4 <MountWizzard4@noreply.github.com> Cc : mhambuch <mhambuch@laposte.net>, State change <state_change@noreply.github.com> Objet : Re: [mworion/MountWizzard4] Flip Flat (#65)
Hi Marc,
I got a beta version of the ASCOM6.5 driver. You could use the FlipFlat with that, but is still buggy.
Michel

—You are receiving this because you modified the open/close state.Reply to this email directly, view it on GitHub, or unsubscribe.

Closed 2020-09-06.

Thread 66 (2020-09-12):

Camera not integrating when dome is active

InFINNity-Deck, 2020-09-12:
Hi Michel,

just tried to run a model build, but found out that when the dome is connected the camera won't integrate and MW4 stalls. As soon as I disable the dome the integration works and MW4 continues.

A log file is attached showing that MW4 has an issue with the shutter status. My dome is only automated in slewing, the shutter goes manual and has no switches and is thus not interfaced.

Nicolàs

[mw4-2020-09-12.zip](https://github.com/mworion/MountWizzard4/files/5213199/mw4-2020-09-12.zip)

mworion, 2020-09-13:
Nicolas,

reason for that was adding shutter function to dome. Unfortunately your dome driver does not support shutter status. Second problem was that I cannot review in advance if a driver supports a property. So this raised exceptions which did MW4 stop working. I put a workaround for catching this exception and disabling shutterstaus.

Next beta should work.

Michel

InFINNity-Deck, 2020-09-13:
Hi Michel,

My driver is LesveDomeNet and should support shutter status. But as I have not yet implemented this in the dome there is no electronics for it attached to the interface board. I have posted a question regarding this on the LesveDomeNet group to see if I need to add some wiring to get this working. For imaging I use SGP and that has no issue with the dome as it is.

I will leave this issue open for the moment until I have response from the LesveDomeNet group.

Thanks for creating a workaround in the next beta, will test it as soon as it becomes available.

Nicolàs

InFINNity-Deck, 2020-09-13:
Just had response from the LesveDomeNet programmer. Apparently the CanSetShutter should be read first before querying the shutter status:

> The application program is normally aware of this Capability by reading a property CanSetShutter and shouldn't read Shutter status
> If it does, LesveDomeNet will raise an error when trying to read Shutter status.

Nicolàs

mworion, 2020-09-13:
Nicolas,

OK, good hint. I will add the CanSetShutter property reading and we could check if that work. But anyway the workaround should do the trick as well.

Michel

InFINNity-Deck, 2020-09-18:
Hi Michel,

just started MW4 0.152.0b6 and all goes fine, we can close this issue.
Once again thanks!

Nicolàs

Closed 2020-09-18.

Thread 70 (2020-10-13):

The run button does nothing

gpassera, 2020-10-13:
232/5000
I installed mountwizzard 4 on win 7. I connected everything, mount, camera, solver etc etc. And everything seems to be fine. I generated the first 3 points but as soon as I press the run button nothing happens. I attach the session log.
[mw4-2020-10-13.log](https://github.com/mworion/MountWizzard4/files/5371148/mw4-2020-10-13.log)

mworion, 2020-10-13:
Hi,
thanks for the log. If you don't mind please set the logging for deep debug and try it again. Out of the warnings so far I can't see any problem.
Michel

mworion, 2020-10-13:
In addition: there might be the binning setting difficult. See 10micron forum about this case. Please try to set it to bin 1 and try it again as right now MW4 will skip imaging whenever the bin setting is higher than the driver reported.
This behavior will be changed.
Michel

gpassera, 2020-10-13:
Michael
Thank you for the answer.
I will do an I'll let you know.
Best regards
Giuseppe

www.giuseppepassera.com

Il mar 13 ott 2020, 19:53 Michael <notifications@github.com> ha scritto:

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

gpassera, 2020-10-13:
Michael
This is the dep debug log file.
As you can see from the screenshot the run button in not "highlited" unlike what I saw in the manual.
[mw4-2020-10-13.log](https://github.com/mworion/MountWizzard4/files/5373868/mw4-2020-10-13.log)
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

Best regards

gpassera, 2020-10-13:
...of course I did everything in binnig 1..
Best regards

Giuseppe

mworion, 2020-10-14:
Giuseppe,
thanks for the log, so far it has nothing to do with binning. For some reason not all prerequisites for starting model build are present. Could you post your configuration as well (in config folder named config.cfg). Can't reproduce you topic so far.
Michel

gpassera, 2020-10-14:
Michael
this is the config file.
Thank you very much and best regards

Giuseppe

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

--
Giuseppe Passera
www.giuseppepassera.com

mworion, 2020-10-14:
Giuseppe,

if you reply'd by email and attached the config, it will be not present in the issues. Files have to be dropped on the webpage on github.

Michel

gpassera, 2020-10-14:
Michael

Sorry . Now should be fine. (file was renamed to config.cfg.log)
Thanks and best regards

Giuseppe

[config.cfg.log](https://github.com/mworion/MountWizzard4/files/5378879/config.cfg.log)

mworion, 2020-10-14:
Giuseppe,

please try to update to 0.170.3 (your could use the internal updater). And do the logs as well. Hopefully I fixed it.

Michel

gpassera, 2020-10-14:
Michael
Thank  you.
I’m downloading but unfortunately it’s raining so I can’t test. Maybe tomorrow.
As soon as I’ve some news I’ll let you know.
Thanks a lot and, I forgot to say that your sw is really awesome.
Best regards
Giuseppe

Sent from my iPad

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

gpassera, 2020-10-15:
[mw4-2020-10-15.log](https://github.com/mworion/MountWizzard4/files/5382925/mw4-2020-10-15.log)
Michael
I'm sorry but still not going.
I am attaching the log of the attempt.

gpassera, 2020-10-15:
Best regards
Giuseppe

mworion, 2020-10-15:
Giuseppe, thanks for the log, it get now clearer,

just my observation, please comment if I am right or wrong:
You choose 3 points (which are available)
Image settings on bin 1, camera would support up to bin4
you push the model run button
MW4 accepts model build (as it starts clearing the model)
There is no slew initiated nor starting image integration.

If that's the case, please try the following: save (could be done in tab manage model) you actual pointing model in the mount (if you have one) under the name 'backup' (lower cases) and try model run again.

Anyway I will release a release for you this evening, which should have a workaround for this possible issue

Michel

Michel

mworion, 2020-10-15:
Don't know why the commit closed the issue without feedback from test, so I reopend it.

gpassera, 2020-10-15:
Michael
I did what you indicated in a slightly different way as the model in the frame is not there, it was deleted from previous attempts
1) Mount Wizzard launched
2) Loaded 3 stars
[mw4-2020-10-15_new.log.txt](https://github.com/mworion/MountWizzard4/files/5384832/mw4-2020-10-15_new.log.txt)

3) Loaded the model from the backup
4) Press run

The mount however did not move.

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
![Uploading Screenshot 2020-10-15 at 14.11.15.png…]()

mworion, 2020-10-15:
Giuseppe,

0.170.4 should solve the issue.

Michel

gpassera, 2020-10-15:
Michel

EUREKA!!!! It works, great job.
I'm so happy because your software is now a fundamental part of my setup.
I would like to thank you for your effort in solving the issue.
Really many many thanks.

Please let me know If you need something from my site, and don't hesitate to contact me in case you would like a hand to do some tests, I will be very happy to help you.

Best Regards and again many compliments!!!!

Giuseppe

gpassera, 2020-10-16:
Great job to support me.

Closed 2020-10-16.

Thread 72 (2020-10-15):

Hemisphere Window: Polar Diagram

Ruediger3, 2020-10-15:
Hi Michel,

a short question to polar diagram in "Hemisphere Window";
This function is disabled now for a long time, since it is not implemented. Any chance to get it done in near future? If not, I would suggest to remove it.
Personally I think it would be great to have a spherical view to toggle with plane view currently implemented, since the distribution looks completely different and sometimes you got mislead by the plane projection.

Thank you in advance!

mworion, 2020-10-18:
Hi Rüdiger,

I did some early preparations for bringing this back. I made a beta for that, revising all hemisphere handling. Still the CPU load might increase. Could you have a look to the usability and the speed (load) in version 0.170.5b1

Michel

Ruediger3, 2020-10-19:
Hi Michel.
thanks for the Beta. I have installed it. For me there is no difference in speed to before, but I have a very powerful workstation.

2 Things I have noticed:

1. Last point in horizon mask drops to zero, though you have made some code changes for that. My be it needs review. After the last point the mask drops to 0 degree altitude and does not close the 360 degree. Please see screenshot at the right.

2. What would be a could idea when auto creating the point grid to stay away from the horizon line a few degree. There should be a kind of safety distance, because if these limits are heated up building roofs, it might cause seeing effects (what it was in my case). May be any option "Distance to horizontal line in degree" would be a good idea?

Thank you very much for all your efforts!

Cheers
Rüdiger

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

mworion, 2020-10-19:
Hi Rüdiger,
1. is already addressed. Might be the case if you have an file with that point in it (I did it in the past for getting the polygon). If you clear the horizon and start with a single point in the middle, you could see that.
2. good idea. still so the generation of the horizon mask is the critical point. I thought about having some automatics there as well, but this might take some time.
Michel

Ruediger3, 2020-10-19:
Hi Michel,

to 1: To be honest, I do not want to delete the Horizon mask. This was exactly created with the mount and cross hair eye piece. It looks simple and humble. but it is very precise. Maybe I can edit the file itself. This is easier.
[Horizon.txt](https://github.com/mworion/MountWizzard4/files/5400869/Horizon.txt)

to 2: great. Looking forward to 👍

Cheers
Ruediger

mworion, 2020-10-19:
Had a look to the file. Everything is OK. I just draw the pink line to far. This is changed now. There were no points.
Michel

Ruediger3, 2020-10-19:
Hi Michel,

thanks for checking. 👍

mworion, 2020-10-19:
0.170.5 in online which should correct the graphics (and remove unnecessary logging in some areas)

Ruediger3, 2020-10-20:
Hi Michel,

installed and drawing is now OK. Thanks!
We should keep this issue open, until polar diagram is implemented.

Cheers
Rüdiger

mworion, 2020-10-25:
Rüdiger,

should be OK. I will not implement all visuals from Alt/Az diagram to polar.

Michel

Ruediger3, 2020-10-25:
Hi Michel,

looks really good. It helps a lot to get a realistic impression of the points' distribution at the sky. Great!
Thanks a lot!

Issue closed :)

Ruediger3, 2020-10-25:
PS: It has just helped me to identify 3 "blind" spots in the model :) great feature.

Closed 2020-10-25.

Thread 73 (2020-10-18):

Can't run a sequence?

mads0100, 2020-10-18:
Attached as requested.  I can connect my gear, take an individual frame and platesolve it, but when I hit 'run' for model building it doesn't seem to do anything.  There is an error in the log that I don't understand.  Hopefully it helps.

Chris

Log attached.
[mw4-2020-10-10.log](https://github.com/mworion/MountWizzard4/files/5398373/mw4-2020-10-10.log)

mworion, 2020-10-19:
Hi Chris,

thanks for the log. Please update to 0.170.5, which is online now. One ASCOM error has now a workaround. After the last start of MW, the ASCOM driver acted correctly, but there was no try after.

Michel

mads0100, 2020-10-19:
Wilco.  Thank you!

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

mworion, 2020-11-01:
Closing it as long as there are no new feedback. Hope it's fixed now.
Michel

Closed 2020-11-01.

Thread 75 (2020-10-28):

Dome control no longer using offsets as per version 0.160

InFINNity-Deck, 2020-10-28:
Hi Michel,

today I tested version 0.160 and 0.190 and both do no longer use the scope offsets to properly calculate the dome position. I then reverted back to 0.152.0b4 and all worked well again. Could you please check what has happened?

Attached the log file of the runs I did today with various versions.

best wishes,
Nicolàs

[mw4-2020-10-28.log](https://github.com/mworion/MountWizzard4/files/5450796/mw4-2020-10-28.log)

mworion, 2020-10-31:
Nicolas,
you are right. I really don't know what happened. I get back now to 0.152.0b4 make some tests and diff to actual version.
Will take some time.
Michel

InFINNity-Deck, 2020-10-31:
Hi Michel,

I just checked my log-files and saw that the last successful model I made was done with 0.152.0b6

Nicolàs

mworion, 2020-11-02:
Nicolas,
still search without success. If you would like, could you  send me a set of reference (based on you last excel) or send me the excel again, where I get 6-8 pairs of data (including the dome settings) for reference test.
Thanks in advance,
Michel

ACMBakx, 2020-11-02:
I tried to go back from 0.190 to 0.152 per Nicolas advice.
It seems to re-install the older version ok, but MW4 does not start up anymore.
It stops after a few seconds...........
Again installed 0.190 and no dome and no telescope moves anymore.
What is the proper way to get back to a operational version?

[mw4-2020-11-01.log](https://github.com/mworion/MountWizzard4/files/5476560/mw4-2020-11-01.log)

mworion, 2020-11-02:
Hi,
the config file structure changed from 0.160.0 on. To get an downgrade, please delete the "profile" and "config.cfg" file and start new. This show gives you MW4 running.
Michel

InFINNity-Deck, 2020-11-02:
Hi Michel,

I have something better now: an on-line calculator: http://www.dehilster.info/astronomy/dome_calculation.php
Will send you the REV06 of the manuscript separately.

Nicolàs

mworion, 2020-11-02:
Nicolas,
cool stuff.
Michel

mworion, 2020-11-02:
Nicolas,
0.190.4 should be back on track. The comparison gives me about the same numbers.
Michel

ACMBakx, 2020-11-02:
Txs Michel. I have it working again, apart from the keypad module.
But that's no problem.
I'll be waiting for confirmation before updating again.

mworion, 2020-11-02:
That's ok. If the keypad module does not work, please post the log. Currently up and downgrades might cause some problems as I change things until we have a real first release.
Michel

InFINNity-Deck, 2020-11-02:
Hi Michel,

the calculations work fine again, but it does not wait for the end-of-slew of the dome, nor is it taking in account the dome-settling-time. So mount slews fine, dome slews at the same time, but at a long dome-slew the camera starts integrating before dome-slew ends and even starts the next mount-slew before that long dome-slew ends.

Hopefully a minor issue to solve... ;-)

Nicolàs

mworion, 2020-11-02:
OK, that should be easier to find as really doing the math.
Thanks for countercheck.
Michel

mworion, 2020-11-03:
Nicolas,
I reviewed the whole story in all frameworks (INDI, ASCOM, ALPACA) and came to a common solution for dome slewing. In the simulators (as I don't own a dome) it work. I use the difference traget azimuth to actual azimuth to see if slewing finished. The tolerance is 1 degree. Your thoughts about it ?
Michel

mworion, 2020-11-03:
Nicolas,

0.191.0 is uploaded and should fix the slew (with the 1 degree tolerance)

Michel

InFINNity-Deck, 2020-11-03:
Hi Michel,

Thanks! My first opportunity to test it will be next Saturday.

Best wishes,
Nicolàs

⁣Get BlueMail for Android

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

mworion, 2020-12-15:
Hi Nicolas,

just for verification: Did you have an issue ?

Michel

InFINNity-Deck, 2020-12-15:
Hi Michel,

thanks for your e-mail, very kind that you contact me about it.

I discussed this with Arie a few days ago in a private conversation. It
is not a real issue for me, but it would probably save something like 4
or 5 minutes on a whole run as there are a few occasions (around due
east and due west) where the dome has to slew forward and backward 180
degrees (one such turn would take about 60 seconds and there are at
least two points where this happens, so four turns). My total run takes
about 35 minutes, so could be reduced to 30 minutes, not really
significant. The significant gain is between manual modelling without MW
(3 hours) and using MW (35 minutes)!

So, it is a nice-to-have feature, but certainly not a show-stopper.

with kind regards,
Nicolàs

Op 15-12-2020 om 13:59 schreef Michael:
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

--
Deze e-mail is gecontroleerd op virussen door AVG.
http://www.avg.com

mworion, 2020-12-15:
Than I put the point to the wish list and discussion with Arie, but closing the issue now.

ACMBakx, 2020-12-15:
Needless to say that I agree.

Arie

Verstuurd vanaf mijn iPad

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

Closed 2020-12-15.

Thread 79 (2020-11-05):

Feature Request: Support for ASCOM Observation Conditions Hub

Ruediger3, 2020-11-05:
Hello Michel,

since most of the environment sensors use COM interfaces they can only used by one application at a time.
There fore I can ether connect MW or Imaging SW to it - but never at the same time.
Since I use in NINA ASCOM observation condition hub to gather all information from different sources (E.g. MGPBox, SQM, UPP and online weather) it would be great, if I could connect this hub from MW too. So all resources could be used at the same time without any HW conflict.
Thanks

Cheers
Rüdiger

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

mworion, 2020-11-06:
Hi Rüdiger,
this is already done. You could select this hub for the use ins skymeter and sensor at the same time. There is no dedicated device for it, but if you set a device using this hub, the device driver grabs the necessary data from the hub.
Michel

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

Ruediger3, 2020-11-06:
Hi Michel,
I cannot select the ASCOM Hub under "Sensor". Only the MGPBox is shown. Probably because both both driver register as environment. Please see screenshot. Thx!

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

Ruediger3, 2020-11-06:
Got it. Classic case of PICNIC. Problem In Chair, Not In Computer :)
But it does not take all values: E.g. wind, rain, and more are not taken from HUB. But this is minor.

Thanks!

mworion, 2020-11-06:
Rüdiger,
the following steps:
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
The hub should be available for selection.
Michel

mworion, 2020-11-06:
Ok, good you got it.
Yes, the sensor is limited right now for the MBOX part, but as you tell it would make sense to tale the others as well if available. Think about it.

mworion, 2020-11-07:
should show now all field for sensor in 0.211.0

Ruediger3, 2020-11-07:
Hi Michel,

just checked with simulator and it works fine.
I will check with real sensor as soon as possible, since the gear is in the house due to bad weather. If there is any problem I will reopen the issue, though I think it works as expected.

Thank you very much for your great support!

CS
Rüdiger

Closed 2020-11-07.

Thread 80 (2020-11-07):

Tooltips wrong in Tools -> Mount move

Ruediger3, 2020-11-07:
Hi Michel,
some tool tips need correction....

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

Ruediger3, 2020-11-07:
Fix confirmed. Many thanks!

Cheers
Rüdiger

Closed 2020-11-07.

Thread 81 (2020-11-07):

Push satellites' data

Ruediger3, 2020-11-07:
Hi Michel,

is it planned to push also the satellite data to the mount analog to asteroids and comets?

Cheers
Rüdiger

mworion, 2020-11-07:
Hi Rüdiger,
different way: you could select and program directly a satellite (including viewing the path and starting track). So why downloading the database as MW4 could handle this remotely ?
Michel

Ruediger3, 2020-11-07:
Hi Michel,
yes, but when doing simple visual observing with some guests I use the hand pad only to operate the mount. No PC at all. It is even not wired. It would be nice if we could keep our mounts updated with MW as central tool.

Cheers
Rüdiger

mworion, 2020-11-15:
Rüdiger,
implemented, see 0.220.0

Ruediger3, 2020-11-15:
Hi Michel,

looks also very good and I will test it ASAP, but depends on the weather. Thank you very much!

Cheers
Rüdiger

Ruediger3, 2020-11-20:
Hi Michel,

just tested and it works, but the log window shows some warnings.
This is also coming with the other programming actions.

Cheers
Rüdiger

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

mworion, 2020-11-20:
Hi Rüdiger,
OK we are back to the problem of windows, which does a difference between 32 bit and 64 bit. Windows on the drivers side cannot mix 32 and 64 and this will stay in future. I did not check the updater base. But as you discovered it is 32 bit. So my recommendation (and I have to state this much more) to stay on windows on a 32 bit python version (also because not all ASCOM drivers support 64bit). I will check this this weekend and report back.
Michel

Ruediger3, 2020-11-20:
Hi Michel,
j.f.y.i.: all my applications (e.g. NINA) and as consequence all my ASCOM drivers are 64BIt or at least 32/64 Bit (e.g. ZWO) compatible,

Thanks for looking into it.

Cheers
Rüdiger

mworion, 2020-11-21:
Hi Rüdiger,
after some hours I seem to found a solution for that. I build a beta for you. This should work on 64bit python with the 32 bit updater. It works for upload automation a little bit slower, but it should work.
Michel

Ruediger3, 2020-11-21:
Hello Michel,
thanks a lot. Not sure you already built the Beta, but currently I do not see it.

Cheers
Rüdiger

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

mworion, 2020-11-21:
Rüdiger,

Made a release as the adjustments should be only in python64 is used. v0.220.1

Michel

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

Ruediger3, 2020-11-21:
Hi Michel,

true, this is extremely slow. There is a very high risk of accidental user interaction, which will make the update fail. Better to keep the error message, as long as it works.

The upload fails at following window:

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

Logfile attached.
[mw4-2020-11-21.log](https://github.com/mworion/MountWizzard4/files/5577812/mw4-2020-11-21.log)

mworion, 2020-11-21:
Rüdiger,
build 0.220.2 it gets not really simpler. The automation really give different Button labels for 32 and 64 bit. If 10micron changes their updater it might get a mess anyway. Let's see. There is hardly any chance to speedup or hide the windows.
I tried doing everything with 64bit.
Michel

Ruediger3, 2020-11-21:
Ok, now it finishes and is a bit faster. Don't spend too much time on it. It is minor, though very nice.
In worst case we can stay with 32. It throws some warnings, but works. Not nice, but who cares?

Cheers
Rüdiger

Closed 2020-11-15.

Thread 86 (2020-11-25):

Coordinates not in FITS Header

mworion, 2020-11-25:
Michel,

I have been learning to use MW4 and my mount. Thank you for providing such comprehensive software!

Unfortunately I have been unable to do a modeling run because the plate solve always fails.

After some experimentation, I think MW4 is not recognizing the

I’m using ASTAP as my solver. I can run ASTAP separately from MW4 and it solves previously saved images (from Ekos) very quickly (just a few seconds). But the images collected by MW4 don’t include coordinates in the FITS header and will not solve.

I can run ASTAP (separately from MW4) on the MW4 images and they don’t solve even if I allow up to a 60 degree search radius. If I provide approximate coordinates to stand-alone ASTAP the MW4 images solve right away.

Here’s an example of the MW4 image pane after I hit “Load FITS” on an image I saved from Ekos. Note that the FITS header coordinates are approximately correct in the left column. This image solves correctly (via ASTAP) in MW4 in just a few seconds.

==============

By contrast here’s a screen grab from the same panel on an image saved by MW4. Note that the FITS header lists the RA, DEC, rotation, and image scale as zeros. This image fails to solve either in MW4 or in stand-alone ASTAP.

I can solve this image just fine in Ekos in a second or so. If I provide the approximate coords found in Ekos as a first guess in stand-alone ASTAP it solves almost instantly.

It appears MW4 is not providing approximate coordinates to ASTAP as a first guess, and therefore ASTAP fails to solve every image in MW4.

Finally, here’s a link to the FITS file above which does not solve:
https://www.dropbox.com/s/z2swp0ho4i7ez8h/2020-11-25-05-27-10-exposure.fits?dl=0 <https://www.dropbox.com/s/z2swp0ho4i7ez8h/2020-11-25-05-27-10-exposure.fits?dl=0>

Perhaps I’ve forgotten a toggle or setting someplace despite reading the MW4 documentation carefully. If so I apologize for user error!

Best regards,
Scott

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

_Originally posted by @airscottdenning in https://github.com/mworion/MountWizzard4/issues/76#issuecomment-733750645_

mworion, 2020-11-25:
Hi Scott,
I moved this point to a new issue just for keeping the structure clean.
Please check in EKOS if the mount is really connected and has no warning signal. If there is a missing link, no coordinates will be embedded in images. It happens to me sometimes, too. If MW4 is the first application using the INDI server, please enable load configuration on startup under device menu for the telescope driver (should be set to 10micron) as well. Normally MW4 only uses this Indi driver for readout aperture and focal length settings you already did in the driver (MW4 does not use any driver for it's core functionality). But using it and forcing it to load config at startup mostly kicks the Indi server to correctly load the driver at the beginning.
If you still have an issue or better in any case, please set MW4 to deep debug mode:
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
make a trial and post the log files here. Then I could check, what's happening.
Michel

airscottdenning, 2020-11-26:
This issue is resolved. Probably user error. As you said, for some reason MW4 was not able to communicate properly with INDI. I was able to do a couple of successful modeling runs last night. Thank you for pointing out "Deep Debug" logging.

mworion, 2020-11-26:
Scott,

good to hear that you sorted it out.

Michel

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

Closed 2020-11-26.

Thread 90 (2020-12-02):

Override location settings (Enhancement)

fenriques, 2020-12-02:
I recently posted on the INDI github page about the 10micron driver not setting Site Longitude correctly: setting Longitude on a client like Ekos only transfer to the mount hh and mm. But not ss (seconds).
So each time the driver is connected to the mount it updates the site location on the mount and the correct value has to be entered again on the handpad.
With a mount like the 10micron setting exact site location is important as it affects guiding.

Jasem explained that the original lx200 driver specifications only provide the hh mm format, without seconds (strange enough to me that's not the case for Latitude which include seconds too).
Updating the driver specs could break compatibility with other devices.

It could be useful if MW4 stores the correct site location (including seconds) and, as an option, overrides the driver setting pushing a button.

Does any other 10micron owner experience the same behavior?
Ferrante

mworion, 2020-12-03:
Hi Ferrante,
Is there not a switch disabling the site location update to the mount from EKOS ?
Michel

fenriques, 2020-12-03:
hi Michel,
there's a 'Mount Updates Kstars' switch on the settings page of Kstars.
But even selecting that option, the INDI driver updates the mount not just when INDI server starts but also when a new location is set.
ferrante

mworion, 2020-12-07:
Hi Ferrante,

I would recommend to talk to Hans Lambermont (hans@lambermont.dyndns.org) and ask him about changing this behavior in the driver. He is the author of the original one and might be able to help. He is a very nice guy.

Michel

fenriques, 2020-12-08:
Thanks for the advice Michel,  I will write to him.
Ferrante

Closed 2020-12-08.

Thread 92 (2020-12-14):

3D printed cable brackets for 10Micron mount

airscottdenning, 2020-12-14:
Thank you very much for providing these. Generally very successful.

For the documentation: user will need two M6-32 x 16 mm screws to attach cable-holder-part1.stl to the mount, replacing the much too shallow screws that are removed from the mount housing.

A couple of minor comments:

* The T-bracket (cable-plate.stl) that you attach to your scope dovetail doesn't work for my setup and is likely only useful to you (specific to your scope, dovetail, and riser blocks). Requires a lot of vertical space between dovetail and scope and a particular hole pattern in the plate

* Cable holder parts 2 and 3 (cable-holder-part3.stl) are redundant. I prefer cable-holder-part2.stl because it fits better.

Probably no big deal for somebody printing their own parts, but I paid for two parts that I couldn't use from a commercial 3D print shop.

Thanks again!
Scott

mworion, 2020-12-15:
Scott,

 thanks for the feedback, I add you comments to the documentation !
-> readme on github and docs: [https://github.com/mworion/MountWizzard4/blob/master/docs/source/mechanics/cables.rst](url)

Michel

Ruediger3, 2020-12-15:
Hi Michel,
the provided link does not work for me :(
Greetings
Rüdiger

mworion, 2020-12-15:
Updated the link...

Closed 2020-12-15.

Thread 93 (2020-12-14):

Inconsistent Time & Location in indi_lx200_10micron

airscottdenning, 2020-12-14:
Hi Michel, I apologize for reporting this as a GitHub "issue." I don't have your contact info any other way.

I just [posted in the INDI forums about an inconsistency in time & location data between the indi_lx200_10micron driver and the 10Micron mount when using the MGPBox](https://indilib.org/forum/general/8391-inconsistent-time-location-in-indi-lx200-10micron-was-3-5-0-flip-failure.html). You had previously warned me about making certain there was only a single source of time & location data among the mount, GPS, driver, and imaging software.

I have been unable to enforce this except by completely disabling the MGPBox and setting time and location to "Kstars updates all devices" in Ekos. This is MUCH better for me than allowing the mount and INDI to fight over mount position, which leads to horrible tracking in DEC.

But I wanted to ask you for advice. Do YOU image with your 10Micron in KStars/Ekos? How do you *avoid* conflicts between the mount/MGPBox and INDI driver?

I'm pasting the text of my INDO Forum post below, but hopefully it's easy for you to see the images on their forum.

Please let me know if you'd rather I emailed you than reporting issues unrelated to MW4 here.

Scott

========

Inconsistent Time & Location in indi_lx200_10micron (was 3.5.0 Flip Failure) #64490

There appears to be a time and location conflict in the indi_lx200_10micron driver when the mount is updated from its own GPS (MGPBox), resulting in a range of bad behavior including failed meridian flips, bad pointing, and horrific tracking when the mount and INDI and KStars fight over precise geographic coordinates and time.

I build a mount model in separate software (ModelWizzard 4) that leads to incredibly precise pointing without KStars and 2-axis tracking using built-in encoders. But when doing production imaging in KStars I get horrible arcMINUTE-scale star trails as the mount and software fight over the time & location (see example images attached below).

The time mismatch between GPS/10Micron and Kstars frequently leads to failed meridian flips as the mount reaches a safety stop before KStars realizes it's time to flip.

Another symptom is that the reported geographic site position in the INDI driver doesn't retain arcseconds in geographic coordinates (for consistency with LX200?) but the GPS-reported coordinates in the mount keypad does. This was reported by fenriques in this thread. It may be that the arcseconds numbers are just not being reported in the GUI, but the rest of the symptoms suggest that the actual geographic coordinates are being *truncated* in the driver, resulting in the DEC thrashing I see in my subs (unless I just ignore the mount coordinates).

As Andrew points out in this thread , I can get pretty good results by just ignoring all the time & location info in the mount and GPS. To do this I have to turn off the MGPBox syncing in the mount hand controller set the geographic coordinates by hand, and set "KStars updates mount" in the Ekos settings. But I get nearly PERFECT results in TheSkyX by just trusting the mount to do its own thing and not trying to second-guess it in software.

This is a tough issue to diagnose because it involves the mount computer as well as the INDI driver and KStars/Ekos. I can save logs but not sure which logs are involved. Maybe I need to collect a mount log from the 10micron computer and report it to the vendor? But pretty sure this is cross-talk between INDI and 10Micron so hard to know what info to provide to whom.

Attached are two unguided 180-second subs of M74. Polar alignment is identical in these two unguided subs (well under 1 arc minute PA error). The first (with coordinates overlaid) shows INDI and the mount fighting over the time and location. The second shows good 2-axis tracking with all GPS info disabled. It gets even better (eccentricity under 0.3) when I use other software like TheSkyX that just leaves the mount alone to do its own thing. Everything I report here is for KStars 3.5.0 (regular ppa, not nightly) on ubuntu 20.04.1 running on R Pi 4.

This post is following up on three other related threads which I suspect are due to the same issue:

https://indilib.org/forum/general/8328-3-5-0-flip-failure-10micron.html

https://indilib.org/forum/general/7928-why-is-the-utc-time-in-kstars-ekos-different-from-my-mount.html?start=0

https://indilib.org/forum/general/7928-why-is-the-utc-time-in-kstars-ekos-different-from-my-mount.html?start=0

mworion, 2020-12-15:
Scott,

no problem. Ferrante already asked similar topics and I passed him to Hans Lambermont, who wrote the 10micron driver. He is a very nice guy and also very helpful. I think the best way is to add an option to the driver.

I will give him anyway a short notice that there might be some issues.

My personal experience so far: I do imaging with KStars/EKOS for 3 Years now. I also have a MGBox attached an used for boot time. I had some issues sometimes of unround stars (eccentricity of 0.6), but no elongated stars like you describe. But I could follow the changes the driver does, so the behaviour  is not correct and should be changed. But i will have a closer look to it the next days.

Michel

mworion, 2020-12-17:
Hi Scott,

did you check the settings in KStars/Ekos about which side updates the other ? I had set it to mount updates KStars. Does it work out for you ?

Michel

airscottdenning, 2020-12-17:
Hi Michel,

I have tried all the possible combinations in KStars/Ekos: I started with mount updates KStars. Then GPS updates KStars. Then KStars updates mount. Finally (at Jasem’s suggestion) nobody updates anything (uncheck both boxes).

Then I tried just switching to Windows and ASCOM and ModelCreator and TheSkyX, without *any* INDI drivers or Ekos in the mix.

But my mount still does these weird mini-slews in DEC that leave trailed stars.

I think there’s something wrong with my mount. I have submitted logs to 10Micron and I’m waiting to host a remote access session to help diagnose it.

Thank you very much for your suggestions!

Scott

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

mworion, 2020-12-18:
Closing this as I moved it to the new beta feature "discussions" on GitHub

Closed 2020-12-18.

Thread 100 (2020-12-19):

Direct Input and Slew to given RA/DEC and ALT/AZ

Ruediger3, 2020-12-19:
Hi Michel,

in addition to the other topics, I stumbled upon one use case. During modelling the horizon line, I had to use a couple of time the Virtual Hand Pad in order to enter ALT/AZ coordinated directly.

Therefore I think it would be a good idea to have the possibility to directly enter coordinates in two fields and a button to initiate the slew. Another filed good toggle the input reading between RA/DEC and ALT/AZ. So both use cases are covered with minimal loss of space, since only two input fields are required, one slew button and toggle switch.
The input of RA should be in "hh mm ss.s" and the DEC in d.d forma. ALT/AZ of course in ddd.d dd.d.

That would be the icy on the cake :)

Thank you for considering!

Cheers
Rüdiger

mworion, 2020-12-23:
Have a look to 0.220.6 and Merry Christmas!
Michel

Ruediger3, 2020-12-23:
Hi Michel,

marvelous! I have only 2 points. 1 Bug, 2 suggestions.
Bug: When trying to enter a ALT value it is not accepted.

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

Suggestion 1: Instead of opening the input window, it would be easier to enter the value directly in the field, and give the hint for the format via tool tip. By this the switching between mouse and keyboard would be minimized.

Suggestion 2: The activation order when jumping via Tab from field to field is wrong. Should be: Alt -> Az -> Slew Alt/Az, or RA -> DEC -> Slew RA/DEC

By suggestion one and two you can quickly work exclusively with keyboard (Tab, Numpad, and Enter). This would be much more fluent.

But anyway: Many thanks! what a nice gift.

Happy X-Mas! Stay safe and sound!

May greetings,
Rüdiger

mworion, 2020-12-23:
Update in 0.220.7

Ruediger3, 2020-12-23:
Almost perfect, except the RA/DEC slew button gets not active after values input and the h mm ss input is not converted to decimal if directly input (which is minor).

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

mworion, 2020-12-23:
...that's some work to do. Will happen after Christmas....

Ruediger3, 2020-12-23:
Perfect! Thank you!
Stay healthy and enjoy X-Mas!

Ruediger3, 2020-12-26:
Hello Michel,

One question: are the Re/Dec coordinates which you can enter J2000 or JNOW? It should be J2000.
Thanks!

Cheers
Rüdiger

mworion, 2020-12-26:
Rüdiger,
for me it has to be J2000 as the user can't do anything with JNow. I will convert them to JNow automatically
Michel

Ruediger3, 2020-12-26:
Right, I totally agree. Just want to make that sure, since I cannot test with this weather ;)
Thanks!

mworion, 2021-01-09:
Rüdiger,
Could you check if it is working ?
As I move to a first release, I just would like to collect feedback from all not closed issues.

Michel

Ruediger3, 2021-01-09:
Hi Michel,

not yet. Everything is snow covered and not a a single clear night, But since I had created the horizon limits with it and it was working (except tracking started) we should close this issue. If there is a problem, I will create a new one.

Cheers
Rüdiger

mworion, 2021-01-09:
The tracking issue should be addressed as well in the actual release. I will keep the status before (tracking or non tracking)

Closed 2021-01-09.

Thread 101 (2020-12-22):

Please update Ubuntu_Scripts for new version of MW4?

airscottdenning, 2020-12-22:
Setting up a new machine and these still point to old dependencies

mworion, 2020-12-23:
Scott,
quick question: you refer to ubuntu mate correct? All other script refer to the PyPi packet manager, which holds all dependencies.
Michel

mworion, 2020-12-23:
Scott,
made an update to actual dependencies. But we have to think about another way. As I have to precompile it normally for each python version 3.7 - 3.9 (actually only for python 3.8) and all changes done anyway on PyPi. An all I could do, run it on my physical RPi4 which only supports python 3.8 right now.
I asked the maintainer of the used packages to build wheels for aarm64 as well, but still not all do it.
Michel

airscottdenning, 2020-12-23:
Thank you for doing this!

I will try to update my MW4 today.

So appreciative of all you do with this software!

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

mworion, 2021-01-09:
Hi Scott,
how things going ? I learned, that some guy's doing automation for GitHub Actions might allow building for more that ubuntu, windows and macOS. If they succeed I could offer an automatic build for aarch64.
If there is nothing new about it, I would close this issue. For the release candidate which will be soon there, the imported libraries should be stable and I will update the scripts with actual precompiled packages again.
Michel

mworion, 2021-01-13:
Hi Scott,
I managed it to make an automatic build for the precompiled packages for arm64 architecture (e.g. RPi4) and I build some new scripts for installation. Would you mid once they are ready to test them in your setup. Right now I could support Ubuntu Mate 18.04.x and 20.04.x for python 3.7, 3.8 and 3.9.
Michel

airscottdenning, 2021-01-13:
Hi Michel,

I urge you to go ahead and close the issue.

Your Ubuntu script does ion fact run on my Pi4 under ubuntu aarch64 (I gave up on ubuntu-mate for a number of reasons), and is able to build/manage the mount model.

But the performance on the Pi4 is so laggy that I gave up and just bought an inexpensive linux amd64 box to run my astro-gear. Now I’m getting snappy performance not only with MW4 but also with FireCapture, which I could never get to run properly on the Pi.

Sorry to have taken your time and effort chasing the Pi. It worked fine for image capture (KStars etc) but is too slow for other astro-tasks.

Your contributions to the open-source astro community are wonderful, and I am deeply grateful!

Scott

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

mworion, 2021-01-13:
Scott,

don't worry. For my beside the astro imaging topic it's also a project to train sw-development. And arm will be in more an more computer anyway (might that some Mac users need it in future, too). Right now it's an automated build, I do not have to do anything manual to build the wheels and a user just need a script, that's all.
I close this topic.

Michel

BTW: I also have a fitlet intel base linux computer on my rig and everything is fine.

Closed 2021-01-13.

Thread 104 (2020-12-29):

Upload failures (asteroid, comets, satellites), "The filename, directory name, or volume label syntax is incorrect: ''

razvan-astro, 2020-12-29:
MW4 0.220.8, connected to the internet as well as over Ethernet to the mount (GM1000HPS, f/w 2.6.12). MW4 can communicate fine with the mount (I can see the position, time and so on). MW4 is installed in a writable location.

I attempted to update the mount with the latest data for satellites, comets/asteroids. MW4 downloads the data and prompts for confirmation ("Should ... database be programmed to the mount?"), then once I click Yes, nothing is displayed. The log reveals errors. The error is repeatable.

The stack trace is below, I will add the log and a preliminary investigation separately.

```
[2020-12-29 22:28:30.549][C][      loader.py][ 234] Logging an uncatched Exception
[2020-12-29 22:28:30.549][C][      loader.py][ 235]
[2020-12-29 22:28:30.549][C][      loader.py][ 237] Traceback (most recent call last):
[2020-12-29 22:28:30.549][C][      loader.py][ 237]   File "C:\apps\astro\MountWizard4\venv\Lib\site-packages\mw4\gui\mainWmixin\tabSatellite.py", line 674, in progSatellitesFull    suc = self.app.automation.uploadTLEData()
[2020-12-29 22:28:30.549][C][      loader.py][ 237]   File "C:\apps\astro\MountWizard4\venv\Lib\site-packages\mw4\logic\automation\automateWindows.py", line 467, in uploadTLEData    self.prepareUpdater()
[2020-12-29 22:28:30.549][C][      loader.py][ 237]   File "C:\apps\astro\MountWizard4\venv\Lib\site-packages\mw4\logic\automation\automateWindows.py", line 296, in prepareUpdater    os.chdir(os.path.dirname(self.installPath))
[2020-12-29 22:28:30.550][C][      loader.py][ 237] OSError: [WinError 123] The filename, directory name, or volume label syntax is incorrect: ''

```

razvan-astro, 2020-12-29:
The application log, with the startup and the attempt to upload the satellite info.

[mw4-2020-12-29.log](https://github.com/mworion/MountWizzard4/files/5752417/mw4-2020-12-29.log)

razvan-astro, 2020-12-29:
I've also run the Sysinternals Process Monitor to find out what is the problematic path. The file access log (CSV, but Github doesn't allow it directly) is attached.

Some observations:

- unrelated to the error, MW4 (or, more likely, an underlying library) constantly checks for a file named "@2x" in the current application directory. By constantly I mean every millisecond. The file doesn't exist. Not sure if intentional.

- the file doesn't show anything unusual with regards to file access (I've used the tool many time). I was hoping I'd see an incorrect path or something, but couldn't.

If there is anything I can assist with, please let me know.

[mw4 file acces log - satellite (rename as CSV).log](https://github.com/mworion/MountWizzard4/files/5752445/mw4.file.acces.log.-.satellite.rename.as.CSV.log)

razvan-astro, 2020-12-29:
And here's the similar error for the current comets.
```

2020-12-29 22:28:15.061][U][      loader.py][ 171] Click Tab     : [Satellite]
[2020-12-29 22:28:23.734][U][      loader.py][ 175] Click Button  : [progSatellitesFull]
[2020-12-29 22:28:30.062][U][      loader.py][ 175] Click Button  : []
[2020-12-29 22:28:30.062][U][      loader.py][ 185] Click Object  : [QMessageBoxClassWindow]
[2020-12-29 22:28:30.228][U][      loader.py][ 175] Click Button  : []
[2020-12-29 22:28:30.228][U][      loader.py][ 185] Click Object  : [QMessageBoxClassWindow]
[2020-12-29 22:28:30.235][U][     mainApp.py][ 458] Message window: [Program database:    [Active]]
[2020-12-29 22:28:30.236][U][     mainApp.py][ 458] Message window: [Exporting TLE data]
[2020-12-29 22:28:30.543][U][     mainApp.py][ 458] Message window: [Uploading TLE data to mount]
[2020-12-29 22:28:30.548][C][      loader.py][ 233]
[2020-12-29 22:28:30.549][C][      loader.py][ 234] Logging an uncatched Exception
[2020-12-29 22:28:30.549][C][      loader.py][ 235]
[2020-12-29 22:28:30.549][C][      loader.py][ 237] Traceback (most recent call last):
[2020-12-29 22:28:30.549][C][      loader.py][ 237]   File "C:\apps\astro\MountWizard4\venv\Lib\site-packages\mw4\gui\mainWmixin\tabSatellite.py", line 674, in progSatellitesFull    suc = self.app.automation.uploadTLEData()
[2020-12-29 22:28:30.549][C][      loader.py][ 237]   File "C:\apps\astro\MountWizard4\venv\Lib\site-packages\mw4\logic\automation\automateWindows.py", line 467, in uploadTLEData    self.prepareUpdater()
[2020-12-29 22:28:30.549][C][      loader.py][ 237]   File "C:\apps\astro\MountWizard4\venv\Lib\site-packages\mw4\logic\automation\automateWindows.py", line 296, in prepareUpdater    os.chdir(os.path.dirname(self.installPath))
[2020-12-29 22:28:30.550][C][      loader.py][ 237] OSError: [WinError 123] The filename, directory name, or volume label syntax is incorrect: ''
[2020-12-29 22:28:30.550][C][      loader.py][ 239]
```

razvan-astro, 2020-12-29:
I looked in a`utomateWindows.py` and I suspect the `os.chdir` is getting an empty string for `self.installPath`. In case the update history matters, I'm attaching the `update.log` file.

[update.log](https://github.com/mworion/MountWizzard4/files/5752466/update.log)

razvan-astro, 2020-12-29:
Getting closer. I looked in the code to see where `installPath` is taken from (from the registry) but under `HKEY_LOCAL_MACHINE\SOFTWARE\WOW6432Node\Microsoft\Windows\CurrentVersion\Uninstall`, I don't see any entry for MW4. Hence the empty string.

mworion, 2020-12-30:
Hi razvan,
MW4 would be not installed or found in the registry. I'm looking for the original 10micron QCI updater (GmQCIv2.exe) program.

Do you have installed it on the computer you are using for updating the data? (btw.: I have to add a log entry for this part). The search path is the best where to find it. I you have a setup, where this does not lead to a result, please let me know, I would like to check the registry entry for this to make it more robust. Otherwise I will offer a manual selection method.
Your are using a 64 bit python on your computer, which is for normal running fine. Only point: windows automation with 32bit programs (as the 10micron updater) is or ASCOM drivers does not work nicely), but this is not the current topic.

Last point: I really made a fault: there was no real routing telling the user that the updater was not found ! -> already done now.

If you could walk through the source code (btw: is it readable enough ?) I am missing one entry in the log:
[2020-12-30 09:01:06.046][D][automateWindows][ 102] QCI Updater settings: [(True, '10micron QCI control box updater', 'C:\\Program Files (x86)\\10micron\\Updater\\')]
which should be in in any case, because it has to be logged before you come to the point, where the exception occurs.
the exception is now handled correctly, should not happen in future.

Do you have a software tool in place, which might check if somebody accesses the registry ? And tries to avoid that.

Michel

razvan-astro, 2020-12-30:
Hi Michel,

Thanks for your quick reply. I've just updated MW4 with `mw4_update.bat` but did notice that afterwards, the log is still showing  0.220.8.  I have MW4 checked out into a different folder and noticed the changes you made in` automateWindows.py` (in the project) are not reflected in the installation folder at `C:\apps\astro\MountWizard4\venv\Lib\site-packages\mw4\logic\automation\automateWindows.py`

I will include the update.log in case you want to troubleshoot this.  [update.log](https://github.com/mworion/MountWizzard4/files/5754390/update.log)

I overwrote `automateWindows.py` manually and saw the following in the log. There was no message displayed on screen.

```
[2020-12-30 13:57:43.794][U][     mainApp.py][ 458] Message window: [Exporting TLE data]
[2020-12-30 13:57:43.969][U][     mainApp.py][ 458] Message window: [Uploading TLE data to mount]
[2020-12-30 13:57:43.969][E][automateWindows][ 312] No updater found:
[2020-12-30 13:57:43.969][E][automateWindows][ 493] error'NoneType' object is not subscriptable
[2020-12-30 13:57:43.969][U][     mainApp.py][ 458] Message window: [Uploading error]
[2020-12-30 13:57:43.969][U][     mainApp.py][ 458] Message window: [Programming success]
```

I tried again the updating data in the mount, here are my replies and findings:

I don't run anything that would interfere with registry access.

I do have the 10M updater, in `C:\apps\astro\10micron\Updater\GmQCIv2.exe` and have used it in the past. However, as you suspected, MW is not finding it. I checked the registry entries under `[HKEY_LOCAL_MACHINE\SOFTWARE\WOW6432Node\Microsoft\Windows\CurrentVersion\Uninstall]` and I do have a number of registry entries, I'll add some debugging statements a bit later to see MW is searching for. In the meantime, here's the dump of those registry entries (interestingly, also found 2 pointing to `Program Files (x86)` from when 10M support did some remote troubleshooting on my system.

```
[HKEY_LOCAL_MACHINE\SOFTWARE\WOW6432Node\Microsoft\Windows\CurrentVersion\Uninstall\10micron  Client_is1]
"Inno Setup: Setup Version"="5.5.6 (a)"
"Inno Setup: App Path"="C:\\apps\\astro\\10micron\\tle_manager"
"InstallLocation"="C:\\apps\\astro\\10micron\\tle_manager\\"
"Inno Setup: Icon Group"="10micron\\TLE Manager"
"Inno Setup: User"="r"
"Inno Setup: Language"="default"
"DisplayName"="10micron TLE Manager"
"UninstallString"="\"C:\\apps\\astro\\10micron\\tle_manager\\unins000.exe\""
"QuietUninstallString"="\"C:\\apps\\astro\\10micron\\tle_manager\\unins000.exe\" /SILENT"
"NoModify"=dword:00000001
"NoRepair"=dword:00000001
"InstallDate"="20201102"
"EstimatedSize"=dword:000049c7

[HKEY_LOCAL_MACHINE\SOFTWARE\WOW6432Node\Microsoft\Windows\CurrentVersion\Uninstall\10micron control box updater_is1]
"Inno Setup: Setup Version"="5.6.1 (a)"
"Inno Setup: App Path"="C:\\apps\\astro\\10micron\\Updater"
"InstallLocation"="C:\\apps\\astro\\10micron\\Updater\\"
"Inno Setup: Icon Group"="10micron\\Updater"
"Inno Setup: User"="r"
"Inno Setup: Selected Tasks"="desktopicon"
"Inno Setup: Deselected Tasks"=""
"Inno Setup: Language"="default"
"DisplayName"="10micron control box updater"
"UninstallString"="\"C:\\apps\\astro\\10micron\\Updater\\unins000.exe\""
"QuietUninstallString"="\"C:\\apps\\astro\\10micron\\Updater\\unins000.exe\" /SILENT"
"NoModify"=dword:00000001
"NoRepair"=dword:00000001
"InstallDate"="20201103"
"EstimatedSize"=dword:00005a4c

[HKEY_LOCAL_MACHINE\SOFTWARE\WOW6432Node\Microsoft\Windows\CurrentVersion\Uninstall\10Micron Mount Configurator_is1]
"Inno Setup: Setup Version"="5.5.6 (a)"
"Inno Setup: App Path"="C:\\apps\\astro\\10micron\\MountConfigurator"
"InstallLocation"="C:\\apps\\astro\\10micron\\MountConfigurator\\"
"Inno Setup: Icon Group"="10micron\\Mount Configurator"
"Inno Setup: User"="r"
"Inno Setup: Selected Tasks"="desktopicon"
"Inno Setup: Deselected Tasks"=""
"Inno Setup: Language"="english"
"DisplayName"="10Micron Mount Configurator 1.0.1.0"
"UninstallString"="\"C:\\Program Files (x86)\\10Micron\\MountConfigurator\\unins000.exe\""
"QuietUninstallString"="\"C:\\Program Files (x86)\\10Micron\\MountConfigurator\\unins000.exe\" /SILENT"
"DisplayVersion"="1.0.1.0"
"Publisher"="COMEC s.n.c."
"NoModify"=dword:00000001
"NoRepair"=dword:00000001
"InstallDate"="20201102"
"MajorVersion"=dword:00000001
"MinorVersion"=dword:00000000
"EstimatedSize"=dword:00000923

[HKEY_LOCAL_MACHINE\SOFTWARE\WOW6432Node\Microsoft\Windows\CurrentVersion\Uninstall\10micron Mount Logger_is1]
"Inno Setup: Setup Version"="5.5.6 (a)"
"Inno Setup: App Path"="C:\\apps\\astro\\10micron\\MountLog"
"InstallLocation"="C:\\apps\\astro\\10micron\\MountLog\\"
"Inno Setup: Icon Group"="10micron\\MountLog"
"Inno Setup: User"="r"
"Inno Setup: Selected Tasks"="desktopicon"
"Inno Setup: Deselected Tasks"=""
"Inno Setup: Language"="default"
"DisplayName"="10micron Mount Logger"
"UninstallString"="\"C:\\apps\\astro\\10micron\\MountLog\\unins000.exe\""
"QuietUninstallString"="\"C:\\apps\\astro\\10micron\\MountLog\\unins000.exe\" /SILENT"
"NoModify"=dword:00000001
"NoRepair"=dword:00000001
"InstallDate"="20201102"
"EstimatedSize"=dword:000007ad

[HKEY_LOCAL_MACHINE\SOFTWARE\WOW6432Node\Microsoft\Windows\CurrentVersion\Uninstall\10micron Mount Remote_is1]
"Inno Setup: Setup Version"="5.5.6 (a)"
"Inno Setup: App Path"="C:\\Program Files (x86)\\10micron\\MountRemote"
"InstallLocation"="C:\\Program Files (x86)\\10micron\\MountRemote\\"
"Inno Setup: Icon Group"="10micron\\MountRemote"
"Inno Setup: User"="r"
"Inno Setup: Language"="default"
"DisplayName"="10micron Mount Remote"
"UninstallString"="\"C:\\Program Files (x86)\\10micron\\MountRemote\\unins000.exe\""
"QuietUninstallString"="\"C:\\Program Files (x86)\\10micron\\MountRemote\\unins000.exe\" /SILENT"
"NoModify"=dword:00000001
"NoRepair"=dword:00000001
"InstallDate"="20201105"
"EstimatedSize"=dword:000053d8

[HKEY_LOCAL_MACHINE\SOFTWARE\WOW6432Node\Microsoft\Windows\CurrentVersion\Uninstall\10micron virtual keypad 2_is1]
"Inno Setup: Setup Version"="5.5.6 (a)"
"Inno Setup: App Path"="C:\\apps\\astro\\10micron\\VirtKP2"
"InstallLocation"="C:\\apps\\astro\\10micron\\VirtKP2\\"
"Inno Setup: Icon Group"="10micron\\Virtual Keypad 2"
"Inno Setup: User"="r"
"Inno Setup: Selected Tasks"="desktopicon"
"Inno Setup: Deselected Tasks"=""
"Inno Setup: Language"="default"
"DisplayName"="10micron virtual keypad 2.3"
"UninstallString"="\"C:\\apps\\astro\\10micron\\VirtKP2\\unins000.exe\""
"QuietUninstallString"="\"C:\\apps\\astro\\10micron\\VirtKP2\\unins000.exe\" /SILENT"
"NoModify"=dword:00000001
"NoRepair"=dword:00000001
"InstallDate"="20201101"
"EstimatedSize"=dword:000007a6

```

I think we are getting really close.

Thanks again for the help,
Razvan

[mw4-2020-12-30.log](https://github.com/mworion/MountWizzard4/files/5754354/mw4-2020-12-30.log)

mworion, 2020-12-30:
Simple analyse:
your registry has:
"10micron control box updater" and display name for what I search for
mine has:
"10micron QCI control box updater"

this makes the difference. I do not know why, but now I could add this.
if you would like to install the latest (might be risky): open the venv with

venv/Scripts/activate

and do

pip in install https://github.com/mworion/MountWizzard4/archive/master.zip

it's easier. Next commit it should be improved:

Michel

razvan-astro, 2020-12-30:
Hi Michel,

I was just about to enter the same comment :-); I just noticed the same thing and replaced `val = self.getAppSettings('10micron QCI')` with `self.getAppSettings('10micron Updater')` in `__init__` but the result was the same. I'll do a bit more digging then install the latest.

It's possible that 10M changed their registry key in time, I got the mount just 2 months ago and directly installed the software that came with it.

razvan-astro, 2020-12-30:
Also tried with `val = self.getAppSettings('10micron control box updater')` but the updater was still not found . Will debug more. Log below in the meantime.

```
[2020-12-30 15:32:02.453][D][     obsSite.py][ 150] Loader dir:[C:\apps\astro\MountWizard4/data]
[2020-12-30 15:32:02.656][I][automateWindows][ 189] getNameKeyFromRegistry - appName = 10micron control box updater
[2020-12-30 15:32:03.265][D][ tabSettMisc.py][ 188] Package Alpha  : ['0.152.0a3', '0.152.0a2', '0.152.0a0', '0.150.26a1', '0.150.25a6', '0.135a4', '0.135a3', '0.135a1', '0.134a5', '0.134a3']
[2020-12-30 15:32:03.265][D][ tabSettMisc.py][ 189] Package Beta   : ['0.220.4b7', '0.220.4b6', '0.220.4b5', '0.220.4b4', '0.220.4b3', '0.220.4b2', '0.220.4b1', '0.220.3b1', '0.190.1b1', '0.190.1b0']
[2020-12-30 15:32:03.265][D][ tabSettMisc.py][ 190] Package Release: ['0.220.8', '0.220.7', '0.220.6', '0.220.5', '0.220.4', '0.220.3', '0.220.2', '0.220.1', '0.220.0', '0.211.0']
[2020-12-30 15:32:04.234][U][     mainApp.py][ 458] Message window: [Enabled device:      [camera]]
[2020-12-30 15:32:04.234][U][     mainApp.py][ 458] Message window: [Enabled device:      [focuser]]
[2020-12-30 15:32:04.234][U][     mainApp.py][ 458] Message window: [Enabled device:      [telescope]]
[2020-12-30 15:32:04.234][I][astrometryASTAP][ 312] ASTAP OK, app:C:\Program Files\astap/astap.exe index:C:\Program Files\astap/*.290
[2020-12-30 15:32:04.234][U][     mainApp.py][ 458] Message window: [ASTROMETRY found:    [ASTAP]]
[2020-12-30 15:32:04.234][U][     mainApp.py][ 458] Message window: [Enabled device:      [astrometry]]
[2020-12-30 15:32:07.916][D][    geometry.py][ 173] using [10micron GM1000HPS] geometry
[2020-12-30 15:32:08.361][U][     mainApp.py][ 458] Message window: [Model names refreshed]
[2020-12-30 15:32:09.358][U][     mainApp.py][ 458] Message window: [Align model data refreshed]
[2020-12-30 15:32:10.504][U][      loader.py][ 173] Click DropDown: [minorPlanetSource]
[2020-12-30 15:32:11.250][U][      loader.py][ 185] Click Object  : []
[2020-12-30 15:32:11.250][U][      loader.py][ 185] Click Object  : [QComboBoxPrivateContainerClassWindow]
[2020-12-30 15:32:11.313][U][      loader.py][ 171] Click Tab     : [Satellite]
[2020-12-30 15:32:12.578][U][      loader.py][ 175] Click Button  : [progSatellitesFull]
[2020-12-30 15:32:13.719][U][      loader.py][ 175] Click Button  : []
[2020-12-30 15:32:13.719][U][      loader.py][ 185] Click Object  : [QMessageBoxClassWindow]
[2020-12-30 15:32:13.812][U][      loader.py][ 175] Click Button  : []
[2020-12-30 15:32:13.812][U][      loader.py][ 185] Click Object  : [QMessageBoxClassWindow]
[2020-12-30 15:32:13.812][U][     mainApp.py][ 458] Message window: [Program database:    [Active]]
[2020-12-30 15:32:13.812][U][     mainApp.py][ 458] Message window: [Exporting TLE data]
[2020-12-30 15:32:14.017][U][     mainApp.py][ 458] Message window: [Uploading TLE data to mount]
[2020-12-30 15:32:14.017][E][automateWindows][ 317] No updater found:
[2020-12-30 15:32:14.017][E][automateWindows][ 498] error'NoneType' object is not subscriptable
[2020-12-30 15:32:14.017][U][     mainApp.py][ 458] Message window: [Uploading error]
[2020-12-30 15:32:14.017][U][     mainApp.py][ 458] Message window: [Programming success]
[2020-12-30 15:32:14.017][U][      loader.py][ 175] Click Button  : [progSatellitesFull]
```

mworion, 2020-12-30:
My update was not sufficient. At least to search for the strings.
Have to change a little more. Interesting that the changed string does not find the updater....

razvan-astro, 2020-12-30:
Give me a few minutes, I'll try yours as well. In the previous test I had merely changed the string in the existing file.

razvan-astro, 2020-12-30:
OK, I tried updating the direct update. Yeah, it was a bit risky :) It fails to start as it's missing the simulator_ui widget, I think. I'm also attaching the update log for reference.

[mw 0.230.0.log](https://github.com/mworion/MountWizzard4/files/5754736/mw.0.230.0.log)

```
C:\apps\astro\MountWizard4>MW4_Run.bat

C:\apps\astro\MountWizard4>venv\Scripts\activate   && SET QT_SCALE_FACTOR=1.5   && SET QT_FONT_DPI=96   && venv\Scripts\python.exe venv\Lib\site-packages\mw4\loader.py  1>>run.log
Traceback (most recent call last):
  File "venv\Lib\site-packages\mw4\loader.py", line 40, in <module>
    from mainApp import MountWizzard4
  File "C:\apps\astro\MountWizard4\venv\Lib\site-packages\mw4\mainApp.py", line 34, in <module>
    from gui.mainWindow.mainW import MainWindow
  File "C:\apps\astro\MountWizard4\venv\Lib\site-packages\mw4\gui\mainWindow\mainW.py", line 31, in <module>
    from gui.extWindows.simulatorW import SimulatorWindow
  File "C:\apps\astro\MountWizard4\venv\Lib\site-packages\mw4\gui\extWindows\simulatorW.py", line 30, in <module>
    from gui.widgets import simulator_ui
ImportError: cannot import name 'simulator_ui' from 'gui.widgets' (C:\apps\astro\MountWizard4\venv\Lib\site-packages\mw4\gui\widgets\__init__.py)
```

mworion, 2020-12-30:
I think it's better to make a clean beta build for you:

venv/Scripts/activate

and do

pip in install mountwizzard4==0.220.9b1

Michel

mworion, 2020-12-30:
Will be off for the next hour+

razvan-astro, 2020-12-30:
Thanks, I'll be away for the same as well. That tag was not found yet, I'll wait. Appreciate the support!

```
(venv) C:\apps\astro\MountWizard4>pip install mountwizzard4==0.220.9b1
ERROR: Could not find a version that satisfies the requirement mountwizzard4==0.220.9b1
ERROR: No matching distribution found for mountwizzard4==0.220.9b1
```

razvan-astro, 2020-12-30:
0.220.9b1 is visible now so I updated. This time, the 10M updater was found and started.

The updater didn't work, though; this error must be coming from the 10M updater itself. On the screen there's only a popup box saying it failed. The MW4 log contains more info (see below). I checked the file (`C:\apps\astro\10micron\Updater\satellites.tle`), it exists. I'll try a manual update.  This is a different problem though so you can close this particular ticket.

Thanks!

```
[2020-12-30 17:24:08.589][U][     mainApp.py][ 458] Message window: [Program database:    [Active]]
[2020-12-30 17:24:08.589][U][     mainApp.py][ 458] Message window: [Exporting TLE data]
[2020-12-30 17:24:08.823][U][     mainApp.py][ 458] Message window: [Uploading TLE data to mount]
[2020-12-30 17:24:08.823][I][automateWindows][ 286] Using 64Bit backend uia
[2020-12-30 17:24:33.552][E][automateWindows][ 385] error(-2147220992, None, (None, None, None, 0, None))
[2020-12-30 17:24:33.552][U][     mainApp.py][ 458] Message window: [Uploading error]
[2020-12-30 17:24:33.552][U][     mainApp.py][ 458] Message window: [Programming success]
[2020-12-30 17:24:33.552][U][      loader.py][ 175] Click Button  : [progSatellitesFull]

```

razvan-astro, 2020-12-30:
And some final comments. Updating comets and asteroids works. Updating satellites doesn't but it fails also when using the 10M Updater directly. `satellites.tle` looks ok inside (i.e. no data corruption) so I'll follow-up with 10M support in the new year.

razvan-astro, 2020-12-30:
And just in case there's a problem with `satellites.tle`, for the record, it's attached.
[satellites.zip](https://github.com/mworion/MountWizzard4/files/5755124/satellites.zip)

mworion, 2020-12-30:
Razvan,

for the satellites I would use the functionality of MW4 directly. You don't need the updated for a selected satellite to be programmed. This could be done via the command protocol directly.

Michel

razvan-astro, 2020-12-30:
Got it, thanks! This one worked correctly.

Closed 2020-12-30.

Thread 107 (2021-02-08):

Camera connecting without an issue but no images being taken/dowloading

SimonWalsh1000, 2021-02-08:
Hi Michel,

Sorry to bother you. I wasn't sure if this was the best place to raise this issue (its almost certainly some simple mistake I have made).

All of my gear connects to MW4 without a problem. I am doing so via ASCOM and my camera is an ASI1600mm pro. The problem is that when I run a model, the mount behaves properly but no image is taken - I can't work out if an image is taken and isn't downloaded or simply there is no exposure. I assume that because I am connected to the camera that my set up is correct. I couldn't find anything about this in the manual.

Do you have any suggestion?

Thanks for all your work,

Simon

mworion, 2021-02-08:
Hi Simon,
you're welcome. Could you post the log file here?. This would help to check possible issues.
Michel

SimonWalsh1000, 2021-02-09:
Hi Michel,

I think I may have some clear sky tonight abs will get a log to you.

Many thanks

Simon

mworion, 2021-02-09:
Hi Simon,
this is great. As I checked the problem might be the ASI ASCOM driver. Could you test as well, if you imaging software using the asi ASCOM driver works ok?. In my setup SGPro 3.x hangs as well before downloading the image as the driver does not report image ready after the exposure time. It would be interesting if that happens in other applications, too. But they have to use the ASI ASCOM driver.
Michel

SimonWalsh1000, 2021-02-13:
Hi Michel,

I have tried my ASI1600mm again and I no problem connecting but not images are displayed - the log file simply says it is exposing. The camera works fine in SGP - and I tried it with ModelCreator and it works fine. I am very keen to use MW4 because of the rich analytical tools.

Let me know what I might try.

Many thanks

Simon

mworion, 2021-02-13:
Simon,
could you explain a little bit about your win environment. Pleas post the .log file, because most of the information I need for a possible reproduce is in there.
Michel

SimonWalsh1000, 2021-02-13:
Is there an option to just take an image? In other words, some way for me to test this issue during the day?

mworion, 2021-02-13:
Yes, sure easy: please open the image window (button "Image"). There you could just press "Expose 1" to do an image.

SimonWalsh1000, 2021-02-14:
Hi Michel,

I tried another ASI camera and the exposure is working. Now all I need is a clear night to test everything together. I will keep you updated. Many thanks for your ongoing support.

Best,
Simon

mworion, 2021-02-14:
Simon,

Sounds strange. As I think of buying a ASI, could you tell which one is working an which on causes troubles ?

Michel

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

mworion, 2021-02-16:
Simon,
did you use binning in your setup ? If yes, your topic might be related to Aries one #111. And should be solved in v1.0.3. If you would like, try update to v1.0.3 later and test again.

SimonWalsh1000, 2021-02-18:
Hi Michel,

I am testing this now. Incidentally, does MW4 support QHY cameras?

Simon

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

--

SLFWalsh MD MRCP FFRRCSI
Consultant Radiologist,
NIHR Clinician Scientist,
National Heart and Lung Institute,
Imperial College, London

Associate Editor, European Respiratory Journal
http://erj.ersjournals.com

mworion, 2021-02-19:
Hi Simon,
MW4 supports (or at least should) all cameras which have a ASCOM, INDI or INDIGO driver. So QHY should be not different. Sometimes the driver implementation (like QSI) has some teaks, which causes in special cases troubles, but nothing heard about QHY.
Michel

PS: As soon (positive or negative) you have tried QHY, please send me a log (ideally in debug trace mode) that I can look into it.

Closed 2021-03-06.

Thread 109 (2021-02-13):

Feature suggestion: clock sync mount -> computer

razvan-astro, 2021-02-13:
Hi Michel,

I would like to suggest a feature that would be helpful, I think, to users having mounts sync'ed with a GPS unit such as MGBox.  When using a computer in the field, the user may notice the computer time is not correct but without internet it's not possible to use NTP to correct the clock. Although the mount will operate correctly, it'd be convenient for the computer to have the same time.

Thus, my suggestion is to add a button to sync the computer time based on the return of either #GLDT# (local time) or #GUDT#.  Using the latter will be more correct if MW4 can read the time zone from the computer and calculate the offset. Or, for simplicity, assume the computer and the mount are already set to the same time zone and using the local time  (although this assumption, like many assumptions, might create some problems). You'll know better which is appropriate.

10Micron has a utility to sync the time from the computer to the mount, but I'm asking about the reverse. Also, with MGBox it's possible to connect it to the computer over USB and sync and connect it back to the mount, but that's extra hassle.

Thanks for considering it.

mworion, 2021-02-13:
Hi Razvan,

a topic to think about as MW4 does use the timebase of the mount anyway for all computations. Question: how precise you would like two have the time synced ? Easy: just write the received time from mount to computer as well. This is about 100-200 ms real difference depending on the round trip time for everything. This would increase complexity and was the reason not to implement the sync option 10micron has in MW4 as well.

What do you think ?
Michel

Ruediger3, 2021-02-13:
Hi Michael, Hi Razvan,

if you have a strtum1 clock connected, like a GPS receiver, you get down to 1-2 ms preciseness.
But therefore some modification of Windows registry is required in order to switch windows in high precision mode.
I have done that and sync the mount every second. Result dramatic less problems.

Please see also Microsoft's writing on that: Microsoft time modes and configuration:
https://docs.microsoft.com/de-de/windows-server/networking/windows-time-service/windows-time-service-top

Note: Can be switched to English reading on top right "Auf Englisch lesen"

razvan-astro, 2021-02-13:
Hi Michel and Rüdiger,

The use case I had in mind was a one-time sync, triggered by the user by clicking a button, upon noticing the computer clock is off (which means it's really off, not just by fractions of seconds). For instance, if the telescope is controlled by a NUC with a bad internal clock battery - when the NUC is booted up, the clock can be off by days or even more and without an internet connection, it requires manual setup every time (while powered on, the clock is ok).

I wasn't thinking of a high precision sync nor of a periodic one, just a one-time correction of the clock. In this case, having a difference of 100-200ms is ok since the computer clock is not used for anything else requiring more precision and it's higher than what the user would obtain manually anyway. To avoid confusion, this option could be named "Set clock from mount" instead of "sync clock" which sort of implies higher precision or periodic corrections.

mworion, 2021-02-13:
Razvan,

I do a really simple push to computer. Please take into account that time setting has to be allowed from user side. Otherwise we start with a mess about password etc...

Michel

razvan-astro, 2021-02-13:
Sure, that'd be great. And again, I'm not suggestion anything automatic, just a button for the user to click on.

Thank you.

Ruediger3, 2021-02-13:
Hi Razvan,

I only jumped in because I had the same controversy with 10M a while ago. It turned out that the precision modes of Windows and also Linux was not really know by 10M support.

Basically it is a very clever idea to synchronize to a local GPS since this is one one the best time clocks you can get. And I totally agree on that this is the best time source when you are mobile or offline. For sure!

Cheers
Rüdiger

mworion, 2021-02-20:
Available in v1.1.0b0 beta. Please reopen if problems occur.

razvan-astro, 2021-02-20:
Thanks Michel, that was fast!

Closed 2021-02-20.

Thread 111 (2021-02-13):

Subframe selection causes MW4 in a loop

ACMBakx, 2021-02-13:
[mw4-log%model.zip](https://github.com/mworion/MountWizzard4/files/5976282/mw4-log.model.zip)

Yesterday tested MW4 again.
Pointed at Betelgeuse with MW4 and with HC.
You have seen the result.
Did PA with the HC procedure and MC for a light model.
Next went back into MW4 to run a 75pts model.
To decrease the downloadtime I selected at subframe 90% to start with.
When I took a single image to check the downloadtime with this setting, MW4 got in a loop and continued to take images.
No response from cancel or bluntly starting the model run.
I had to quit MW4.
Restarted MW4 and started the modelrun with subframe at 100%.
Now ASTAP refused to solve any image.
Strange, because platesolve of a single frame did work, with ASTAP.
I did not change any settings.
Restarted the modelrun. Again ASTAP could not solve.
I then ran update.bat which installed a newer version.
Now MW4 modelbuilding did work correctly and build a nice model.
This problem with "subframe" has occurred before.
I cannot find it back in the attached log. I am sure you can.
I also attach the model that I custom build to accommodate my dome.
It should show the path I take. Top row first and then row after row zig-zag downwards.
Then the other side same. Like this the dome makes only small slews between points.

Best regards
Arie

mworion, 2021-02-13:
Arie,
Thanks for the report and the log files. I take care of it. Right now I try to get some images taken as the weather is fine.
Michel

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

mworion, 2021-02-16:
Hi Arie,
good news. After your first event, I added some logging. Now with the extended log I found the issue: I calculate the width / height and start position x,y for the subframe. This was done correct. When linked with binning, the spec says I have to calculate this in binned values -> also correct. Problem was the order of the commands: I set the binned mode at last and I had to do it at the beginning. So the camera driver saw a value, which was out of range and crashed. This also cause the loop.
At least that's my conclusion.
v1.0.3 will fix this point and will be released after test runs this evening.
Michel

Closed 2021-03-16.

Thread 114 (2021-02-17):

Feature suggestion: emergency stop hotkey

razvan-astro, 2021-02-17:
Consider this scenario: the user is running the model building and realizes the OTA is about to hit a tripod leg (possible with refractors with extension tubes), such as when the altitude of the model point was more than it should have been. Or a cable got caught during slewing. Things can happen, especially after a period in which everything has been fine.

There is no time to switch to the Mount tab and move the cursor to the Mount Stop button (particularly when using a touch pad instead of a mouse). What would be nice is to have a hot key (F12? being the rightmost one) issuing the :STOP# command, much like the button itself.  If this hot key is available in any screen, it'd be much faster to access.

Thanks for considering it and, as always, for the entire MW4 itself.

mworion, 2021-02-18:
Razvan,
what about opening the Keypad window as you have there the Stop button as well ?
Michel

razvan-astro, 2021-02-18:
Hi Michel,

Speaking purely from a user standpoint, I'm afraid that would be too slow for an emergency stop - it requires a few seconds. I'm on a different computer now so don't remember exactly, but I think that opening the key pad from within MW4 requires navigating to a certain screen, then opening the virtual keypad then pressing Stop or hitting F3.

But you gave me an idea: I can leave the virtual keypad open in another window and in an emergency, alt-tab to it then press F3 (the key assigned to Stop in that app). At least it doesn't require touchpad interaction which is the slowest link in the chain.

Again, from a selfish viewpoint of a user, an emergency stop hotkey available everywhere in the app would be better. Then, it doesn't matter whether it's model building, satellite tracking or something else. If something's wrong, one key press is enough. No need to navigate or wait for another app.

Of course, I'm grateful for all the time you've put into MW4 and you'll decide what to do with this suggestion, it was just an idea that crossed my mind.

Thanks.

mworion, 2021-02-18:
Razvan,
the way I would go now is to enable a „virtual“ pushbutton on the time widget as second stop button. I will highlight the frame in red when enabled, so that everybody know that something happens and it could be pressed.
Michel

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

razvan-astro, 2021-02-18:
Much appreciated and hopefully it saves someone's equipment one day!

mworion, 2021-02-20:
Available in v1.1.0b0 beta. Please reopen if problems occur.

razvan-astro, 2021-02-20:
Thanks, Michel!

Closed 2021-02-20.

Thread 121 (2021-02-24):

mountwizzard4 v1.0.5 is broken on pypi

IslamAlam, 2021-02-24:
Hi @mworion,

The mountwizzard4 is broken on ARM (Jetson Nano) devices due to the issue with NumPy library 1.19.3

https://pypi.org/project/mountwizzard4/1.0.5/

This is the current error:
```
(venv) astronomer@jetson-observatory:~/mountwizzard4$ python ./venv/lib/python3.8/site-packages/mw4/loader.py
RuntimeError: module compiled against API version 0xe but this version of numpy is 0xd
Traceback (most recent call last):
  File "./venv/lib/python3.8/site-packages/mw4/loader.py", line 36, in <module>
    import matplotlib
  File "/home/astronomer/mountwizzard4/venv/lib/python3.8/site-packages/matplotlib/__init__.py", line 174, in <module>
    _check_versions()
  File "/home/astronomer/mountwizzard4/venv/lib/python3.8/site-packages/matplotlib/__init__.py", line 159, in _check_versions
    from . import ft2font
ImportError: numpy.core.multiarray failed to import
```

To resolve it on the installation, consider forcing the upgrade of NumPy as the following:

`pip uninstall numpy && pip install numpy==1.20.1`

mworion, 2021-02-24:
HI @IslamAlam,

I do not see that MW4 is broken on PyPI. MW4 supports aarch64, if you build your packages yourself. Sometimes PyPi does not provide these packages for ARM. Your problem is related to numpy and matplotlib and knows in some other use cases, too. There is no way to solve this within MW4 purely. If you have a procedure to overcome this issue with a script or description, I'm pleased to add this to the documentation for your Nvidia board.

Michel

Closed 2021-03-18.

Thread 125 (2021-02-27):

Connection QHY cameras

mworion, 2021-02-27:
Today I am trying to set up another camera, a QHYCCD. I noticed that MW4 cannot connected to QHY camera or filter wheel. I selected QHY camera in ASCOM as normal but once set up it won't connect and throw off error. Before & after MW4 error, I tried QHY ascom connection via other program (skyX and Voyager) and they both recognize the camera & filterwheel fine and connected fine. Attached please find the related logbook (I tried a few times, so a few repeated error messages..). My current QHY driver is at v20.06.26.36. Do you have any clue what might be wrong with QHY camera connection within MW4?

ASCOM connection error
[mw4-2021-02-27.log](https://github.com/mworion/MountWizzard4/files/6054297/mw4-2021-02-27.log)

mworion, 2021-02-27:
Still the QCI updater is not found (so upload functions might not work with MW4 automation)
The QHY topic is related that MW4 could not connect to the ASCOm driver.

- do you use 64bit versions of voyager and tsx?
- is the QHY driver a 32bit or 64bit driver?

yzhzhang, 2021-02-28:
Hi Michel,

The driver seems to be 32bit but I am not sure. Voyager I think is for sure 32bit; SkyX I think so too. My operating system is 64bit.

Today with some luck (powering off / on the camera a bit) I for once was able to get the camera only connected to MW4 (didn't bother with filter wheel). However once I start a single exposure, the message window showed it start exposing, but then it crashes and it throws an error message something like "Python stopped working". I think it happened right after I click the "expose", so one example is 2-28 03:00:46 in the attached log.
[mw4-2021-02-28.log](https://github.com/mworion/MountWizzard4/files/6057859/mw4-2021-02-28.log)

After that MW4 is not able to find the camera, even though I can still see from other softwares in ASCOM camera selection menu. In MW4 when selecting the camera I am getting this error message; noted that in the red box where you select the camera, it used to have the complete serial number of my QHY16200 camera (and I still see that in other programs); but now it doesn't show fully, and when selecting this camera option, it throw error below:
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

The detailed error message is copied below.
See the end of this message for details on invoking
just-in-time (JIT) debugging instead of this dialog box.

************** Exception Text **************
System.AccessViolationException: Attempted to read or write protected memory. This is often an indication that other memory is corrupt.
   at ASCOM.QHYCCD.libqhyccd.OpenQHYCCD(StringBuilder id)
   at ASCOM.QHYCCD.SetupDialogForm.QueryCamProperties()
   at ASCOM.QHYCCD.SetupDialogForm.coboCamereName_SelectedIndexChanged(Object sender, EventArgs e)
   at System.Windows.Forms.ComboBox.OnSelectedIndexChanged(EventArgs e)
   at System.Windows.Forms.ComboBox.WmReflectCommand(Message& m)
   at System.Windows.Forms.ComboBox.WndProc(Message& m)
   at System.Windows.Forms.Control.ControlNativeWindow.OnMessage(Message& m)
   at System.Windows.Forms.Control.ControlNativeWindow.WndProc(Message& m)
   at System.Windows.Forms.NativeWindow.Callback(IntPtr hWnd, Int32 msg, IntPtr wparam, IntPtr lparam)

************** Loaded Assemblies **************
mscorlib
    Assembly Version: 2.0.0.0
    Win32 Version: 2.0.50727.9151 (WinRelRS6.050727-9100)
    CodeBase: file:///C:/Windows/Microsoft.NET/Framework/v2.0.50727/mscorlib.dll
----------------------------------------
ASCOM.Utilities
    Assembly Version: 6.0.0.0
    Win32 Version: 6.5.1.3234
    CodeBase: file:///C:/WINDOWS/assembly/GAC_MSIL/ASCOM.Utilities/6.0.0.0__565de7938946fba7/ASCOM.Utilities.dll
----------------------------------------
System
    Assembly Version: 2.0.0.0
    Win32 Version: 2.0.50727.9149 (WinRelRS6.050727-9100)
    CodeBase: file:///C:/WINDOWS/assembly/GAC_MSIL/System/2.0.0.0__b77a5c561934e089/System.dll
----------------------------------------
System.Core
    Assembly Version: 3.5.0.0
    Win32 Version: 3.5.30729.9141 built by: WinRelRS6
    CodeBase: file:///C:/WINDOWS/assembly/GAC_MSIL/System.Core/3.5.0.0__b77a5c561934e089/System.Core.dll
----------------------------------------
Microsoft.VisualBasic
    Assembly Version: 8.0.0.0
    Win32 Version: 8.0.50727.9149 (WinRelRS6.050727-9100)
    CodeBase: file:///C:/WINDOWS/assembly/GAC_MSIL/Microsoft.VisualBasic/8.0.0.0__b03f5f7f11d50a3a/Microsoft.VisualBasic.dll
----------------------------------------
System.Windows.Forms
    Assembly Version: 2.0.0.0
    Win32 Version: 2.0.50727.9149 (WinRelRS6.050727-9100)
    CodeBase: file:///C:/WINDOWS/assembly/GAC_MSIL/System.Windows.Forms/2.0.0.0__b77a5c561934e089/System.Windows.Forms.dll
----------------------------------------
System.Drawing
    Assembly Version: 2.0.0.0
    Win32 Version: 2.0.50727.9149 (WinRelRS6.050727-9100)
    CodeBase: file:///C:/WINDOWS/assembly/GAC_MSIL/System.Drawing/2.0.0.0__b03f5f7f11d50a3a/System.Drawing.dll
----------------------------------------
Accessibility
    Assembly Version: 2.0.0.0
    Win32 Version: 2.0.50727.9149 (WinRelRS6.050727-9100)
    CodeBase: file:///C:/WINDOWS/assembly/GAC_MSIL/Accessibility/2.0.0.0__b03f5f7f11d50a3a/Accessibility.dll
----------------------------------------
ASCOM.Exceptions
    Assembly Version: 6.0.0.0
    Win32 Version: 6.5.1.3234
    CodeBase: file:///C:/WINDOWS/assembly/GAC_MSIL/ASCOM.Exceptions/6.0.0.0__565de7938946fba7/ASCOM.Exceptions.dll
----------------------------------------
ASCOM.QHYCCD.Camera
    Assembly Version: 21.2.20.12
    Win32 Version: 21.02.20.12
    CodeBase: file:///C:/Program%20Files%20(x86)/Common%20Files/ASCOM/Camera/ASCOM.QHYCCD.Camera.DLL
----------------------------------------
ASCOM.DeviceInterfaces
    Assembly Version: 6.0.0.0
    Win32 Version: 6.5.1.3234
    CodeBase: file:///C:/WINDOWS/assembly/GAC_MSIL/ASCOM.DeviceInterfaces/6.0.0.0__565de7938946fba7/ASCOM.DeviceInterfaces.dll
----------------------------------------
System.Configuration
    Assembly Version: 2.0.0.0
    Win32 Version: 2.0.50727.9153 (WinRelRS6.050727-9100)
    CodeBase: file:///C:/WINDOWS/assembly/GAC_MSIL/System.Configuration/2.0.0.0__b03f5f7f11d50a3a/System.Configuration.dll
----------------------------------------
System.Xml
    Assembly Version: 2.0.0.0
    Win32 Version: 2.0.50727.9149 (WinRelRS6.050727-9100)
    CodeBase: file:///C:/WINDOWS/assembly/GAC_MSIL/System.Xml/2.0.0.0__b77a5c561934e089/System.Xml.dll
----------------------------------------

************** JIT Debugging **************
To enable just-in-time (JIT) debugging, the .config file for this
application or computer (machine.config) must have the
jitDebugging value set in the system.windows.forms section.
The application must also be compiled with debugging
enabled.

For example:

<configuration>
    <system.windows.forms jitDebugging="true" />
</configuration>

When JIT debugging is enabled, any unhandled exception
will be sent to the JIT debugger registered on the computer
rather than be handled by this dialog box.

mworion, 2021-03-06:
Just a ping: no clue so far

mworion, 2021-05-14:
Please have a look to [https://www.10micron.eu/forum/viewtopic.php?f=18&p=12796#p12796](url) as it might be a solution for your problem , too. If not, please try to test with newest version and reopen.

Michel

Closed 2021-05-14.

Thread 126 (2021-02-27):

1.1.0b2: Satellite update fails

Ruediger3, 2021-02-27:
Hi Michel,

just tried to update satellite data but it fails. Log attached.
The "file open" dialog stays open. It seams the file is missing or named differently.
Thank you!

Cheers Rüdiger

[mw4-2021-02-27.zip](https://github.com/mworion/MountWizzard4/files/6054370/mw4-2021-02-27.zip)

mworion, 2021-02-27:
Hi Rüdiger,
the zip is on 22 Byte. Nothing in it ?
Michel

Ruediger3, 2021-02-27:
I have chosen to update the "Acive" satellites. Wrong?

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
.

mworion, 2021-02-27:
No, should be OK. In my setup I have no problem doing that. As the zip does not contain a log, could you resend it ?

Ruediger3, 2021-02-27:
Sorry, I have misunderstood that. Thought you mean Satellite DB.
Just found out that 7ZIP cannot pack the log until
 it is opened. Please find it attached.  Thanks!

[mw4-2021-02-27.zip](https://github.com/mworion/MountWizzard4/files/6054892/mw4-2021-02-27.zip)

mworion, 2021-02-27:
Rüdiger,
do you user the 3.0 installer ?
Michel

Ruediger3, 2021-02-27:
No, still on 2.16.24.

mworion, 2021-02-28:
Hi Rüdiger,
no chance to reproduce the in my environment. Not with the 3.0 updater neither with the 2.16.11 / 13 updater. It works with me on 32 and 64 bit. I guessed it worked already fo you. This part of the code is unchanged since then. As setup might change even with windows version, automation is a bad for doing it. MW4 does anyway store the file in the directory, son manually doing thing work. There will be at some point in time an update of the used package. We'll see if situation on 64bit also in speed improves.
Sorry to say.
Michel

Ruediger3, 2021-02-28:
Hi Michel,

just retested and it failed again. The file is there. It is downloaded and up-to-date, but MW fails to fill out the file name in the dialogue. Also the message in the log window is confusing. It sais Uploading failed, programming success. Please see screenshot.

Rüdiger

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

Ruediger3, 2021-03-07:
Hi Michel,
just tested with 10M Updater FW3 and it fails in the same way.

Cheers
Rüdiger

Ruediger3, 2021-03-07:
Currently using 1.1.04b

mworion, 2021-03-12:
I see the problem as the dict, which is generated by the automation package does not contain the referenced key as needed, but I could not setup any environment, which causes this problem.
Questions: Which windows10, Language settings etc. It is something which is related the the windows setup.

mworion, 2021-03-27:
Corrected the message (should to state success anymore. Still open, because in my setup not reproducible the automation problem. I shift it to another milestone as I need an update of the automation package which the maintainer announced, but without any date.

Michel

Ruediger3, 2021-03-27:
Hi Michel,
sorry I have overseen your question before. I am using English language. b1 fails also.
The message attached below.

Cheers
Rüdiger

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

Ruediger3, 2021-03-27:
Addition info: Earth nutation and MPC files work fine. Only satellites do fail.
Updater 3.0.4 and MW b11.

Ruediger3, 2021-03-27:
There are also some error in the cmd window:

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

mworion, 2021-03-27:
Hi Rüdiger,
I did a refactor especially for the new updater. It's still slow, but give it a chance. There should be no difference between the three uploads now.
Michel

Ruediger3, 2021-03-27:
Hi Michel,

in b12 the error message is correct now.

I notice the file chooser dialog opens the wrong path. instead of opening the correct folder it opens the folder of the last manual update (for me T:\) . There of course it cannot find the file

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

mworion, 2021-03-27:
Rüdiger,
please check if you wait the automation should set the path in a first step before entering the file name. Actually the driver name is included as well in the string.
Second, please check is you last manual update if done from the drive, the updater is installed works.
Michel

Ruediger3, 2021-03-27:
1. I waited a couple of minutes and just retried. No path is set. It fails in the wrong path. Nor a filename is set.
2. Yes, I updated manually today. No problem at all.
3. Also when retrying and the correct path is opened, it fails. No file name is set.

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

[mw4-2021-03-27.zip](https://github.com/mworion/MountWizzard4/files/6216144/mw4-2021-03-27.zip)

mworion, 2021-03-28:
We are back to square one.
Whatever I do, I come back, that I need an update of the underlying library.
I released v1.1.0 (which is now the official release to your used beta) there is one fix in more than your latest beta.

Ruediger3, 2021-03-28:
Hi Michel, I have updated to 1.1.0 and the problem persists.

mworion, 2021-06-24:
Rüdiger,
could you give me a feedback, if this is still present in recent 2.0 beta versions ?. I did some small rework and I do not see issues in my setup(s).
Thanks in advance,
Michel

Ruediger3, 2021-06-24:
Hi Michel,
Thanks for the reminder. I have forgotten it. Infill do asap. Currently it is raining.

Rüdiger

Ruediger3, 2021-06-26:
Hi Michel,
the problem persists. I cannot program DB to mount. Updater 3.04 and MW 2.0.0b17

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
[mw4-2021-06-26.log](https://github.com/mworion/MountWizzard4/files/6720625/mw4-2021-06-26.log)

mworion, 2021-06-28:
Rüdiger,
still not solved, found i similar error message in the log. I would like to give you a test program to check the name, which is used in your environment.
Only point if you succeed: I do not know, how to distiguish between the environments to set it up.

Ruediger3, 2021-06-28:
Hi Michel,
Yes please provide the test prog. Thx!

Rüdiger

mworion, 2021-06-28:
Rüdiger,

if I start the updater right now, there is nothing anymore in, which could update TLE files ?

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

strange....
Is there anything I missed ?

Ruediger3, 2021-06-28:
Mine looks like this:

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

mworion, 2021-06-28:
Upload b18 with some more logging. Does not sort out the problem, but please run the TLE update with logging=Debug once and drop the log file.

The inspect file is a tool which runs in parallel to any GUI. please to the steps manual on updater and find the widget elements when selecting the file name input field. Please post a screenshot from this session. It might look like this:

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

[inspect.exe.zip](https://github.com/mworion/MountWizzard4/files/6728424/inspect.exe.zip)

Ruediger3, 2021-06-28:
Here we are (note: Mount is not connected, but this should be also ok. We have heavy thunderstorm rolling in):
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

Ruediger3, 2021-06-29:
Hi Michel,
just tried with attached mount with 18 and it failed completely. The file select dialog is not opening.Find log attached.

[mw4-2021-06-29.log](https://github.com/mworion/MountWizzard4/files/6731861/mw4-2021-06-29.log)

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

mworion, 2021-06-29:
Rüdiger,
you mentioned that MPC and Earth rotation works but not TLE. I found a small difference, which I adjusted. I upload b19 for a test. This could be a quick win.
Michel

Ruediger3, 2021-06-29:
Hi Michel,
just tested and no difference. Still failing at the same position. Files selection dialog is not opened. Sorry.

Rüdiger

Ruediger3, 2021-06-29:
**Important Update:**
I have tested out of curiosity the same on the NUC. This was working flawless! It tried to update the file. MW same version both Windows 10. One working, the other not.
So at least what you have done in b19 worked there. Now to find out what prevents it from working on the other machine. Maybe related to Python version?

Rüdiger

mworion, 2021-06-29:
Hi Rüdiger,
I don’t think it’s the Python Version, but there might be differences in language settings. The language version of the windows is different to the language setting itself. For example I have a English version of win10, but you could set it to German as well. Still it’s an English version and vice versa.
The automation framework searches for strings given to the widgets. These could be different for different language versions.
But anyway it would be interesting where all differences between those two are. This also might be relevant to other users.

Michel

Von meinem iPad gesendet

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

Ruediger3, 2021-06-29:
Hi Michel,
I use Win10 Pro EN with German localization, but English language.
Here is the screenshot of the NUC which is working:

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

mworion, 2021-06-30:
Rüdiger,
if you start python in the MW4 virtual environment (go to the work dir, venv/scrips/activate to get the "(venv)" prefix),
then:
```
        import ctypes
        import locale
        windll = ctypes.windll.kernel32
        print(locale.windows_locale[windll.GetUserDefaultUILanguage()])
        print(locale.getdefaultlocale())
```
Do you see any differences ?
Out of the rest, I have no clue why the platforms behave different.
Michel

Ruediger3, 2021-06-30:
Hi Michel,
can you please assist me. This does not work for me:

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

mworion, 2021-06-30:
Sorry my fault,

after starting venv, please run python and enter the commands from python console inside the terminal.

Michel

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

Ruediger3, 2021-06-30:
Here the output of the failing system:

```
>>> print(locale.windows_locale[windll.GetUserDefaultUILanguage()])
en_US
>>> print(locale.getdefaultlocale())
('de_DE', 'cp1252')
>>>
```

Output of the working machine:
` >>> print(locale.windows_locale[windll.GetUserDefaultUILanguage()])
en_US
>>> print(locale.getdefaultlocale())
('en_DE', 'cp1252')
>>>`

mworion, 2021-06-30:
Many thanks, is there a difference between the two machines ?

Von meinem iPad gesendet

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

mworion, 2021-06-30:
I meant there is also no difference.

Von meinem iPad gesendet

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

Ruediger3, 2021-06-30:
No, both machines are also on the same patch level: 20H2 Build 19042.1081.1
They are completely different hardware, but OS wise the are equal.

mworion, 2021-06-30:
No clue, but my setup is different but work also:
```
print(locale.windows_locale[windll.GetUserDefaultUILanguage()])
en_GB
print(locale.getdefaultlocale())
('en_GB', 'cp1252')
```
But you have two machines with the same settings, which behave different.

mworion, 2021-07-12:
Hi Rüdiger,
the only thing I could think of that the machine, which not works correctly (locale coding de_DE) is running a german GUI language, whereas the working machine does an english style (locale coding en_DE). Could you confirm this ?
Michel

Ruediger3, 2021-07-12:
Hi Michel,
I am sorry. Both run English GUI.

mworion, 2021-07-12:
OK give up.
I found a way to set the languages like your failing machine, but I could upload satellite data. Maybe there is a software installed, which adds some features for shortcuts or even I do not know.
Michel

Ruediger3, 2021-07-12:
Hi Michel,

I am not sure what has happened, but it is suddenly working. The complete path is typed into the file dialogue. Te only change was, I have updated from .18 to .21 on the non working machine.
Please do not ask why it is working now. I have just rebooted and tested again and it sill is working.
Let's be happy and close this issue.

Many thanks for your stamina and your kind support.

Cheers
Rüdiger

mworion, 2021-07-12:
Great that it works now.

mworion, 2021-08-04:
Hi Rüdiger,
despite the fact that you got it to run i made a change in windows automation for Razvan, who ran in the same issue like you.
v2.0.0b33 should fix that. Out of his observations the issues seems not to be linked to any language settings, but more to timing delays if you have larger menus (which could be only the case in Satellite, not in Comets uploads. etc). So this fix should address you issue as well.
Michel

Ruediger3, 2021-08-04:
Hi Michel,
I have followed the discussion with Razvan and already updated MW. Waiting for acceptable whether to test :)

Cheers
Rüdiger

Closed 2021-07-12.

Thread 127 (2021-02-27):

1.1.0b2: ASI Camera cooler not working

Ruediger3, 2021-02-27:
Hi Michel,
when switching cooler on nothing happens. But it worked before.
Camera: ASI 6200 ; Log attached.

Thanks
Rüdiger

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

[mw4-2021-02-27 - Copy.zip](https://github.com/mworion/MountWizzard4/files/6055009/mw4-2021-02-27.-.Copy.zip)

mworion, 2021-02-27:
Please go one beta back v1.1.0b1

I have cameras who do not tell that they have a cooler, but have one and the other way round. I have to sort this out.

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

mworion, 2021-02-27:
I think I found a basic topic in ASCOM and this should be covered in 1.1.0b3

Ruediger3, 2021-02-27:
Thanks Micheal. I have installed b3 and I will test it asap, since I am imaging right now and the camera is in use.
I will report back.
Rüdiger

Ruediger3, 2021-02-27:
Hi Michael,
tested and works again. Issue fixed. Thx!

Cheers
Rüdiger

Closed 2021-02-27.

Thread 133 (2021-03-17):

Solving during model building fails, v. 1.1.0b9

Ginge70, 2021-03-17:
Hi again!

Last night's agenda was to try model building for the first time now that MW4 is speaking with ASTAP and solving fits saved on my disk. In the beginning of the night I posted a question to the 10Micron forum as the solving bit of model building kept failing, however there were other things going wrong at the same time so I couldn't be sure what was what. Later the same night though, I had a new opportunity as clouds disappeared and tried another model build, but MW4 keep giving me error messages saying solving failed. I stopped the procedure and manually solved the picture in the MW4 imaging window that had just failed and it solved without problem. In another attempt that went pretty much the same way, I let the process run and when the solve failed I immediately solved the image manually in MW4 just to check that ASTAP was working. I might be reading the log incorrectly but to me it looks like ASTAP actually solves the image, but MW4 still considers it a failed attempt. Can you help? I was using INDIGO server in the beginning of the night, but after experiencing dropouts with connection to the ASI1600 I tried switching to INDI Server which worked better. Regarding the connection to the camera: I use USB2 because I have to transfer the signal over ethernet to the building next to the observatory. I normally have no connection dropouts, but trying to use high speed transfer from the camera doesn't work (in case this is a connection speed issue). I'm attaching the log of my last couple of model building attempts that also includes my manual solving checks mid-process.
[mw4-2021-03-17.log](https://github.com/mworion/MountWizzard4/files/6154672/mw4-2021-03-17.log)

Best regards,
Ginge

mworion, 2021-03-17:
Ginge,
sorry to hear, I will have a look to it tonight
Michel

mworion, 2021-03-17:
Ging, hard to tackle.
First: I see many timeouts to the mount. Do you use a wired connection ? I would recommend doing so and MW4 causes some traffic for the mount.
I uploaded v1.1.0b10 with some more logging as my test did not trigger the same topics as in your environment.
Michel

Ginge70, 2021-03-17:
That is also my thought. I'm connected to the mount via wifi and it is stretched to its limits, I'm afraid. The connection is sufficient for normal operation, but I can imagine it is not good enough when the signals start queueing up. I'll try moving closer and if that does'nt work, I'll connect to the mount by wire. Just a thought, would it help to extend the timeout setting for the ASTAP device if the wifi signal is weak?

I'll update to b10 now.

Thanks!!
Ginge

Ginge70, 2021-03-19:
I've read that USBc devices can sometimes interfere with wifi-connection. I have a USBc drive connected and sometimes I also have my phone connected to charge it. I suppose this is also an argument for trying the modelling while connected with a wire instead, just to be on the safe side.

g

mworion, 2021-03-19:
Hi Ginge,
I have an idea how to improve the ASTAP solution. In my environment (actually due to bad weather) EKOS Simulators, real mount I could see your fault under certain conditions ans solve it with the change. This has no impact to the situation of connectivity (wired, wireless)
I will upload a next beta (v1.1.0b11) this afternoon.
Michel

mworion, 2021-03-19:
In addition, could you tell me a little bit more about your system setup to be able to test MW4 in such a condition ?

Ginge70, 2021-03-19:
Absolutely. I connect to the ASI1600MM Pro with a USB3 cable going to a USB2 hub that in turn connects to a Startech USB Extender (https://www.startech.com/en-us/cards-adapters/usb2004ext2). On the other end I've hooked up my MacBook Pro (15 inch, 2017 running OSX 10.13.6) to the extrender with a Satechi usb-c multiport adapter (https://www.netonnet.no/art/lyd-bilde/kabler/usbhubadapter/satechi-usb-c-multi-port-adapter-4k-gigabit-ethernet-v2/1016782.11442/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). My Robofocus is also connected through the extender and a Keyspan serial adapter on the other end. The firmware on the GM2000 HPS is 2.15.1. After I got it working with the MGBox that is connected directly to the mount, I haven't dared updating the firmware to a newer version. I was about to update to v3.0 last night, but I need to read a bit more about it first so I don't mess up a perfectly good system. My Mac talks to the mount via a Airport, can't remember wether it is an extreme or an express as it sits in a waterproof box high on the outriggers of my ro/ro-roof outriggers. It is one of the flat square ones, - nothing fancy. Tell me if you need to know anything else. Oh yeah, I'm storing files on a LaCie Portable SSD USB-c disk, but the images taken by MW4 is of course stored in the Work folder residing on the desktop. I'm using TheSkyX for everything, have been sniffing out EKOS but the lack of many catalogues I often use has me sitting on the fence for now. Changing between TheSkyX and MW4 leads to certain things and I try to make sure not to have them both open at once, at least I quit INDI Server as that will result in strangeness together with TheSkyX. ANother weird thing is that the mount often switch slew speed to 03 when I switch between applications. Haven't pinpointed exactly when it happens or for what reasons. I cannot access the slew speed parameter from MW4 either so I need to change it back to faster rate from the hand control. I suppose this might be due to the fact that I'm hanging on to an older firmware. I'll update to a newer one if you tell me it is safe. Is v3 good, for instance? I've noticed someone complaining about DEC drift, but haven't read up on it yet.

Thanks for helping out!
Ginge

Ginge70, 2021-03-19:
And I'm sure you got a lot more information than you needed there, sorry about that :)

mworion, 2021-03-19:
Hi Ginge,
I added my setup in the docs:
[https://mountwizzard4.readthedocs.io/en/latest/install/setup.html](url)
as explanation for all. This might help sometimes.
Regarding FW3.0: I already updated some weeks and I had since then no issues and some successful imaging sessions. I hardly could see any difference, but it is your choice!
The USB-C extender I use as will if I test for ASCOM as I run a virtual Windows Machine on my Mac. I think that's working fine even through VM plus extender.
I do not own a ZWO ASI with larger scales, but I hear often topic about USB2/3 speeds. But if that works on TSX, it should be OK
Indi Server and TSX might "fight" for the drivers. This was the reason I finally went to INDI, because then you have a server, where you could link many clients the same time.
Slew Speed setting should work from MW4, I could set this. As MW4 only reads this if there is no interaction, it should be OK. There might be an issue when connection does not work well.
Please also have a look to the number on top of the time widget, this is the number of parallel threads running. If numbers increase over time and do not stabilize -> connection and performance problem in the setup. In my environment I don't see a number beyond 2.
I also uploaded the v1.1.0b11 version which should address the ASTAP issue.
Michel

Ginge70, 2021-03-20:
Thanks a lot, Michel! I'll try it out on the first clear night. Your setup looks quite smooth. I'll have to look into that Pegasus-solution 'cause my cable arrangment can hardly be called an arrangement after I added three dew straps to the mix. More like a cable salad.

The fitlet also looks quite nice. Especially the one that handles -40C.

g

Ginge70, 2021-03-25:
Ok, so now I’ve thoroughly tested 0b11 with wired connection to the mount and whenever MW4 tries to solve during a modeling sequence it fails. If I pause and click the solve button on the image that just failed, it solves without problem. I’ve slowed the mount down to a crawl to give astap time to work, but that doesn’t help. It will fail well before the mount reaches the next point. The queue count number never goes above 4, most of the time it will stay on 2 or 3, it seems.

Here’s the log.

Best regards,
Ginge
[mw4-2021-03-24.log](https://github.com/mworion/MountWizzard4/files/6203228/mw4-2021-03-24.log)

mworion, 2021-03-25:
Hi Ginge,
what I see from the log (at thew beginning)
- you start / connect
- you took an image manually
- you tried to solve -> no success
- you change settings for ASTAP
- you managed to solve
- you selected build points
- you started modeling
- ASTAP timed out and did not solve

etc.

From what I could see:
Still the header entries for ra / dec are zero. This made the first attempt fail
you adjusted to broader search
Therefore it did solve, but with an extreme large error (which was zero to the solved position)
Next image had again zero in header for ra / dec
because of a position more far away, ATASP would search even longer, but was time out.

To explain the MW4 way of model build. slewing and imaging is done async to solve and model build. As extreme it could happen (never does, because solvers are quick nowadays) that you did all images, and solver has to work through afterwards.

So we have to find out, why your images in header show ra / dec zero.

Recap: You test image we talked at the beginning of this thread was done with TSX. TSX does not write RA / DEC as keywords  in the header (this would be float values), but is does OBJCTRA / OBJCTDEC keywords, which describe the coordinates in hexadecimal string.  I had not implemented this reading. With the last update, MW4 does read this -> your test image worked from this point on.

Now: you do imaging with INDI. So INDI has to write the coordinates in the header. For some reason these values are 0 / 0.
First: could you post on of the not solved images, that I could check the entries ?

My first recommendation with your test image at the beginning (when I though you are using Indi, but used TSX) was that Indi needs to access the mount coordinates in indi driver. So the 10micron telescope driver has to be enabled (I don't see this, but I could not check this from the log)  and configured right (this I also cannot check from the log) and connected.  I see that the ccd driver tries to connect to the telescope driver (INDI device snoop), but no 10micron driver is enabled during the session.

This would explain, why INDI writes 0 / 0 in the header of the images and ASTAP could not solve it. So please have a look to the 10micron telescope driver in INDI. You could enable it in MW4 as well. If so I see if it is working also from MW4 in the logs.

Other topic which I have seen in the log recently (sorry I did not notice it before):
you are using a pre2012 hardware. I do not have any test to it. I know one other user asked if that works (it should, but has limited capabilities) and you are using a very old firmware (2.15.1). Not all functions are supported by 2.15.1 as some mount commands were implemented from 10micron later.

I also found out that if I use a not know command from the mount, it will not respond to any of the commands in a row. To change that I have to change MW4 architecture or you have to upgrade the firmware at least to 2.16.x. You don't need the newest one (3.0.x as there were no new commands offered), but for MW4 I recommend 2.16.x or later (2.16.13 fine). To upgrade or not I can't judge as I don't own a pre2012 HW. I have to leave that description with you.

Good: I don't so these timeout to the mount anymore.

Hope this helps us moving forward.

Michel

Ginge70, 2021-03-25:
Great stuff, we're narrowing things down. I wasn't aware I as supposed to also connect the mount to INDI, will certainly do that. As for the pre 2012 mount, that may explain why I'm not able to adjust slew speed from MW4. I'll upgrade to FW 2.16.something on the next clear night and make sure the mount is connected to INDI as well.

Thanks so much again for helping, Michel!

g

Ginge70, 2021-03-26:
Here are the six images that failed to solve on the 24th. I'm neither used to INDI nor working with 8bit images like these. I set the camera to offset 21, Gain 76 and RAW16 via TheSkyX before moving over to INDI and MW4, but I see this has been changed. I tried to move over to INDIGO as I thought the INDIGO control panel were only for INDIGO server. I didn't know that until now and for some reason INDIGO only gave me a spinning umbrella last night, so I couldn't change the camera settings while it was connected to the camera. I suppose the settings are made there and not in MW4? I'll try changing the camera settings via INDIGO control panel next time if it will help with the solving if this cannot be done from MW4. I also see the filters are named incorrectly, filter 4 says H-alpha while it actually is Lum. I wanted to change this as well but didn't as it really doesn't matter how the filter position is named for now, as long as it is shooting through position 4. I was actually wondering if the images were truly shot through filter 4 as they had so little information compared to what I'm used to seeing, but I guess RAW8 readout explains some of that?

Sorry for being no good with INDI/INDIGO stuff, I'm just not familiar with that environment.
Ginge

[m-2021-03-24-23-06-07-med.zip](https://github.com/mworion/MountWizzard4/files/6208487/m-2021-03-24-23-06-07-med.zip)

mworion, 2021-03-26:
Hi Ginge,
I checked the images: No coordinates available. So enable 10micron driver is necessary.
Normally You should do the settings in INDI / INDIGO server. If you set there, MW4 just reads them and uses them. For some I offer the change also in MW4, but these do a remote change of the settings in INDI / INDIGO server. So you will see whenever a property is available in MW4 (always has only a subset) and INDI Server, and changed in MW4, it is also immediately changed on INDI side as well. You only have to take care to persist the settings on INDI side, as INDI loads the values on the server side, MW4 can't set the default / persistent settings on the server.
Michel

Ginge70, 2021-03-27:
Still not working. I’ll upload the log as soon as I get home as connection is too weak out here. But I’ve successfully updated to firmware 2.16.3, I’ve connected the LX200 10Micron device in INDI and I’ve also connected MW4 to indi-10Micron under Telescope in Core devices. The fits header in the imaging window still shows no RA or DEC coordinates. The Coordinates are showing correctly in the INDIGO Control Panel app. I’m thinking there are some settings in the Control Panel I have to set differently. For instance I have no idea what the snoop you mentioned is or how it needs a to be set. Can you give me a hint before I send you the log so I can test it while I have the clear sky?

thanks!
Ginge

Ginge70, 2021-03-27:
Hehe, never mind no think I fixed it. I noticed the “embed data” button in the Imaging window was unchecked. Running model now via wifi and it is screaming through the model points and solving without problem. This is looking very good.

Best regards,
Ginge

mworion, 2021-03-27:
So you have a INDIGO server running on your Mac right?
I downloaded the last one and looked for the settings.
To be honest: I did not find a „Snoop“ for the camera.
If you enable the mount simulator for example and go under main

If you could find one, the 10micron driver should be in.

But I have another way I will try for you tomorrow: I change the handling of coordinates from INDIGO and write the header data myself in the file. I have to do some programming, but I should be ready tomorrow evening.
Michel

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

mworion, 2021-03-27:
Good to hear. Hope it work nicely now

Von meinem iPad gesendet

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

Ginge70, 2021-03-28:
It sure did, Michel. I'm so relieved we finally figured it out. Feel silly that I didn't spot that "embed data" button before. Thanks so much for your patience. The model build went flawlessly and provided a really nice working model in record time so I could shoot Ha exposures for the rest of the night, all of which are keepers. I love it when things just work.

Again, thanks a huge lot!
Ginge

mworion, 2021-03-28:
Ginge,
good to know it works, have fun. I close the issue now.
Michel

Closed 2021-03-28.

Thread 136 (2021-03-30):

Feature request: Choose Meridian when satellite tracking

Ruediger3, 2021-03-30:
Hi Michel,
I would kindly ask for the feature to chose the Meridian when tracking satellites analog the handpad.
The reason is, that very often only one hemisphere of the transit is visible for me and it makes only sense to track after Flip. If I start from West, I only lose time for flipping. please see example attached (red transit, actual Horizon of my home in the image). As you can see it makes no sense to track on the red curve the west part of the transit.

Thanks for evaluating!
Rüdiger

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

mworion, 2021-04-13:
Rüdiger,
Did some tests, from calculation and GUI I'm ready. Only point: I have to build a track with Alt/Az coordinates (new feature in FW3.x). I do not know who asked for it and what the intense was as TLExx commands already did the job. Now I have to decide which type of coordinate transformation I have to choose to get the right coordinates. You will have to test somehow. I will start with Alt/Az apparent without refraction correction (as I hope this will be done in the mount).
I also revised the Satellites GUI to make it better readable: Here the example:
[https://www.dropbox.com/s/pjtfhezms2pirkh/Bildschirmvideo%20aufnehmen%202021-04-13%20um%2021.16.02.mov?dl=0](url)
Michel

Ruediger3, 2021-04-13:
Hi Michael,

just watched the movie and it looks great. Of course I will test, but weather and the matching transit must occur.
But I will test asap.

Thank you very much! Looks marvelous!
Rüdiger

Ruediger3, 2021-04-13:
Is there a beta, so I can provide a feedback for the new windows features?

mworion, 2021-04-13:
Unfortunately not. There are still some tests to do, probably for the weekend. We‘ll see.

Von meinem iPad gesendet

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

Ruediger3, 2021-04-13:
No problem.
Just let me know when and if I can support you. Thanks!

mworion, 2021-04-25:
v2.0.0b3 shows some of the features. need to implement the programming (download will take >5 seconds to the mount computer).

Ruediger3, 2021-04-25:
Hi Michel,

had a look an looks very nice. I do like the new graphs in the satellite window. I will test as soon as possible,

Many thanks!
Rüdiger

mworion, 2021-04-25:
Please be reminded, that the tracking itself is still the same. v2.0.0b4 will offer old an new in comparison. v2.0.0b3 shows the new gui and selection features

Ruediger3, 2021-04-30:
Hi Michel,

Many thanks for the update. I will test as soon as possible.
1-10 arcsec should be ok for me, since I shoot at max 0,22"/p, so the offset is at max. 50p and the ISS is still in FOV.
Horizontal line is a cool goody 👍 Question: the scope is waiting at the horizontal line for the satellite to rise and starts tracking when it is crossing it?

Greetings
Rüdiger

Ruediger3, 2021-04-30:
Hi Michel,
I have installed it, but either I do something wrong or there is a failure: When double clicking e.g. ISS nothing happens, no calculations. Log is attached.

Cheers
Rüdiger

[mw4-2021-04-30.log](https://github.com/mworion/MountWizzard4/files/6407197/mw4-2021-04-30.log)

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

mworion, 2021-05-01:
Had a priority to a running mount. Changes will occur in v2.0.0b5 and adding a simulating feature that you could do a test run without waiting for the real satellite.
Michel

Ruediger3, 2021-05-01:
Hi Michel,

many thanks! I have installed it and did a quick tour without the mount attached. 2 things came up:

1. Color of the green transit is hard to read when close to custom horizon. Maybe switch one to blue?

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

2. The tool tip says ""prognosis ... satellite over horizon." Which horizon? Custom or standard horizon?

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

Many thanks!
Rüdiger

mworion, 2021-05-01:
Rüdiger,

Colors are to be improved. I have to play around. The horizon is the standard. And if you could confirm the precision, It’s not a prognosis as I had before, but it’s the highest precision I could calculate. Still the position of a satellite due to the limited number of digits in the provided TLE parameters files is about 1km in space….

Michel

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

Ruediger3, 2021-05-01:
Hi Michel,
I will test precision (if you mean accuracy of tracking e.g. the ISS) as soon as possible. Currently it is raining cats and dogs.  We even have rain warning from DWD :(.
I am looking forward to test myself :)

Rüdiger

mworion, 2021-05-01:
Same here, I switched colors to a more calm way as I might need it later.
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
Michel

Ruediger3, 2021-05-01:
Looks good 👍

Ruediger3, 2021-05-29:
Hi Michel,
just tested with internal math, and the ISS completely failed. The mount started tracking way before ISS rises. It was more than 90 degree off. It flipped just when ISS came over the horizon.
I immediately reverted back to mount math and the ISS was precisely in the center of the camera at the CDK@2563 mm FL. Below the the setting. Before I had updated all the files crucial.

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

mworion, 2021-05-29:
Hi Rüdiger,
just a quick question: was Long before about 70 seconds ?
Michel

Ruediger3, 2021-05-29:
Yes, at minimum. But this is hard to tell. I was very bussy to get everything working correctly. There every second is a year ;).
But 70s might be matching.

mworion, 2021-05-29:
The only thing I can think of are the 69.184 s time difference between TT Time System (MW4 base) and UTC Time system (mount base). I have to have a walk through to find out.

Ruediger3, 2021-05-29:
Many thanks!
Rüdiger

mworion, 2021-05-30:
Hi Rüdiger,
in fact that was most likely the issue. I did some satellite tracks in realtime and I now see no difference between internal and mount math track path. So hopefully it should be sorted out. v2.0.0b12 will have the fixes in and also some improvements for the GUI (adding mount Alt/Az pointer to the satellite view.
Michel

Ruediger3, 2021-05-30:
Hi Michel,
I have installed b12 and will check ASAP. Many thanks!
Rüdiger

Ruediger3, 2021-05-30:
Hi Michel,
tested it and it again failed when Horizon is checked. It starts tracking immediately when the ISS is rising but not when crossing the user horizon. This is completely ignored. It starts tracking from user horizon start point at the same time the ISS rises over earth horizon.

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

Here horizon "Off" but also missed id. I was not able to get it into FOV.

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

[mw4-2021-05-30.log](https://github.com/mworion/MountWizzard4/files/6566811/mw4-2021-05-30.log)

mworion, 2021-05-30:
Hi Rüdiger,
thanks for the detailed feedback. To clearify: Now tracking is good if not using horizon mask. Correct ? If enabled MW4 does not start right when crossing the horizon line.
So last issue is sorted out (with the 69.184 s), now I have to look into horizon topic.
Michel

Ruediger3, 2021-05-30:
Hi Michel,
the tracking with user horizon was completely far away. When switched off, it was quite close (also cross checked live in Stellarium), but ISS did not come into FOV, which means a considderable deviation for the full frames camera like mine.
I have tried to switch in a third attempt to mounts math during that pass, but it was to late. I have only seen ISS rushing through the image during flip.

Thank you!
Rüdiger

mworion, 2021-05-31:
Hi Rüdiger,
the horizon issue should be fixed in v2.0.0b15. Regarding the ISS in FOV I recalculated your situation (TLE, Refraction, Location, Time) and compared it to the mount calculation. Attached the plots. If you have some ideas, why the difference  of 10 - 15 arcsec in Alt/Az leads to a situation of not having ISS in FOV (0.2 arcsec / pix) means about 50 pixel difference, please let me know.

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

Michel

Ruediger3, 2021-05-31:
I have installed the latest version via new updater. Worked fine.
I will test asap.

Could it be that some latency leads to that delay? When calculated on the mount's controller the result is intermediately transferred to the motors, whereas when calculating in MW the controller needs to interpret the controlling impulses and send it to the mount. Maybe this delay is too much? But this is only wild guessing.
BTW: Your linked images are not working. :(

One other thing I have notice: The position of the 3D simulator is not stored when restarting MW. Maybe a good idea to include it also in the profile. Also another point: When you have a window position outside your screen you cannot get it back. Happened to me copying my profiles from a multi screen workstation to my NUC. I could not get my windows back :(. It should be checked for boundaries. THX!
Should I open dedicated issues?
Rüdiger

mworion, 2021-05-31:
Rüdiger,
Latency should not be the problem as it is (after programming) all handled inside the mount. So programming does start time and tracking path and hands over to mount for execution.
Images: Might be the case that they are not transferred through email. On the webpage they should be present.
Question about the position of 3D simulator: The window position is persistent and in the profile. Only point is that it does not open automatically. Reason for this is multi platform as not all platforms support 3D and this I handled be enabling or disabling Opening Window.
Windows outside the screen should be set automatically to x/y: 0, 0. I already check screenSize in x and y and if position exceeds this, I''ll set it back. But I improve this part.

No need for separate issue, will include this in b16 for test.
Michel

mworion, 2021-07-15:
Hi Rüdiger,
anything new about the precision of the tracking ?
3D simulator and windows positioning should be already corrected
Michel

Ruediger3, 2021-07-15:
Hi Michel,

Sorry no. No ISS pass when wether would allow observing. It is still on the list, but currently I am busy not to float away... continuous rain 🤬

Cheers
Rüdiger

Ruediger3, 2021-07-18:
Hi Michel,
just tested with the 20:35 transit. The mount started at horizon, but ISS was not in FOV. The model is precise to get any target into FOV at least. It looks like the mount is a bit to slow.
In the image you the the ISS position, the mounts position and the FOV.

Yet another point: If the mount is programmed you have no indicator that the mount is in hot stand by. You are not shure whether it is really waiting. Would be good if you would have some visual indicators. e.g. make the button "Start satellite tracking" green flashing.

Rüdiger

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

mworion, 2021-07-18:
Hi Rüdiger,
Many thanks for checking. The indicator topic is a good idea. I will do that.
Regarding the tracking: Is the mount constantly too slow, meaning it's starting time is too late and the distance ISS and mount keeps constant ? How far away / too late it the mount actually? I have to check if I have a systematically error or I did not understand the new command protocol right. From calculation side the errors are within 10-15 arcsec, so this should not be an issue. I am missing something.
Michel

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

Ruediger3, 2021-07-18:
Hi Michel,
just ran a test with tracking by the mount, but it also missed. So the question is why. Never had issues. I had updated the TLE before. The only difference: I am using GPS time for this test and before I had used PC time in high precision, which worked.

I am shooting with 0.15 "/pix @ approx. 8m FL.

Attached the screenshot from guiding with the mount's function.

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

Ruediger3, 2021-07-19:
Hi Michel,

sorry I have forgotten one info: The offset is constant (at least so far I could figure out in that very short time).

Rüdiger

mworion, 2021-07-19:
Hi Rüdiger,

I could do adding a time offset to correct this. Question is a systematic error. So with your remark, start time might be the very point. If you state it's a constant offset. Could you tell me the time difference? Out of the drawing back calculating the time difference is difficult as I do not know the actual angle velocity of the ISS.

Michel

Ruediger3, 2021-07-19:
Hi Michel,

thanks for the feedback.
Please wait with the offset implementation. I will test (hopefully) today again with a bigger FOV to get it into FOV.
I am not sure why it is failing. Due to the fact it is not in FOV and it is so small I can hardly guess the offset in time, since I have no reference point. But it is far below 1s.

Ruediger3, 2021-07-19:
Hi Michel,

just tested with huge FOV and the ISS was on the edge. My observations:
1. The offset is very constant
2. I did manual correction and it was almost constant
3. After the flip, the ISS was well focuses, but I am nit sure, whether it is due to the manual corrections before the flip. Do they remain after the flip as offset?

FOV: 48 x 32 arcmin (red box)

Before Flip:

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

After Flip:
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

Ruediger3, 2021-07-19:
One information: PC time differs 503ms to mount which takes GPS time. This is roughly the time lag / offset.

mworion, 2021-07-19:
Rüdiger,
Is there any difference between mount calculated and my calculation in terms of the observed offset.
The command protocol allows +- 999ms time correction when following a programmed track. So adjusting should be possible.
Michel

mworion, 2021-07-19:
Addition: could you read out the GPS - UTC time difference stored in the mount ?

Ruediger3, 2021-07-19:
How can I check this? Or do you mean comparing MW4 Sat track and Mount Sat track?
BTW: Just tried "Push mount time to PC" and it does not work. The time gap remains 500ms.

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

mworion, 2021-07-19:
If you would like to sync, enable connect clock sync and enable sync mount to pc clock.

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

mworion, 2021-07-19:
please feel fret choose if you want update during tracking or not.

mworion, 2021-07-19:
Rüdiger
The UTC-GPS delta is under settings in the handpad and should be 18s.
The offset I look for is between mount computed tracking path and MW4 computed tracking path.
Michel

Ruediger3, 2021-07-19:
Ok, I was expecting when pressing "Push mount time to PC" it pushes the time regardless the settings below.

Offset seams to be correct-
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

How can I compare the track data?

Ruediger3, 2021-07-19:
BTW pushing the time from mount to PC might be dangerous. Since the PC also detects a deviation a is forcing an update from time server. This might lead to an oscillation, or you have to switch off time server sync. This is a very bad idea in a network. Windows domains react extremely allergic to time differences. I have a very bad gut feeling. This is only a good idea for stand alone devices.

mworion, 2021-07-19:
I agreed, this is really a user demand for send alone without being connected.
I wonder how much the MW4 tracking differs from internal mount calculation.
Looking forward to your results. And still wondering why the difference is about 0.5s between GPS and PC

Ruediger3, 2021-07-19:
The next test will be: PC and Mount using both GPS time. The very next test will be both using PC time.
But now clouds are rolling in :(

Ruediger3, 2021-07-20:
Hi Michel,
Just tested with FPS both. failed again on both meridian sides. Mount was behind the ISS approx 1,5s.
Rüdiger

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

Ruediger3, 2021-07-21:
Hi Michel,
just tried with PC time and the ISS was in FOV (but very close to the edge).

Cheers
Rüdiger

proceau, 2021-07-21:
I'm problem too

mworion, 2021-07-22:
Hi Rüdiger,
many thanks for the intensive testing. To sum up in my words (to be clear where to move on), please confirm:
- There is no big difference in tracking and getting Sat in FOV between mount calculation and MW4 calculation (if you could describe the difference better, please try it.
- The deviation of spotting a sat in FOV is related to the used time base. GPS is off, PC time is in.

Just as remark: the model corrects also for time deviations. If the mount model is done with PC time and there was a GAP between PC and GPS time, Sat tracking with GPS time will not get the sat in FOV.

If all above is true and correct, the question is, why there is a difference between GPS and PC time. My thoughts:
PC time system via NTP is UTC based.
Mount time system is also UTC based.
Actually GPS - UTC difference is 18seconds (which is correct configured)

Strange...
Michel

Ruediger3, 2021-07-22:
Hi Michel,

thanks for your patience. It is very hard to say something is like, since the transits and weather only allows to repeat one or two tests for each setup combination. So I hesitate to say "it is". Simply there are too little count of tests.  I will try to repeat the identical test multiple times to be sure it is like this. Unfortunately that is in the nature of tracking ISS.

1. Yes. I had issues with both
2. Yes. The offset with PC time was less. But this could be by chance.

I have created a new 90 point model last night. I will retest with new model.

Yes, there is a difference between PC time and high precision mode of Windows. Now it is the question which one is the less wrong. Actually, GPS should be correct, since it is a stratum one layer time reference. May there is a delay in processing the updates timely from MGPBox to mount or something other wired. But it looks like that both times run slow.

The GPS offset cannot be changed anyway. I think it is not editable. I remember there was an issue with the10; Mount configurator which showed 19s offset. Maybe there is also a bug.

That said, I am not sure where the root cause lies. I will do following:
1. Setup everything to work with internal tracking
2. When 1 successful repeat the tests systematically.

I have to ask for some patience since I can only test max. once a day due to the obstruction of my FOV.

Thank you!
Rüdiger

proceau, 2021-07-22:
I'm test, the standard NTP of windows have 500ms of error, i'm change to other NTP stratum 2 and it's more correct.

Ruediger3, 2021-07-22:
Yea thats true and thats why I do not use them. I use the NTPPool.org

mworion, 2021-07-22:
Rüdiger,
question: if the offset stays constant is it worth to try to adjust the time offset for tracking to catch the satellite?. Is this possible? Interesting question would be if that offset stays constant between different satellites and observing nights as I could persist this value then.
Michel

Ruediger3, 2021-07-22:
Well, using a offset means to know it in advance. If this would be possible, I could adjust the clock too and have the same result. The problem is, an offset needs an reference point and here I am not sure.
This definitely needs more and systematic testing, since the results are not consistant.

mworion, 2021-07-23:
Rüdiger,
I updated the GUI behavior to make it more clear what happens (changing text and color) in v2.0.0b28
Michel

Ruediger3, 2021-09-13:
Hi Michel,

I was testing yesterday and I missed ISS again. It was not in FOV. I will test again as soon as possible.

Cheers
Rüdiger

mworion, 2021-09-13:
I anyway working on some features for finding near satellites which are visible and sun lit.
If that's running we should be able to find more and easier opportunities to select satellites for testing. I currently not know, why and for what reason I miss the FOV in MW4 math, when the satellite is in the FOV for 10micron calcs.

squark-envoyer, 2021-09-13:
18s it's not second correction of GPS ? because some time 1s it's add or remove on UTC, the GPS have not correct ?

mworion, 2021-09-13:
Actually (since 01-01-2017) the difference GPS - UTC is 18s. And as the gap is more closing, there might be for some years more no need increasing it further. But in result 18s delta is correct.

squark-envoyer, 2021-09-13:
the TLE parameter it's on GPS time ou UTC time ? the 10micro correct internal time with 18s or not ?
because the pointing error it's coherent with that, and explain problem pointing ?

mworion, 2021-09-13:
TLE should be as spec in UTC and the mount internally does all things in UTC. This fits nicely. If you are using a GPS for time sync you have to take care about the 18s.
It would be great to know if the deviation is only about time and nothing more and if so how much in each case.

Maybe we have some other topics when using GPS as time source (and Rüdiger, this might also explain your observation that GPS time and NNTP time was different):

> Many general purpose GPS devices utilise NMEA protocol, which is a standard protocol for GPS devices. However, the problem with using these devices for as a GPS Clock for computer timing is that the NMEA sentances are often not synchronised to be generated at specific intervals.

>Many GPS devices therefore can only provide an accuracy of plus or minus 1 second, which is generally just not accurate enough for network timing purposes.

I will ask Martin, how his MGBox receiver is designed for that.

squark-envoyer, 2021-09-13:
Would anyone have any idea how to simulate and time the simulation to get a feel for the fault?
When the mount is in simulation mode we know the chosen start time, it would be possible in simulation mode to set the starting time of the latter?
My idea is to simulate the same TLE with a laser on the mount, started at a given time and see when the laser passes a reference point of the trajectory and see if in PC UTS, the 18s offset is applied or not in addition.

Ruediger3, 2021-09-13:
It looked like that MW was slow for a second but track ok.
I followed life in Stellarium and the mount was "behind" ISS. I guess around 1 second. What I also had noticed was a time difference of approx. 600ms between mount and PC.

mworion, 2021-09-13:
Rüdiger,
if you say 1s behind, you reference a time system which you did from NTP service correct? So would the gap 600ms to mount add another 600ms, so in total 1.6s behind "Mount" or would this reduce the difference to 400ms ?

mworion, 2021-09-13:
@squark-envoyer,
Starting the simulation in that precision is hard to do as execution times might differ. I made the calculation comparison between mount and MW4 if you use the same time base that you run inside a 10 arcsec window for Alt and AZ as the normal satellites have a "speed" of about 0.03 deg / s which is about 100 arc sec per second. So the sat should be in the FOV just by calculation.

Ruediger3, 2021-09-13:
The 1s was a guess from watching screen.
The 584ms were displayed by the 10M clock sync tool, which was set not to sync.
I also noticed, MW says time not GPS time synced but the hand pad does. So there are many potential root causes, which makes it really tricky to tackle the root cause.

mworion, 2021-09-13:
Rüdiger
Good point about handpad and MW4. I asked already 10micron because I see with :gtg# command that I loose sync sometimes. I have to check Handpad as well.
Could you tell where to see if the time is synced on the handpad?

Ruediger3, 2021-09-13:
Based on the symbol shown.
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

Ruediger3, 2021-09-13:
Here a screenshot from life system:
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

mworion, 2021-09-13:
Rüdiger,
many thanks. I think there is a different between "usage" and synced (at least the is some room for interpretation).

Ruediger3, 2021-09-13:
Welcome. You are right. This is ambiguous.
Rüdiger

mworion, 2021-09-22:
I close this point as there is no chance to sync mount time with high precision to GPS time.
I publish a 2.1.0 beta this evening with another extended Satellite feature set (search and tracking correction). You should be able to adjust track as a matter of time, ra or dec directly. So the time delta +- 1s along the track is now available in MW4.
Michel

Closed 2021-09-22.

Thread 138 (2021-04-01):

Beta 2.0.0b0: Errors in command

Ruediger3, 2021-04-01:
Hello Michael,
please find attached the screen shot from the errors in the cmd window.

Rüdiger

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

Thread 139 (2021-04-04):

Dome not following correctly when tracking satellites

InFINNity-Deck, 2021-04-04:
Hi Michel,

as discussed on the 10Micron forum recently, the new dome following function in satellite tracking does not work properly. At the time I only tested it for negative lateral offset of my C11, but today I tested it both for the C11 and the Esprit (positive lateral offset). Both scopes do not get the desired dome-slew.

I also tested a modelling run and that worked just fine with both lateral offsets, the dome was correctly positioned in both cases.

Any idea what could be causing this deviation in satellite tracking?

Thanks and best wishes,
Nicolàs

mworion, 2021-04-04:
Nicolas,
from my point the mount computer does not set the target pier side when doing satellite tracking. This might be the difference. I have to look, how I could make this happen.
Michel

InFINNity-Deck, 2021-04-04:
Hi Michel,

ok, that is interesting. Please let me know if I can test something for you.

Nicolàs

mworion, 2021-04-05:
Nicolas,
I uploaded v2.0.0b2 with an updated procedure for following. Hop this improves the situation.
Michel

InFINNity-Deck, 2021-04-05:
Hi Michel,

thanks for the quick update, much appreciated! Currently the weather has taken a turn for the worst (7Bft, snow!), hope to dry-test it tomorrow when the weather has calmed down again.

Nicolàs

mworion, 2021-07-15:
Hi Nicolas,
the actual weather is still very bad. I try to clean up open verifications as I want to move to release v2. Please let me know if there is anything new about the dome following.
Michel

InFINNity-Deck, 2021-07-15:
Hi Michel,

work, weather and seasonal daylight have prevented further tests. I will put this high on my agenda and will try to find time for a 'dry-test' (i.e. at daytime)

Nicolàs

InFINNity-Deck, 2021-07-17:
Hi Michel,

today I did three tests:

- OAO 2 using the C11 (offLat = -0.19)
- Cosmos 2221 using the C11 (offLat = -0.19)
- Cosmos 1833 using the Esprit 150ED (offLat = +0.21)

In all three cases the dome followed exactly as it should, so great result! :-)

I do, however, have a few comments:

- the initial slew seems to be random. With OAO 2 the initial dome position was about 100 degrees off, with Cosmos 2221 this was about -45 degrees. Switching to the Esprit set-up disabled the automatic dome following function, so I do not know the initial dome-slew for that test.
- Once the satellite is above the horizon the dome is slewed to its proper location and the slit stays properly centred in front of the selected scope.
- During tracking the amount of dome-slews is quite large. Every 3-5 seconds the dome is instructed to follow the scope. I have a dome-slit-width programmed in at 0.81 metres, but the routine does not seem to make use of that knowledge.

So the functionality works perfect, but could do with some improvement regarding the number of corrections for the slit-width. I do realise that it is not quite easy to do the required maths, but it would be great if dome slewing could be done as follows:

- start with the slit centred over the scope;
- once tracking, move the dome when about 10-20% near the slit's railing edge;
- then move the dome towards the leading edge (again some 10-20% clear of it);
- wait until the trailing edge is reached again.

As the satellite trajectories are curved in respect to the dome slit, the above steps require knowledge of the complete trajectory. Calculating the optimum slew-angle has to be done for several points along the trajectory to ensure the dome is not slewed too far off.

The reason I would appreciate the number of dome-slews to be minimised is that each dome slew has its effect on the pier (despite the vibrations going down one floor to reach the base of the pier), which is especially noticeable at f/40 with the C11.

Once again thanks for this improvement! Hopefully you are able to implement above suggestion viz. the reduction of slew commands as well.

Nicolàs

mworion, 2021-07-17:
Hi Nicolas,
thanks for the extended testing. It's good that it works now as it should. For the Dome movements (as I don't have one) I need some more context, how dome is functioning. Currently I send always if I correct the the Azimuth also a new dome position. There is right now no relation to the slit width. I recognized that some does controllers (like Aries one) have a configured hysteresis where it does not react at all (e.g. 2 deg). So any chance within this value, the dome does not move. I struggled with that as the dome Dows not reach the traget position (and I had the dome slewing state present). In addition if I take care of the slit with (which is doable), the hysteresis parts are summing up. Problem is that hysteresis settings are normally not readable from the dome controllers nor being able to switch them on or off. Plus as you already showed, depending of the position the resulting dome slit with is due to change if the scope is not located in the center line (which is always the case in side-by-side setups).

If you have some thoughts about how to address this, please let me know (especially how you as a dome user interact with these unlinked controls)
Michel

mworion, 2021-07-18:
Edit: I put the reducing dome slews into a new issue to separate this.
regarding your Radom initial dome position: Could you post the log file of the tests. I actually cannot reproduce this behavior in my simulation setup.
Thanks in advance,
Michel

InFINNity-Deck, 2021-07-18:
Hi Michel,

please find attached the log-file.
[mw4-2021-07-17.log](https://github.com/mworion/MountWizzard4/files/6835863/mw4-2021-07-17.log)

Nicolàs

mworion, 2021-07-18:
Nicolas,
checked the logs. Does your dome has an open shutter status in the ASCOM driver ? Still I have to be robust and made some fixes.
Anyway I made a new beta, which addressed this topic (v2.0.0b25).
Michel

InFINNity-Deck, 2021-07-18:
Hi Michel,

the shutters of my dome are not yet automated while the ASCOM driver I currently use has a bug by which it reports a wrong status. This issue has been dealt with, but I still need to update the LesveDome ASCOM driver.

Thanks for yet another update, will try to test it later this week.

Nicolàs

mworion, 2021-07-22:
Nicolas,
with the other test, did this workaround help?
Michel

InFINNity-Deck, 2021-07-22:
Dear Michel,

forgive me, but I am not sure if I understand well. Which workaround should help for which issue?

Nicolàs

mworion, 2021-07-22:
I put a workaround in for the dome driver not reporting the right status.

InFINNity-Deck, 2021-07-22:
Ah, ok, I did not notice that. Will have a look at it next time, but perhaps you see it in the logs I just sent?

Nicolàs

InFINNity-Deck, 2021-07-22:
I just checked which LesveDome driver I currently use and noticed that I am already using the latest one which should have the shutter status error fixed. In SGP, however, I still see "Shutter status: Error".

Nicolàs

mworion, 2021-07-23:
OK, but I should not hurt MW4 anymore.

mworion, 2021-09-22:
Nicolas, I close the issue, if anything newly happens, please reopen.
Michel

Closed 2021-09-22.

Thread 144 (2021-04-23):

2.0.0b2: Multiple issues when building model (repeating failed points)

Ruediger3, 2021-04-23:
Hello Michel,
I have tried to create multiple models last night and experienced massive problems:

1. failed points were repeated but nor marked as successful
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

2. After repeating and successfully solving them, the model creation process was not triggered. MW stopped. I had to "End" the build process manually. After that the creation of the model was triggered.

3. It took me several attempts to accomplish an small 19 point model. The following 96P model went smoothly.

4. MW just stopped while repeating failed points

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

I have attached the log file but it is quite huge. I have noted a time when I had problems: 22:10 CEST

Cheers
Rüdiger

[mw4-2021-04-22.log](https://github.com/mworion/MountWizzard4/files/6364153/mw4-2021-04-22.log)

Ruediger3, 2021-04-23:
Another point: When repeating the failed points, it starts with the oldest point first, This may cause a meridian flip. This could be optimized by using "shortest slew track"

mworion, 2021-04-25:
Rüdiger,
v2.0.0b3 should address all of your points.
Michel

Ruediger3, 2021-04-25:
Hi Michel,

many thanks. I will test it as soon as possible.
Had to install it vie work around and got on the first try following error below. Second attempt was successful.
Rüdiger

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

mworion, 2021-07-13:
Rüdiger,
from my tests it's OK now. Closing the issue. If you have other insights, please reopen.
Michel

Ruediger3, 2021-07-13:
Hi Michel,
that's ok. When creating a new model I will test it and reopen in case of a problem.

Many thanks!
Rüdiger

Closed 2021-07-13.

Thread 145 (2021-04-23):

v.2.0.0b2 image coordinates not embedded anymore

Ginge70, 2021-04-23:
Hi again, Michel!
After you helped me solve the issue with my model building in the previous version, I updated to v2.0.0b2 and now it seems MW is no longer getting coordinates for the captured images, resulting in failed solving when modelling. The change on my end was that upgraded the wifi environment, resulting in a new IP-address for the mount, which I changed in both the INDI environment using INDIGO control panel, and in MW4. Both applications seem to connect to the mount, so in theory MW4 should be able to pick the coordinates from INDI, right? I can also confirm the "Embed Data" in the imaging window is still checked. I'm now back to the situation where solving works when not building models, albeit with a substasntial error which leads me to suspect that MW4 is no longer getting the data from the scope even thoug it is connected via INDI in Devices>Settings.

Maybe I'm overlooking something, or did you make changes between the latest update and the previous that could affect this?

Best regards,
Ginge

Ginge70, 2021-04-23:
[mw4-2021-04-22.log](https://github.com/mworion/MountWizzard4/files/6367160/mw4-2021-04-22.log)

Ginge70, 2021-04-23:
Come to think of it, - another change I made was to add a bunch of simulatiors to INDI which I later removed. When looking in the INDI control Panel now I see that snoop devices are set to GPS Simulator and Dome Simulator, which made me think maybe adding the simulators and removing them has messed up MW$'s communication with the mount... Or maybe not, I really don't know, but thought I'd mention it in case the info was useful.

Best regards,
Ginge

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

mworion, 2021-04-24:
Ginge,
with the log, still we were probably back to the first situation where no RA/DEC data was in the header. At least the log shows ra = 0, dec = 0 as starting point. If you look to the snoop devices, the 10miron snoop devices are not important, but the devices you choose for the camera as the camera should look into the telescope driver (10micron) to fetch it's coordinates. Please check again.

But anyway as said last time, I will add some code to overcome this problem if no data for RA /DEC is added from EKOS I will tray to add this from MW4 side in the next beta

Michel

Ginge70, 2021-04-24:
Yes, something I did caused it to lose the ability to add scope position. I'll make a note of your comments and add 10Micron as a snoop device for the camera in INDIGO control panel next time I'm at the observatory as the camera only shows up in the INDI control panel once connection is established. If that doesn't work, I'll wait for the next beta. Anyway this isn't going to be a problem for me until next season, my current model is working nicely.

Thanx!
Ginge

mworion, 2021-04-24:
Ginge,
I put the workaround in, give it a try at any time. Closing this issue. v2.0.0b3 onwards would be the version to test.
Michel

Closed 2021-04-24.

Thread 152 (2021-05-13):

Exception with ASI6200 when downloading image

Ruediger3, 2021-05-13:
Hi Michel,

as discussed in 10M forum here the issue for the problem. The download of the image of the ASI6200 fails with an Exception. Log attached,
Version 2.0.0b7, ZWO ASCOM driver 6.5.1.6 released 8.5.2021.

Cheers
Rüdiger

[mw4-2021-05-13.log](https://github.com/mworion/MountWizzard4/files/6474649/mw4-2021-05-13.log)

Ruediger3, 2021-05-13:
Hi Michel,
I have donwgraded the ASCOM driver to the latest well known working and MW fails silently. Attached the log (the previous one) plus the new entries. It simply stays in "Expose 1".

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

[mw4-2021-05-13.log](https://github.com/mworion/MountWizzard4/files/6474772/mw4-2021-05-13.log)

Ruediger3, 2021-05-13:
I have found the root cause:
the latest ASCOM throws an exception when external 12V power is not attached. Before it was possible to image if the cooler was off. Now it fails. Is MW4 automatically setting any cooler parameter on connect? The older did not and it was possible to get an image.
Well, there are sometimes thing you need not to understand.... it works now.

Closed 2021-05-13.

Thread 155 (2021-06-26):

MW4 - ASCOM issues with 64/32bits

carlosgib, 2021-06-26:
Hi Micheal, as explained in the 10Micron forum, I am having problem some ascom connections, either its 32bit running in a 64bit, a 64bits running in a 32bit. There other equipemnt , the camera and filter wheel does not show under an ascom driver , when I do have them (FLI) running under 64bits. I am providing some photos, maybe you can see the issue. I do not know what to do, I have installed MW4, Python as well as the FLI drivers. Run them under administrator.
I however managed to work using MW3, the direct connection to SGP and connecting through Win32bit/Ascom managed to connect to the Camera/FW.

Thanks
Charles

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

mworion, 2021-06-26:
OK, let's start from a clean install.
As you have QHYCCD camera with a large sesame (my guess), I would go for 64bit installations as some users reported issues with memory consumption in 32bit.

Could you post the log file from your work folder (install.log, run. log and the mw4 log file ?  - please run MW4 in Deep/Debug, Trace mode before)

delete complete MW4 work folder (or start with a new one)
remove python if it's not 64 bit version.

install python 64bit
download the 2.0 widows scripts
extract them in the new work folder
run the install script
script should tell that 64 bit python is installed in the terminal window
the official version is 1.1.1, my guess is you want to get to version 2 beta.
if you recently have downloaded the script, there should be a updateBeta in there as well (if not, please download the newest scripts)
run the update beta script

use the latest ASCOM 6.5 SP1 platform version. older ones had reported issues.
make sure, that you install for all your devices 64bit drivers. The FLI focuser is definitively a 32bit driver, which will not work.

run MW4
enable trace debug under settings/update
start to setup the first ASCOM driver

At this point, please report you status.

Carlosgibb, 2021-06-26:
Hi, please find the three logs that you asked for, I am now going to start removing programs suggested, and reinstal again.

Charles

[mw4-2021-06-26.log](https://github.com/mworion/MountWizzard4/files/6720431/mw4-2021-06-26.log)
[update.log](https://github.com/mworion/MountWizzard4/files/6720432/update.log)
[install.log](https://github.com/mworion/MountWizzard4/files/6720433/install.log)

carlosgib, 2021-06-27:
Hi Micheal, i follow the intsallation process, Installed Python 64b, installed MW4 2.0 scripts, I removed ASCOM and installed again 6.5, I runned beta script, I run MW4 and the FLI camera or the ASCOM Pulsar Dome could not be started. On the format because it cann find the FLI drives, and the latter the same as before a 64bits runing with a 32bits. I just left my observatory, will come back next friday, the only thing I did not do was the 'enable trace debug'

Charles

mworion, 2021-06-28:
Charles,
if we find some time we should try a co-working session via team if you don't mind.
Michel

Carlosgibb, 2021-06-28:
Hi Micheal, yes please, I intend to travel to my observatory on Thrusday
night, if you have a free time on Friday I will be there, or Saturday.

Thanks
Charles

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

mworion, 2021-07-03:
Charles,
Saturday (today) would be OK. Any time which might fit for you ?
Michel

Carlosgibb, 2021-07-03:
Sorry Micheal, had to go back home from the observatory, some urgent matter
Can will arrange another day, will be in touch for next week. apologies and
thanks again

Charles

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

mworion, 2021-07-13:
Please give me a short notice if you would like to move forward.

Carlosgibb, 2021-07-13:
Good Afternoon Michael, I managed the Dome to work with MW4 and the FLI
focuser, and just put a question in ASCOM forum given that I try to load
FLI camera in Shapecap and couldn't find the FLI drives, FLI like always
weren't that helpful.

Let see what ASCOM forum come back with.

Thanks

Charles

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

mworion, 2021-07-13:
Charles,
good to hear. Please let me know when you need some help. If you don't mind (as I'm cleaning up for the next release) I close this issue. Please reopen or if you know more open a new issue for further topics.
Michel

Closed 2021-07-13.

Thread 156 (2021-06-27):

Cannot cool SX-56 camera and no results after successful run.

InFINNity-Deck, 2021-06-27:
Hi Michel,

the past few months I have been assisting a Canadian GM3000 owner. Today we did a successful 74-point run, but we did experience two issues, see attached log-file.
[mw4-2021-06-27.zip](https://github.com/mworion/MountWizzard4/files/6721513/mw4-2021-06-27.zip)

We started out with version 0.152.0b6. After an initial partial run I wanted to see if with version 1.1.1 could fill in the gaps as 0.152.0b6 did not allow to do so (the option "Exclude Successful Points..." was greyed out), so the log-file contains runs with both versions.

With version 0.152.0b6 we could cool the camera (SX-56 over ASCOM), but after installing 1.1.1 this was no longer possible. Good thing about 1.1.1 is that the image window now shows the CCD temperature for this camera (that did not work in 0.152.0b6). We solved the cooling-issue by using MaximDL to control the cooling, but of course it would be nice to have this "Cool on" button working again.

Finally we did this 74 point run, which resulted in a 22 term model with a RMS of 7.4" and a PAE of 50". Clicking on "Manage Model"-tab did, however, not show the model-positions plot or Error-distribution. We could save the model to the mount and checked in the keypad that it indeed was loaded. A subsequent test on Saturn and Altair showed that the model was working (pointing error of about 20").

I tried to run the analysis, but could not find the MW4-result file to load it.

Could you shed some light on this, or are these issues already solved in beta-distributions?

thanks in advance,
Nicolàs

mworion, 2021-06-28:
Nicolas,
could you send me the model file which was generated (should have *.model extension in model folder)?
I try to check.
Michel

InFINNity-Deck, 2021-06-28:
I will ask the owner, although I fear that none was generated as I could not find it to run it through the analysis.

Nicolàs

mworion, 2021-06-28:
Hi Nicolas,
from the log I see that there should be a file existing:

`m-2021-06-27-09-59-20-file`

Please check, if file paths contain white spaces or other "strange" characters as windows sometimes reacts different to MAC or Linux and I do not get these deviation in debugging mode during development.
Michel

InFINNity-Deck, 2021-06-29:
Hi Michel,

as I feared the model-file was not created. The images-folder does contain the images that were taken by MW4 (it was asked to keep the images), but the model file itself is gone (or was not created?).

Nicolàs

InFINNity-Deck, 2021-07-14:
Hi Michel,

just now I installed the latest beta version on his laptop, but the cooling button remains unresponsive. When I click the field next to Cooler Temp, I can set the temperature to -20, but it does not accept it. Hitting the Cooler On button does not make it turn blue.

Nicolàs

mworion, 2021-07-14:
Hi Nicolas,
will have a look this evening. Would you mind to enable trace mode for logging? For issue tracking this helps.
Michel

InFINNity-Deck, 2021-07-14:
Thanks Michel, next time I will turn on trace mode.

Nicolàs

mworion, 2021-07-14:
Hi Nicolas,

The coolerOn is fixed in v2.0.0b22. We had some troubles with cameras reporting has cooler, but driver does not support it.
The second I never tested before. As MW4 is a async tool, you could do everything in any order. Starting a second time does not make sense, but leads to a critical situation.
I fixed this (disable start when on pause). This will be in the next beta as well.

In the logs I see still a lot of errors. Therefore a trace mode will be helpful as I currently don't see the segment, which cases the fault.

I recently uploaded this version and it should be easily updatable via internal updater now.

Michel

InFINNity-Deck, 2021-07-14:
Hi Michel,

thanks for the quick fix! We have the next session planned for early next week, so will let you know the result by then, including a new log-file in trace-mode.

I agree that starting  a second time does not make sense, but we accidentally hit the start-button instead of the pause-button, so it is good that you disabled that now.

Once again many thanks!

Nicolàs

InFINNity-Deck, 2021-07-19:
Hi Michel,

I am currently assisting my Canadian friend. We just installed 2.0.0b25, but still cannot get the camera to cool. After that tried 2.0.0b22, but that version too did not allow cooling. Could you please check again?

[mw4-2021-07-19.log](https://github.com/mworion/MountWizzard4/files/6838680/mw4-2021-07-19.log)

thanks,
Nicolàs

mworion, 2021-07-19:
Nicolas,
I think I misinterpreted the ASCOM spec and the defined properties. So HasCooler is a Property to be set in the original ASCOM CCDSimulator, but is not mandatory. Despite this fact CoolerOn is not mandatory nor does it needs to see HasCooler. So now I overwrite theses setting and catch exceptions in case of failing.
v2.0.0b26 should now shut cooler on and off and show the state if the property is implemented in ASCOM driver.
Michel

InFINNity-Deck, 2021-07-19:
Hi Michel,

Thanks for the quick update!
Indeed, these non-mandatory properties are not the programmer's best friend. We are going to do another run tomorrow, will install the new version first.

Nicolàs

InFINNity-Deck, 2021-07-20:
Hi Michel,

just tested 2.0.0b26 and it does cool the camera now, we are currently running a 74-point model.
Thanks a bunch again!

with kind regards,
Nicolàs

mworion, 2021-07-20:
Nicolas,
good to hear. If you don't mind I close the issue. In case of new things, please reopen or open a new one.
Michel

Closed 2021-07-20.

Thread 160 (2021-07-21):

Multiple ASI cameras: Device connect always shows ASCOM.ASI.CAMER2

Ruediger3, 2021-07-21:
Hi Michel,
I have two ASO connected to my NUC. When I select the first ASCOM Profile, MW keeps showing second profile, though it seems it connects the right camera.

Rüdiger

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

mworion, 2021-07-22:
Hi Rüdiger,
please post the log.  If I open the ASCOm chooser, it will always start on default order. The device I use (which is defined by it's name) is the text string in MW4 pop up window. The log contains the real connection name fed back from the driver. So we could look.

Target: Profile 1 has Camera 1, Profile 2 has Camera 2 in settings. Right ?
You could look in the two profiles for the selected camera in the driver / ascom / camera section with an text editor, or just post the two profiles.

Normally switching a profile should load the correct drivers stored.
Michel

Ruediger3, 2021-07-22:
Hi Michel,

please find the log attached.
You are right. But for testing I also switched the Camera to profile assignment.

I was stumbling upon when I had tried to activate the cooler and it was not working. I found out the ASI 174 was connected which has no cooler. switching to the other profile helped, but MW always show Profile2, though it is working.

All not a big deal, but confusing.

Best wishes
Rüdiger

[mw4-2021-07-21.zip](https://github.com/mworion/MountWizzard4/files/6861198/mw4-2021-07-21.zip)

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

mworion, 2021-07-22:
Rüdiger,
misunderstanding on my side: I though about profile in MW4 you are talking in profile in ASCOM. As I'm not a heavy ASCOM user, Could you explain how to use ASCOM profiles ?
My assumption: If you change the ASCOM profile, you disconnect you actual device and connect a new one outside MW4. If so, I do not recognize the device name change.
Michel

Ruediger3, 2021-07-22:
Sorry maybe I had not descried it properly.
1. in MW "Core device: Camera" I select the camera
2. There are two profiles (both created by ZWO ASCOM driver installation by default)
3. 3. Regardless what I choose, MW always shows that profile two was selcted, so it is actually not the case. MW connects the camera, which is linked to the profile. but MW does not show it.

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

mworion, 2021-07-22:
OK then I got it.
I stepped over it in another topic if the camera driver also includes a filter driver. Same story.
What happens so far: there is only one driver (which is in you case ASICamera2...) loaded, which emulates multiple virtual drivers (as they use basically the same driver) by adding new devices in the drop down list. I currently have no chance to access this device name list as it seems is stored internally. For my the straight forward way (as QSI did with an update of their drivers - one manages ccd and filter at the same time) is that the driver reports in chooser two separate names.

So actually if things do not change I have to set it to won't fix it.

Michel

Ruediger3, 2021-07-22:
Then it would better not to show any number. Just "connected". But by showing a dedicated number it gets confusing and misleading.

mworion, 2021-07-22:
The number is part of the ASCOM device name, so ASCOM generates this number in the name. So the text string is exactly the feedback from ASCOM and needed for distinguishing between real drivers.

Ruediger3, 2021-07-22:
Too bad :(

mworion, 2021-07-22:
Rüdiger, so far I close he issue with won't fix, but I keep in mind if there are some ideas to make it better.

Closed 2021-07-22.

Thread 163 (2021-07-29):

Updating satellites gets stuck in a file dialog

razvan-astro, 2021-07-29:
I went into the Satellites tab, selected Space Stations, clicked on Program Full Database, the 10M Updater was launched and proceeded until the moment in the screenshot where it stopped. There is an error in the log.

I was able to recover by pasting the path to `c:\apps\astro\10micron\Updater\satellites.tle` which had been updated and had the correct contents then proceeded manually through the rest of the steps in the 10M Updater. The issue did not occur while updating comets or other data (i.e. Earth rotation) which I had done in another MW4 session, minutes before.

As always, thanks for writing MW4!

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

Full log:

```
[2021-07-29 23:04:05.962][H][      loader.py][ 275] mountwizzard4    : 1.1.1
[2021-07-29 23:04:05.962][H][      loader.py][ 276] platform         : Windows
[2021-07-29 23:04:05.962][H][      loader.py][ 277] sys.executable   : C:\apps\astro\MountWizard4\venv\Scripts\python.exe
[2021-07-29 23:04:05.962][H][      loader.py][ 278] actual workdir   : C:\apps\astro\MountWizard4
[2021-07-29 23:04:05.962][H][      loader.py][ 279] machine          : AMD64
[2021-07-29 23:04:05.962][H][      loader.py][ 280] cpu              : Intel64 Family 6 Model 142 Stepping 9, GenuineIntel
[2021-07-29 23:04:05.962][H][      loader.py][ 281] release          : 10
[2021-07-29 23:04:05.962][H][      loader.py][ 282] python           : 3.8.6
[2021-07-29 23:04:05.962][H][      loader.py][ 283] python runtime   : 64bit
[2021-07-29 23:04:05.962][H][      loader.py][ 284] PyQt5 / Qt       : 5.15.4 / 5.15.2
[2021-07-29 23:04:05.962][H][      loader.py][ 286] ----------------------------------------------------------------------------------------------------
[2021-07-29 23:04:05.962][D][      loader.py][ 336] Using existing file: [de421_23.bsp]
[2021-07-29 23:04:05.962][D][      loader.py][ 336] Using existing file: [active.txt]
[2021-07-29 23:04:05.962][D][      loader.py][ 336] Using existing file: [tai-utc.dat]
[2021-07-29 23:04:05.962][D][      loader.py][ 336] Using existing file: [finals2000A.all]
[2021-07-29 23:04:06.044][D][     obsSite.py][ 123] Timescale is using built-in
[2021-07-29 23:04:06.604][D][automateWindows][ 115] Name: [10micron control box updater], path: [C:\apps\astro\10micron\Updater\tenmicron_v2.exe]
[2021-07-29 23:04:07.989][D][ tabSettMisc.py][ 176] Package Beta   : ['2.0.0b30', '2.0.0b29', '2.0.0b26', '2.0.0b25', '2.0.0b24', '2.0.0b23', '2.0.0b22', '2.0.0b21', '2.0.0b20', '2.0.0b19']
[2021-07-29 23:04:07.991][D][ tabSettMisc.py][ 177] Package Release: ['1.1.1', '1.1.0', '1.0.7', '1.0.6', '1.0.5', '1.0.4', '1.0.3', '1.0.2', '1.0.1', '1.0.0']
[2021-07-29 23:04:07.992][U][     mainApp.py][ 388] Message window: [A new version of MountWizzard is available!]
[2021-07-29 23:04:07.992][U][     mainApp.py][ 388] Message window: [Release notes for 1.1.1:]
[2021-07-29 23:04:07.992][U][     mainApp.py][ 388] Message window: []
[2021-07-29 23:04:07.992][U][     mainApp.py][ 388] Message window: [- bugfix for indi: cameras sending more than once INDI busy and exp = 0]
[2021-07-29 23:04:07.992][U][     mainApp.py][ 388] Message window: []
[2021-07-29 23:04:07.992][U][     mainApp.py][ 388] Message window: [ ]
[2021-07-29 23:04:09.692][U][     mainApp.py][ 388] Message window: [Enabled device:      [camera]]
[2021-07-29 23:04:09.692][U][     mainApp.py][ 388] Message window: [Enabled device:      [focuser]]
[2021-07-29 23:04:09.692][U][     mainApp.py][ 388] Message window: [Enabled device:      [telescope]]
[2021-07-29 23:04:09.692][I][astrometryASTAP][ 300] ASTAP OK, app: [C:\Program Files\astap/astap.exe], index: [C:\Program Files\astap]
[2021-07-29 23:04:09.692][I][astrometryASTAP][ 301] Index G17:True, G18:False, H17:False, H18:False
[2021-07-29 23:04:09.709][U][     mainApp.py][ 388] Message window: [ASTROMETRY found:    [ASTAP]]
[2021-07-29 23:04:09.709][D][  astrometry.py][ 301] Framework: [astap], True, True
[2021-07-29 23:04:09.709][U][     mainApp.py][ 388] Message window: [Enabled device:      [astrometry]]
[2021-07-29 23:04:13.647][D][    geometry.py][ 203] using [10micron GM1000HPS] geometry
[2021-07-29 23:04:14.123][U][     mainApp.py][ 388] Message window: [Model names refreshed]
[2021-07-29 23:04:14.755][U][     mainApp.py][ 388] Message window: [Align model data refreshed]
[2021-07-29 23:04:15.808][U][      loader.py][ 169] Click Tab     : [Satellite]
[2021-07-29 23:04:15.808][U][      loader.py][ 183] Click Object  : [MainWindowWindow]
[2021-07-29 23:04:15.917][U][      loader.py][ 169] Click Tab     : [Satellite]
[2021-07-29 23:04:15.918][U][      loader.py][ 183] Click Object  : [MainWindowWindow]
[2021-07-29 23:04:22.827][U][      loader.py][ 171] Click DropDown: [satelliteSource]
[2021-07-29 23:04:22.828][U][      loader.py][ 183] Click Object  : [MainWindowWindow]
[2021-07-29 23:04:22.908][U][      loader.py][ 171] Click DropDown: [satelliteSource]
[2021-07-29 23:04:22.909][U][      loader.py][ 183] Click Object  : [MainWindowWindow]
[2021-07-29 23:04:28.122][U][      loader.py][ 183] Click Object  : [qt_scrollarea_viewport]
[2021-07-29 23:04:28.122][U][      loader.py][ 183] Click Object  : [QComboBoxPrivateContainerClassWindow]
[2021-07-29 23:04:28.360][U][      loader.py][ 183] Click Object  : [qt_scrollarea_viewport]
[2021-07-29 23:04:28.360][U][      loader.py][ 183] Click Object  : [QComboBoxPrivateContainerClassWindow]
[2021-07-29 23:04:30.831][U][      loader.py][ 183] Click Object  : []
[2021-07-29 23:04:30.831][U][      loader.py][ 183] Click Object  : [MainWindowWindow]
[2021-07-29 23:04:33.719][U][      loader.py][ 183] Click Object  : []
[2021-07-29 23:04:33.719][U][      loader.py][ 183] Click Object  : [MainWindowWindow]
[2021-07-29 23:05:04.740][U][      loader.py][ 173] Click Button  : [progSatellitesFull]
[2021-07-29 23:05:04.740][U][      loader.py][ 183] Click Object  : [MainWindowWindow]
[2021-07-29 23:05:08.028][U][      loader.py][ 173] Click Button  : []
[2021-07-29 23:05:08.028][U][      loader.py][ 183] Click Object  : [QMessageBoxClassWindow]
[2021-07-29 23:05:08.273][U][      loader.py][ 173] Click Button  : []
[2021-07-29 23:05:08.274][U][      loader.py][ 183] Click Object  : [QMessageBoxClassWindow]
[2021-07-29 23:05:08.294][U][     mainApp.py][ 388] Message window: [Program database:    [Space Stations]]
[2021-07-29 23:05:08.294][U][     mainApp.py][ 388] Message window: [Exporting TLE data]
[2021-07-29 23:05:08.311][U][     mainApp.py][ 388] Message window: [Uploading TLE data to mount]
[2021-07-29 23:05:08.319][I][automateWindows][ 283] Using 64Bit backend uia
[2021-07-29 23:05:25.948][D][automateWindows][ 505] Updater win: [<pywinauto.application.WindowSpecification object at 0x000001D186642370>]
[2021-07-29 23:05:29.537][D][automateWindows][ 509] Updater popup: [<pywinauto.application.WindowSpecification object at 0x000001D180800940>]
[2021-07-29 23:05:48.620][D][automateWindows][ 512] Updater filedialog: [<pywinauto.application.WindowSpecification object at 0x000001D1EF813700>]
[2021-07-29 23:06:25.965][E][automateWindows][ 533] Error: Could not find 'File &name:Edit' in 'dict_keys(['Close', 'CloseButton', 'Button', 'Pane', 'Edit satellitePane', 'Edit satellite', 'Delete not selectedButton', 'Delete not selected', 'Button0', 'Button1', 'Button2', 'Button3', 'Delete selectedButton', 'Delete selected', 'Pane0', 'Pane1', 'Pane2', 'TLE elements', 'TLE elementsPane', 'Add from file...', 'Add from file...Button', 'Button4', 'Load from file...Button', 'Load from file...', 'Button5', 'Update from file...Button', 'Update from file...', 'Button6', 'ListBox', 'Header', 'Header ControlHeader', 'Header Control', 'NameHeaderItem', 'HeaderItem', 'Name', 'Catalog n.', 'Catalog n.HeaderItem', 'HeaderItem0', 'HeaderItem1', 'HeaderItem2', 'International id.HeaderItem', 'HeaderItem3', 'International id.', 'VerticalScrollBar', 'Vertical', 'ScrollBar', 'Line upButton', 'Line up', 'Button7', 'Thumb', 'Position', 'PositionThumb', 'Page downButton', 'Page down', 'Button8', 'Line down', 'Line downButton', 'Button9', 'ListItem', '1998-067PN', '1998-067PNListItem', '1998-067PPListItem', 'ListItem0', 'ListItem1', 'ListItem2', '1998-067PP', 'ListItem3', '1998-067RA', '1998-067RAListItem', '1998-067RC', 'ListItem4', '1998-067RCListItem', 'ListItem5', '1998-067RUListItem', '1998-067RU', '2015-049AListItem', 'ListItem6', '2015-049A', '2015-049G', 'ListItem7', '2015-049GListItem', 'ListItem8', '2017-042AA', '2017-042AAListItem', 'ListItem9', '2017-042C', '2017-042CListItem', '2017-042FListItem', 'ListItem10', '2017-042F', '2017-042H', 'ListItem11', '2017-042HListItem', 'ListItem12', '2017-042J', '2017-042JListItem', '2017-042K', 'ListItem13', '2017-042KListItem', 'TitleBar', 'Close0', 'Close1', 'Close2', 'CloseButton0', 'CloseButton1', 'CloseButton2', 'Button10'])'
[2021-07-29 23:06:25.965][U][     mainApp.py][ 388] Message window: [Uploading error]
[2021-07-29 23:06:25.965][U][      loader.py][ 173] Click Button  : [progSatellitesFull]
[2021-07-29 23:06:25.965][U][      loader.py][ 183] Click Object  : [MainWindowWindow]
[2021-07-29 23:11:53.268][U][     mainApp.py][ 388] Message window: [MountWizzard4 manual stopped]

```

mworion, 2021-07-30:
Hi,

some observed the same behavior Comets /Asteroids OK, Satellites not, because the file could not be automatically entered. Rüdiger had the similar case, one computer working, the other not. So it‘s an duplicate. So far we did not find out, what is the difference between a working and a not working setup as Rüdiger had a pc where is was working and not with the same setup.

Could you explain a little bit mor about you windows / language / python / what‘s o aver sertup ?

Michel

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

razvan-astro, 2021-07-30:
Hi Michel,

Windows is 10, Home, Canadian English. Python version is in the log file (3.8.6, 64-bit). The 10M software is from version 3.0, see attached screenshot for file properties (note that although it says Italian, the app is in English). Other than that, the setup has been the same for about a year. The last time I updated the satellites was in January - when it worked. I still have the logs from then, that's how I checked.

Something that I noticed in the error message,` Could not find 'File &name:Edit' in 'dict_keys`, is that the key has the ampersand in it (probably the accelerator marker), but none of the keys in the dictionary has it.

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

razvan-astro, 2021-07-30:
More info. I've just noticed the earlier bug report about the same issue, sorry, I missed it.  Below is the output from a few debugging statements in case it's relevant. I've no idea why one call returns en_GB. I'm sure that I have not changed it, though. It's possible there were changes in a Python library, though.

I'll leave it up to you whether you want to close the issue or not as duplicate, I understand you cannot reproduce it. Thanks for the work in MW4, as always.

```
print(locale.windows_locale[windll.kernel32.GetUserDefaultUILanguage()])
en_GB

print(locale.getdefaultlocale())
('en_CA', 'cp1252')

print (windll.kernel32.GetUserDefaultLangID())
4105
```

mworion, 2021-08-03:
Hi Razvan,

I made a special build v2.0.0b33 for testing the upload. Please make a test.

If upload hangs:
Please open the updater manually to the point where you could delete the entire list of satellites (without calling the file dialog) and delete the full list. Close the updater without uploading the sats (not necessary) and try an automated upload via MW4 again.

Please report back with log file. Many thanks.

Michel

razvan-astro, 2021-08-03:
Hi Michel,

The new build worked correctly, thank you! I'm attaching the log nonetheless in case it's of use. I will close the ticket.

[mw4-2021-08-03.log](https://github.com/mworion/MountWizzard4/files/6927099/mw4-2021-08-03.log)

Closed 2021-08-03.

Thread 167 (2021-08-15):

Image dont download

mhambuch, 2021-08-15:
Hi Michael

I have an issue with an Alcapa/Ascom remote server driven camera. Camera is recognized in MW4 and connected. When taking 1 exposure the image wont download. I have to abort the exposure. There is an error quoted in the log i attached.

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

blocked on download

[2021-08-15 08:15:14.520][C][       tpool.py][  92] C:\Users\PrimaLuceLab\Documents\MW4\venv\Lib\site-packages\mw4\logic\imaging\cameraAlpaca.py, line 187 int() argument must be a string, a bytes-like object or a number, not 'NoneType'

[mw4-2021-08-15.log](https://github.com/mworion/MountWizzard4/files/6987764/mw4-2021-08-15.log)

mworion, 2021-08-15:
Hi,
I revised the ascom handling with larger scale image sensors in version 2. I checked your issue with the actual beta and it should be solved. I will publish a beta (v2.0.0b40) this afternoon. If you update (it's close to release anyway) it should be solved.
To update use the script MW4_update_beta.bat to get it. From v2 on the internal updater should handle an further updates without a script.
Michel

mhambuch, 2021-08-15:
Hi Michel

Same issue with the latest beta version.

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

mworion, 2021-08-15:
Yes, the change for dressing the issue is in v40, which is not released yet. You tested with v39, so that's true.
Michel

PS: v40 will be available in about 1h from now

mworion, 2021-08-15:
v2.0.0b40 published

mhambuch, 2021-08-16:
Hi Michel
Still hanging on the download

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
[mw4-2021-08-16.log](https://github.com/mworion/MountWizzard4/files/6990048/mw4-2021-08-16.log)

mworion, 2021-08-16:
Hi,
I build a more deep test version v41 and uploaded it for this issue and increased the alpaca timeout value. Please raise the debug level under /settings/Misc from standard to debug and please test again.
Michel

mhambuch, 2021-08-16:
Hi Michel

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
[mw4-2021-08-16.log](https://github.com/mworion/MountWizzard4/files/6990359/mw4-2021-08-16.log)

mhambuch, 2021-08-16:
L‌atest log file i didnt manage to load it on github

De : "Michael"
A : "mworion/MountWizzard4" ,"mhambuch" ,"Author"
Envoyé: lundi 16 Août 2021 08:31
Objet : Re: [mworion/MountWizzard4] Image dont download (#167)
 

Hi,
I build a more deep test version v41 and uploaded it for this issue and increased the alpaca timeout value. Please raise the debug level under /settings/Misc from standard to debug and please test again.
Michel

—
You are receiving this because you authored the thread.
Reply to this email directly, view it on GitHub, or unsubscribe.

mworion, 2021-08-16:
HI, which size does it has ? Is it too large?
Two possibilities: Zip it or make a log only in debug, without trace.
Michel

mhambuch, 2021-08-16:
still timeout line at timestamp 7:35:30
[mw4-2021-08-16.log](https://github.com/mworion/MountWizzard4/files/6990566/mw4-2021-08-16.log)

mworion, 2021-08-16:
...build v42 with extending timeout and more logging. Trace mode should be ok right now (with smaller logs). Please delete the old one of today.
Michel

mhambuch, 2021-08-16:
seems to work now!

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
[mw4-2021-08-16.log](https://github.com/mworion/MountWizzard4/files/6990662/mw4-2021-08-16.log)

mworion, 2021-08-16:
OK, we are one step further. Please try v43 as there was a hidden topic.
Michel

mhambuch, 2021-08-16:
YES!

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
[mw4-2021-08-16.log](https://github.com/mworion/MountWizzard4/files/6990706/mw4-2021-08-16.log)

mworion, 2021-08-16:
OK, I think that was also the final clue to it (after visiting the log). Closing the issue. In case of further observations, please reopen again.
Michel

mhambuch, 2021-08-16:
yes thanks a lot

mworion, 2021-08-16:
Yes, MW4 is async and it's intended that processing time and slewing time could run in parallel to use time best.

mworion, 2021-08-16:
Just on reminder: Please take care that in your setup the values for focal length and aperture are set. otherwise the plat solve has some issues in finding this right image scale in pixel / arcsec.

mhambuch, 2021-08-16:
Thanks Michel, I have a question regarding the model names. I understand that the mount can store several models and that mw always stores those in the mount.So when i build a new model, at the end of the process i see in the log a line telling it stores it in the mount. So what name is then used as i havent saved is as ... at that time.  is it the "actual" one ? Also if i have a model that i want the mount to use i need to save it as "actual" as i understand that this is the one of current use by the mount?Is my understanding correct?Many thanks
-------- Message d'origine --------De : Michael ***@***.***> Date : 16/08/2021  10:19  (GMT+01:00) À : mworion/MountWizzard4 ***@***.***> Cc : mhambuch ***@***.***>, Author ***@***.***> Objet : Re: [mworion/MountWizzard4] Image dont download (#167)
Just on reminder: Please take care that in your setup the values for focal length and aperture are set. otherwise the plat solve has some issues in finding this right image scale in pixel / arcsec.

—You are receiving this because you authored the thread.Reply to this email directly, view it on GitHub, or unsubscribe.

mworion, 2021-08-16:
To clarify this point:
In the mount there is only one actual model. If you build a new one, this is it. This model does not have any name in the mount. If you build a new one, it's just overwritten.
The mount offers to store the actual model in a separate location in the mount (which is only the resulting model). There you could choose a name and you will see this models as list under /Manage Model tab lower right corner. You have to explicitly store it with a new you would like to take and could also retrieve it from the mount storage. All models in the mount are not accessible outside the mount!
MW4 itself stores automatically all necessary data for the model builds in the work directory. This might include the images taken for a model run, too. With this data, you could rebuild the model at any time again. So it's not the model itself (as it could not be retrieved from the mount), but all data to rebuild it without taking images etc.
Please bear in mind, that models (and of course the underlying model data) is invalid if you do physical changes to your setup.  So keeping many model for running them actively might not make much sense. To keep the data to compare changes over time (without using them actively) does make some sense.
Michel

mhambuch, 2021-08-16:
All clear, makes sense. Thx
-------- Message d'origine --------De : Michael ***@***.***> Date : 16/08/2021  11:35  (GMT+01:00) À : mworion/MountWizzard4 ***@***.***> Cc : mhambuch ***@***.***>, Author ***@***.***> Objet : Re: [mworion/MountWizzard4] Image dont download (#167)
To clarify this point:
In the mount there is only one actual model. If you build a new one, this is it. This model does not have any name in the mount. If you build a new one, it's just overwritten.
The mount offers to store the actual model in a separate location in the mount (which is only the resulting model). There you could choose a name and you will see this models as list under /Manage Model tab lower right corner. You have to explicitly store it with a new you would like to take and could also retrieve it from the mount storage. All models in the mount are not accessible outside the mount!
MW4 itself stores automatically all necessary data for the model builds in the work directory. This might include the images taken for a model run, too. With this data, you could rebuild the model at any time again. So it's not the model itself (as it could not be retrieved from the mount), but all data to rebuild it without taking images etc.
Please bear in mind, that models (and of course the underlying model data) is invalid if you do physical changes to your setup.  So keeping many model for running them actively might not make much sense. To keep the data to compare changes over time (without using them actively) does make some sense.
Michel

—You are receiving this because you authored the thread.Reply to this email directly, view it on GitHub, or unsubscribe.

Closed 2021-08-16.

Thread 168 (2021-08-15):

Fast allign: Not working - stays deactivated

Ruediger3, 2021-08-15:
Hello Michel,

last night I would have needed the function "fast align" for the very first time (after collimation of the CDK). I was not able to get it active. Though camera, Solver everything was connected this function remained deactivated. The mount was configured to accept aliments in the setup.

I will not exclude a handling issue, but I could not figure out how to get it work.

Thank you!
Rüdiger

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

mworion, 2021-08-15:
Hi Rüdiger,
no handling issue, you were the first one stepped over it! Has to be sorted out.
Michel

Ruediger3, 2021-08-15:
Cool, like always. ;)

mworion, 2021-08-15:
:-) to be honest: I also never used it. It was a function, which came from MW2/3 as then people did a lot "quick" fixes for the model.
BTW: if you are the only one using it :-) could you describe the use case in more detail, probably it makes sense to tailor it for that.
Michel

Ruediger3, 2021-08-15:
Hi Michel,

this was also a quick fix. Yesterday night it was quite cloudy and only some holes. I did collimation on the CDK. By shifting the secondary of course the model became invalid (approx. 20').
Due to the clouds it was impossible to make new model, which would have been the mandatory next step for sure. So to continue with work and hit any desired target at 8m FL, I decided to sync the model since the secondary mirror shift introduced a constant offset. So this should work perfectly.
Since it was not working in MW I did it in a planetary software and send a sync command from there via ASCOM, which I actually dislike, since I have to change settings in ASCOM driver. Next time your forget it to reverse....

I hope I could explain it.

For me the function in MW would have been perfect when it would had worked as described in the text next to it. The functionality is perfect. I should only work :)
For quick fix it is quite neat.

Cheers
Rüdiger

mworion, 2021-08-15:
v2.0.0b40 published

Ruediger3, 2021-08-15:
Thx! Installed.
Now only the weather must get better to test it.

Cheers
Rüdiger

mworion, 2021-08-15:
Sure. BTW: Any remarks to the new updater. So far I did not got issues with it.

Ruediger3, 2021-08-15:
Works very well. No issues. Only message window tells me there is a new version, so I have the latest Beta. That's confusing.

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

Ruediger3, 2021-08-16:
Thanks for fixing :)
b43 now suppresses the message.

Ruediger3, 2021-08-24:
Hi Michel,
just tested an works as expected now.
Was extremely useful. Just had to align the current model at FL=8855mm since FOV=0.16° for planetary imaging.
Thx!

Cheers
Rüdiger

Closed 2021-08-24.

Thread 171 (2021-08-20):

Feature Request: Redo failed points at any later time later

Ruediger3, 2021-08-20:
Hi Michel,

Current:
Missed points are repeated right after finishing the last point in the point model.

Feature:
To store the current status with the model to disk, and reload it with status so can repeat the failed points at any time and not only at right at this moment when making a new model.

Motivation:
When creating a model during full moon, there is a pretty large are you can not shot and solve. So you have a quite big undefined area. Repeating right after the last point is useless, since has not moved too far.
So it would be great to load the partial model after a couple of hours and repeat the missed points when the moon has significantly moved or is not visible at all. Also it would help to improve areas by adding some points, if it turns out there is a not well behaving area.

What needs to be done:
Store the status of the model points after model run to file.  modify load and store. Have a button to add failed points to model.

Cheers
Rüdiger

mworion, 2021-08-20:
Hi Rüdiger,
use case understood, but keeping a full state of model build stored in a full async behavior would stress the architectural design of MW4.
You anyway could combine multiple (partly) models afterwards (of course if you did not change mechanics in between).
What about offering an "auto-pause" before starting the retry ?
Michel

Ruediger3, 2021-08-20:
Hi Michel,

I am not sure I understand the architectural conflict, since basically you only need to store the point spread and result for each point.

Combining two models could work, but never tried. The problem is, you have to create always a new specific secondary point spread for the failed area.  Probably it is easier and quicker to create a complete new model the next night.

I think "auto-pause" is of no use in this case. You would have to wait at least one or two hours at minimum in the case of full moon. During that time you cannot use the system for any other observations or activities.

It a real asynchronous repeat of failed points is not feasible, the only option is to trash the model and make a new one.

BTW: I come to these points because I am currently collimating the CDK. Any adjustment voids the model significantly. So you have to redo the models very often. Also tonight where we have almost full moon. While preparing the best strategy I stumbled upon this use case.

Cheers
Rüdiger

mworion, 2021-08-20:
Rüdiger,
I understand your use case. Changing collimation (therefore I stay with refractors) invalidated model. Do you do only collimation work or do you in between use time for imaging as well ? If not the simplest way is really to take the model as is and redo it next time. Otherwise, let me think how we could sort this out without changing to much (and much work)
Michel

Ruediger3, 2021-08-20:
The model is required, other wise you cannot slew to the bright stars to continue your work. If you work at extream large FL you have no chance to find your calibration star manually again.
I have tried the last time and that took me to the "align model" issue. But if this is working now, it might be sufficient for this use case.

Also after finishing you work, you want to use it. Hence you create a fresh model - as good as possible in that night. If you have a definition gap due to full moon, you have to re-do the model the next day instead of just filling the gap.
It is not crucial, but it safes a lot of time.

Let's put this on hold. Maybe if we both get bored (which we both know will never happen :) ) we can review this point.
I will check out how it is working tonight. Maybe I have a new idea. Let's see.

Anyway thanks for your great support.

Closed 2021-08-20.

Thread 174 (2021-08-28):

Image does not show

mhambuch, 2021-08-28:
[mw4-2021-08-29.log](https://github.com/mworion/MountWizzard4/files/7072055/mw4-2021-08-29.log)

Hi Michel,

I have a new camera ASI6200 MM Full Frame. Image exposes, downloads but is not shown in the image window.
Timeout like last time. Ascom Server is on the same PC as MW4 and all other Apps i use.

i just notived that a couple of seconds after having taken the 2s exposure, the entire ascom server crashes, i get a notepad log that i also attached. There the issue is an out of memory. Eagle3 PC has 16GB Ram and the only  apps running at time of crash are ascom server, mw4 and MGbox. On the server configuration panel there is an option to run drivers in separate threads which is selected by default, nothing about memory allocation.

Use this ticket to ask one question. Does binning influence the result (quality) of the model? So does it make sense to bin 2x2 to speed up download and therefore model creation?

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

[ASCOM.RemoteAccessServerException.0907.251850.txt](https://github.com/mworion/MountWizzard4/files/7072072/ASCOM.RemoteAccessServerException.0907.251850.txt)

mworion, 2021-08-29:
Hi,
just by looking on the log I see the image is not fully downloaded, but MW4 tries to show it - which ended in some error messages. This I have to correct to be more robust against broken images. The reason why might be the ASCOM server and the memory (but that‘s just a guess).
Important for you modeling: If you are using e.g. ASTAP for solving, there is no need to use the full image. ASTAP likes according to Han (the developer) about 1500 x 1500 pixel. So I definitely would go for bin2 or even bin3 or choose a subframe to reduce size. THis should not impact your model.
Michel

Ruediger3, 2021-08-29:
Hi both,
I use the same camera and it works flawless with Bin2 for me. Also Bin1 had no issue, but it is not required.

CS
Rüdiger

mworion, 2021-08-29:
Rüdiger,
thanks for the feedback, your are using ASCOM, where as the issue occurred with ALPACA. It might be the case, that the alpaca server tries to hold the complete image in memory.
Michel

Ruediger3, 2021-08-29:
Had used 🦙 before native ASCOM was reimplemented and also had no issue as far as I remember.
But meanwhile a lot has been changed.

CS and nice Weekend!
Rüdiger

mworion, 2021-08-29:
Ok another point:
I see in the log an error relating the filter number. Somehow the ASI Filter seems not to transfer a number, but something else. Would you mind to make a short test for the filter with Trace mode in debug enabled an post this log? Many thanks.
Michel

mhambuch, 2021-08-29:
Thanks Michel, Ruediger,

I will post the result of the Filter later this afternoon.

mhambuch, 2021-08-29:
Hi, i just started mw4 and changed the filter number. The display is effectively strange.

Hope the log helps.

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

[mw4-2021-08-29.log](https://github.com/mworion/MountWizzard4/files/7072798/mw4-2021-08-29.log)

mhambuch, 2021-08-29:
trace modus
[mw4-2021-08-29.log](https://github.com/mworion/MountWizzard4/files/7072808/mw4-2021-08-29.log)

mworion, 2021-08-29:
Thanks for the extended Log. There is more to to as there is a missing link between filter driver and returned value on alpaca side. As I‘m currently not able to build MW4 (on a trip), this may take some time to find out.
Michel

mhambuch, 2021-08-29:
No pb, thanks for your support. The app is really great!

mworion, 2021-09-04:
Marc,
I think I got the image not show issue solved (at least on MW4 side). If the ALPACA server fails due to memory problems, MW4 should be robust against a not transmitted image.
Please submit the issue with the Exception also to ASCOM / ALPACA to get this topic solved. Please be sure that you have the latest ASCOM / ALPACA versions installed as there were some issues in earlier versions.

To your question about the filter names: The come from the driver. The ASI FW driver should be able to set names for each filter. If MW4 does not get one, it will show 'not found'.

The ASCOM / ALPACA definition of filter positions is 0 to N-1,  so 0 to 6 would be OK, but the it should show the names define in the driver. In case the driver does automatically give the names as default and it is 1 to 7, so you have the explanation of the mismatch.
Michel

mhambuch, 2021-09-05:
Thanks Michel, i will test it as soon as you deploy the beta with the fix. Marc

mworion, 2021-09-05:
Marc,
there is a v2.0.2b1 uploaded, please try it and report back. I might not sort out all things, but I need to know if I'm on the right way.
Michel

mhambuch, 2021-09-05:
Hi Michel,

Thanks a lot for having already pushed a correction. Alcapa is interesting as it allows me to focus in SGP before switching to MW4 (a focusing routine in MW4 would be "the hammer" i guess you say in Germany)

I tested the exposing n worked in bin2 full frame ; switched then to bin1 and camera gone + alcapa dump. On MW4 it stays on exposing 0s.

Marc

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

[mw4-2021-09-05.log](https://github.com/mworion/MountWizzard4/files/7111955/mw4-2021-09-05.log)

[ASCOM.RemoteAccessServerException.1804.506310.txt](https://github.com/mworion/MountWizzard4/files/7111957/ASCOM.RemoteAccessServerException.1804.506310.txt)

mworion, 2021-09-05:
Hi Marc,
thanks for testing. So far MW4 does not throw any error more.  You could just press abort on image windows to stop. As the ALPACA server is responding without any error, MW4 keeps waiting for the response (or error). So hardly anything to do about it.  I've seen you opened an issue on ASCOM Remote. So hopefully this will be sorted out soon.

I added the focuser interface already, so a manual focus could be done. I has not to be perfect to do a model, as the solver normally tries to find the center itself (BTW: some focus routines perform on the base on source extraction, which is also the base for a solver). So good from eye is good for modeling.

I put the autofocus on the wish list....

What about the filter topic ?

Michel

mhambuch, 2021-09-05:
Hi Michel, Yes there is nothing more you can do for the imaging. It is now proper as it does not crash anymore when alcapa has the out of memory. For the filter, i maintained their names on the alcapa server side setup, those a shown in mw4, so perfect. I just found it strange at the beginning that the number starts at 0, but yet i know.All fine on my side, ill close the issue.For the focuser, you are right, a manual focusing does it even if it is not always easy to check the number of pixel displayed. Maybe there are some open source for this. Lets see if other users propose that addon.Many thanksMarc
-------- Message d'origine --------De : Michael ***@***.***> Date : 05/09/2021  18:33  (GMT+01:00) À : mworion/MountWizzard4 ***@***.***> Cc : mhambuch ***@***.***>, Author ***@***.***> Objet : Re: [mworion/MountWizzard4] Image does not show (#174)
Hi Marc,
thanks for testing. So far MW4 does not throw any error more.  You could just press abort on image windows to stop. As the ALPACA server is responding without any error, MW4 keeps waiting for the response (or error). So hardly anything to do about it.  I've seen you opened an issue on ASCOM Remote. So hopefully this will be sorted out soon.
I added the focuser interface already, so a manual focus could be done. I has not to be perfect to do a model, as the solver normally tries to find the center itself (BTW: some focus routines perform on the base on source extraction, which is also the base for a solver). So good from eye is good for modeling.
I put the autofocus on the wish list....
What about the filter topic ?
Michel

—You are receiving this because you authored the thread.Reply to this email directly, view it on GitHub, or unsubscribe.

Closed 2021-09-05.

Thread 176 (2021-09-01):

MW4 is slewing mount while image is still being exposed.

tbessell, 2021-09-01:
I'm using Indi/Ekos on a Raspberry Pi 4. While MW4 is building the model, about half the images contain a light streak on the brightest stars. This does not prevent astrometry.net from solving the image, but I wonder if it affecting the accuracy. I have adjusted the mount settle time, but this makes no difference because the problem occurs at the end of image exposure and the next mount slew.
[image-012.fits.zip](https://github.com/mworion/MountWizzard4/files/7087555/image-012.fits.zip)

mworion, 2021-09-01:
Hi,
sorry to hear this. This might be an issue with the INDI states transfer as getting the download mode right is tricky. It would be very helpful, if you could post the LOG file ideally in trace mode (under settings/misc). If you did not have the log in trace mode, please set it and make another test run. In this case it is not necessary to get real images nor they have to be solveable.
Many thanks,
Michel

tbessell, 2021-09-01:
Michel,
Thank you for a fine piece of software and for the suggestion. I will try to get a log file tonight.

I should mention that I am not running MW4 in a python virtual environment, but rather from a local installation. Is it possible that could be the cause?

mworion, 2021-09-01:
No, MW4 will install anyway a virtual environment through the scripts. It's definitely better as running plain as the config of the systems and their installed libraries might interfere.

tbessell, 2021-09-01:
hahaha! Well, I'm running a really customized system and I didn't use the install scripts, but one thing at a time. I will post a log file soon as I am able.
Thank you again for looking into this, it is greatly appreciated.
Tim

tbessell, 2021-09-02:
Michel,
Here is a log file for your inspection. I had some problems that you might see at the beginning of the log. I didn't notice that my camera was not connecting in mw4. After a few tries, I was able to run a few models. The log should contain all the info.
Thank you kindly for your tremendous effort and clear skies to you,
Tim
[mw4-2021-09-02.log.zip](https://github.com/mworion/MountWizzard4/files/7100708/mw4-2021-09-02.log.zip)

mworion, 2021-09-04:
Hi Tim,
I think I understood (hopefully) the situation. Just to explain: I use a signal after image is integrated and starting to download as the start signal for slewing the mount to the next point. ASCOM and ALPACA could provide these signals, INDI does not. So to make this happen there is a workaround I made: I wait for exposure = 0 as end of integration as replacement. When I look to the INDi driver implementation, the send of exposure = 0 comes before the driver starts to grab the image from the camera. So it may be the case on a raspi that the performance is sometimes not good enough to process the grab before sending the image. My suspicion is, that starting the grab also ends the image integration in the ASI framework. If so I only could think about workarounds.
There are two ways to do this: First: hanging the ASI INDI driver -> has to be done by someone else as I'm not the owner of the driver. Second: Introducing a conservative timing mode for MW4. This could be done by myself, but takes some time.

But anyway: if the images with the single trails look like the on you posted, there should be no impact on solving as the solver normally throws start rails or undefined clusters away. And you ave more than enough other stars for solving.

I'll keep this point open for the timing issue and try to provide a beta with this function for you to test.
Michel

tbessell, 2021-09-04:
Michel,
After looking at the trace log, your explanation is about what I surmise is the problem, namely timing. I also looked at some of the code in mw4 (the trace log hints), but I don't know python very well. MW4 quite complex, thought I understand the logic enough to follow code.

One additional point. It seems that the star trails happen mostly on the longer slews. When the mount only has to move a relatively short distance, the images are perfect.

All that aside, I will trust your conclusion that it has no effect on plate solving and wait for a beta to test for you.

Thanks again for looking into this. Hopefully I can help make MountWizzard a better product for the astronomy community.
Tim

mworion, 2021-09-05:
Tim,
important hint about the slew time in relation to the star trails. My explanation bases on an to early slew start, you is pointing to a too early exposing start. The latter one show be addressable by mount settle time. As I have a very rigid system with a focal length only 570mm I could set the settle time to 0 without seeing any issues. I know people with fl of about 2000mm - 4000mm which use settle times of 20-30 s to get their system set. To distinguish between this two assumptions: you said mostly. To be precise about the correlation: does mostly mean you never saw a short slew with trails ? Or does is say whenever I saw trails it was a longer slew ?
Yes, all feedback helps to make it better as the systems (computer setup, used framework and astronomy setup) vary that much and mostly I don't have or know the components used.
Michel

tbessell, 2021-09-05:
Michel,
Now I wonder if my complaint suggests a wrong conclusion. I tried mount settle times up to 12 seconds with no difference in the images, maybe that wasn't enough. Next opportunity I have I will try to discover the condition which causes the trails more precisely.

Mount GM1000 HPS, telescope 10" RC fl 2000mm

thanX
Tim

tbessell, 2021-09-06:
Michel,
Now I really feel kind of stupid because I bothered you with this non-existent issue.
Your last post that suggested mount settle time was the real answer to my problem. I tried settle times of 30 s and 20 s and that seems to have fixed the problem. No more star trails!

I ran three models, after the first and second, I did a polar alignment. Then ran a third model, RMS 3.6" without deleting a single point.

Thank you so, so much for helping me understand and again, sorry I made you chase a problem that doesn't exist. New mount, new scope, and new software. Really through me off!

Tim

tbessell, 2021-09-06:
Issued Closed

mworion, 2021-09-06:
Tim,
Great to hear that you made it and don‘t worry about the topic!
Michel

Von meinem iPad gesendet

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

Closed 2021-09-06.

Thread 186 (2021-09-13):

Analyses: Sort by Az/Alt on X-achsis instead of number

Ruediger3, 2021-09-13:
Hi Michel,

many charts have as X-Axis the number of the point. Unfortunately the numbering is completely random, depending how you are defining it. After adding one manually, it is out of order.

To improve readability and also human interpretation, I'd suggest to test to use the ALT or AZ coordinate instead of "Star Number". By that you can interpret the results geometrically and do not need to think about the numbering. This would make them much easier to read and interpret.

Cheers
Rüdiger

mworion, 2021-09-14:
Rüdiger,
the order is exactly how the points are build (and the mount moved). So this is a important information. It could make sense to add other plots to get more information. If so, we should carefully check which ones help the most.
Michel

Ruediger3, 2021-09-14:
Hi Michel,

fully agree the it sometimes is very helpful to see the sequence in which the points were taken, but since they can be in a total weird sequence and completely out of order, where the numbers are not having any correlation to position it is of limited use.
I totally agree it is useful if they are well sorted. And I also agree we should keep them.

But I suggest to have a button to switch to a second view, in which the graphs use ALT and AZ instead of "Point Number". Theses are much easier to understand and also provide much information. E.g. you can identify regions with flexure or regions of impacted visibility. Currently this is only possible, if I re-map the graphs substituting the point numbers by there actual ALT,  AZ coords.
I agree: This can also be achieved in polar diagram, but more or less only qualitative and not quantitative.

I hope I could make this better understandable.

Cheers
Rüdiger

Ruediger3, 2021-09-14:
One additional point:
The point number has one advantage: You stay with 2D Plot.
If you want to visualize F=Error(Az, ALT) you get a 3D Plot. I admit, things get more elaborate. I also agree it needs some more thinking, but It would be a value add on in my point of view.

Rüdiger

mworion, 2021-09-14:
Rüdiger,
as I do not do that much Analyse about model myself, most of the charts happened based on our early discussions. Please feel free (based on your experiences) to define this windows (or a set of plots) how it could be helpful for the customers. I will see, how I could make this happen.
Michel

Ruediger3, 2021-09-14:
Hi Michel,

many thanks. Much appreciated your support, but I also want not to cause too much effort. This only a proposal, since I have had some issues to properly interpret the existing diagrams.

For the beginning two plots would help me, which are basically identical and only differ in Z-axis:

1. 3D-Plot: RA-Error against Alt/Az
X-Axis=AZ
y-Axis=ALT
z-Axis=Raw Error RA

2. 3D-Plot: DEC-Error against Alt/Az
X-Axis=AZ
y-Axis=ALT
z-Axis=Raw Error DEC

Purpose: This is quite similar to the polar plot and helps to identify the week areas. Only the visualization is different. One drawback is, you do not see the vector of the delta, but this can be checked then in the polar diagram.

This is only a proposal for discussion.

Thank you!
Rüdiger

han-k59, 2021-09-14:
Plotting the raw error using alt & az position would make more sense to me then a star number. Maybe the raw ra & dec raw error could be indicated by vectors in a hemisphere.  The length of the vector would indicate the error. The orientation the az/alt ratio. A 3d graph would be the other possibility.

Han

Ruediger3, 2021-09-14:
Thanks fort he feedback! I share your opinion.

Rüdiger

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

mworion, 2021-09-18:
Hi,
attached a proposal for this topic:
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
Michel

Ruediger3, 2021-09-19:
Hi Michel,
many thanks for the POC. It looks great to me and reveals more information as before. They are much easier to read in my point of view.

Two suggestions:
1. the X-Axis should be ticked in 90° steps instead of 100 steps,
2. Possibility to identify the point with mouse over to see the number in order to delete the correct one.

Many thanks!
Rüdiger

han-k59, 2021-09-20:
Looks good.

ACMBakx, 2021-09-29:
May I add to this conversation?
When I build a custom map, I expect that the trajectory I choose is followed by MW4.
But it does not. When I set some points on a horizontal line going north to south, then move up a bit and start my way back again to make a zig/zag path up to the top, MW4 does not follow the order I put the points, but makes unwanted (for me) changes to the trajectory. It took me many many efforts to get this one made.
[Champignon90pts.zip](https://github.com/mworion/MountWizzard4/files/7252277/Champignon90pts.zip)

mworion, 2021-09-30:
Hi Arie,

I answer your topic (it's off in this thread as this one only deals about analyse window):
- I checked your points file: you could get it (regardless which order of points you had before in this file) by using auto sort High / Low.
- to the behavior you experienced in adding points (and please rise any idea how to make it better). I need to have a compromise between adding a point to the end of the list (regardless where it was added) and inserting a point between two other points just by one left click (as remove is just right click). Actually it works by searching the next closest point and adding the new one after that.
Hope this helps

Michel

Closed 2021-10-31.

Thread 188 (2021-09-21):

Help with Drivers and Set Up in MW4

PwrHsePro, 2021-09-21:
I have about 80 hours in trying to help a school system set up their observatory... I, of course am donating this time, and its an hour drive each way from my home to this observatory... and time is running short...

Every company I go to to help get things set up, after they confirm the item is working, points me at you... theMW4 folks... to figure out how it is supposed to work with your software.

The problem items include, but may not be limited to:

Boltwood/Clarity II
Pier-Tech Roll-Off-Roof and Electronic Pier

Both of these work on their own, and according to MW4, show Green in ENVIRON and DOME... unfortunately, in MW4, the Environ tab when open, in large font says, "Offline Mode" and the roof and pier don't budge...

I am happy to schedule some time for someone to TeamViewer in like Diffraction Limited did for me last week... I'd be happy to take off work to facilitate this.

Thank you in advance for your efforts,
Jeff

mworion, 2021-09-22:
Hi Jeff,
sure, we could arrange a teamviewer session where I could try to help in setting up the system. As I'm still very busy on work saturday or sunday would be the best solution. You are on central time correct ?
Michel

PwrHsePro, 2021-09-22:
Excellent!

Yes,  we are Central time, and weekends can work for me too... we do have a number of public events over the next few weeks, but I'd like to try to work around them...

Maybe you could suggest a few dates and times we could narrow it down?

Clear Skies!
Jeff

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

mworion, 2021-09-22:
Hi Jeff,
I tried to do some preparation. From what I get, you need help in setting up the BoltWood Weather station in MW4 as well and the RoRo feature (open/close) from dome settings. And perhaps some other hints for MW4. Anything I miss ? If so, we don't need to be there during night (which might be tricky du to the 8h time difference). Sat or sun this weekend (and perhaps the next as well I could try to arrange, ideally around 8pm to 11pm Munich time which should be noon to 3pm your time. What do you think ?
Michel

PwrHsePro, 2021-09-22:
I agree...We dont need a night time, but will.make what ever hours that are convenient for you work...Can we start with 8pm your time 12 noon my time on Saturday?I think youve covered current issues...It looks like the Environment (Boltwood/Clarity) connects as does the Dome (Pier-Tech Roll Off and electronic pier) but neather do anything qhen manipulatedClear Skies!Jeff
-------- Original message --------From: Michael ***@***.***> Date: 9/22/21  13:22  (GMT-06:00) To: mworion/MountWizzard4 ***@***.***> Cc: PwrHsePro ***@***.***>, Author ***@***.***> Subject: Re: [mworion/MountWizzard4] Help with Drivers and Set Up in MW4 (#188)
Hi Jeff,
I tried to do some preparation. From what I get, you need help in setting up the BoltWood Weather station in MW4 as well and the RoRo feature (open/close) from dome settings. And perhaps some other hints for MW4. Anything I miss ? If so, we don't need to be there during night (which might be tricky du to the 8h time difference). Sat or sun this weekend (and perhaps the next as well I could try to arrange, ideally around 8pm to 11pm Munich time which should be noon to 3pm your time. What do you think ?
Michel

—You are receiving this because you authored the thread.Reply to this email directly, view it on GitHub, or unsubscribe.Triage notifications on the go with GitHub Mobile for iOS or Android.

mworion, 2021-09-22:
Jeff,
yes. Ideally a temviewer session. Let's see how far we get.
Michel

PwrHsePro, 2021-09-24:
Looking forward to our meeting!

mworion, 2021-09-25:
Hi Jeff,
not really. I saw that you are using a BoltWood weather station. There is a ASCOM driver for getting this data from the file you showed. This driver is downloadable from [https://ascom-standards.org/Downloads/ObservingConditionsDrivers.htm](url) (Boltwood Weather driver). Perhaps you have gotten a newer one, but I tried this and it was able to read a test file. This we need to be installed if you did now have done it anyway.
See you in about 10 hours! You could contact me directly for the TeamViewer session details: michael@wuertenberger.org
Michel

mworion, 2021-09-26:
Closing the issue, we stay in contact.
Michel

PwrHsePro, 2021-09-26:
Thank you!Clear Skies!Jeff
-------- Original message --------From: Michael ***@***.***> Date: 9/26/21  03:29  (GMT-06:00) To: mworion/MountWizzard4 ***@***.***> Cc: PwrHsePro ***@***.***>, Author ***@***.***> Subject: Re: [mworion/MountWizzard4] Help with Drivers and Set Up in MW4 (#188)
Closing the issue, we stay in contact.
Michel

—You are receiving this because you authored the thread.Reply to this email directly, view it on GitHub, or unsubscribe.Triage notifications on the go with GitHub Mobile for iOS or Android.

Closed 2021-09-26.

Thread 190 (2021-09-22):

2.1.0b1: Crash on device connect

Ruediger3, 2021-09-22:
Hi Michel,

when hitting connect, MW crashes to desktop.
Log attached.

Rüdiger
[mw4-2021-09-22.log](https://github.com/mworion/MountWizzard4/files/7214072/mw4-2021-09-22.log)

Ruediger3, 2021-09-22:
Downgraded to 2.0.4: works

Ruediger3, 2021-09-23:
Hi Michel,

sorry I do not understand your comment.
This crash is different. The first crash is in Satellite window when moving the sphere and this is a crash on ASCOM device connect.
Rüdiger

mworion, 2021-09-23:
Hi Rüdiger,
from MW4 logs, there is nothing I could see in both cases. Issue 189 with the message on the terminal windows leads to win32 integration (which is only used when using ASCOM devices), the second issue 190 is direct related to ASCOM use. Rollback to 2.0.4 fixes the problem in both cases. ASCOM Initializing is the part I tuned performance. Therefore I put the issues together. Did you have some message in the terminal window in issue 190 as well? Perhaps same message? As I do not see the crash when connecting ASCOM devices on windows, could you point to a special driver? There are COM drivers and dotNET driver and COM Servers (Drivers which are built as .EXE). This might help.
Many thanks,
Michel

mworion, 2021-09-23:
Rüdiger,
2.1.0b2 is online
Michel

Ruediger3, 2021-09-23:
Hi Michel,

The error in command and crash is fixed. That.
Another error is coming in this and beta before when calculating satellites:
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

Ruediger3, 2021-09-23:
Sorry, I have to correct my self. It only worked one. Now MW crashes on ASCOM connect again.

Ruediger3, 2021-09-23:
Hi Michel,

I got the trouble maker! It ts the connection to skymeter for some reason. Currently it is not plugged in via USB. Even if no device is connected and I want to change it to disabled since it is not connected MW crashes.

Please see here what I mean:
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

mworion, 2021-09-23:
OK this helps,
I made some tests, too: There is a leftover message in terminal window. This warning I know, nothing serious, working to eliminate this.
To the ASCOM.OCH.HUB: if I run ObservingCondistion Hub Tester from ASCOM suite (without running MW4), the tester crashes as well. Could you check this please ?
Michel

Ruediger3, 2021-09-23:
No problem there (see below). I also use it with NINA. Also no issue. Only MW reacts allergic.
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

mworion, 2021-09-23:
Reinstalled ASCOM, now I see the Observation Conditions Hub. An I get MW4 to crash. So I could work now.

mworion, 2021-09-26:
Hi Rüdiger,
2.1.0b3 should solve the issue
Michel

Ruediger3, 2021-09-26:
Hi Michel,
i can confirm. Its fixed. Many thanks.
Rüdiger

Closed 2021-09-26.

Thread 191 (2021-09-29):

MW4 crash

ACMBakx, 2021-09-29:
Last night I tried to build a new model.
I had the Scopedome disconnected and rotated the dome by hand.
This to speed up the process significantly.
I noticed during a first short trial of 25 points that the download of the images (as it appeared to me) took sometimes very long.
Most images came in quick and were solved ok, but some took a long time.
So the time gain by manually slewing the dome was actually zero.
I had 2.03 installed and upgraded to 2.04 on the last run. Maybe there was a bug in 2.03?
But that did not cure the problem.
Anyway, I wanted the 90 pts custom made model to run and started it off,
Again the download of the images was very random fast to slow and came finally to a complete halt.

maybe from the log you can tell what the problem is.

Regards
Arie
[Champignon90pts.zip](https://github.com/mworion/MountWizzard4/files/7252340/Champignon90pts.zip)
[mw4-2021-09-28.log](https://github.com/mworion/MountWizzard4/files/7252341/mw4-2021-09-28.log)

mworion, 2021-09-30:
Hi Arie,
out of the log:
- I see many temporary socket timeouts for the connection between mount and pc. Anything happened in the connection? 2nd instance of MW4 running (load)? Wireless connection? This might explain some delays
- I've seen a bug in command stop exposure in MW4 -> this I is corrected in the 2.0.5 service release now
- You slew your dome manually and have better speed? Could you explain, why the slew from MW4 takes longer?
- The complete halt might be caused by the socket timeouts as well.
Michel

ACMBakx, 2021-09-30:
I tried MC2 after this and that crashed too.
Martin tells me from the log that there is a communication problem with the mount that causes this.
You tell me something similar. Something to investigate.
I noticed that that when the mount finished a slew it took a unusual long time before I got the beep from the mount that it had finished the slew. That’s usually after a second or so. This time this took much longer.
What I meant with manually rotating the dome, I have the motor mechanically disengaged from the drive mechanism. Like that the dome rotates freely. Very light. Can do it with my finger tips. The mount slews a lot faster than the dome ever will, because of its mechanics. Like this a 90 pts model should only take 20-25 minutes only versus 1.5 x 2 hrs So this has nothing to do with MW4.
I did however beef-up the electric motor from 12v 100w to 12v 150w and a stronger powersupply unit from 12v 180w to 13.8v 320w.  With this the dome slewing is a lot more responsive.
Regards
Arie

mworion, 2021-09-30:
Hi Arie,
dome topic understood. If I look to you points file, this is not optimal for dome use. Normally I should be possible to run a model with only one complete turn of the dome without changing direction or something else. MW4 with East West sorting the points and enable dome following feature should do the trick. I would be happy to check in which setting we get to model run time at least to 30-40 min without any manual work.
Michel

ACMBakx, 2021-09-30:
To minimize the dome slewing I have tried to follow the slot with the telescope.
Set the dome in a certain azimuth. Then take 5 shots with the telescope at increasing altitude. Say 5 shots.
Flip the telescope over and take another 5 shots coming back down again.
Slew the dome 15° and repeat the process for a full circle. Then the dome makes only 1 turn at 15° steps.
The result was an awful distribution of survey points. Some dense areas and some big voids.
So that did not work.
East/West sorting is perfect for a fork mounted telescope. But the GEM offset forces the dome to make extreme slew corrections at higher alt's  Sometimes way more than 90°. For the next point, which then sits at a low alt, the dome has to slew back again.
Especially these high alt points make the dome slew like crazy.
With my point model the dome makes only small slews for most points and the high alt ones aren't that many are taken as the last ones. Well, that's my theory. . . . . . .
If you plot the dome positions along the survey points sequence, you should see these excessive slews at high alt telescope positions.
Add to that the Scopedome "unwind" feature, that causes the dome to slew at times "the long way around" instead of the shortest slew distance. This is caused by the limitation of the dome position encoder, which has a limited "max" value. When this will be exceeded with a slew, the dome rotates the other way around to reduce the encoder position value.
It is not as straight forward as it should be. I also guess that different domes use different control soft and hard ware, for simplicity.

mworion, 2021-10-02:
Arie,
I put that as a task who to optimize this especially for small domes. Larger ones should not be that influenced as the GEM offset might be smaller.
Closing the original issue, but definitely learn what happened regarding the connectivity issue as I might be able to detect such an issue and give some hints in the message window.
Michel

ACMBakx, 2021-10-05:
Michael,
I found the cause of the problem: the camera!
The new Touptek2600Pro is having problems with downloading images to the PC. This became very eratic after some time.
I suppose this has confused MW4. The camera is send back to Lacerta for investigation.
I have tried it with different USB cables and sockets and on 3 different PC's. All the same. Camera is NBG.
Currently I have the Atik16200 installed again on my Epsilon. Because the Atik ascom driver is a real hopeless piece of .... and NINA has a  native driver for this camera that works and MC2 offers the option to image via NINA, I ran a 95 points model yesterday evening. This went perfect. Not a single point lost. Proving that the equipment in the dome is ok.
As soon as I have the opportunity I'll do a model-run using MW4 (latest release) and 'll let you know.
Arie

Closed 2021-10-02.

Thread 196 (2021-10-11):

Feature request: Sorting points to minimize dome slewing

ACMBakx, 2021-10-11:
[Model_Sorted_EW.xlsx](https://github.com/mworion/MountWizzard4/files/7324765/Model_Sorted_EW.xlsx)
[Model_Sorted_for_Dome.xlsx](https://github.com/mworion/MountWizzard4/files/7324766/Model_Sorted_for_Dome.xlsx)
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
I just want to bring up the idea once more.
Attached 2 sheets. I copied the numbers from a log file of a real run I did recently.
One is showing how MW4 sorts the points in E/W order as is shown in the image.
You see how the dome slews forward **and backwards** to follow points that run from East to West.
The other one is rearranged and shows the sequence for minimal dome slews.
Would it be useful to have this "sorting option" too?

ACMBakx, 2021-10-15:
SUCCESS!!
We have some kind of clear sky for a few hours, so just ran the point model again.
This time every point was platesolved and MW4 performed as it should.
As to be predicted, around 180° Az the mount was flipping like a madman.
Pier side East. Pier side West. And back again.
But the dome was steady. Multiple images were taken without slewing the dome.
Duration of the run was just under 30 mins. You can tell from the log. (27 mins)
So the duration was about the same as the standard East/West sorting run.
A lot of time was spend on the numerous meridian flips. Some 10-15 I believe.
But the dome slewing (or lack there of) was significant reduced.
PAE and RMS are the same as before. (after knocking off one point)
So for me this run was succesfull.

And I have made my point . . . . . . . .   :-)

Arie

[mw4-2021-10-15.log](https://github.com/mworion/MountWizzard4/files/7355732/mw4-2021-10-15.log)
t.

mworion, 2021-10-16:
Hi Arie,

Good to hear! Would you accept such a solution for sorting, regardless of the flips the mount does?

Michel

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

ACMBakx, 2021-10-16:
I would welcome it for sure.
But if I am the only user with his request, do not bother.
You'll have to calculate all the dome positions up front obviously.
But It wil be up to the user to determine what is most feasable for him.
I can imagine if you have a big mount with multiple heavy telescopes on it and/or are having flex/flop problems, that much flipping may not be welcome. But a big and heavy dome could greatly benefit from the lesser amount of slewing.
As I said before, it will be a trade-of between the two.
My mount is light (1000hps) and carries only one light and stiff telescope. I have the slew rate set at max 7° .
But a 3000 or 4000hps loaded to its max will be a different situation.
Maybe check with Nicolás what he thinks about the idea.

Arie

InFINNity-Deck, 2021-10-16:
Hi Arie and Michel,

In my case the dome slews at about the same speed as the mount, so there is little gain in having one or the other doing the slews. The only major improvement would be avoiding a 180 degrees dome slew for a minor mount slew.
Still I find this an interesting concept, but fear for two things:
- the amount of additional stress put on a mount when fully loaded
- quality degradation due to flexure

The first is only marginally worrying, adding some more heavy slews to the mount's life. After all we are not doing this every night... ;-) If it would become an issue, the mount slew speed could be lowered.

The flexure is another story. Any flexure in the mounting of the scope, it's focuser or camera mounting could be adding to inaccuracies, depending on the speed at which this flexure happens. The are quite a few people around imaging with SCTs, which have the habit to suffer from mirror-flop due to play between the mirror-tube and central-baffle-tube. The grease in between the two is generally quite thick and I have seen mirror-flop occurring minutes after the scope was flipped. Passing the meridian with a single flip will produce one odd image, while passing it over and over again may result in either all good images or all bad, depending on the time between images and the time required for the grease to let go of the mirror.

Nicolàs

ACMBakx, 2021-10-16:
I have to add to the conversation that in my configuration with a small dome (they don’t come any smaller) the effect of the GEM distance is quite severe. It causes a wide area Az were the mount will peek around the corner in two directions, causing lots of flips. I was expecting a comment like Nicolás is making, but needed to here from himself. Thank you Nicolás for responding.
Also in my case there was no gain in time. What was gained by one, was lost in the other.
I have my mount settling time set at 2 sec only. (Yet the RMS=5) But some have it set at 20sec(?) with a reduced slew speed.
Maybe you can put it out in a beta version and let others try and comment on it. If it is not liked, you throw it out again.
I will keep the dome sorted points-file for myself anyway.

Arie

mworion, 2021-10-16:
Hi Arie,
first having your log file with the break after the 14 point inspected, I see a new model start after point 14. So this made mixing a second model run in a already running one. Do you have any idea what happened ? The result is obvious as MW4 could not handle two sessions in parallel - > does not make sense. I try t avoid this, but the might be a possible user input or technical backdoor which enables a second run.

To the dome topic:
Sorting the azimuth as real azimuth of the dome should be possible. The point with the remarks of Nicolas is, is that in overall a new sorting offer or do we (I) have to think about further optimizations to make that usable on a broader base.
Michel

ACMBakx, 2021-10-16:
When MW4 stopped at station 14, I sat and waited a while for things to re-commence. When that didn’t happen, I clicked the Run button again and MW4 appeared to restart all over.
I should have stopped and restarted MW4, I suppose, to get a clean start again.
A user-input error I would say.
I am not sure that I understand what you mean with “usable on a broader base”.
Can you offer it as a 3rd option, which is only shown/offered when in the settings a dome is configured?
Then non-dome users are not bothered/confused by it.

mworion, 2021-10-16:
Hi Arie, Nicolas,
though about this my proposal: I do a regular points cloud. This could also be used with features like auto delete points within meridian limits (reducing flips there). Then calculating all real dome Azimuth values and sorting the point cloud for East / West but now for dome Az and not for mount Az. So I get the following results for Aries demofile

Original manual sorting from Arie:
![Uploading Bildschirmfoto 2021-10-16 um 17.57.35.png…]()

Using that data for East / West sorting:
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
I agree, that will move the dome more frequently

Now adding the dome Az sorting:
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
This is not far away from the manual sorting. But as said could be used for any selected method of getting a point cloud.

For avoiding to much flip, you could add the constraint with meridian limits and you get:
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

So this work is done. Arie: could you check in you manual sorting with the result of the automatic one (3rd). I know it's the other way round for the dome, but should not introduce more slews. If that makes sense, I would ask you to test this, I will build a beta in an hour (2.1.0b7) with the feature implemented. Please be aware that calculating the dome Az for all the build points through the mount (I need to know which flip side it will take) take some time. You will see the progress bar in sorting group:

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

Feedback welcome.
Michel

ACMBakx, 2021-10-17:
Upgradet to 2.1.0b7 successfully.
But now MW4 does not start anymore.
I see in a blink in the cmd-window a few lines flashing by, Then this window closes again.
No log is being generated.

mworion, 2021-10-18:
Hi Arie,
unfortunately I cannot see any point with this behavior on my windows10 test equipment.
From which version did you upgrade? For an analyse could you post your config file?
To restart make a backup your config directory and empty it after that, please try to start MW4 again.
Michel

ACMBakx, 2021-10-20:
They are both part of the same event.
I managed to stop the movieplayer a fraction of a second apart and took screenshots.
The last line says there is a type error somewhere . . . . . .?
I can easily go back installing 2.0.5 or 6 using the command line pip install mountwizzard4==etc.
Tried to do that with 2.1.0b7. Get the message that the installation went ok.
But it does not start up.

mworion, 2021-10-20:
Arie,
Just make a new folder and copy the scripts in the folder and run install. You get a second, fully independent install. Nothings else to change, please keep everything else. To run MW4 in new install, run MW4Run from the new folder.
Michel

Von meinem iPad gesendet

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

mworion, 2021-10-31:
Hi Arie,
still working robustness, but still can't catch the issue in my setup. I set this point as remark.
If you would like, have a look to the (hopefully) last beta before the release 2.1. It also adds some color themes:
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
I close the original issue as sorting work out nicely.
Michel

ACMBakx, 2021-10-31:
OK, wildo AFO.
Color schemes will be appreciated I am sure.
Arie

Verstuurd vanaf mijn iPad

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

Closed 2021-10-31.

Thread 200 (2021-11-13):

Version 2.1, conflict between mount IP and taking pictures

farn32, 2021-11-13:
As soon as I enter an IP Adress for the mount in the menu settings / mount, there is no way for taking pictures anymore. When I clear the field with the IP Adress I can get pictures again.

As you can see in the pictures when the mount is connected there aren't any mount parameters in mountwizzard (RA, DEC, etc). I don't now why is this?
Of course as you can see I use an old mount driver (2.15.1). I use this one because it works very well guided or unguided and I red alot of ugly things about the new drivers. Before version 2.1 I didn't have any problems.
Do I have to change the driver?

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

mworion, 2021-11-13:
Hi Fritz,
could you add the log file as well (ideally logging set to debug under settings / misc)
Michel

mworion, 2021-11-13:
Add about other remark:
You're not talking of a driver, it is the overall firmware of the mount itself. I also heard about some issues in later firmwares, but I never experienced one myself. But It's a decision on your own if you would like to change.
As Info: as long as you stay on 2.x you should be able to go back. Once you upgraded to 3.x, your will not get back to 2.x versions.
For MW4 I recommend a 2.16.x as there are many functions not available in earlier versions. But there is not need to get to the latest one (3.x).
Hop this helps.

farn32, 2021-11-13:
Hi Michel

Sorry, of course it's the firmware of the mount not a driver.
I don't know about the firmware change maybe the 3.0.8 would be possible, because the guiding changements and the balance issues should be restored to the 2.x versions.

I did the following:

run mountwizzard
connecting the camera and the filterwheel
taking two pictures (works well)
enter the mount IP
taking two pictures (have to abort it, because they cannot be saved)
delete the mount ip adress
taking two pictures (works well)

[mw4-2021-11-13.log](https://github.com/mworion/MountWizzard4/files/7532867/mw4-2021-11-13.log)

Thanks alot for you time

Fritz

mworion, 2021-11-14:
Hi Fritz,
please update to 2.1.2, which should fix the issue. Regarding the mount connection (which was to problem): I see a lot of connection issues. So something must be wrong (wireless connection, stability?).
Regarding the firmwares: please hav a look to the 2.16.13 (latest 2.x) which could be OK for you as well. But please check your preferences.
Michel

farn32, 2021-11-14:
Hi Michel

Thanks alot for your help. I think, that I will change the firmware to 2.16.13 as you mentioned.  For the update to mountwizzard I tried with the update script, but 2.1.2 is not available. Do I have to update without the script.

Fritz

mworion, 2021-11-14:
2.1.2 will need about 30 min as build takes some time

farn32, 2021-11-14:
Thanks alot Michel I installed the mount firmware 2.16.13 and the new version of mountwizzard. Everything seems to work again.
Thanks alot for your help and the great work.
By the way I think, that I installed the newest version but it says 2.1.0.

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

All the best

Fritz

mworion, 2021-11-15:
Hi Fritz,
this is strange. Could you post a log from an update run ?
Michel

farn32, 2021-11-15:
Hi Michel

Here's the log.

[update.log](https://github.com/mworion/MountWizzard4/files/7540417/update.log)

Fritz

alexxw24, 2021-11-17:
Hi Michel,

great piece of software. It worked all fine but lately upraded my mount to 3.0.8 and since then taking picture with DSLR isnt possible anymore. Strange enough with my ZWO ASI 120MC guiding cam it still does.

Have tested it on an Intel NUC running ubuntu 20.04 as well as on an Raspi 4 both not working. On a Win10 notebook/laptop with the ASCOM.DSLR driver it works.

Taking out the mounts ip didnt made a change on the linux systems neither.

Please find enclosed latest log. As I understood downgrading from 3.x mount firmware back to 2.x isnt possible so would be great if there is some fix.

Thanks for looking at it.

Alex

alexxw24, 2021-11-17:
[link to latest log file](https://hidrive.ionos.com/lnk/EDuRDjkt)

mworion, 2021-11-20:
Hi Alex,
I would sort your issue out with a separate issue number. Could you open one (or we use the one you opened recently). It's not the same than from Fritz.

Basically the firmware version does not have anything related to imaging (beside having a mount connection).
Michel

mworion, 2021-11-20:
Fritz,
I checke the update log. For some reason you are not working with MW4 in a virtual environment. This is not OK and something went wrong. This also explains, why you upgrade, but still do not see the actual version number.
Could you explain, how you installed MW4 first and how you did the upgrade ? Did you use the scripts? Which version ? If you still have the install log, please post it as well. For further tests, please open a command window and change directory to you working directory. Then please try the next commands and post the output:

dir (just to get the contents)
python3 --version
python3 -m pip list

if the is a venv directory in your work folder present:

./venv/Scripts/activate

-> then there should be a (venv) prefix in command window

python3 --version
python3 -m pip list

Thanks,
Michel

farn32, 2021-11-20:
Hi Michel

I did a new install, first python 3.9.8 and then I used the scripts I downloaded from the link:
**MountWizzard4/support/Windows_Scripts.zip**

**Install Log:**
[install.log](https://github.com/mworion/MountWizzard4/files/7574709/install.log)

**output from the commands:**

_dir_

 Verzeichnis von C:\Users\fritz.arn\Desktop\MWWork

19.11.2021  07:05    <DIR>          .
19.11.2021  07:05    <DIR>          ..
09.11.2021  23:19            27’648 CFF132_G316200_MW4.cfg
09.11.2021  23:09            27’648 CFF132_G316200_MW4_.cfg
10.11.2021  18:23    <DIR>          config
14.11.2021  13:02    <DIR>          data
14.11.2021  18:05    <DIR>          image
09.11.2021  23:03             9’385 install.log
09.11.2021  23:04    <DIR>          measure
09.11.2021  23:04    <DIR>          model
13.11.2021  23:27            51’613 mw4-2021-11-13.log
14.11.2021  19:55           241’034 mw4-2021-11-14.log
15.11.2021  18:11             6’568 mw4-2021-11-15.log
19.11.2021  07:06            20’160 mw4-2021-11-19.log
09.11.2021  22:39             3’553 MW4_Install.bat
09.11.2021  22:39             2’077 MW4_Run.bat
09.11.2021  22:39             2’352 MW4_Update.bat
19.11.2021  07:05                 0 run.log
09.11.2021  23:04    <DIR>          temp
19.11.2021  07:05             7’167 update.log
09.11.2021  23:00    <DIR>          venv
09.11.2021  22:40    <DIR>          __MACOSX
              12 Datei(en),        399’205 Bytes
              10 Verzeichnis(se), 381’045’686’272 Bytes frei

_python --version_

Python 3.9.8

_python -m pip list_

C:\Users\fritz.arn\Desktop\MWWork>python -m pip list
Package            Version
------------------ ---------
astropy            4.3.1
certifi            2021.10.8
charset-normalizer 2.0.7
colour-demosaicing 0.1.6
colour-science     0.3.16
comtypes           1.1.10
cycler             0.11.0
deepdiff           5.5.0
idna               3.3
imageio            2.9.0
importlib-metadata 4.6.4
jplephem           2.16
kiwisolver         1.3.2
matplotlib         3.4.2
mountwizzard4      2.1.2
numpy              1.21.2
ordered-set        4.0.2
Pillow             8.3.1
pip                21.2.4
pybase64           1.2.0
pyerfa             2.0.0
pyparsing          3.0.5
PyQt3D             5.15.4
PyQt3D-Qt5         5.15.2
PyQt5              5.15.4
PyQt5-Qt5          5.15.2
PyQt5-sip          12.9.0
python-dateutil    2.8.2
pywin32            301
pywinauto          0.6.8
qimage2ndarray     1.8.3
requests           2.26.0
requests-toolbelt  0.9.1
scipy              1.7.1
sep                1.2.0
setuptools         58.1.0
sgp4               2.20
six                1.16.0
skyfield           1.39
urllib3            1.26.7
wakeonlan          2.0.1
websocket-client   1.2.1
wheel              0.37.0
zipp               3.6.0
WARNING: You are using pip version 21.2.4; however, version 21.3.1 is available.
You should consider upgrading via the 'C:\Users\fritz.arn\AppData\Local\Programs\Python\Python39\python.exe -m pip install --upgrade pip' command.

C:\Users\fritz.arn\Desktop\MWWork\venv\Scripts>_activate_

(venv) C:\Users\fritz.arn\Desktop\MWWork\venv\Scripts>_python --version_
Python 3.9.8

(venv) C:\Users\fritz.arn\Desktop\MWWork\venv\Scripts>

(venv) C:\Users\fritz.arn\Desktop\MWWork\venv\Scripts>_python -m pip list_
Package            Version
------------------ ---------
astropy            4.3.1
certifi            2021.10.8
charset-normalizer 2.0.7
colour-demosaicing 0.1.6
colour-science     0.3.16
comtypes           1.1.10
cycler             0.11.0
deepdiff           5.5.0
idna               3.3
imageio            2.9.0
importlib-metadata 4.6.4
jplephem           2.16
kiwisolver         1.3.2
matplotlib         3.4.2
mountwizzard4      2.1.0
numpy              1.21.2
ordered-set        4.0.2
Pillow             8.3.1
pip                21.3.1
pybase64           1.2.0
pyerfa             2.0.0
pyparsing          3.0.5
PyQt3D             5.15.4
PyQt3D-Qt5         5.15.2
PyQt5              5.15.4
PyQt5-Qt5          5.15.2
PyQt5-sip          12.9.0
python-dateutil    2.8.2
pywin32            301
pywinauto          0.6.8
qimage2ndarray     1.8.3
requests           2.26.0
requests-toolbelt  0.9.1
scipy              1.7.1
sep                1.2.0
setuptools         58.5.3
sgp4               2.20
six                1.16.0
skyfield           1.39
urllib3            1.26.7
wakeonlan          2.0.1
websocket-client   1.2.1
wheel              0.37.0
zipp               3.6.0

mworion, 2021-11-20:
Hi Fritz,
as you could see, you have two different MW4 versions installed and we have still the MW4 install in the system itself.
Normally if you deinstall python and python launcher and reinstall python (not just overinstall), the system packages should be removed and you will have a clean install. If you once made a MW4 install manually with

pip install mountwizzard4

without having the virtual environment enabled (see prefix), you have the install as systemwide done - not good.
Please remove python and python launcher and reinstall python. The command python -m pip list should show not more than 3-5 entries, never more.

If you test different installations (you could have more than one), please use a separate workfolder for each install. Please do not do the new version inside an actual worker. You might mix up the script locations and the install they reference. So please a clean set: worker with scripts and all what will be installed and generated during runtime. If you would like to share configurations, just copy them from subdir to subdir (please do not  copy the venv folder)

After the install script, python -m pip list still will show these 3-5 items max. So in set system there will be no install at all.
If you activate the venv with the command activate (prefix shown), the same command python -m pip list will show you the full install.

Michel

farn32, 2021-11-20:
Hi Michel thans alot for your help.
This is a bit too much to unserstand because of this python thing. OK in short I deinstall all the python stuff and then I'll do a fresh install according your installation manual:

python and mountwizzard, with the scripts, is that right?

Your manual says the following:

Warning
Windows makes a hard split between 32bit and 64bit versions. If your drivers and setup uses 64bit solutions, please install 64bit python!

Depending on your Windows version please download or directly run the web installer from:

https://www.python.org/downloads/windows/

and follow the installation procedure.

Warning
Please take care that during the installation the checkbox “Add Python Path” is selected and to install for a single user if you want to use the scripts.

Sorry for that.

Fritz

mworion, 2021-11-20:
Fritz,

If you want, we could do a teamviewer session ?
Michel

Von meinem iPad gesendet

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

farn32, 2021-11-20:
Hi Michel,

Thanks alot for the offer, I'll try it and when it won't work I'll contact you again.

I really want to steal your time :)

I report back...

Thanks alot for the great support.

Fritz

farn32, 2021-11-20:
Hi Michel

I did the reinstall and I think, that everything looks good. The command python -m pip gives more than 3 to 5 entries, about the same as before.
At the moment the newest version 2.1.2 is installed.

I tried with the moravian camera and the connected mount and it works with taking pictures.

[install.log](https://github.com/mworion/MountWizzard4/files/7575062/install.log)

[update.log](https://github.com/mworion/MountWizzard4/files/7575063/update.log)

Thanks alot for your help.

Fritz

mworion, 2021-11-20:
Fritz,
great to hear. Have fun. Closing the issue. If problem come back, please reopen or create a new one !
Michel

Closed 2021-11-20.

Thread 201 (2021-11-19):

MW4 not imaging with Canon DSLR Indi driver

alexxw24, 2021-11-19:
Hello,

my GM2000 (FW 3.0.8) is connected via LAN to an Intel NUC (NUC5CPYH) with an freshly setup Ubuntu Mate 20.04. with only Kstars/Ekos, Indi and MW4 installed.

My DSLR (Canon EOS 70D) works absolutely fine with EKOS and no issues starting the driver, etc.
Connection to the DSLR in MW4 is all fine and green.

However, when pressing "Expose 1" in the Imaging window a message appears in the message window "exposing" but nothing more happens. Shutter not released, etc. looks like no exposure command is/can be send for any reason. After 10-20 sec I press abort.

Also tried via the Indi GPhoto CCD driver, same behaviour. As said in Ekos all works fine.

Please find enclosed Debug as well as trace log.  Hope you can have a look at it.

Would be great to find a solution as really like MW4 and running it with an Linux setup would be my preferred solution.
"Fortunately" weather is s*** here in Germany - so no imaging time wasted yet :-)

Thanks a lot and kind regards,
Alex

[mw4-2021-11-19-debug.log](https://github.com/mworion/MountWizzard4/files/7569159/mw4-2021-11-19-debug.log)
[mw4-2021-11-19-trace.log](https://github.com/mworion/MountWizzard4/files/7569160/mw4-2021-11-19-trace.log)

mworion, 2021-11-20:
Hi Alex,
I checked the logs. Do you have to intermittent presence of camera device? Normally you should not be able to expose without camera present. I added for a test (version 2.1.3b0) for that and will bring up some error message if that's happening. If possible, could you make a screen video, how that happens?
Michel

alexxw24, 2021-11-20:
Hi Michel,

the camera is present and green all the time and as said working well with Kstar/Ekos.
Will download the update, try again and send logs.

Thanks for your effort.

Alex

alexxw24, 2021-11-27:
Hi Michel,

had another try with the updated version.

Exposure still not possible with my EOS 70D. When plugging in my CCD it works straight without any issue.

RMS 2,1" with an 21 point model 😊

However must be an issue somewhere between Indi and my DSLR.

However will soon switch to a new astrocam anyway.

Thanks again for your support and this great piece of software.

Kind regards,
Alex

mads0100, 2021-12-01:
Hi Michel,  as you requested. I can't image using EKOS/Nikon DSLR. In addition, I cannot update any of the files on the mount; there appears to be some type of error with saving files... I think it's related to the imaging issue. Logs attached.

[mw4-2021-11-30.log](https://github.com/mworion/MountWizzard4/files/7630503/mw4-2021-11-30.log)
[mw4-2021-11-29.log](https://github.com/mworion/MountWizzard4/files/7630504/mw4-2021-11-29.log)

mworion, 2021-12-02:
Hi Chris,
could you state if the DSLR could do subframes and binning or how this is treated in EKOS if you are using the camera. I do not have a DSLR so I could not check.
Michel

mworion, 2021-12-02:
I build a beta for you (v2.1.4b0). It could be accessed via internal updater. Please check if exposing works now.
Michel

mads0100, 2021-12-02:
WILCO, I'll try it when I get home from work.  I don't think binning works,
but it can do a subframe (what that actually means for the camera I'm not
sure though).  It does that in the focus module of EKOS.

Do you have any idea about the saving files thing?  I was looking at the
logs when I tried to update the mount and it seemed to indicate that it
couldn't save.  It should be in the 30 November log.

Chris

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

mworion, 2021-12-02:
The updater (I think you mean this), was the next topic to sort out for astroberry. This should be fixed in v2.1.4b4 now.
So if you try, please the latest beta which is the above one.
Please update with

python3 -m pip install mountwizzard4==2.1.4b4

If you are using the internal updater to an earlier version, you are loosing this function again and have to do a manual update

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

mads0100, 2021-12-02:
Wilco, I came home early. I’ll give it a shot in a little bit. Thanks again!

Chris

Sent from my iPhone

On Dec 2, 2021, at 13:01, Michael ***@***.***> wrote:

The updater (I think you mean this), was the next topic to sort out for astroberry. This should be fixed in v2.1.4b4 now.
So if you try, please the latest beta which is the above one.
Please update with

python3 -m pip install mountwizzard4==2.1.4b4

If you are using the internal updater to an earlier version, you are loosing this function again and have to do a manual update

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

—
You are receiving this because you commented.
Reply to this email directly, view it on GitHub, or unsubscribe.
Triage notifications on the go with GitHub Mobile for iOS or Android.

mads0100, 2021-12-02:
I can't sem to get the original version working.  I'll send you a picture.
Logs are attaced.  When I tried the python3 command to get b4, it crashed
out in the install.  I'm assuming it's related to the issues we had before
with requiring a script to install it?

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

mads0100, 2021-12-02:
Picture of the error.

Sent from my iPhone

On Dec 2, 2021, at 13:11, Chris Madson ***@***.***> wrote:

 Wilco, I came home early. I’ll give it a shot in a little bit. Thanks again!

Chris

Sent from my iPhone

On Dec 2, 2021, at 13:01, Michael ***@***.***> wrote:

The updater (I think you mean this), was the next topic to sort out for astroberry. This should be fixed in v2.1.4b4 now.
So if you try, please the latest beta which is the above one.
Please update with

python3 -m pip install mountwizzard4==2.1.4b4

If you are using the internal updater to an earlier version, you are loosing this function again and have to do a manual update

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

—
You are receiving this because you commented.
Reply to this email directly, view it on GitHub, or unsubscribe.
Triage notifications on the go with GitHub Mobile for iOS or Android.

mworion, 2021-12-02:
Chris,
if you attache the logs and image just by email, they were not added on GitHub. You have to drop them there.
Michel

mworion, 2021-12-03:
v2.1.4 will fix the issue. Tested from @mads0100

mworion, 2021-12-07:
Chris, Alex,
could you provide some DSLR color images as FITS, which are still raw (no debayer)?
I need some for testing.
Many thanks in advance.
Michel

mads0100, 2021-12-07:
Of course, I'll send them to you after work.

Chris

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

mworion, 2021-12-07:
Great! Many thanks !

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

mads0100, 2021-12-14:
I'm sorry, I let this drop through my cross check.  I'll send them over
today after work.

I did run through another alignment/model build and it's working as
advertised.  One question, per some guys on Cloudynight, they recommend 12
stars for the initial polar alignment model.  Is there a way to make the
options for the basic alignment 3-6-12?

https://www.cloudynights.com/topic/752802-building-10micron-models-and-the-things-that-affect-models/page-8

This will take you to the page; it's a post from 'tonk' who is the
knowledge expert (at least on CN).

Another question, is there a way to use the EKOS internal plate solver vice
just ASTAP/Astrometry?

Chris

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

mworion, 2021-12-14:
Hi Chris,
added 12 as well. You will see that in 2.1.7b0 and later versions.
Regarding the solver: no as for long time ASTAP was also a well used solver for EKOS.
Michel

mads0100, 2021-12-15:
https://drive.google.com/file/d/1goDz7KuhHmiCBIYLPcnSy3b1wO-_2QoF/view?usp=sharing

Hope this helps!

Chris

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

Closed 2021-12-03.

Thread 215 (2022-01-11):

Beta: 2.2.0b2 erratic errormessage when setting gain value with NINA controlled camera

Ruediger3, 2022-01-11:
Hello Michel,
I cannot set gain, when the camera is connected as NINA controlled. I guess I have to manage that via NINA (as default gain), but the error message is confusing. Any way to control it via MW? This might be a trap, when you rely on the settings made in MW e.g. having set gain = 100, but actually shooting in gain = 0 since this is the default in NINA.
Same with offset.

Rüdiger

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

Ruediger3, 2022-01-11:
I have tried several ideas, but you can only change offset and gain when disconnecting the camera in NINA and reconnect it with different default settings, but I have not found any way to change the settings without interruption. This is problematic, since you interrupt the cooling process. Is there any way to send required gain and offset from MW?

Rüdiger

mworion, 2022-01-12:
Hi Rüdiger,
thanks for the feedback. During the upcoming weekend I try to disable all UI elements, which are useless during App controlled and check the implemented API‘s.
Michel

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

Ruediger3, 2022-01-12:
Hi Michel,
this makes definitely sense, but how to control gain and offset?

Rüdiger

mworion, 2022-01-12:
Rüdiger,

the way for MW4 is: If device is NINA controlled (camera), you only could change Exposure Time and Binning. These are the minimum parameters for NINA API to work. No property else will be read or set nor does the connection state be changed from MW4 side. So everything set in NINA should stay. I checked this now with the simulator and it does in the next beta.  In this case I remove all GUI elements nor be there.

If MW4 controlled the full API (which is not that much more) including the connection state is handled through MW4. I will look, if Gain and Offset could be changed through API, a first try failed.

Michel

Ruediger3, 2022-01-12:
Thanks for the update.

mworion, 2022-01-15:
Rüdiger,
the actual beta should be ready for having the topics solved. The NINA only as well as the MW4 controlled setup.
Actually NINA has a bug on the API as it does not change cooler temp when set (SGPro does).
Michel

mworion, 2022-01-22:
Hi Rüdiger, anything new with the latest beta ?
Michel

Ruediger3, 2022-01-22:
Hi Michel,
sorry some delay. I had to fix the the update problem first (clean, updateBeta script).
Now the the fields are greyed out. So the initial problem is fixed.

But I have to admit, I am still trying to figure out the advantage of using the cam connected via NINA, since I cannot change any setting like gain as long as it is connected in NINA. If I want to change it, I have to disconnect the camera in NINA too. Hence it is less complicated to connect it directly in MW4. Maybe I am overlooking something, but where is the advantage?

Cheers
Rüdiger

mworion, 2022-01-22:
Hi Rüdiger,
if you use NINA controlled device, you could work in NINA as you want. And you have to setup your settings there as well. MW4 only sends commands to take an image. The only parameters are bin, exptime, subframe. No connect or disconnect through MW4.
if you choose a device through NINA in MW4, MW4 is handling connection and all settings which could be handled remotely. This is in case of NINA very limited (GAIN is possible). SGPro offers more settings to be influence.

Other advantages: NINA might use a native driver, which MW4 couldn't. You could prepare your imaging setup direct for later and focus. MW4 will not interfere in the NINA controlled mode.

Michel

Ruediger3, 2022-01-22:
Hi Michel,
here this is not working as you describe it. The settings in NINA for taking an image are not used when MW4 triggers a shot. Whenever MW4 triggers the shot, NINA uses the default connection values, but not the currently set parameters.
e.g. to change gain you have to disconnect the cam, change default value and reconnect the cam. Ba that you interrupt the cooling.

The driver point is valid.

Cheers
Rüdiger

Ruediger3, 2022-01-22:
Also I have just done a dry run test with the ASCOM camera simulator and it failed.
I can take the image in NINA but when I try to expose from MW it stays infinitely at "Expose 1".

Log attached....

Rüdiger

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
[mw4-2022-01-22.log](https://github.com/mworion/MountWizzard4/files/7919231/mw4-2022-01-22.log)

mworion, 2022-01-22:
Gotcha,
beta v2.2.0b9 will fix this.
Michel

Ruediger3, 2022-01-22:
Installed, Now the image process finishes, but no image shown. blank black screen.

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

Ruediger3, 2022-01-22:
Hi Michel,
I have restarted MW and took again a shot and now it is displayed. Nothing changed. Looks like a hick-up.
I will continue testing...

Ruediger3, 2022-01-22:
Hi Michel,

found following behavior:

1. The gain set in "Equipment" -> "Camera" -> "Camera Settings" -> "Default Gain" is taken
2. This can be switched without disconnecting.

I think it is a good idea to put it in the docu. Otherwise people try to set the gain in image tab which will fail.

Rüdiger

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

mworion, 2022-01-23:
Rüdiger good point, I will add this.
Was it in the remote controlled mode? I ask, because GAIN setting should be able to set in MW4 with NINA if you select the device MW4 (not remote controlled)
Michel

Ruediger3, 2022-01-23:
Hi Michel,

this was in NINA controlled mode. I have just tested MW controlled mode where you can set the Gain. But again the Gain from NINA is taken and not that from MW. Please see screen shot.

More over i have Identified another issue: When selecting the Simulator MW throws an error, since NINA does not connect fast enough. It takes up to 15s to fire up the ASCOM Simulator due to the large resolution. After 15s MW gets the connection.

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

[mw4-2022-01-23.log](https://github.com/mworion/MountWizzard4/files/7920617/mw4-2022-01-23.log)

mworion, 2022-01-23:
Ok I increase the timeout as it's limited to 10s now.
For the gain setting, this might be an issue on NINA's interface. There are some more as well.
Michel

Ruediger3, 2022-01-23:
Ok, do you get in touch with NINA guys?
If this is a bug, maybe we should open a new issue to follow up?

Rüdiger

mworion, 2022-01-23:
Actually I talked Stefan. The remote interface is a copy (not really) of the SGPro REST API. He did not implement all devices (only camera) nor all items for the camera. So setting gain will be not possible, as the REST API does not deliver the list auf possible gain settings and does not accept the parameter when doing image.
He is open to accept work on a plugin, which enables NINA to access many remote commands, but this is still open.
Michel

So next beta (next minutes) reflects checking if gain values are delivered (showing them) and if not removing the input field as well.
Michel

Ruediger3, 2022-01-23:
Ok, but this actually means that both modes are more or less identical. You have to control the camera from NINA.
Rüdiger

mworion, 2022-01-23:
That's basically the result. In SGPro you could do more things and hopefully NINA implements the REST Pluging to offer more functions.

Closed 2022-01-22.

Thread 219 (2022-02-06):

ASTAP/astrometry require significantly longer exposures than Ekos internal solver

mads0100, 2022-02-06:
Hey Michel,

I can’t figure out why MW4 requires such long exposures to platesolve. I can solve 1 second pictures in ekos with its internal solver; but i need 15-20s exposures in MW4.

Is it possible to call the ekos internal solver? Is there some other settings to improve it? I’ve tried binning.

Pictures show what it takes in MW4/ekos.

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

mworion, 2022-02-06:
Chris,
I had last night similar problems in not solving at all. My suspect is, that the coordinates written by EKOS in the FITS header are not correct. At least with some of the images I could see a large deviation. I guess the internal solver does not look at the coordinates of the FITS header, but uses actual coordinates. The same I tried within MW4 last night in a dirty hack and it went off without any difficulties. Could you check if images that took long also have wrong RA/DEC coordinates ?
Michel

mworion, 2022-02-06:
Chris,
in addition I see the following behavior on EKOS which I currently not understand:

https://user-images.githubusercontent.com/6632980/152674146-b6554cc5-af13-41fb-ad76-7ff9a253ea89.mov

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

Did you experience similar topics (both is not related to MW4)
Michel

mads0100, 2022-02-06:
I do get an error with the coordinate format if I pull up the terminal window. It says it’s expected a specific type but it’s deprecated so it reverts to another type of coordinates.

I will look for it tonight. Unless there is a way to test it during the day?

Sent from my iPhone

On Feb 6, 2022, at 03:02, Michael ***@***.***> wrote:

Chris,
in addition I see the following behavior on EKOS which I currently not understand:

https://user-images.githubusercontent.com/6632980/152674146-b6554cc5-af13-41fb-ad76-7ff9a253ea89.mov

Did you experience similar topics (both is not related to MW4)
Michel

—
Reply to this email directly, view it on GitHub, or unsubscribe.
Triage notifications on the go with GitHub Mobile for iOS or Android.
You are receiving this because you authored the thread.

mworion, 2022-02-06:
Chris,
I tested with the simulators, but my guess is that even if you have a wrong coordinate, the simulator will do the correct image.
The message about a depreciated format, could you send mit this message. Is it from ASTAP ?
Michel

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

mads0100, 2022-02-06:
This is what I see for every picture that’s loaded into MW4. Interestingly it even pulls the data when I’m capturing in Ekos. I’m assuming because it’s sharing the camera?

Sent from my iPhone

On Feb 6, 2022, at 07:38, Michael ***@***.***> wrote:

Chris,
I tested with the simulators, but my guess is that even if you have a wrong coordinate, the simulator will do the correct image.
The message about a depreciated format, could you send mit this message. Is it from ASTAP ?
Michel

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

—
Reply to this email directly, view it on GitHub, or unsubscribe.
Triage notifications on the go with GitHub Mobile for iOS or Android.
You are receiving this because you authored the thread.

mads0100, 2022-02-06:
I was processing my pictures from last night and I came across what you described. The picture meta data said it was in one place. But those coordinates were not the object.

Im not quite sure how to gather the data to show this. It would’ve occurred inside ekos?

Chris

Sent from my iPhone

On Feb 6, 2022, at 10:14, Chris Madson ***@***.***> wrote:

 This is what I see for every picture that’s loaded into MW4. Interestingly it even pulls the data when I’m capturing in Ekos. I’m assuming because it’s sharing the camera?

Sent from my iPhone

On Feb 6, 2022, at 07:38, Michael ***@***.***> wrote:

Chris,
I tested with the simulators, but my guess is that even if you have a wrong coordinate, the simulator will do the correct image.
The message about a depreciated format, could you send mit this message. Is it from ASTAP ?
Michel

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

—
Reply to this email directly, view it on GitHub, or unsubscribe.
Triage notifications on the go with GitHub Mobile for iOS or Android.
You are receiving this because you authored the thread.

mworion, 2022-02-09:
Chris,
sorry I have limited time because of my work. I made some tweaks, which I would like to test next days, which lead to an independence of the values written into the header.
The different values you experience are that the image in EKOS shows JNow and MW4 shows J2000. But this should not matter.
Coming back as soon as I have made the test and will upload a new beta afterwards.
Michel

mads0100, 2022-02-09:
I work too. LMK how I can help!

Sent from my iPhone

On Feb 9, 2022, at 04:17, Michael ***@***.***> wrote:

Chris,
sorry I have limited time because of my work. I made some tweaks, which I would like to test next days, which lead to an independence of the values written into the header.
The different values you experience are that the image in EKOS shows JNow and MW4 shows J2000. But this should not matter.
Coming back as soon as I have made the test and will upload a new beta afterwards.
Michel

—
Reply to this email directly, view it on GitHub, or unsubscribe.
Triage notifications on the go with GitHub Mobile for iOS or Android.
You are receiving this because you authored the thread.

mworion, 2022-02-12:
Chris, please check v2.2.0b18 and the comments on #221

mads0100, 2022-02-12:
Wilco. Should be clear tonight. I’ll grab logs too. Ran out of energy last night 😂

Sent from my iPhone

On Feb 12, 2022, at 08:14, Michael ***@***.***> wrote:

Chris, please check v2.2.0b18 and the comments on #221

—
Reply to this email directly, view it on GitHub, or unsubscribe.
Triage notifications on the go with GitHub Mobile for iOS or Android.
You are receiving this because you authored the thread.

mworion, 2022-02-12:
We have hopefully a nice night. Looking forward to take some pictures. I have to get first light with my new QHY600 setup.

mads0100, 2022-02-12:
Very nice. Where do you post your pictures?

Sent from my iPhone

On Feb 12, 2022, at 08:40, Michael ***@***.***> wrote:

We have hopefully a nice night. Looking forward to take some pictures. I have to get first light with my new QHY600 setup.

—
Reply to this email directly, view it on GitHub, or unsubscribe.
Triage notifications on the go with GitHub Mobile for iOS or Android.
You are receiving this because you authored the thread.

Closed 2022-03-21.

Thread 222 (2022-02-11):

Multiple silent crashes

Ruediger3, 2022-02-11:
Hi Michel,

I have experienced multiple silent crashes when switching between the tabs. MW just closes all windows. This happened a few times now. I have attached one log, but I don't see any hint there.

Also I have two log files from MW exceeding 9 GB (!)

Cheers
Rüdiger

[mw4-2022-02-10.log](https://github.com/mworion/MountWizzard4/files/8047188/mw4-2022-02-10.log)

mworion, 2022-02-11:
Rüdiger,
could you describe more, what happened. I would like to build a test automation against it.
Large log files are cause by intensive tracing.
Michel

Ruediger3, 2022-02-11:
Well, it happened always when I was quickly jumping between the tabs. I had switched the tabs, before the could load completely. That made it crash four or five times. Unfortunately more details I can not tell.

Ruediger3, 2022-02-11:
The huge cannot be opened by Notepad++ anymore, since they are too big. Also zip was not really sufficient
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
.

Ruediger3, 2022-02-11:
Maybe it makes sense to have a max log file size and MW4 starts a new log when reached?

mworion, 2022-02-11:
Hi Rüdiger,
good point, moving to a rotating file with max size 100MB
Available next beta. For the crashed I try to install an automated test. We'll see how far I get.
Michel

mworion, 2022-02-11:
Rüdiger,
I really can't find this crash. Ideally you could observe carefully, what happens on your side. I try to make this test on windows as well, right now only on MAC. The mount will be connected and MW4 is set to online during this run

[Bildschirmaufnahme 2022-02-11 um 21.04.05.mov.zip](https://github.com/mworion/MountWizzard4/files/8051344/Bildschirmaufnahme.2022-02-11.um.21.04.05.mov.zip)

Michel

Ruediger3, 2022-02-11:
I will try to get more infos, but it just closed. No error, no log entry. This is hard to tackle.

Ruediger3, 2022-02-12:
Hi Michel, 18 just crashed again, but this time I git an error in the log. I was clicking on the model tap. MW was immediately closed. Here it starts:

[2022-02-12 15:02:15.070][E][    loggerMW.py][  43] [STDERR] Traceback (most recent call last):

Rüdiger

[mw4-2022-02-12 - Copy.log](https://github.com/mworion/MountWizzard4/files/8053781/mw4-2022-02-12.-.Copy.log)

mworion, 2022-02-12:
That might be a good hint. As I did not change anything on my side, I suspect the update of matplotlib library. If you don't ride, I rollback the lib to the previous stage and build a v19 for longer testing. V19 is now online
Michel

Closed 2022-03-29.

Thread 230 (2022-04-15):

Unable to configure Astrometry.net

His-Holy-Noodliness, 2022-04-15:
I had some issues solving with ASTAP last night, so I downloaded full ANSVR indices and set up a local astrometry.net, it's working fine when used in other clients, but in MW4 I can't get the solver button to go green so I can build a model. The ansvr is running under Cygwin on Windows 10.

I've got indices in (and MW4 pointing to) C:\Users\Paul\AppData\Local\cygwin_ansvr\usr\share\astrometry\data then for the first MW4 config item (program folder) I've got C:\Program Files (x86)\Astrometry.net Local Solver but I have also tried putting the bin folder from the cygwin install there (C:\Users\Paul\AppData\Local\cygwin_ansvr\bin) and whichever I specify the solver never turns green in MW4 and I can't model.

How do I get this working please?

mworion, 2022-04-19:
Hi,
Sorry to hear that you got problems with ASTAP. Did it work in the past? ASTAP normally does not fail. In case your changed focal length etc. please make sure that your settings in MW4 and / or your imaging application are correct. Otherwise ASTAP as well as other plate solvers could have problems. You also could increase the search radius in MW4 for ASTAP under driver setting up to 180 for doing an all sky search.
I have to say sorry about ansvr as it implements windows specific interfaces. MW4 does not support them. I kept the option open for users who want to try it with a complete linux subsystem on windows.
So still the best way is to get ASTAP again working. If you need more help, please let me know.
If you have a log file from a failing attempt, please post it. I probable could tell you what’s going wrong in the setup.
Michel

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

His-Holy-Noodliness, 2022-04-25:
Hi thanks for the reply. The weather hasn't been the good the past few days, but I'll post a log if it happens again, I tried in a linux subsystem for windows but although I built Astrometry.net after some dependency issues, MW4 still wouldn't seem to talk to it, so I switched back to ASTAP (which has, mostly been working OK for me).

BTW when I tried in a linux subsystem, should I have also installed MW4 there? I was running MW4 natively in windows, and on the same machine running astrometry.net in the linux subsystem.

mworion, 2022-04-25:
I would keep running MW4 and ASTAP in native windows as you might use ASCOM devices as well (which does not work with WSL).

Closed 2022-06-28.

Thread 235 (2022-04-21):

Mount Simulation View not updated for Southern Hemisphere observer

aphelyon-net, 2022-04-21:
I just noticed that the graphical representation of the mount position appears to be only showing the northern hemisphere position.
In my case of being in the southern hemisphere, the graphical position should be reversed.
In the attached picture the mount is currently positioned near the South celestial pole towards IC2944 target.
Thanks

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

mworion, 2022-04-21:
Sorry to hear.
I checked it and I turn the mount if I set the latitude to southern hemisphere, but so far I hardly get any feedback if there are any problems with it. I have another user in NewZeeland, but there MW4 runs so far as well as Tony in Chile. In any case, please check things and report back. It would be helpful to get more detailed pictures (not overlapped).
Michel

aphelyon-net, 2022-04-22:
Hi Michel,
Do you mean to manually set the Latitude rather than have GPS update the mount position?
In park position here you can see that the graphic is pinting north rather than south when in parked position.
I wonder if the is an issue with the firmware and updates returned by ascom?
I'm currently on firmware 3.0.8

-------------------------------------------------------------------------------
Upgrade notes for 10micron mount software version 3.0.9
-------------------------------------------------------------------------------

Improved logging.

* Bugs *

When the location was updated with the GPS module, the southern hemisphere
state was not correctly updated when a southern latitude was selected. This
has been corrected.

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

mworion, 2022-04-22:
Hi it was probable an initialization problem at startup of MW4.
v2.2.3 should fix this. If you change hemisphere you have to reopen the mount simulator window.
Michel

aphelyon-net, 2022-05-22:
Thanks, I can confirm this is working now.

Closed 2022-05-22.

Thread 236 (2022-04-23):

ASTAP Failed - ASI 6200 MM PRO

rkas12, 2022-04-23:
Hello,

I wanted to start building a model for my 10 micron mount with my full frame ASI 6200 MM camera. I was unsuccessful since ASTAP failed every time to solve. Worth mentioning that usually ASTAP works like a charm with my setup. In addition, while loading manually an image taken via MW4 and the plate solving works perfectly ;(

In the settings, I made sure to have the correct values, i.e. focal length, aperture, increase radius up to 180, etc. Further, I put the work file under "my document" to avoid conflicts in W10.

I would appreciate your kind advice.

Best regards.

PS : MW4 is an incredible tool, very well done !

mworion, 2022-04-24:
Hi,

sorry to hear, would you mind to post the log file here in GitHub and probably the zipped fits file as example, too ? If the file size of the image is too large, you might use the dropbox link as well: https://www.dropbox.com/sh/5q9jcvdq2tf2o0l/AAAbrVhoaWAAgQz3AdlE777fa?dl=0
Michel

rkas12, 2022-04-24:
Dear Michel,

Thank you for your quick reply, much appreciated.

Image example : [https://www.dropbox.com/s/5oog415482a2zij/image-001.fits?dl=0](url)

As for the log, sorry for the newbie question, where can I retrieve it ? I have under settings "standard" selected, but I do not have any log file under the work file.

Thank you for your help, Michel.

Greetings,
Aygen

mworion, 2022-04-24:
Augen,
you will find the log file in your work folder. Named: mw4-yyyy-mm-dd.log. If you try the next time, you could set logging to debug (settings / misc) tab.
The config file you will find in config folder and has extension *.cfg
Michel

rkas12, 2022-04-24:
Michel,
Thank you - I found it ! Please find the log : https://www.dropbox.com/s/x4jfzinicg3cexc/mw4-2022-04-23.log?dl=0[](url)
I have already changed the logging level to debug.
Best regards,
A.

mworion, 2022-04-24:
Aygen,
I tried the image with the MW4 default settings and it failed whereas ASTAP manually solved correctly. ASTAP showed 13 degrees RA off (which is a lot). Default search radius set by MW4 is only 10 degrees, which explains the fail. If you increase the search radius in ASTAP driver setting to 30 degrees like:

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

MW4 solves with ASTAP, too with the same solving result.
Please give it a try.
Michel

rkas12, 2022-04-24:
Evening Michel,

Thank you for your time and your feedback.

Yesterday, I did increase the radius up to 180. It failed in MW4 whereas it worked both by loading manually the image in MW4 (and solve it) and by going through ASTAP itself directly.

Tonight should be good enough to run some tests. I will keep you posted about the outcome.

Otherwise, should it fail again, is there a way in MW4 to load images manually, solve them and then export the overall results into the mount ?

Thank you again for your kind help and all the best,
Aygen

mworion, 2022-04-24:
Aygen,
If you have to increase the radius to 180 something is strange. If you have a rough estimation where the mounts points to, it should be less. If you need more than 90 I would wonder why. Please check if ASTAP times out and increase the timeout setting accordingly.
Unfortunately there is no way to do it manually. But we'll find out what the reason is and sort it. If you do another test, please set debug level to trace and post the log file afterwards.
Michel

rkas12, 2022-04-24:
Michel,
Great news, I just ran a small model (22 points) and did work perfectly (plate solving, modeling, etc.).
Thank you for your very nice followup !
Shall we close the thread ?
Many thanks and best regards,
Aygen

rkas12, 2022-04-24:
Michel,
A side question if I may : is there a way to keep the existing model while adding points (without starting from the scratch) ?
Best regards,
A.

Ruediger3, 2022-04-25:
> Michel, A side question if I may : is there a way to keep the existing model while adding points (without starting from the scratch) ? Best regards, A.

Hi Aygen,
happy to read that it works for you now. Coming to your idea to have an incremental model approach. This is not a good idea, because the different model parts are taken under different environmental conditions, so the model might become corrupted.

Better do it in one glitch. Actually it does not take much more time. For me 92 points take only around 40 minutes, which can be done during sun set. No imaging time is lost.

CS
Rüdiger

mworion, 2022-04-25:
Hi Aygen,
I agree with Rüdiger, but still there is the technical possibility in doing two separate model an adding them.

rkas12, 2022-10-11:
Thank you for everything Michel ! You rock !!!!

I wish you an excellent start into the new week.

Aygen

Le lun. 25 avr. 2022 à 08:27, Michael ***@***.***> a écrit :

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

Closed 2022-04-25.

Thread 239 (2022-05-18):

Auto Resolve (ASTAP) works but Error after first image during Model Run

hdiessner, 2022-05-18:
**Describe the bug**
MW4 v2.2.4, all devices connected and working.
Manual exposure of picture working and resolved successfully with ASTAP
When Trying to run a 3 points model, after first exposure and first (successful) plate solving, an Error is displayed:

Excerpt from log file:
```[2022-05-18 21:45:43.195][D][astrometryASTAP][ 132] ASTAP took 3.6987221240997314s return code: 0 [C:\Mountwizzard4\Windows_Scripts/image/m-2022-05-18-21-45-07-align3/image-001.fits] stderr:  stdout:
[2022-05-18 21:45:43.199][D][  astrometry.py][ 156] wcs header: [SIMPLE  =                    T / conforms to FITS standard                      BITPIX  =                   16 / array data type                                NAXIS   =                    2 / number of array dimensions                     NAXIS1  =                 4656                                                  NAXIS2  =                 3520                                                  EXTEND  =                    T                                                  BSCALE  =                    1                                                  BZERO   =                32768                                                  OBJECT  = 'SKY_OBJECT'         / default name from MW4                          FRAME   = 'Light   '           / Modeling works with light frames               EQUINOX =                 2000 / All data is stored in J2000                    PIXSIZE1=                  3.8                                                  PIXSIZE2=                  3.8                                                  XPIXSZ  =                  3.8                                                  YPIXSZ  =                  3.8                                                  FOCALLEN=               2541.0 / Data taken from driver or manual input         SCALE   =   0.3084639905548996                                                  XBINNING=                    1 / MW4 same binning x/y                           YBINNING=                    1 / MW4 same binning x/y                           EXPTIME =                 10.0                                                  OBSERVER= 'MW4     '                                                            DATE-OBS= '2022-05-18T21:46:39' / Time is UTC of mount                          MJD-OBS =    59717.90739933075 / Time is UTC of mount                           CCD-TEMP=                 20.5                                                  SQM     =                    0                                                  RA      =    253.3271982044297 / Float value in degree                          DEC     =    81.33932402303928 / Float value in degree                          TELESCOP= '10micron GM3000HPS' / Mount version from firmware                    SITELAT = '+48:49:59'                                                           SITELON = '+08:50:21'                                                           SITEELEV=                454.4                                                  CTYPE1  = 'RA---TAN'           / first parameter RA  ,  projection TANgential   CTYPE2  = 'DEC--TAN'           / second parameter DEC,  projection TANgential   CUNIT1  = 'deg     '           / Unit of coordinates                            CRPIX1  =  2.328500000000E+003 / X of reference pixel                           CRPIX2  =  1.760500000000E+003 / Y of reference pixel                           CRVAL1  =  2.547332872744E+002 / RA of reference pixel (deg)                    CRVAL2  =  8.153474055389E+001 / DEC of reference pixel (deg)                   CDELT1  =  8.601499400174E-005 / X pixel size (deg)                             CDELT2  =  8.618363015154E-005 / Y pixel size (deg)                             CROTA1  =  9.242697387215E+001 / Image twist of X axis        (deg)             CROTA2  = -2.675733038522E+002 / Image twist of Y axis        (deg)             CD1_1   = -3.641976011607E-006 / CD matrix to convert (x,y) to (Ra, Dec)        CD1_2   =  8.610632386945E-005 / CD matrix to convert (x,y) to (Ra, Dec)        CD2_1   = -8.593785663985E-005 / CD matrix to convert (x,y) to (Ra, Dec)        CD2_2   = -3.649533639521E-006 / CD matrix to convert (x,y) to (Ra, Dec)        PLTSOLVD=                    T / ASTAP internal solver                          END                                                                                                                                                                                                                                                                                                                                                                                                                                                                                                                                                                                                                                                                                                                                                                                                                                                                                                                                                                                                                                                                                                                                                                                                                                                                                                                                                                                                                                                                                                                                                                                                                                                                                                                                                                                                                                                                                                                                                                                                                                                                             ]
[2022-05-18 21:45:43.201][D][  fitsHeader.py][  60] HasFloat: [True], HasDeg: [False], Header:[SIMPLE  =                    T / conforms to FITS standard                      BITPIX  =                   16 / array data type                                NAXIS   =                    2 / number of array dimensions                     NAXIS1  =                 4656                                                  NAXIS2  =                 3520                                                  EXTEND  =                    T                                                  BSCALE  =                    1                                                  BZERO   =                32768                                                  OBJECT  = 'SKY_OBJECT'         / default name from MW4                          FRAME   = 'Light   '           / Modeling works with light frames               EQUINOX =                 2000 / All data is stored in J2000                    PIXSIZE1=                  3.8                                                  PIXSIZE2=                  3.8                                                  XPIXSZ  =                  3.8                                                  YPIXSZ  =                  3.8                                                  FOCALLEN=               2541.0 / Data taken from driver or manual input         SCALE   =   0.3084639905548996                                                  XBINNING=                    1 / MW4 same binning x/y                           YBINNING=                    1 / MW4 same binning x/y                           EXPTIME =                 10.0                                                  OBSERVER= 'MW4     '                                                            DATE-OBS= '2022-05-18T21:46:39' / Time is UTC of mount                          MJD-OBS =    59717.90739933075 / Time is UTC of mount                           CCD-TEMP=                 20.5                                                  SQM     =                    0                                                  RA      =    253.3271982044297 / Float value in degree                          DEC     =    81.33932402303928 / Float value in degree                          TELESCOP= '10micron GM3000HPS' / Mount version from firmware                    SITELAT = '+48:49:59'                                                           SITELON = '+08:50:21'                                                           SITEELEV=                454.4                                                  END                                                                                                                                                                                                                                                                                                                                                                                                             ]
[2022-05-18 21:45:43.201][D][  fitsHeader.py][  61] Ra:[16h 53m 18.53s][16.888479880295314], Dec: [81deg 20' 21.6"][81.33932402303928]
[2022-05-18 21:45:43.202][D][astrometryASTAP][ 233] Header: [SIMPLE  =                    T / conforms to FITS standard                      BITPIX  =                   16 / array data type                                NAXIS   =                    2 / number of array dimensions                     NAXIS1  =                 4656                                                  NAXIS2  =                 3520                                                  EXTEND  =                    T                                                  BSCALE  =                    1                                                  BZERO   =                32768                                                  OBJECT  = 'SKY_OBJECT'         / default name from MW4                          FRAME   = 'Light   '           / Modeling works with light frames               EQUINOX =                 2000 / All data is stored in J2000                    PIXSIZE1=                  3.8                                                  PIXSIZE2=                  3.8                                                  XPIXSZ  =                  3.8                                                  YPIXSZ  =                  3.8                                                  FOCALLEN=               2541.0 / Data taken from driver or manual input         SCALE   =   0.3084639905548996                                                  XBINNING=                    1 / MW4 same binning x/y                           YBINNING=                    1 / MW4 same binning x/y                           EXPTIME =                 10.0                                                  OBSERVER= 'MW4     '                                                            DATE-OBS= '2022-05-18T21:46:39' / Time is UTC of mount                          MJD-OBS =    59717.90739933075 / Time is UTC of mount                           CCD-TEMP=                 20.5                                                  SQM     =                    0                                                  RA      =    253.3271982044297 / Float value in degree                          DEC     =    81.33932402303928 / Float value in degree                          TELESCOP= '10micron GM3000HPS' / Mount version from firmware                    SITELAT = '+48:49:59'                                                           SITELON = '+08:50:21'                                                           SITEELEV=                454.4                                                  END                                                                                                                                                                                                                                                                                                                                                                                                             ]
[2022-05-18 21:45:43.202][D][astrometryASTAP][ 234] Solve : [{'raJ2000S': <Angle 16h 58m 55.99s>, 'decJ2000S': <Angle 81deg 32' 05.1">, 'errorRA_S': 5061.920651892899, 'errorDEC_S': 703.4995110625971, 'angleS': 92.42195397022662, 'scaleS': 0.3102599176086932, 'errorRMS_S': 5110.5725949373955, 'mirroredS': False}]
[2022-05-18 21:45:43.205][D][astrometryASTAP][ 243] Result: [{'success': True, 'solvedPath': 'C:\\Mountwizzard4\\Windows_Scripts/image/m-2022-05-18-21-45-07-align3/image-001.fits', 'message': 'Solved', 'raJ2000S': <Angle 16h 58m 55.99s>, 'decJ2000S': <Angle 81deg 32' 05.1">, 'errorRA_S': 5061.920651892899, 'errorDEC_S': 703.4995110625971, 'angleS': 92.42195397022662, 'scaleS': 0.3102599176086932, 'errorRMS_S': 5110.5725949373955, 'mirroredS': False}]
[2022-05-18 21:45:43.206][D][    tabModel.py][ 208] Processing astrometry result
[2022-05-18 21:45:43.207][D][    tabModel.py][ 210] Result from queue [001]: [{'imagePath': 'C:\\Mountwizzard4\\Windows_Scripts/image/m-2022-05-18-21-45-07-align3/image-001.fits', 'exposureTime': 10.0, 'binning': 1, 'subFrame': 100.0, 'fastReadout': True, 'lenSequence': 3, 'countSequence': 1, 'pointNumber': 1, 'modelName': 'm-2022-05-18-21-45-07-align3', 'astrometryApp': 'astap - ASTAP', 'solveTimeout': 30.0, 'searchRadius': 10.0, 'focalLength': 2541.0, 'altitude': 55, 'azimuth': 10, 'raJNowM': <Angle 16h 51m 30.62s>, 'decJNowM': <Angle 81deg 18' 02.5">, 'angularPosRA': <Angle 138deg 53' 48.5">, 'angularPosDEC': <Angle 08deg 42' 22.7">, 'siderealTime': <Angle 14h 06m 53.10s>, 'julianDate': <Time tt=2459718.4072691407>, 'pierside': 'W', 'raJ2000M': <Angle 16h 53m 18.53s>, 'decJ2000M': <Angle 81deg 20' 21.6">}]
[2022-05-18 21:45:43.207][D][    tabModel.py][ 231] Queued to model [001]: [{'imagePath': 'C:\\Mountwizzard4\\Windows_Scripts/image/m-2022-05-18-21-45-07-align3/image-001.fits', 'exposureTime': 10.0, 'binning': 1, 'subFrame': 100.0, 'fastReadout': True, 'lenSequence': 3, 'countSequence': 1, 'pointNumber': 1, 'modelName': 'm-2022-05-18-21-45-07-align3', 'astrometryApp': 'astap - ASTAP', 'solveTimeout': 30.0, 'searchRadius': 10.0, 'focalLength': 2541.0, 'altitude': 55, 'azimuth': 10, 'raJNowM': <Angle 16h 51m 30.62s>, 'decJNowM': <Angle 81deg 18' 02.5">, 'angularPosRA': <Angle 138deg 53' 48.5">, 'angularPosDEC': <Angle 08deg 42' 22.7">, 'siderealTime': <Angle 14h 06m 53.10s>, 'julianDate': <Time tt=2459718.4072691407>, 'pierside': 'W', 'raJ2000M': <Angle 16h 53m 18.53s>, 'decJ2000M': <Angle 81deg 20' 21.6">, 'success': True, 'solvedPath': 'C:\\Mountwizzard4\\Windows_Scripts/image/m-2022-05-18-21-45-07-align3/image-001.fits', 'message': 'Solved', 'raJ2000S': <Angle 16h 58m 55.99s>, 'decJ2000S': <Angle 81deg 32' 05.1">, 'errorRA_S': 5061.920651892899, 'errorDEC_S': 703.4995110625971, 'angleS': 92.42195397022662, 'scaleS': 0.3102599176086932, 'errorRMS_S': 5110.5725949373955, 'mirroredS': False, 'raJNowS': <Angle 16h 57m 02.48s>, 'decJNowS': <Angle 81deg 29' 55.8">}]
[2022-05-18 21:45:43.335][U][     mainApp.py][ 416] Message window: [Solved   image-001:  Ra: 16:58:56 (16.982), Dec: +81:32:05 (81.535), ]
[2022-05-18 21:45:43.335][U][     mainApp.py][ 416] Message window: [                     Angle:  92, Scale: 0.310, Error: 5110.6]
[2022-05-18 21:45:43.337][T][  ascomClass.py][ 263] ASCOM threaded: [<bound method AscomClass.workerPollStatus of <logic.focuser.focuserAscom.FocuserAscom object at 0x000001CBD07495B0>>], args:[()], kwargs:[{}]
[2022-05-18 21:45:43.337][T][  ascomClass.py][ 263] ASCOM threaded: [<bound method FocuserAscom.workerPollData of <logic.focuser.focuserAscom.FocuserAscom object at 0x000001CBD07495B0>>], args:[()], kwargs:[{}]
[2022-05-18 21:45:43.337][T][  ascomClass.py][ 103] [ASCOM.PWI3.Focuser] property [connected] has value: [True]
[2022-05-18 21:45:43.338][T][  ascomClass.py][ 103] [ASCOM.PWI3.Focuser] property [position] has value: [25622]
```

**To Reproduce**
Steps to reproduce the behavior:
1. Go to 'Model Points'
2. Click on 'Generate Model points align' - '3 points'
3. Go to "Model Build"
4. Click on 'Model build' - 'Run'
5. See picture taken, see solver succeed
6. See error message in Messages Window, e.g. "Error: 5110.6"

**Expected behavior**
If this is really an error, it should stop the model build, but apparently the model build process is stalled at 33% (as first point was solved); Elapsed time is stopped counting, but "Cancel" Button is still active (and you have to press it in order to use the software again.

**Screenshots**
If applicable, add screenshots to help explain your problem.

**Desktop (please complete the following information):**
 - OS: Windows 10, latest updates
 - Ascom platform 6.6  - 6.6.0.3444
 - MW4 downloaded, installed and configured today

hdiessner, 2022-05-18:
Not sure if this is an actual error per se, but at least the model build process does not continue - and I have no idea where this is coming from.

mworion, 2022-05-19:
Herwig,
could you provide the full log? Ideally you ran the test in debug (trace mode). Did this work in last version?
Michel

hdiessner, 2022-05-19:
Hi Michel,
thank you for your fast answer!
Somehow, I can't attach the log file directly, so I put it here: [Log](https://drive.google.com/file/d/1N3lMkkUxqF6xOgY15kOv7Vuxd0PfP5w9/view?usp=sharing)

After the first "stop" occurred, I changed log file settings from default to debug - hope MW4 was able to change this "on the fly". If you need another log file, I can redo it tonight.

As my 10micron defective, the control box was for service in Italy and when it came back, all data was of course deleted - so I need a new model; for that, I just yesterday migreated from MW3 to MW4 - this is why I don't know if it was working in previous versions of MW4.

hdiessner, 2022-06-15:
Hi Michel,
I setup a new PC from scratch with all latest Windows Updates, latest ASCOM, drivers, latest MW4 (updated today), now when building a new model with 3 points, it takes all exposures, slews to the next point until finished.
So the problem of "stop" doesn't occur anymore.
But MW4 doesn't seem to like me: Now the platesolving for each image taken fails during the model creation, with the messages window saying: "Solving failed for image-001 ... 003"
If, however, I manually hit the "solve" button in the Imaging window, the exact same image is resolved immediately and correctly, messages window: "Solving error: None"
Any idea?

hdiessner, 2022-06-15:
[NoPlatesolve.txt](https://github.com/mworion/MountWizzard4/files/8913597/NoPlatesolve.txt)

hdiessner, 2022-06-16:
Hi Michel,
oh, I used the MW4 functionality to acquire the image using the latest ASCOM driver for my ASI1600mm pro. The image was displayed in the imaging window of MW4 without any problems.
I uploaded the fits file as a zip archive.
[image-001.zip](https://github.com/mworion/MountWizzard4/files/8921679/image-001.zip)
.

mworion, 2022-06-17:
Herwig,
many thanks. Coming closer. I will change behavior that if an error arises, the model run stop nicely. You also see the error in manual solve.
I will improve the error output in message window also.
One request: could you tell the ASTAP version and could you post the temp.wcs file out of the /temp folder in your working dir after solving the provided and failed file ?
Michel

hdiessner, 2022-06-17:
Hi Michel,
all the images taken were resolved flawlessly when I manually clicked on the Solve button in the imaging window of MW4 (this even worked while a Model Build was running directly after throwing the error. Apparently the manual resolving process is more graceful to the header of the FITS files.
ASTAP Version: 2022.05.29a, 64bit
I just loaded the image-001.fits file I uploaded yesterday into MW4 Imaging Window and hit "Solve" - after a few seconds, the result was there, Messages windows  says "Solving error: None"
temp.wcs file attached as zip
[temp.zip](https://github.com/mworion/MountWizzard4/files/8928692/temp.zip)

mworion, 2022-06-18:
Hi Herwig,
I combine you latest issue with the one of Fukinagashi #244 as it has the same reason.

Closed 2022-06-18.

Thread 240 (2022-05-23):

GM2000HPS - Startrails after polar align and model Build

GsellAstrophotography, 2022-05-23:
Hello Together,

I bought a new GM2000HPS. Now I tried to get everything to work.

My steps were:
1. Small Model
2. Polar Align
3. redo Steps one and two
4. After I got a Polar error of 20 Arcseconds I wanted to test with some 5 minute Pictures. But all of them had elongated stars. I will send the Log file (first one)

Then I made a Polar alignment with Sharpcap and wanted to create a new model. (I also updated the MC4 with the autoupdater)
Unfortunately the Model Creator always stopped after the first star and didn't do anything else then.
I tried everything. Shut down everything, restart and so on.
But then it only created a model under conservative setting (before it worked with every setup)
I

I will attach the Log files. Perhaps you can help me.

My setup is a GM2000HPS and a Orion UK ODK12 with 2040mm focal length.

CS Christia
[mw4-2022-05-18.log](https://github.com/mworion/MountWizzard4/files/8757019/mw4-2022-05-18.log)
[mw4-2022-05-17.log](https://github.com/mworion/MountWizzard4/files/8757020/mw4-2022-05-17.log)
n

mworion, 2022-05-23:
Hi Christia,

thanks for the logs and sorry about your experience. There is an service release 2.2.5 out which fixes your problem (model setup with other than conservative). This happened in special cases, but should be now more robust. As you are using ASTAP, please make sure that you are roughly polar aligned with your actual focal length or increase the FOV setting in ASTAP driver from 10 to 30 degrees (to allow more deviation). I would recommend enabling Dual Axis Tracking during imaging run with you focal length. Depending on your ASI Camera (my guess is a newer with large sensor), ASTAP only needs 1500 pixel each side. So go for bin2 or bin3 might be helpful to lower the download speed and increase robustness.

After you updated, please set logging Leven (under log/ misc) to debug to ge more information about possible problems next run.

Hopyfully 2.2.5 is the way to go for you.
Michel

GsellAstrophotography, 2022-05-23:
Hallo Michael,

danke sehr, ich werde es testen :)

Closed 2022-07-25.

Thread 243 (2022-06-13):

Creating Model with ASCOM and ASTAP

mworion, 2022-06-13:
Hi Michel
I started to use your MW app with my GM1000HPS, to begin I use the mount, the simulatorV2 for the camera, MGbox,  the PC,
i have every thing green solver is ASTAP, I tried Astromety.net but I miss the lib. and I am not enough inside to understand the whole picture...Later...When I run a model the plate solving never complete but the process continue, is it normal with the simulator of the camera ? Is ASTAP ok as a solver ?  Thanks a lot and thanks.   George

_Originally posted by @georgesblum in https://github.com/mworion/MountWizzard4/discussions/96#discussioncomment-2907399_

mworion, 2022-06-13:
Hi Georges,

I made an issue out of it. We are going to sort your problem out. As you are using Windows as your operating system, could you please post the log here in the issue (just drag the *.log file to the webpage). An attachment for email does not work. Then I will have a look to your setup and then wo move further on.

Michel

mworion, 2022-06-18:
Hi Georges,
I publish a new 2.2.7 this evening. Probably this also addresses your issue as well.
Michel

georgesblum, 2022-06-19:
Hi Michael,
i upgraded to 2.7 / i am going to send you the logs but i think i have an issue with the mount, unfortunately, the famous code error 00.20.00.00.16/00, so i am waiting to get the grid filter from Baader, i am not to shure the logs are helpful for you ? are you still willing to get them ?  king regards Georges

mworion, 2022-06-19:
sure, at least I will have a look to it and see what happened.

mworion, 2022-06-19:
so following the issue were our log files are in

georgesblum, 2022-06-19:
[mw4-2022-06-13.log](https://github.com/mworion/MountWizzard4/files/8936173/mw4-2022-06-13.log)
[mw4-2022-06-14.log](https://github.com/mworion/MountWizzard4/files/8936174/mw4-2022-06-14.log)
[mw4-2022-06-18.log](https://github.com/mworion/MountWizzard4/files/8936175/mw4-2022-06-18.log)
[mw4-2022-06-19.log](https://github.com/mworion/MountWizzard4/files/8936176/mw4-2022-06-19.log)

georgesblum, 2022-06-19:
[mw4-2022-05-16.log](https://github.com/mworion/MountWizzard4/files/8936180/mw4-2022-05-16.log)
[mw4-2022-05-17.log](https://github.com/mworion/MountWizzard4/files/8936181/mw4-2022-05-17.log)
[mw4-2022-05-18.log](https://github.com/mworion/MountWizzard4/files/8936182/mw4-2022-05-18.log)
[mw4-2022-05-20.log](https://github.com/mworion/MountWizzard4/files/8936183/mw4-2022-05-20.log)
[mw4-2022-05-21.log](https://github.com/mworion/MountWizzard4/files/8936184/mw4-2022-05-21.log)
[mw4-2022-05-25.log](https://github.com/mworion/MountWizzard4/files/8936185/mw4-2022-05-25.log)
[mw4-2022-05-28.log](https://github.com/mworion/MountWizzard4/files/8936186/mw4-2022-05-28.log)
[mw4-2022-06-04.log](https://github.com/mworion/MountWizzard4/files/8936187/mw4-2022-06-04.log)
[mw4-2022-06-06.log](https://github.com/mworion/MountWizzard4/files/8936188/mw4-2022-06-06.log)
[mw4-2022-06-07.log](https://github.com/mworion/MountWizzard4/files/8936189/mw4-2022-06-07.log)
[mw4-2022-06-08.log](https://github.com/mworion/MountWizzard4/files/8936190/mw4-2022-06-08.log)
[mw4-2022-06-09.log](https://github.com/mworion/MountWizzard4/files/8936191/mw4-2022-06-09.log)
[mw4-2022-06-10.log](https://github.com/mworion/MountWizzard4/files/8936192/mw4-2022-06-10.log)

georgesblum, 2022-06-20:
Could you got the files Michael ?

mworion, 2022-06-20:
yes, as soon as you are „online“ with the mount again, we‘ll sort the topic‘s I‘ve seen.

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

Closed 2022-06-19.

Thread 246 (2022-07-03):

MW2.2.7: No model creation is triggered after last exposure

Ruediger3, 2022-07-03:
Hello Michel,
long time no hear. I hope you are fine!

Yesterday I faced an issue while building a 96 point model.

1. During model build the processed / solved point was always 2 points behind the current one. The points 2 steps behind were marked with yellow and hook.

2. After the last point was exposed it was not handed over to ASTAP and model build was not triggered. I had to press "End" button and then the model was created without the last point. It looks like there is an index has an offset by 1.

Thank you!

Cheers
Rüdiger

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

Ruediger3, 2022-07-03:
Hi Michl,
I see the gif is removed. Please advice how to attach the log file. I get always "Something went really wrong" Error.

Ruediger3, 2022-07-03:
At this moment MW got stuck and I had to press "end" to initiate model creation:

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
.

mworion, 2022-07-03:
Hi Rüdiger,
I'm fine, hope you are doing well, too.
I checked the log and saw that after point 27 in the model build a manual exposure was triggered. This caused and queuing error and caused the model run expect more things to come. In future this will stop a model run immediately. I hardly understand, why a manual trigger could happen, as I tried to disable these functions during a model run. Could you remember, what you did during this time? But anyway I have to find out why this happens.

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

Michel

Ruediger3, 2022-07-03:
Hi Michel,

many thanks - just recovering from COVID, but almost fine again thanks vaccination.

I cannot remember triggering a manual exposure during model run. I did one single exposure before model creation to test whether it is dark enough to solve. The rest of the time I had the tablet on the couch table and I was watching MW doing its job. That is very strange.

Could it be, that NINA was doing something with the camera since I use NINA as Server?

Rüdiger

mworion, 2022-07-03:
Rüdiger,

Good to hear that your are „back“. I would not guess that NINA is involved as the log only tells about UI clicks in MW4.
So I checked disabling Exposures during model run. This is not implemented for the Imaging window, just you can’t change the points during run.
So I added this function to v3.

Michel

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

Ruediger3, 2022-07-03:
Hi Michel,

many thanks! For me this is absolute fine. Since I know now what has caused the hick-up I can take care.

Enjoy your Sunday!
Rüdiger

Ruediger3, 2022-07-04:
Hi Michel,

I have re-done last night exact the same as the night before. No error. Everything worked as expected. So I guess either I have made something stupid or it was an unique event.

Thanks!
Rüdiger

Closed 2022-07-03.

Thread 261 (2022-08-20):

MW suddenly disappears from the screen, hemisphere tab does not respond to min/max

pieterkoolen, 2022-08-20:
While working with MW it suddenly disappears from the screen.
The hemisphere tab is not responding properly on min/max.
Somehow it appears the problems are related

I work under windows 11

I attached the log
[mw4-2022-08-20.log](https://github.com/mworion/MountWizzard4/files/9387870/mw4-2022-08-20.log)

Feel free to log in my computer.

mworion, 2022-08-21:
Hi Pieter,
I try to check an a windows11 install as well. Do you have any further observations? Could you reproduce it in a simple manner? Did you have this behavior since the beginning or did it start at some point in time? If so, do you remember anything you might have changed in the setup of MW4 (drivers, devices) or even your computer?

I do not see the original crash (if one happened), but only things afterwards when windows closing not nicely. These are cause by an external library. Ich check, what I could find out.
Thanks for offering login. I'm out today, perhaps I'll come back to you.

pieterkoolen, 2022-08-21:
Hi Michael. Last night at happened twice while building models. I noted the times of occurrence. Will upload the files and times later today.
Regards
Pieter

Verstuurd vanaf mijn iPhone

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

pieterkoolen, 2022-08-24:
[mw4-2022-08-20.log.zip](https://github.com/mworion/MountWizzard4/files/9413651/mw4-2022-08-20.log.zip)

pieterkoolen, 2022-08-24:
Hi Michael,
I just uploaded again.
Seems something did not work day before.
Did you receive it now?

pieterkoolen, 2022-09-05:
Hi Michael,
you have been able to give it some thoughts?

mworion, 2022-09-12:
Hi Peter,
so far no further clue beside the fact I know now, that this could happen, because an exception could crash python itself and then all the logging stuff does not write anything to a file anymore. In version 3 I tried to replace some libraries who might be corner cases during MW4 usage and therefore critical.

Sorry to say, but I have no solution for this issue
Michel

mworion, 2022-10-11:
Yes, many thanks
Michel

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

Closed 2022-11-17.

Thread 281 (2022-10-19):

NINA timeout

gpassera, 2022-10-19:
**Describe the bug**
The camera is a Moravia G2-8300 which if used with NINA is seen correctly and works using the native (Moravian) 64-bit drivers. If I use NINA as  interface in Mountwizzard I have a timeout as per attached log. I also tried to define the direct link of the ASCOM driver which works in NINA  but doesn't work in Mountwizzard. I enclose the log of attempts from last night. Some idea? Thank you

[mw4-2022-10-18.log](https://github.com/mworion/MountWizzard4/files/9821420/mw4-2022-10-18.log)

mworion, 2022-10-19:
Did you enable NINA server? Otherwise NINA will not respond to MW4 requests. You will find the enable here:
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
Hope this helps.
Michel

gpassera, 2022-10-20:
Michael

Thank you for your answer
No, the server was not active. Sorry.
This evening I will try again.

I close the Issue.
Thank you

gpassera, 2022-10-20:
Solved, not an issue.

Closed 2022-10-20.

Thread 282 (2022-10-24):

Plate solving with ASTAP fails with the recent version of ASTAP

razvan-astro, 2022-10-24:
A few weeks ago I was using MW4 2.2.7 with ASTAP v2022.09.10 and all was fine (like before).

A few days ago I upgraded ASTAP to v2022.10.19a and at the next imaging session in the field last night, all attempts to plate solve failed with the error below.

[2022-10-22 23:29:06.155][C][       tpool.py][ 103] fn: [solve], file: [tpool.py], line: 97 fn: [solve], file: [astrometryASTAP.py], line: 235 fn: [solve], file: [astrometry.py], line: 156 fn: [solve], file: [header.py], line: 272 fn: [solve], file: [header.py], line: 690 fn: [solve], file: [card.py], line: 206 fn: [solve], file: [card.py], line: 503 fn: [solve], file: [verify.py], line: 73 fn: [solve], file: [card.py], line: 1111 fn: [solve], file: [card.py], line: 818 fn: [solve], file: [card.py], line: 1191  - excType: [<class 'astropy.io.fits.verify.VerifyError'>], excValue: [CONTINUE cards must have string values.]

I installed the previous ASTAP and plate solving worked correctly again. I have not changed any settings neither before the problem, nor after it. Nor did I make any library updates.  The camera is a ZWO ASI2600MC Pro. I still have the captured images if needed.  The computer is a PL Eagle4 running Windows10.

The exception is thrown by https://docs.astropy.org/en/stable/_modules/astropy/io/fits/card.html Not sure what triggered the problem and whether it's something new or the latest ASTAP caused it to surface. I thought you may want to know. Log excerpt below.

Thanks and please let me know if any additional information can help.

[mw4-2022-10-22 (github).log](https://github.com/mworion/MountWizzard4/files/9847986/mw4-2022-10-22.github.log)

mworion, 2022-10-24:
Hi Razvan,
sorry to hear. I had a similar report and made 2.2.7 for it and it was solved. To find out,
please post the full log as I check them automatically and please have a look after a false solve in your /temp folder in your work dir. There should be a file temp.wcs. Please post this file as well.
Michel

razvan-astro, 2022-10-26:
Hi Michel,

Attached are the requested files.  In mw4-2022-10-22.log you will see the first model I aborted just after starting it ( I don't remember why). The second attempt ran with all the stars. Unfortunately didn't notice the plate solving failures as after starting the model building, I went to help a friend with his setup.

[mw4-2022-10-22.log](https://github.com/mworion/MountWizzard4/files/9864870/mw4-2022-10-22.log)

Also attaching temp.wcs (from which I removed SITELAT and SITELON; also renamed to temp.wcs.txt to be accepted by Github) but I don't think it will help because it shows the last plate solve of the _successful_ model build which I ran about an hour later after I reverted to the earlier ASTAP. I can say this based on the timestamps. I didn't know temp.wcs would have been useful, otherwise I would have saved it.

[temp.wcs.txt](https://github.com/mworion/MountWizzard4/files/9865034/temp.wcs.txt)

I'm also attaching the log (mw4-2022-10-23.log) from this separate build. By then the UTC day had changed as my local time now is EDT.

[mw4-2022-10-23.log](https://github.com/mworion/MountWizzard4/files/9864891/mw4-2022-10-23.log)

Something I did try on that night after noticing the model failures: I opened ASTAP (the new one) and loaded one of the images that failed to solve, then attempted to solve it there. It was successful. This suggests an integration problem rather than a solving problem.

In case it's useful, I'm also attaching the FITS header from the first image which failed to solve (again, with SITELAT and SITELON removed).

[image-001.fits.header.txt](https://github.com/mworion/MountWizzard4/files/9865055/image-001.fits.header.txt)

Thanks again for looking into it.

razvan-astro, 2022-10-26:
If you cannot reproduce the error, I don't want to add a burden for you since there's already a newer version of ASTAP and if it's a persistent problem with it, others will encounter it as well so you'll get more data; in my case it will be a while until I can get out again (the camera's cooler stopped working on the same night and needs a warranty repair).

Let me ask something else, something more general, though: is it possible with MW4 2.2.7 to trigger plate solving based on the existing saved images (which I still have) by invoking a particular method (even if the functionality is not exposed in the UI)? That is, to jump directly into the workflow at that point. Then I can try on my end.

Thanks.

mworion, 2022-10-27:
Sure you could do, please open the image window, there you could load any FITS image and plate solve it. So for test it's exactly the same procedure.

razvan-astro, 2022-10-29:
Excellent, so I did that test on the same computer with the images taken in the field from the first session when plate solving failed.

- the error was reproducible with ASTAP v2022.10.19a. The earlier v2022.09.10 as well as the newer v2022.10.22 work fine (the latter is good news).
- I compared temp.ini and temp.wcs between v2022.10.19a and v2022.10.22. They were identical (except for the ASTAP version string that appears in the PLTSOLVD field (which also means that ASTAP successfully solved the image even when that exception occurred. This matches my experience in the field when loading the FITS file directly into ASTAP worked).
- I had TRACE logging in MW4 in both tests. I'm attaching the log in case you see something. There are two separate launches of MW4, the first one when ASTAP v2022.10.19a was installed and the second one after installing v2022.10.22. I closed MW4 in between the tests. The FITS image was the same.

Now, based on the fact that the error no longer occurs with the latest ASTAP, I would suggest to close the bug. I hope it does not re-occur. I've attached the log just in case it helps with understanding the cause or dealing with a possible re-occurrence.

Thanks.

[mw4-2022-10-29.log](https://github.com/mworion/MountWizzard4/files/9892657/mw4-2022-10-29.log)

mworion, 2022-10-30:
Hi Razvan,
closing the issue. Still the reason is exactly the difference of this file. Could you post both files ? I would like to check, why the satrapy library handles this different.
Thanks for this precise analyses from your side.
Michel

razvan-astro, 2022-10-30:
Attaching the two temp files (with SITELAT and SITELONG removed from temp.wcs). These are from the attempt with ASTAP v2022.10.19a (as mentioned, the files were identical when I tried with v2022.10.22 on the same image). If you are still interested, I can share the v2022.10.19a installer (I wouldn't ask you to spend the time, just saying in case you want).

[temp.ini.txt](https://github.com/mworion/MountWizzard4/files/9895991/temp.ini.txt)
[temp.wcs.txt](https://github.com/mworion/MountWizzard4/files/9895996/temp.wcs.txt)

mworion, 2022-10-30:
Hi Razvan,
thanks for the files. For your informations: it was a little bit difficult to find out and the message of the library was misleading. Problem with the ASTAP version was that Han had a line 1 character longer as allowed in FITs Text file. When parsing the string, astropy expects instead of longer lines a new line starting with CONTINUE, which was not there. Han seems so fix that in later releases. For a possible 2.2.8 I made a workaround dropping two long lines.
Michel

razvan-astro, 2022-10-30:
Thanks for looking into it! At least we know the nature of the problem causing that surprising error message, should they happen again elsewhere.

Closed 2022-10-30.

Thread 290 (2023-01-10):

Issues with photometry

mworion, 2023-01-10:
When using the "Image" button, in particular, the associated window and operations of the image processing.

I found when you load a FITS file, the image loads and can be solved. The issue is with the other tab assessments i.e. HDR, Tilt square, Tilt triangle etc.
Here, they do not load or appear once the image is solved. I found if I clicked the "Photometry" box, these all loaded correctly and I could see the results in their separate tabs but if I untick then reapply the Photometry tick, all the results disappeared and would not respond. If I opened another image file, the image would load and display correctly but the other assessing tools would be blank (even with Photometry ticked) and the window would respond as "Not responding" for several seconds.

Just to note, the FITS file was not captured via MW4 v3beta, it was captured with Voyager and opened with MW4.

My version of Python is 3.9

mworion, 2023-01-10:
I tested this with standard FITS files (still not all done by MW4 and it worked. So I need a log file from you to check:
Please enable Loglevel to "Debug" under update / logging.
Try to load the image and enable / disable photometry.
You will find the log in your work dir / subdirectories log
Please drop it here.
Please ZIP the FITS File which does not work
Please drop it here as well.
Many thanks.
Michel

rprangley, 2023-01-18:
Hi Michel,

My apologies for the delay. Please find attached two .zip folders you seek containing two screenshots, two fits files and two log files.

[MW4_Debug.zip](https://github.com/mworion/MountWizzard4/files/10444030/MW4_Debug.zip)

rprangley, 2023-01-18:
Here is the other .zip folder with the second fits files.

Best Regards,

Rowan
[MW4_Debug_2.zip](https://github.com/mworion/MountWizzard4/files/10444037/MW4_Debug_2.zip)

rprangley, 2023-01-18:
HI Michel,

Just to note, the images were taken with a QHY268C. Could the bayer of the image cause an issue?

Best,

Rowan

mworion, 2023-01-18:
Hi Rowan,
the hint with bayered images was a good hint. In overall tricky. As result the following:
1: In the fits file there is the hint that the camera uses a BayernPattern, but under FITS Keyword "FILTER" (which is strange), missing the right keyword "BAYERPAT" and in addition not hint which pattern is used anyway. So debayering is not really possible. So voyager should change this. I see no other imaging app which does this in this strange way.
2: Even though MW4 tries to analyze this image anyway. First with the large size, analyzing could take up 15-60 seconds (the timeout will come). So the missing response might be one of this behavior.
3: Still if you wait long enough, MW4 will throw a failure as this data really could not be analyzed as there is no fitting PSF function.
4: If you manually enter the right keyword for the pattern and define the right pattern, which is btw. most probable "GBRG", MW4 had a bug in calculating the image size, which I have to fix and will be published in the next beta (3.0.0beta10) later.

With doing this all and waiting 15s, you will get all the informations:
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

One remark: On these large image chip cameras analyzing as well as modeling could be done more easy and faster if you are using binning. you don't need more that 1500 pixels to do this job.

Michel

rprangley, 2023-01-18:
Thank you Michel! I will test this.

Just to check, is the keyword you have entered under "Filter",  "Matrix__"?   Or is this where you type "GBRG" or the applicable bayer filter orientation?

Best,

Rowan

mworion, 2023-01-18:
… you have to add a new FITS header  keyword named. BAYERPAT with a value of GBRG

Von meinem iPad gesendet

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

rprangley, 2023-01-19:
Thank you Michel!

I appreciate your time and feedback helping me with this!

This can be marked as "closed".

Closed 2023-01-20.

Thread 294 (2023-01-14):

Unable to connect to NINA server for camera control in newest Nightly builds

abdiastroboy, 2023-01-14:
In newest nightly NINA the Camera does not connect as the server does not get detected.

COntacted NINA discord who said it seems ok based on logs.

However on NINA it states could not bind http ip address :port of server, port already in use.

With NINA discord we did the following

:\>netstat -ano | find "59590" | find "LISTEN"
  TCP    127.0.0.1:59590        0.0.0.0:0              LISTENING       7636
  TCP    [::1]:59590            [::]:0                 LISTENING       7636

C:\>tasklist /fi "PID eq 7636"

Image Name                     PID Session Name        Session#    Mem Usage
========================= ======== ================ =========== ============
NINA.exe                      7636 RDP-Tcp#7                  4    377,224 K

C:\>taskkill /F /PID 7636
SUCCESS: The process with PID 7636 has been terminated.

restarting again did nothing

Not sure what the problem is

[mw4-2023-01-14.log](https://github.com/mworion/MountWizzard4/files/10417854/mw4-2023-01-14.log)

 - Browser [e.g. stock browser, safari]
 - Version [e.g. 22]

**Additional context**
Add any other context about the problem here.
[20230115-002036-3.0.0.1009.10384.log](https://github.com/mworion/MountWizzard4/files/10417856/20230115-002036-3.0.0.1009.10384.log)

mworion, 2023-01-15:
Hi
In NINA latest builds the spelling of the keyword "Success" changed. It started in the past with a capital letter, now only shows lower level letters. This changed the interface to incompatible. I do not know why they changed it. I see in their repo, that they are working around. As I don't want to loose compatibility to the release, I won't change it an my side. Probably this might be an undetected error.
Hope this helps,
Michel

abdiastroboy, 2023-01-15:
Thanks Ill let them know

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

--
Abdurrahman Raeiq

abdiastroboy, 2023-01-15:
Hi MichelPosting on the Discord Servers Dale responded with the following which doesnt make much sense to me.See the screen shots below.It seems they are talking about normalising strings to lowercase, they dont seem to think theres a problem but then they are looking into it as well?!?newtonsoft.json in its new dotnetcore version and property names are normalised to lowercase when serialising the JSONwhat they think is that this is most likely a result of a behavioral change in dotnetand apparently “it's asp.net core instead of the old asp.net which works completely different”the proposed things are “ what we need to do is set newtonsoft JSON serialization options”“ so that the properties are serialized in how mw4 expects them to be”“ but where to set those JsonSerializationOptions”“ there is a `MvcNewtonsoftJsonOptions.MvcNewtonsoftJsonOptions()` that we can set up when we make the builder in SGPServiceHost.cs”“ but its jsonserializtionoptions is get-only; so need to set it up earlier”“ Probably thishttps://stackoverflow.com/questions/58732423/how-to-stop-newtonsoft-json-from-camelcasing”Not sure if this helps. On 16 Jan 2023, at 07:05, Abd R ***@***.***> wrote: Thanks Ill let them knowOn Sun, Jan 15, 2023 at 11:33 PM Michael ***@***.***> wrote:
Hi
In NINA latest builds the spelling of the keyword "Success" changed. It started in the past with a capital letter, now only shows lower level letters. This changed the interface to incompatible. I do not know why they changed it. I see in their repo, that they are working around. As I don't want to loose compatibility to the release, I won't change it an my side. Probably this might be an undetected error.
Hope this helps,
Michel

—Reply to this email directly, view it on GitHub, or unsubscribe.You are receiving this because you authored the thread.Message ID: ***@***.***>
-- Abdurrahman Raeiq

abdiastroboy, 2023-01-16:
They seem to be working on it, because the same behaviour is on SGP stuff potentially,the story of newtonsoftand the story of system.text.json (for swagger)I think jokogeo was in support of your methodOn 16 Jan 2023, at 07:05, Abd R ***@***.***> wrote: Thanks Ill let them knowOn Sun, Jan 15, 2023 at 11:33 PM Michael ***@***.***> wrote:
Hi
In NINA latest builds the spelling of the keyword "Success" changed. It started in the past with a capital letter, now only shows lower level letters. This changed the interface to incompatible. I do not know why they changed it. I see in their repo, that they are working around. As I don't want to loose compatibility to the release, I won't change it an my side. Probably this might be an undetected error.
Hope this helps,
Michel

—Reply to this email directly, view it on GitHub, or unsubscribe.You are receiving this because you authored the thread.Message ID: ***@***.***>
-- Abdurrahman Raeiq

mworion, 2023-01-17:
With the last changes from NINA this is sorted out. As said in the other issue, Result data has another spelling I might adopt to this. If the server does not respond at all, I need a new interface spec or NINA has to be compatible with their old interface.
As I also have a SGPro v3 license: this works as expected. I do not own a v4 license so I could not check.
Hope this helps.
Michel

Closed 2023-01-17.

Thread 300 (2023-01-29):

Meteoblue not showing correct local date?

aphelyon-net, 2023-01-29:
Just installed Version3.
I've configured the metoeblue api to test. It appears that it's showing as of local time, but UTC is not matching?

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

Meteoblue is reported days as 30Jan onwards.

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

mworion, 2023-01-29:
Hi,
there is a small issue about changing UTC / Local as it will update only on startup correctly (setting under settings/user Interface).
Actually the json used by MW4 looks different. Which data are you showing?
Michel

aphelyon-net, 2023-01-29:
Im using the https://my.meteoblue.com/packages/basic-1h?apikey=XXXXXXXXXXXX&lat=-31.7885&lon=117.329&asl=297&format=json

I tried using just apikey, then daily. Also tried local time.

Im not sure if this should be showing daily , or hourly. It seems to also be showing times 12hours earlier as the first entry, where Id expect closet rounded down start time on first load, then populating time from thereon.
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

mworion, 2023-01-30:
MW4 is using a different api (always asking for UTC), which should be ok. In your case (seeing set to local time) the purple line is correct highlighted.
You're point about what should be the start is valid, but meteoblue does only 2 times a day a calculation. So MW4 does only retrieve this data 2 times a day. For a simpler processing, MW4 builds the GUI each time it collects the data. Meteoblue does also send a complete set (beginning with 00:00 UTC) in any case, so I do not cut out data sent from meteoblue just for transparency reasons.
I think about moving the cursor and position regularly to a better position. let's see.
Michel

aphelyon-net, 2023-01-30:
OK thanks for reviewing that. It would be good if somehow we could see 6hours from the current date. Not sure if it can't be done dynamically.. if a reload button would suffice what would recalc and display from the current hour and display the future 12hours or something similar.

mworion, 2023-01-30:
You have a scrolling of the data anyway for the next 3 days in that list.
If I find a solution for dynamic scrolling...

aphelyon-net, 2023-01-30:
Oh! Indeed yes :) I didn't see a scrollbar, but using my mouse I see that works thank you.
I leave this then to your discretion whether to deem this as requiring an update or not

mworion, 2023-01-30:
Good point about the scroll bar. I put it onto the todo list.
Michel

mworion, 2023-02-01:
Next release there will be some scroll bars in it.

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

Michel

mworion, 2023-02-10:
Hi,
if you install 3.0.1a1 you should be able to test the scroll bars.
(Internal Updater, write 3.0.1a1 in available version text field and click start updater)
Michel

aphelyon-net, 2023-02-12:
Fantastic, thanks. Will continue testing and report if any other issues found.

Closed 2023-01-30.

Thread 301 (2023-02-02):

No image ready received from camera to MW4

ACMBakx, 2023-02-02:
This is a new installation on another computer.
DellOptilex Win11Pro
First run after installation.

In contradiction to a former problem, I now get no image from the Touptek camera within MW4.
From NINA the image does come in. But not directly from within MW4
The camera connects alright, but when an image is taken the "image ready" message is not received.
MW4 waits indefinitely.
See log.
This happened in 01b. So I migrated to 3.0.0
Same thing.
The log from yesterday Feb 01 shows about images being taken via NINA but MW4 not able to have astap platesolve them.
This never happened to me before.
I had the mount connected to NINA as well to get the coordinates attached to the images.
Within NINA these images are solved by astap no problem.
I leave the  settings for image taking and astap solving at default.
That always has worked well. Surprisingly not anymore.    Computers . . . . . .

Last week I was using a new installation on a Mele miniPC.
There it was working as we discussed before. But that computer has been replaced by the Dell again.
This machine is  clearly more powerful and a lot faster with a i5  than the Celeron processor in the Mele.
Now I did a similar (identical?) installation on my Dell computer again. And the problem arises.

[mw4-2023-02-02.log](https://github.com/mworion/MountWizzard4/files/10569633/mw4-2023-02-02.log)
[mw4-2023-02-01.txt](https://github.com/mworion/MountWizzard4/files/10569665/mw4-2023-02-01.txt)

The second log file has a txt extension in a attempt to send it as attachment by mail.
But your new email service bounces mails with attachments. Also never happened before.
That is why I revert to this medium again.

Maybe you can shed some light on the matter.
Arie

mworion, 2023-02-02:
Hi Arie,
this channel is the right one. All others I need to follow up individually.
I checked the first log. Beside the fact as you remarked that image ready does does always responds False, the camera state is all the time on 2 which in ASCOM means on exposing. And this you see also on the release version.
That's strange. Would you mid to make a test with binning set to 2 or 4 ? For all the functions inside MW4 you only need about 1500 - 2000 pixels each axis.
Quick thoughts: 32 / 64 bit mixup. Is the ToupTek driver a 32 bit one?

For the second: If you check the FITS header of the NINA Images you would see RA = 0 DEC = 0 entry. So you don't have any hint for solving. NINA might transfer this based on the knowledge of the coordinates. So if it's a new install, please tell NINA to write the coordinates in the header. That's the source for MW4.

Michel

mworion, 2023-02-04:
Arie,
as a user, would you mind if MW4 increases automatically the bin on large sensors to avoid this load on ascom interfaces ?
Michel

ACMBakx, 2023-02-04:
I think ASTAP does a similar thing.
The binning only did not help.
It was the subframe setting at 50% that did the trick.
But if MW4 can do its magic with a little trick, I do not mind.

mworion, 2023-02-24:
Hi Arie,
I add a hint for good binning, but I do not set it! See image:

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

The value is to get 1750 pixels each axis.
Michel

ACMBakx, 2023-02-24:
Thank you Michael.Makes sense.The cause of my recent problem with astap not solving was that I had not set the focal length at the page where it is needed.On a mount related page one sets the focal length and apperture, but also at a calculations page this value has to be entered. I have done a clean installation and this was the first run. I (finally) noticed in the tabel next to the presented image, that the pixel ratio was way of.So I spent nearly half an hour to locate the field where the focal length needs to be put. After that, with binning, the image was solved as astap uses to. In a blink an eye.Settings. Mount.  Telescope Information readoutImaging Statistics and Formulae. Imaging Information readout and calculationIt was the second one that I had forgot.Does it make sense to couple them?RegardsarieVerstuurd vanaf mijn iPadOp 24 feb. 2023 om 17:15 heeft Michael ***@***.***> het volgende geschreven:
Hi Arie,
I add a hint for good binning, but I do not set it! See image:

The value is to get 1750 pixels each axis.
Michel

—Reply to this email directly, view it on GitHub, or unsubscribe.You are receiving this because you authored the thread.Message ID: ***@***.***>

Closed 2023-02-24.

Thread 303 (2023-02-04):

Flats Generator won't turn on when Flip Flat "Light On" button is clicked: Accessories > Cover > ASCOM  - Device found - ASCOM.Giotto.CoverCalibrator

rprangley, 2023-02-04:
**Describe the bug**

**New PrimaLuceLab Giotto flat panel and Alto 3 Motor in MW4: Light will not turn on.**

Setting the ascom driver under in MW4: Accessories > Cover > ASCOM  - Device found - ASCOM.Giotto.CoverCalibrator  connects through matched ports and a green MW4 connect colour is displayed.

Once connected, I attempt to turn the flat panel on by clicking the Flip Flat "Light On" button under the "Imaging" tab. The flat panel does not turn on.

To test proper operation of the flat panel; after disconnecting the driver form MW4 I then connected via PrimaLuceLab "PLAY" app and also via Voyager (separate instances and not at the same time). Both programs successfully turned on and off the light of the Giotto Flat Panel.

To note, I've noticed that the Giotto-Alto motor driver can only be used by one standalone program at a time. Multiple instances of connecting the driver to another program i.e. PrimaLuceLab "PLAY" app and MW4 does not work.

I have not tested the Flip Flat "Open", "Close" and "Stop" buttons as of yet due to bad weather. I'll test these soon.

Please find attached the log file.

[MW4 Log.zip](https://github.com/mworion/MountWizzard4/files/10608520/MW4.Log.zip)

MW4 version is the recent v3.0 release.

Best Regards,

Rowan

mworion, 2023-02-04:
Hi Rowan,

thanks for the report. This is a bug. Will be fixed in the next service release. Open and close should work, but please check. Unfortunately the interface for ASCOM is different to the ALPACA (I do not know why).

Michel

mworion, 2023-02-10:
Hi Rowan,
if you install 3.0.1a1 you should be able to test the fix.
(Internal Updater, write 3.0.1a1 in available version text field and click start updater)
Michel

rprangley, 2023-02-10:
Hi Michel,

Thank you!

I'll test this - along with the open/close operation - and will report back asap.

Best,

Rowan

rprangley, 2023-02-11:
Hi Michel,

MW4 v3.0.1a1 successfully installed.

I can confirm cover will open, stop and close successfully using each applicable button.

Unfortunately, the flat panel will not turn on using the assigned buttons.

To note, the PrimaLuceLab Giotto firmware version is 1.3.1

I've tested this using PrimaLuceLab "Play app, v1.5.3" and the flat panel turns on and off.

I've seen that when MW4 connects successfully and you go to the assigned imaging tab, the "intensity" identifier box has a "-" visible. Could this be the issue? As in, MW4 auto sets the brightness level to "0" and since I cannot assign or toggle the brightness level manually, the Giotto flat panel stays at "0" and reports visually no brightness?

Could a manual value be added so the user can control brightness to a set level?

At your service.

Best Regards,

Rowan

mworion, 2023-02-11:
Rowan,
I cannot test the driver without hardware, but I changed the settings of values. If I receive a brightness value from the driver, you could click on the value and change it.
This was true for INDi and should work for ASCOM as well.
I put it in 3.0.1a2. You give it a try.
Michel

rprangley, 2023-02-11:
Hi Michel,

Sorry for my delay - I had to finish an acquisition before updating to v3.0.1a2

I'm please to confirm the 1a2 version update was successful.

I've completed a test and am excited to confirm that the brightness values from the driver are received to MW4 and as such, the Giotto flat generator turns on!
From my test, the light must be turned on before brightness values can be changed, i.e. from 51 to 100. Once values are changed, brightness increases with nominated values.
Great outcome!

Many thanks for addressing this Michel!

Best Regards,

Rowan

mworion, 2023-02-11:
Great to hear!
Yes. You have to turn it on. This is a glitch in ASCOM Interface specification as you don't have a property to set brightness.
Michel

Closed 2023-02-11.

Thread 304 (2023-02-08):

Can't install MW4 on RPi4 Ubuntu 22.04

orfest, 2023-02-08:
I can't install MW4 after trying all possible installation options. Please help.

Device: Rpi4 4GB
OS: Ubuntu 22.04

I have a very old installation which doesn't start because `ephemeris segment only covers dates 2018-12-27 23:58:51Z through 2023-01-07 23:58:51Z UT` and want to install a new version. Especially interested in 3.0.0, but any version will do.

Installing MW4 3.0.0 is not supported according to https://mworion.github.io/MountWizzard4/install/mw4.html
Tried 2.0 install scripts for Ubuntu and Mate, and they both fail.

`PyQt5-5.15.8.tar.gz` cannot be installed. This version of `PyQt5` goes into an infinite loop, consumes all RAM and eventually dies.
Don't see how to use one of the precompiled wheels.

[install.log](https://github.com/mworion/MountWizzard4/files/10687784/install.log)

After some hacking made the old installation of MW4 launch. Started the update to MW4 3.0.0 and it tries to collect the same `PyQt5` package, which is impossible.

When I try to collect older versions of `PyQt5` they complain about the `sip` package and I can't workaround that.

Not MW4 not supporting Python3.10 creates a mess, because Ubuntu 22.04 has given up on Python3.9, even package `python3.9-venv` no longer exists. Installed that from the `deadsnakes` ppa.

mworion, 2023-02-08:
Hi orfest,
the v2 version could be updated with:

Please replace the de421_23.bsp file under /data with the zipped one under [https://www.dropbox.com/s/glqx2zgz21pjy ... p.zip?dl=0](https://www.dropbox.com/s/glqx2zgz21pjy1l/de421_23.bsp.zip?dl=0). See also 10micron forum
https://www.10micron.com/forum/viewtopic.php?f=18&t=1887

Actually the underlying external frameworks do not support aarch64. MW4 is prepared for that, but not these frameworks. So actually I'm sorry about this as I did also not manage to build the headers myself.

The release notes and the hint in 10micron forum show the unfortunate situation:
https://mworion.github.io/MountWizzard4/changelog/changelog.html#version-3-0.

Michel

orfest, 2023-02-09:
Thank you, for the prompt response.
Updating the ephemeris helped indeed.
Then I'm stuck with `2.2.0`. Let's hope the dependencies get an update and become `aarch64` compatible again.

mworion, 2023-02-09:
The actual version 2 is 2.2.9. So if you use the internal updater and enter in the text field 2.2.9, you will get the latest updates / fix if necessary. If everything works, keep the actual one.

Closed 2023-02-09.

Thread 306 (2023-02-12):

MW4 won't boot mount on application startup or via dedicated button

rprangley, 2023-02-12:
**Describe the bug**

Hi Michel,

I hope you don't think me a bug for hassling you with reports!

I noticed this bug last night while I was testing the Flip-Flap on/off but thought it was just a glitch. Starting things up tonight, the following occurred:

When launching MW4, the mount would not wake via WOL. I tried the dedicated "On" button within MW4 and still, mount would not wake/turn on.

Please find attached the log file from this evening test. Here, MW4 was launched and the dedicated "On" button several times. To wake the mount, I used another software called "WakeMeOnLan" and this woke the mount straight away. You will see in the log where MW4 connects to the mount.
I used MW4 "Off" button to turn the mount off, followed by consecutive MW4 "On" button presses which yielded no results.

[mw4-2023-02-12.log](https://github.com/mworion/MountWizzard4/files/10715918/mw4-2023-02-12.log)

To confirm equipment; 10 Micron GM3000HPS  v3.0.8
IP and MAC address are the same in WakeMeOnLan and MW4.

MW4 v3.0.1a2

Sorry for the hassles.

Best Regards,

Rowan

mworion, 2023-02-12:
Rowan,
not bothering at all. Did it work at some point in time? If not there are some glitches, which could appear in using WOL. So far I do not see any fault in the log.
Please have a look to https://www.10micron.com/forum/viewtopic.php?f=2&t=1578&p=13354&hilit=wol#p13354, which could show you some hint. That's the reason, why MW4 could be configured in multiple ways.
In addition, if the mount computer was switched of from power supply, WOL does not start, as the MAC table might be lost in your switch.
The best way might be that you start with an IP address broadcast, which matches your subnet.
Hop this helps.
Michel

rprangley, 2023-02-13:
Good Morning Michel,

Many thanks for the link! Amending MW4's broadcast address worked; following the information in the link you provided, I changed this to 192.168.1.255

WOL via the dedicated "on" button worked as did WOL via starting a new launch of MW4.

Many thanks for your help!

Best,

Rowan

mworion, 2023-02-13:
Ok, closing.

Closed 2023-02-13.

Thread 317 (2023-05-27):

Watney Solver cannot be used under Win10

astroalex80, 2023-05-27:
Dear Michel,

installed Watney on my Win10Pro Notebook. Really like it as seems to do very fast blind solving even without providing any imaging data. However, not getting it to run in MW4 as the field unter Settings>Devices is not turning green.

Below the sequence out of the log file.
[2023-05-26 16:35:29.089][I][      watney.py][ 256] No index files found
[2023-05-26 16:35:29.090][I][      watney.py][ 258] Watney OK, app: [F:\MountWizzard4\watney-cli/watney-solve.exe], index: [F:\MountWizzard4\watney-index]
[2023-05-26 16:35:29.090][D][  plateSolve.py][ 332] Framework: [watney], True, False
[2023-05-26 16:35:29.090][U][     mainApp.py][ 371] Message window: [Driver - WATNEY enabled - plateSolve]

Have provided the right path information and the index files are existing.
Do I have to put them elsewhere?

(FYI, When hoovering over the "folder astronomy index" textbox on the Watney tab it says "path to astap star database". sure this is just a typo and not causing the error).

Thanks in advance and kind regards,
Alex

mworion, 2023-05-27:
Hi Alex,
as the log says, the index files are not present. MW4 tries to check the number of files needed for a correct install. There might be some subdirs in your folder for different FOV, so you have to select further.
In case of my screenshot you need to select a dir ending with -v3.
MW4 checks the presence also during selection. You should see a red frame in case MW4 does not see the index files.

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

I checked it and with present index files Watney works at least in my setup.
BTW: which MW4 version do you use. Your remark about the textbook is about the tooltips and not related to any function. I correct this entry next service release. Thanks for the hint.

Hope this helps.

Michel

astroalex80, 2023-05-28:
Dear Michel,

thanks for your reply. Managed to select the index files properly ;-)
However, solving still fails. Watney Desktop app is blind solving the image within a few seconds. When calling why MW4 an timeout is occuring (180 degrees - all sky and timeout 240 seconds).

Could you please give it a try to solve the image via MW4? As its too large (51 MB) to be uploaded here directly please take following download link from my online storage: [https://hidrive.ionos.com/lnk/sLyzRYXv](url)

The picture is all but good -  weak signal, few stars, no tracking but however it is solvable.

As you asked, I m having MW4 v3.1.0 installed.

Also noticed, when loading an XISF file in the imaging tab solving with Watney is not possible because Watney is not supporting XISF.

Thanks for checking.

Kind regards,
Alex

mworion, 2023-05-28:
Hi Alex,
tried it.

First: there is no meta information at all in the file (RA / DEC). That's bad as you normally should know at least where your mount is pointing to. Otherwise you need very much time.

I used ASTAP blind solve and it took 65s to solve it.

Watney Online did not accept this files for whatever reason.

Watney did not solve after 300s for whatever reason. It just times out. From the aster solve I would guess that you need the Passes 10-11 (built using 640, 905 stars per square degree) database. But I'm not sure as I do not have information about your optical train.

You're right. I can load XISF files, but the solver accesses the original file. If it does not support XISF, solving will fail.

Hope this helps.
Michel

astroalex80, 2023-05-28:
Thanks Michel. Strage enough Watney Desktop appilcation is solving it in seconds.
However its not a proper image anyway.
My image train is an 355mm / 1535 mm Newtonain with an QHY268M (IMX571).

As figured out thanks to your help how to properly setup the index files, issue closed :-)

Kind regards,
Alex

mworion, 2023-05-28:
You‘re welcome!

Von meinem iPad gesendet

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

Closed 2023-05-28.

Thread 321 (2023-07-06):

MW4 needs an additional "post meridian flip settling time" user settable parameter

tonk777, 2023-07-06:
This is just an observation and a request for enhancement :)

Currently Mw4 supports under "Settings" -> "Mount", the parameter "Waiting time after mount finished slew"

I currently have this set at 5 seconds for general slew and get very good results. However after a meridian flip when the scope, filter wheel, focuser and camera are rapidly inverted in orientation my rig needs a much longer settling time - in the order of 2 minutes to reach stability.

Currently to get good model results I have to run ordered East to West to minimise the merdian flip to just one flip, and I always have to prune out the first 5 or so points after the meridian flip (RMS in order of 40" for first point after flip decreasing to under 5" after 4 additional points)

So can we have an additional parameter ... "Settings" -> "Mount" -> "Waiting time after mount finished MERIDIAN FLIP"

tonk777, 2023-08-24:
Hi - is this being accepted as a new feature and if so which release will have it? Asking for a friend too :)

mworion, 2023-08-24:
Yes, it should be in the next release 3.2.

Implementation is already done and quickly tested at home. Are you willing to volunteer as beta tester?

Michel

Von meinem iPad gesendet

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

tonk777, 2023-08-24:
"Are you willing to volunteer as beta tester?"

Yes :) - and I have another tester lined up with a rig in Spain (mine is in Chile)

mworion, 2023-08-25:
Hi Tonk,
there is a v3.2.0b0 version online. If you are on v3 stream anyway, please check show beta in the local installer and you will see the version for test. If not, please for betas as always: separate work dir und do a second install.
The explanation how it should be setup is here : [https://mworion.github.io/MountWizzard4/config/mount/settlingTime.html](url)
Michel

Ruediger3, 2023-08-25:
Hi Michel,

thanks for the feature. I have update and I am a bit confused about it.
Unfortunately the link given above is not working for me.

Rüdiger

mworion, 2023-08-25:
Link should work now

Ruediger3, 2023-08-25:
Link works now and I have read it, but I have to admit, I am struggling with it. Maybe I need a calm minute to understand it.
Rüdiger

Ruediger3, 2023-08-25:
Hi Michel,
I need your help: how to I add extra time after a flip, without extending the time between the slews?
Rüdiger

mworion, 2023-08-25:
Rüdiger,
Ideally the standard mount settle time is OK for normal operation and also for modeling, so you would have a settling time for your mount set (upper image, in my case I have 1s set). If you would like to have an extended time only after flip, you set the additional time to 0s without flip and for the addition time after flip to x seconds (parameters shown in the second image).
But it might be a good idea to add an example in the doc.
Hope this helps.
Michel

Von meinem iPad gesendet

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

Ruediger3, 2023-08-25:
Hi Michel,
Thanks for the help. Slowly I think I understand the logic.
I think the logic is very confusing. Why not having simply three fields slew, settle and flip settle time? This is much more versatile, flexible and all parameters could be kept in one place. Also they are not mutually impacting. All parameters can be set independently and can be combined as needed.
I really had trouble to understand it, because the labels could be interpreted also in different way.
Rüdiger

mworion, 2023-08-25:
Any help and ideas appreciated.
Reason why I put this into different locations:
Settling time is managed in mount itself and could be altered with many tools.
I cannot use this parameter to adjust flip etc as I would change the basic behavior of the mount for many use cases without the knowledge of the user. If the user kills MW4 an altered parameter would be in the system.
I cannot add this feature after flip longer settle time to the system itself as I build a workaround as I cannot access the system for that.
So I tried to split this by settling time and a parameter which helps during modeling.
What is thinkable if you really need two waiting times as if the settling is done correct, you normally would set the addition wait time without flip to zero.
Michel

Von meinem iPad gesendet

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

Ruediger3, 2023-08-25:
Hi Michel,
Many thanks for explaining. These are good reasons. For my point of view the mount settle time in the mount plus a separate wait time for flip would be sufficient. Reason: if the settle time in the mount is good for imaging, it is by far good enough for the model build. I don’t see any practical benefit for extending it during build.

but what I would suggest is not to distribute the parameters over the tabs. I would try to keep them side by side, since they logically belong together.
What is your opinion?

Rüdiger

mworion, 2023-08-25:
OK,
it makes sense to remove the non flip option.
Still I struggle a little bit to put it on the same UI as there might rise the wrong expectation to enable a longer settle time for all use cases of the mount. I would like to keep them separate or as I had before to remove to set the 10micron mount settling time at  all as it was not present before anyway.

@tonk777 Any other thoughts?
Michel

mworion, 2023-08-27:
Further Thougts:

I tried to consolidate it to one place. There is another obstacle as for the settling time the mount takes car and does persistence for wait time it's MW4 and it's config file. So far I do not persist any value which belongs to a parameter set inside the mount and I would like to keep it. So I have to poll these values and GUI interaction is different. You might have experienced it, that for mount persisted values there is the need of a popup, whereas in MW4 persisted you just could alter the values in place.

Michel

mworion, 2023-08-29:
Version 3.2.0b1 (due to next days) will have the version I would like to keep. Any news about the function itself ?

Ruediger3, 2023-08-29:
Hi Michel,
I have nothing to add. I only need additional time after slew. I think Tonk owes you a feedback.😉
Life I could not test due to clouds.

Cheers
Rüdiger

tonk777, 2023-08-30:
Hi I'm still on holiday. Can't do much from a campervan!

Will test this out  when I get back at the weekend

Tony (Tonk)
________________________________
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

Closed 2023-11-05.

Thread 324 (2023-09-04):

Windows Startup scripts not Visible

h2ologg, 2023-09-04:
**Describe the bug**
When using the link [https://github.com/mworion/MountWizzard4/blob/master/support/3.0/startupPackage.zip](url) to obtain the MountWizzard 4 download there is nothing but a RAW download/view. This is also true for 2.0.

**To Reproduce**
Steps to reproduce the behavior:
1.Click the link for both 3.0 and 2.0

**Expected behavior**
Should be info as shown in documentation for Installation including a download button.

**Screenshots**
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
**Desktop (please complete the following information):**
Windows 11

**Additional context**
I've attempted this in both Chrome and MS edge Same result.

Thanks for checking/fixing!

I have MW4 working on two other computers and enjoy/ proud of its functionality.  This is a new computer build.

mworion, 2023-09-04:
Hi,
for some reason GitHub changed behavior. I did a try and if you follow this link:
https://github.com/mworion/MountWizzard4/blob/master/support/3.0/startupPackage.zip
and click RAW, it will download a ZIP file. In my case it was name true.zip (I do not know why). If you unzip this file, you see the installer....
Hope this helps.
Michel

h2ologg, 2023-09-04:
Thank you Michel,I’ll give it a whirl and if doesn’t work I’ll report back. Many, many thanks for an amazing indispensable program. It makes 10micron mounts more premium than they already are. Best,DanOn Sep 4, 2023, at 11:42 AM, Michael ***@***.***> wrote:
Hi,
for some reason GitHub changed behavior. I did a try and if you follow this link:
https://github.com/mworion/MountWizzard4/blob/master/support/3.0/startupPackage.zip
and click RAW, it will download a ZIP file. In my case it was name true.zip (I do not know why). If you unzip this file, you see the installer....
Hope this helps.
Michel

—Reply to this email directly, view it on GitHub, or unsubscribe.You are receiving this because you authored the thread.Message ID: ***@***.***>

h2ologg, 2023-09-04:
Hi Michel,Curios...When I attempt to download the RAW it downloads a file named startupPackage.zip for both 3.0 &2.0  both are non functional as an installer (Both zipped and unzipped).  The command screen blinks and returns to the original state.  Hoping you can run the installer and see what's up.  I have command line verified python 3.10.11 installed.  The startup package doesn't install the usual files I have on two other computers.  I'm struggling.Thanks for giving this your attention.Dan Bartlett
    On Monday, September 4, 2023 at 12:11:23 PM PDT, Dan bartlett ***@***.***> wrote:

 Thank you Michel,I’ll give it a whirl and if doesn’t work I’ll report back. Many, many thanks for an amazing indispensable program. It makes 10micron mounts more premium than they already are. 

Best,Dan

On Sep 4, 2023, at 11:42 AM, Michael ***@***.***> wrote:

Hi,
for some reason GitHub changed behavior. I did a try and if you follow this link:
https://github.com/mworion/MountWizzard4/blob/master/support/3.0/startupPackage.zip
and click RAW, it will download a ZIP file. In my case it was name true.zip (I do not know why). If you unzip this file, you see the installer....
Hope this helps.
Michel

—
Reply to this email directly, view it on GitHub, or unsubscribe.
You are receiving this because you authored the thread.Message ID: ***@***.***>

mworion, 2023-09-07:
Dan,
I put the installer to dropbox, hope this helps:
https://www.dropbox.com/scl/fo/msc4h987y55mt9249cmbo/h?rlkey=6e3v2sucp8gbqibd83mlyi3ni&dl=0
Michel

h2ologg, 2023-09-07:
Thank you Michael!
I fell back to MW3 and was missing your 4.0.  Truly feel that 4.0 is a marvelous piece of software.  Love the DSO modeling ability (great for quick set up remote site work especially useful for low altitude comets and slow to download full frame  cameras).  The functionality of 4.0 is amazing!
Thank you for spending so much of your time.Dan 

    On Thursday, September 7, 2023 at 02:58:46 AM PDT, Michael ***@***.***> wrote:

Dan,
I put the installer to dropbox, hope this helps:
https://www.dropbox.com/scl/fo/msc4h987y55mt9249cmbo/h?rlkey=6e3v2sucp8gbqibd83mlyi3ni&dl=0
Michel

—
Reply to this email directly, view it on GitHub, or unsubscribe.
You are receiving this because you authored the thread.Message ID: ***@***.***>

|  | Virus-free.www.avast.com |

mworion, 2023-09-11:
Hi Dan,
did it work out ?
Michel

h2ologg, 2023-09-12:
Hi Michel,Just another zip file to the startup.   I’ve given up.  I will continue to use MW3 on the new computer.  Appreciate the assistance  Best,DanOn Sep 11, 2023, at 12:12 PM, Michael ***@***.***> wrote:
Hi Dan,
did it work out ?
Michel

—Reply to this email directly, view it on GitHub, or unsubscribe.You are receiving this because you authored the thread.Message ID: ***@***.***>

mworion, 2023-09-17:
Dan,
not happy seeing you getting back to MW3. I understand, that you have problems getting the installer script to be able to start with MW4. The file you need is called startup.pyz and it's a python script like MW4 is.
I checked the dropbox link downloaded starupPackage.zip and unzipped it, there I found the startup.pyz file, which does the install and everything else.

If you are still interested I could offer a joint team viewer session, to check what I could improve to make things more easy and find out, what causes the problem.

Michel

h2ologg, 2023-09-19:
Hi Michel.  It's now working!  I uninstalled Python 3,10 trashed the old MW4 and reinstalled both anew.  Works like a charm!  Back to tracking satellites when I'm in the city and cometswww.astrobin.com/users/h2ologg/ when I'm at the cabin in June Lake California USA.  

|
|
|
|  |  |

 |

 |
|
|  |
Dan Bartlett's gallery

Astrophotography by Dan Bartlett on AstroBin
 |

 |

 |

All thanks to your splendid software and GM1000 & 200hps mounts.  Again your DSO modeling tracks were a life saver for remote imaging setup prior to C/2023 P1's rising.  Amazing tool!  Thanks for extending your reach to help.Regards,Dan
    On Sunday, September 17, 2023 at 08:48:05 AM PDT, Michael ***@***.***> wrote:

Dan,
not happy seeing you getting back to MW3. I understand, that you have problems getting the installer script to be able to start with MW4. The file you need is called startup.pyz and it's a python script like MW4 is.
I checked the dropbox link downloaded starupPackage.zip and unzipped it, there I found the startup.pyz file, which does the install and everything else.

If you are still interested I could offer a joint team viewer session, to check what I could improve to make things more easy and find out, what causes the problem.

Michel

—
Reply to this email directly, view it on GitHub, or unsubscribe.
You are receiving this because you authored the thread.Message ID: ***@***.***>

|  | Virus-free.www.avast.com |

Closed 2023-10-25.

Thread 336 (2023-11-08):

PegasusAstro UPBv2 wrong entities mapping using Ascom

hdiessner, 2023-11-08:
The Mapping of some entities between the Pegasus Astro UPBv2 and MountWizzard using Ascom seem to be wrong.
See Screenshot attached:
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

**UPBv2 - "Power Hub"**
MW4 - "Power Ports": "Power" Buttons are working, but no Display of "Current"

**UPBv2 - " USB Hub"**
MW4 - "USB Ports":
- USB1 - powers USB4 on UPBv2
- USB2 - powers USB5 on UPBv2
- USB3 - powers USB6 on UPBv2
- USB4 - powers Dew A on UPBv2
- USB5 - powers Dew B on UPBv2
- USB6 - powers Dew C on UPBv2

All Display Values are unavailable on MW4 in sections "Consumption" and "Adjustable output"

Versions used:
Python: 3.10.11
Script Version 3.2
MW4 3.2.4
PegasusAstro Unity Platform v1.11.2039.91

For reference: when the UPBv2 is controlled via N.I.N.A. the mapping of all entities seems to be ok.

mworion, 2023-11-12:
Herwig,
thanks for the report. I did not catch that Pegasus made a new driver setup and software. As I used my Pegasus UPBv2 through Indi, I did not catch the difference. NINA is using a native driver to enable all functions as ASCOM with the switch interface was lagging.
So it will be more a feature request (I would put it on the list) to implement a native driver as well.
Michel

Closed 2024-01-21.

Thread 337 (2023-11-29):

Image Solve Failures on Polar Align

Altair8861, 2023-11-29:
**Describe the bug**
When selecting 9 point alignment model and executing, mount correctly cycles through points but none of exposures solve using ASTAP

**To Reproduce**
Steps to reproduce the behavior:
Focus scope using Bahtinov mask, Luminance Filter
Launch MW4
Connect to camera
Verify focal length
Go to Modeling Tab->Generate Build Points and select 9 points
Within Modeling Tab select Model Build and Program->Run

**Expected behavior**
After running 9 point alignment model, 0 points in model. Checking Message Tab all points failed (screenshots below)

**Screenshots**
If applicable, add screenshots to help explain your problem.
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

**Desktop (please complete the following information):**
Windows 11
MW4 3.2.4
ASTAP 2023.11.17 D50 database

**Additional context**
Initial failure was using previous ASTAP and S17/H18 database, updated to latest ASTAP 2023.11.17 and D50 database. Solving still failed.

Loading image files into MW4 and solving with ASTAP appears to work. Also able to capture and solve images in NINA using ASTAP. Performed Autofocus in NINA and re-ran MW4, images still fail to solve.

Altair8861, 2023-12-01:
Ok, these were found under Windows_Scripts->Log.

The November 28 file should be the failure, the September 24th file should have been a success.

Other than moving the mount physically, no other changes I can recall.

[mw4-2023-09-24.log](https://github.com/mworion/MountWizzard4/files/13520281/mw4-2023-09-24.log)
[mw4-2023-11-28.log](https://github.com/mworion/MountWizzard4/files/13520282/mw4-2023-11-28.log)

Altair8861, 2023-12-05:
Attached are images from the failed align last week. Looking at them, it appears they are blank frames. Tuesday night will be clear, should be able to make another attempt.
[Nov228_fail.zip](https://github.com/mworion/MountWizzard4/files/13554977/Nov228_fail.zip)

Altair8861, 2023-12-06:
Here is the debug log from a few moments ago - the camera is shooting but not recording.

Focus was done with a Bahtinov mask using NINA to control the camera. Worked fine.
[mw4-2023-12-06.log](https://github.com/mworion/MountWizzard4/files/13574615/mw4-2023-12-06.log)

mworion, 2023-12-06:
Hi,
checked the log, is says error code 2 from ASTAP, which means not enough stars found, which fits to the observation of black frames. I checked them with Pixinsight, there is nothing in. The header data in the file seem to be OK.
Michel

mworion, 2023-12-10:
That looks strange.
As you are using NINA as well, the ideal config together with MW4 would be:
- Enable API server in NINA
- Set Camera to NINA controled
- Connect all devices you in NINA (at least Camera, Mount)
- Do things within MW4 as it uses the camera through NINA
Actually with the ASCOM driver the image content is black, which leads to an incompatibility issue.
Please keep in mind that the camera could not be connected to NINA and MW4 at the same time. As there is a resource conflict (even if you are using Native driver in NINA).
So either you connect in MW4 and disconnect in NINA before (and vice versa) or you are using the camera from MW4 through NINA, which mean that only NINAcontrols the camera.
Hope this helps.
Michel

shine1532, 2023-12-13:
I have the same problem from yesterday. I have been using it without any problems for a few years, but after updating to the latest version, the same problem as Altair8861 has been occurring since yesterday. I've been using NINA with MW4.
Even when only MW4 - v.3.2.4 is running without running the NINA program, the image data taken by the camera does not appear on the imaging screen at all.
Can you explain more about "enable API server in NINA. Set camera to NINA controlled"?

mworion, 2023-12-14:
Hi,
In nightly it is a separate Plugin, whereas in official 2.x build you find it under system tab in NINA.
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
But anyhow I published a 3.2.5, which should be better.
Michel

shine1532, 2023-12-15:
Thank you, Michael!
After upgrading to 3.2.5, it works again.
MW4 is a really cool integrated system. I would like to take this opportunity to say thank you very much.
Young

mworion, 2023-12-15:
Thanks for the feedback.

Closed 2023-12-15.

Thread 338 (2023-12-02):

Astap error (exception during solving)

Vandewattyne01, 2023-12-02:
In astap i'm able to solve the image but not in MW4.
It shows the message Astap error (exception during solving) and in the logs I see the msg:

 plateSolve.py][ 286] Start thread for solving
[2023-12-02 17:52:43.763][U][     mainApp.py][ 371] Message window: [Image - Solving - M31.fits]
[2023-12-02 17:52:43.766][C][       astap.py][ 119] error: [WinError 5] Access is denied happened
[2023-12-02 17:52:43.766][W][       astap.py][ 181] ASTAP error [Exception during solving] in [C:\Astro\MW4\image\M31.fits]
[2023-12-02 17:52:43.767][U][     mainApp.py][ 371] Message window: [Image - Solving error - ASTAP error: [Exception during solving]]
[2023-12-02 17:52:43.769][D][  plateSolve.py][ 253] Finished clear thread for solving

mworion, 2023-12-04:
Hi,
if you don't mit, please post the image you want to solve here (zip it before and drop it here) and please raise the log level for MW4 to debug (to see a little bit more when running)
Michel

Vandewattyne01, 2023-12-06:
Hello Michael,
This is the file. In the software astap i can solve it.
I installed MW4 on another PC with the same result.

[m31.zip](https://github.com/mworion/MountWizzard4/files/13588226/m31.zip)

mworion, 2023-12-06:
Hi
some hints:

- the RA coordinate if a little off: either you start modeling or your mount system time / orientation / model is wrong or not correctly set. DEC is OK.

- default for solving is a search radius of 10 for ASTAP. This is done to get fast results in case of having a reasonable model and good parameters. If you increase the search radius to 180 degree (all sky solving), ASTAP will plate solve this file within MW4. To be honest: ASTAP natively falls back to all sky in that case as well.

- but with a reasonable setup you should not need using all sky setup. Please check some parameters of your setup: the scale in the header is calculated (from SGPro) to 286 (arcsec/pixel) which leads to an extreme wide field of view. ASTAP recognizes that and outputs:

```
ASTAP took 0.2851221561431885s return code: 2 [/Users/mw/Desktop/M31_1.fits] stderr:  stdout: Could not find w08 star database. Will try with an other database. Using star database D50 Very large FOV, use W08 database!  Cropping image x 0.03 █ █ █ █ █ █ Warning, remaining image dimensions too low! Try to REDUCE OR REMOVE DOWNSAMPLING. Set this option in stack menu, tab alignment. Only 1 stars found in image. Abort No solution found!  :( Warning, reached the limit of the star database!
```
- ASTAP corrects this by doing all sky and being able to solve it anyway. If you get the solve, you see that the reals scale is about 2.86 arcs / pixel which is a quite normal number. If you change this setting in the FITS header of the image file, MW4 together with ASTAP with default settings solves the image within 1 second.

- Why does SGPro enters a wrong parameter - I do not know, because the pixel size with binning equals to 7.52 (quite reasonable) and with the FL of 500mm the scale would be  206 * (pixel size) / (focal length) = 206 * 7.52 / 500 = 3.09. So from my point SGPro does a mistake by entering a wrong number

Hope this helps.
Michel

Vandewattyne01, 2023-12-09:
Hi Michel,
In SGP i did the correction of the scale and the PA is also better now. But still I get the same error. Also I used some older subs and its the same. Is it working on the MW4 on you PC to solve it?

mworion, 2023-12-10:
Hi,
yes if you set ASTAP config in MW4 (search radius to 180 deg) to all sky, ASTAP solves the images. I'm think of making this the default as it should work in any cases.
Michel

mworion, 2023-12-14:
But anyhow I published a 3.2.5, which should be better.

Closed 2024-01-20.

Thread 344 (2024-01-13):

Build error - Out of sync exception

gpassera, 2024-01-13:
Hi Michel

running the model creation in binning 1 I got "Build error - Out of sync exception"
I presume the error is raised by the following condition

2024-01-13 18:45:56.064][I][    runBasic.py][ 163] Solving image-003:
[2024-01-13 18:45:56.065][W][  plateSolve.py][ 274] Image file not found: C:\MW4/image/m-2024-01-13-18-44-29-med/image-003.fits
File image-003.fits is present.
Any idea?
Thanks and regards
[mw4-2024-01-13.log](https://github.com/mworion/MountWizzard4/files/13929222/mw4-2024-01-13.log)

mworion, 2024-01-13:
Hi Giuseppe,
this happens when MW4 tries to start a plate solve and somethings happens in between. Then MW4 is not able to sync modeling process between the different running threads. I try to find out, what happened in calling the solver. I have never seen this before.
If you don't mind, please update to the latest beta.
With NINA I would do modeling timing to conservative if you are more in progressive now.
Michel

gpassera, 2024-01-14:
Michel
Thank you for your answer.
I will do what you suggest.
If it could help , the issue is present only in binning 1 and not in
binning 2.
Thank you
Regards
Giuseppe

Giuseppe Passera
www.giuseppepassera.com

Il giorno sab 13 gen 2024 alle 21:43 Michael ***@***.***> ha
scritto:

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

gpassera, 2024-01-14:
Btw, the issue can be closed.
Thank you very much.
Giuseppe

Giuseppe Passera
www.giuseppepassera.com

Il giorno dom 14 gen 2024 alle 18:00 Giuseppe Passera ***@***.***>
ha scritto:

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

mworion, 2024-01-14:
Giuseppe,
thanks for all the effort of testing. You comment on binning helps as bin1 does bring more load to the system (much more data to be handled).
I intend to smoothen this process with some refactoring and some hint for the users. ASTAP as well as modeling only needs 1500 px each axis to be good. So binning is a good way to improve speed overall.
Closing this issue, but please report back if you see more of this.
Michel

gpassera, 2024-01-15:
Michel

mine MW4 was already set to conservative.
If I remember well in some past version of MW there was the possibility of
setting a waiting time after the mount reached the position before
initiating the exposure.
Speaking with 10micron, this option would be useful to allow the mount to
position itself optimally before starting the exposure. It could also be
set a post-exposure timeout to give time to not particularly fast cameras
to fully download the image before solving.
Hope this help
Regards

Giuseppe

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

--
Giuseppe Passera
www.giuseppepassera.com

mworion, 2024-01-15:
Giuseppe,you will find this option under Mount Settings. There is an explicit wait time before exposing during modeling, which is independent from any setting in the mount.Post Exposure should be not an issue as long if the camera drivers report their status correct. There is a state downloading. MW4 respects this state and wait for downloaded the image. Conservative means MW4 wait until the image is save onto the disk.MichelAm 15.01.2024 um 10:15 schrieb gpassera ***@***.***>:
Michel

mine MW4 was already set to conservative.

If I remember well in some past version of MW there was the possibility of

setting a waiting time after the mount reached the position before

initiating the exposure.

Speaking with 10micron, this option would be useful to allow the mount to

position itself optimally before starting the exposure. It could also be

set a post-exposure timeout to give time to not particularly fast cameras

to fully download the image before solving.

Hope this help

Regards

Giuseppe

On Sun, Jan 14, 2024 at 6:38 PM Michael ***@***.***> wrote:

> Giuseppe,

> thanks for all the effort of testing. You comment on binning helps as bin1

> does bring more load to the system (much more data to be handled).

> I intend to smoothen this process with some refactoring and some hint for

> the users. ASTAP as well as modeling only needs 1500 px each axis to be

> good. So binning is a good way to improve speed overall.

> Closing this issue, but please report back if you see more of this.

> Michel

>

> —

> Reply to this email directly, view it on GitHub

> <https://github.com/mworion/MountWizzard4/issues/344#issuecomment-1891014466>,

> or unsubscribe

> <https://github.com/notifications/unsubscribe-auth/AKUSVCO7PITSPIAAPWOQLLTYOQJYZAVCNFSM6AAAAABBZQPIJGVHI2DSMVQWIX3LMV43OSLTON2WKQ3PNVWWK3TUHMYTQOJRGAYTINBWGY>

> .

> You are receiving this because you authored the thread.Message ID:

> ***@***.***>

>

--

Giuseppe Passera

www.giuseppepassera.com

—Reply to this email directly, view it on GitHub, or unsubscribe.You are receiving this because you modified the open/close state.Message ID: ***@***.***>

gpassera, 2024-01-15:
Michel
thank you, there are so many options.. :)
I will try.

Thank you
Giuseppe

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

--
Giuseppe Passera
www.giuseppepassera.com

Closed 2024-01-14.

Thread 348 (2024-02-19):

Dome Radius Minimum Too High

JimTheEngineer1, 2024-02-19:
I have a 6ft diameter dome. Dome radius is 0.914 meters. The dome setup (DDW dome) minimum dome radius is set to 1.0 meter. This produces substantial error when MW4 tries to control the dome and align it with the mount. The minimum value should be set to 0.8 meters for dome radius. This is using MW4 v3.2.5 using INDI drivers connecting to a StellarMate Pro v1.8.1.

mworion, 2024-02-19:
@JimTheEngineer1 ,
please try 3.2.6b16, this should enable 0.8m minimum and report back.
Michel

JimTheEngineer1, 2024-02-21:
Michel,Thanks for the quick response and action. I tried the new version last night and was able to reset the dome radius to 0.91. However, this did not improve the tracking. In fact while the mount is pointing to Polaris (0 deg), when the dome slaves to the mount it moves the dome to 347 deg. So right now I’m trying to figure out in the StellarMate Pro how to reset this. I have a DDW Dome and I’m not seeing a “Dome Train” function that I had with the windows based DDW program. So I need to fiddle with this before I try again.
Best regards,James Thornton

Sent from Yahoo Mail for iPhone

On Monday, February 19, 2024, 9:25 AM, Michael ***@***.***> wrote:

@JimTheEngineer1 ,
please try 3.2.6b16, this should enable 0.8m minimum and report back.
Michel

—
Reply to this email directly, view it on GitHub, or unsubscribe.
You are receiving this because you were mentioned.Message ID: ***@***.***>

JimTheEngineer1, 2024-03-23:
I tried to reload the beta version and the dome radius less than 1m disappeared. This coupled with no clear skies is slowing this down.

Sent from Yahoo Mail for iPhone

On Friday, March 22, 2024, 8:47 PM, github-actions[bot] ***@***.***> wrote:

This issue is stale because it has been open 30 days with no activity. Remove stale label or comment or this will be closed in 5 days.

—
Reply to this email directly, view it on GitHub, or unsubscribe.
You are receiving this because you were mentioned.Message ID: ***@***.***>

JimTheEngineer1, 2024-05-17:
Hi Michel. I have attached my current setup screenshots below. If you see any issues, please let me know. I currently have the driver taking over since I did not have any luck using MW4 windows version where you had allowed a smaller diameter dome (mine is 0.914m in radius). Between then and now, I downloaded the Linux/Python version on the SMPro.
Best regards,James Thornton

Message ID: ***@***.***>

JimTheEngineer1, 2024-05-17:
Sent from Yahoo Mail for iPhone

Message ID: ***@***.***>

JimTheEngineer1, 2024-05-17:
Sent from Yahoo Mail for iPhone

Message ID: ***@***.***>

mworion, 2024-05-17:
Hi Jim,
unfortunately doing a reply with attachments do not put them into the issue thread. But I could look to the postings in the 10micron forum. See answers there.
Please post the MW4 log to this issue after taking car of the hint. This will help me a lot, what is happening in the dome communication.
Michel

JimTheEngineer1, 2024-05-17:
Hi Michel. Got as far as I could today before rain. Had some real bad storms roll thru Houston yesterday evening. Should be able finish up tomorrow. I did update the 10Micron forum. Thank you for the help!
Best regards,James Thornton

Sent from Yahoo Mail for iPhone

On Friday, May 17, 2024, 1:33 PM, Michael ***@***.***> wrote:

Hi Jim,
unfortunately doing a reply with attachments do not put them into the issue thread. But I could look to the postings in the 10micron forum. See answers there.
Please post the MW4 log to this issue after taking car of the hint. This will help me a lot, what is happening in the dome communication.
Michel

—
Reply to this email directly, view it on GitHub, or unsubscribe.
You are receiving this because you were mentioned.Message ID: ***@***.***>

JimTheEngineer1, 2024-05-19:
Michel,MW4 is a bit unstable regarding the connection to the INDI drivers. Was having quite a bit of “freezing” annd restarts on both SMPro and MW4. Although still buggy, I find if you start MW4 first and then open kstars/Ekos it will connect most of the time.
I have attached the MW4 log to see if you can tell what is going on. It’s freezing when I first open MW4 and looks like this. Takes multiple attempts to get it to work.

I have to restart when this happens.
Best regards,James Thornton

Sent from Yahoo Mail for iPhone

On Friday, May 17, 2024, 5:29 PM, James Thornton ***@***.***> wrote:

Hi Michel. Got as far as I could today before rain. Had some real bad storms roll thru Houston yesterday evening. Should be able finish up tomorrow. I did update the 10Micron forum. Thank you for the help!
Best regards,James Thornton

Sent from Yahoo Mail for iPhone

On Friday, May 17, 2024, 1:33 PM, Michael ***@***.***> wrote:

Hi Jim,
unfortunately doing a reply with attachments do not put them into the issue thread. But I could look to the postings in the 10micron forum. See answers there.
Please post the MW4 log to this issue after taking car of the hint. This will help me a lot, what is happening in the dome communication.
Michel

—
Reply to this email directly, view it on GitHub, or unsubscribe.
You are receiving this because you were mentioned.Message ID: ***@***.***>

JimTheEngineer1, 2024-05-19:
Forgot to attach log.

Sent from Yahoo Mail for iPhone

On Saturday, May 18, 2024, 7:53 PM, James Thornton ***@***.***> wrote:

Michel,MW4 is a bit unstable regarding the connection to the INDI drivers. Was having quite a bit of “freezing” annd restarts on both SMPro and MW4. Although still buggy, I find if you start MW4 first and then open kstars/Ekos it will connect most of the time.
I have attached the MW4 log to see if you can tell what is going on. It’s freezing when I first open MW4 and looks like this. Takes multiple attempts to get it to work.

I have to restart when this happens.
Best regards,James Thornton

Sent from Yahoo Mail for iPhone

On Friday, May 17, 2024, 5:29 PM, James Thornton ***@***.***> wrote:

Hi Michel. Got as far as I could today before rain. Had some real bad storms roll thru Houston yesterday evening. Should be able finish up tomorrow. I did update the 10Micron forum. Thank you for the help!
Best regards,James Thornton

Sent from Yahoo Mail for iPhone

On Friday, May 17, 2024, 1:33 PM, Michael ***@***.***> wrote:

Hi Jim,
unfortunately doing a reply with attachments do not put them into the issue thread. But I could look to the postings in the 10micron forum. See answers there.
Please post the MW4 log to this issue after taking car of the hint. This will help me a lot, what is happening in the dome communication.
Michel

—
Reply to this email directly, view it on GitHub, or unsubscribe.
You are receiving this because you were mentioned.Message ID: ***@***.***>

mworion, 2024-05-19:
Hi Jim,if you attach the log via mail to github as response, it does not reach me. You have to drop the log directly on the browser thread.MichelAm 19.05.2024 um 02:55 schrieb JimTheEngineer1 ***@***.***>:
Forgot to attach log.

Sent from Yahoo Mail for iPhone

On Saturday, May 18, 2024, 7:53 PM, James Thornton ***@***.***> wrote:

Michel,MW4 is a bit unstable regarding the connection to the INDI drivers. Was having quite a bit of “freezing” annd restarts on both SMPro and MW4. Although still buggy, I find if you start MW4 first and then open kstars/Ekos it will connect most of the time.

I have attached the MW4 log to see if you can tell what is going on. It’s freezing when I first open MW4 and looks like this. Takes multiple attempts to get it to work.

I have to restart when this happens.

Best regards,James Thornton

Sent from Yahoo Mail for iPhone

On Friday, May 17, 2024, 5:29 PM, James Thornton ***@***.***> wrote:

Hi Michel. Got as far as I could today before rain. Had some real bad storms roll thru Houston yesterday evening. Should be able finish up tomorrow. I did update the 10Micron forum. Thank you for the help!

Best regards,James Thornton

Sent from Yahoo Mail for iPhone

On Friday, May 17, 2024, 1:33 PM, Michael ***@***.***> wrote:

Hi Jim,

unfortunately doing a reply with attachments do not put them into the issue thread. But I could look to the postings in the 10micron forum. See answers there.

Please post the MW4 log to this issue after taking car of the hint. This will help me a lot, what is happening in the dome communication.

Michel

—

Reply to this email directly, view it on GitHub, or unsubscribe.

You are receiving this because you were mentioned.Message ID: ***@***.***>

—Reply to this email directly, view it on GitHub, or unsubscribe.You are receiving this because you were assigned.Message ID: ***@***.***>

JimTheEngineer1, 2024-05-19:
Apologies for my thick head! lol. Attached is the latest log. I have also included a pic of what the freezes look like at startup. Btw - managed to get a successful model run.

Best regards,
James Thornton

[mw4-2024-05-18.log](https://github.com/mworion/MountWizzard4/files/15369186/mw4-2024-05-18.log)

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

JimTheEngineer1, 2024-05-19:
Mistakenly closed issue

mworion, 2024-05-19:
OK got it. Question: does this happen when you start MW4 without having the INDI part already started? If so, this is dues to the conservative timeout settings if the devices could not be reached. So in this case it would be no instability, but a long waiting time.
Still I will have a closer look. Good part: not s single error or warning in the log !
Michel

JimTheEngineer1, 2024-05-19:
No - just the opposite. It happens more when kstars/ekos/INDI is opened first. Last couple times I tried opening MW4 first and then kstars/ekos/INDI and it seems to work better, but still freezes sometimes.Jim

Sent from Yahoo Mail for iPhone

On Sunday, May 19, 2024, 10:44 AM, Michael ***@***.***> wrote:

OK got it. Question: does this happen when you start MW4 without having the INDI part already started? If so, this is dues to the conservative timeout settings if the devices could not be reached. So in this case it would be no instability, but a long waiting time.
Still I will have a closer look. Good part: not s single error or warning in the log !
Michel

—
Reply to this email directly, view it on GitHub, or unsubscribe.
You are receiving this because you modified the open/close state.Message ID: ***@***.***>

mworion, 2024-05-21:
Jim,
OK can't reproduce it in my setup with Stars/EKOS.
Could you do me a favor ? Please set the log level to trace, start MW4 and in case of a delayed start, please stop MW4 again and post the log file. Please reset the log level to debug afterward otherwise you are collecting all data transfer traffic, which would lead to an massiv log file size.
Michel

JimTheEngineer1, 2024-05-21:
Will do…

Sent from Yahoo Mail for iPhone

On Tuesday, May 21, 2024, 9:46 AM, Michael ***@***.***> wrote:

Jim,
OK can't reproduce it in my setup with Stars/EKOS.
Could you do me a favor ? Please set the log level to trace, start MW4 and in case of a delayed start, please stop MW4 again and post the log file. Please reset the log level to debug afterward otherwise you are collecting all data transfer traffic, which would lead to an massiv log file size.
Michel

—
Reply to this email directly, view it on GitHub, or unsubscribe.
You are receiving this because you modified the open/close state.Message ID: ***@***.***>

JimTheEngineer1, 2024-05-21:
It looks like it is fixed to me. I could not get it to freeze even when kstars/Ekos is opened first before MW4. Here are the logs, but all was successful.

mworion, 2024-05-22:
Jim,good to hear that it works, still the reason why we did not find out. But anyways: if you have a situation, where you observe this behavior, please do a trace log. This should be good for finding the reason.MichelAm 22.05.2024 um 00:26 schrieb JimTheEngineer1 ***@***.***>:
It looks like it is fixed to me. I could not get it to freeze even when kstars/Ekos is opened first before MW4. Here are the logs, but all was successful.

—Reply to this email directly, view it on GitHub, or unsubscribe.You are receiving this because you were assigned.Message ID: ***@***.***>

JimTheEngineer1, 2024-06-22:
Dome radius was repaired and I have not noticed any connection issues.

Closed 2024-06-22.

Thread 349 (2024-02-19):

Wait after slew not working

InFINNity-Deck, 2024-02-19:
Dear Michel,

I am currently modelling with my GM3000HPS and set the "Mount wait time while modelling" to 5s, but imaging is still done as soon as the mount indicates the tracking state.

I did restart MW4 after I set the value to 5s and it shows this setting upon restart.

Is there another setting required to let MW4 wait?

Nicolàs
PS: I am using MW4 3.2.5

mworion, 2024-02-20:
Hi Nicolas,
I will add another time for waiting explicitly. With the mount it is a little complicated. You have multiple wait times:

1.) Mount setting inside the mount computer: visible on Mount Page under Mount computer Settings. This is the internal settling time. Whenever a slew command is issued (from whatever source (driver, MW4, Handpad) and whatever use case, the mount computer will wait this time before showing the status slew finished. In this case exposing will immediately start after the mount signal received. So you experience tracking state the same time as expose start. But still you will have a defined settling time ! This might be your case

2.) Adding times during modeling: visible under mount settings. These are valid only while running a modeling session. After pier flip... will add a specific settling time on top of the basic settling time of the mount computer in a situation when MW4 know about a pier flip. The mount state will change immediately after basic settling time to tracking, but MW4 will show this state after this additional wait time. Exposing will start immediately after you will see tracking state in MW4.

3.) New: Adding a wait time during modeling before exposing. This will add another wait time after the mount and MW4 tells tracking. So you will experience this time delay between tracking state shows up and camera starts expose.
Does this makes sense ?
Michel

InFINNity-Deck, 2024-02-20:
Dear Michel,

thanks! It is indeed method 3) I was looking for as with a heavy set-up like mine the mount still moves a bit within the first 5 seconds after status is set to tracking.

But if I understand you well method 1) already does this, but then on the mount side. I presume you use the :SstmNNNNN.NNN# command for that? If so there is no need to implement method 3), although it may be more clear to the user as he/she will actually see the tracking state change and x seconds later that the exposure starts (this is why I thought that the delay did not work).

Nicolàs

mworion, 2024-02-20:
Nicolas,
You could check v3.2.6b17 now as a try out. If that helps, I keep it. Unfortunately my rig is disassembled, so I cannot test physically.
Michel

mworion, 2024-02-20:
...and yes, It's the command I used...

InFINNity-Deck, 2024-02-20:
Hi Michel,

thanks for your quick response and beta-version. I installed it and found the two settings:

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

As you can see I deliberately tested them with large values. I noticed the following:
- when restarting MW4 the two values get exchanged, so now we see 60s and 20s, after save and restart it is 20s and 60s.
- method 1) appears not be working on my mount. I tested this with MountMonitor and the Virtual Keypad. As soon as the RA/DEC values on the keypad show that the slew has (more or less) ended, the status goes to tracking (as indicated by the star-symbol and shown by MountMonitor) and MW4 continues, even though it should wait a minute (tested it with each field set to 60s, both times with a full restart of MW4).
- The new method 3) works like a charm (apart from above bug in saving). It works with the 60s in the "Additional wait time before exposure" field.

Nicolàs

mworion, 2024-02-20:
Hi Nicolas,
I mixed the settings when persist them. Bug on my side. Will be corrected. I will add some message in the status as well to make it more clear.
Please have a look to 3.2.6v18. There the mount setting should also work, there might be another bug in.
Michel

InFINNity-Deck, 2024-02-21:
Hi Michel,

you're swift as always, thanks a lot! First opportunity for me to test it will be Friday. Currently the weather turned for the worst, so mount and scopes are wrapped up in an additional cover and the dome is locked to resist upcoming high winds.

Nicolàs

InFINNity-Deck, 2024-02-24:
Hi Michel,

just now I tested v3.2.6b18. The settings are now correctly stored and retrieved and the "Additional wait time before exposure works as expected". The other option "Additional wait time after wait time, slew and settle" does not seem to work at all. While running MW4 I also tried to force this setting by sending #:Sstm60.000# to the mount using FoxTerm. The mount responds with a 1 (I received that in FoxTerm), indicating the command was successfully received, but wait time was not affected. It seems that the mount does not handle the command correctly or not how we think it should work.

Nicolàs

mworion, 2024-02-25:
Hi Nicolas,
I will check the other option as soon as my rig is back in operation. So far I could not test.
Michel

InFINNity-Deck, 2024-03-28:
Dear Michel,

your bot woke us up... ;-)

Did you have any chance to check the remaining issue?

Nicolàs

mworion, 2024-04-01:
Hi Nicolas,
same observation with the mount internal command. I will do some logs for 10micron and send them a ticket.
Closing this remaining part.
Michel

Closed 2024-04-01.

Thread 353 (2024-04-14):

Image zoom setting when looping images during polar alignment.

WillB-2024, 2024-04-14:
Hi Michel

In MW4 when looping images continuously (Expose N) to carry out an assisted polar alignment is there a user setting that maintains the current user set zoom ratio for as long as continuous images are downloading?

I find that as each image is downloaded using continuous exposures (Expose N) and the Crosshair display set to visible, the image zoom ratio reverts back to full frame with each new image, irrespective of the state of the checkbox for “Lock aspect” under the Image View group of the Imaging window.

I managed to carry out a polar alignment eventually by taking single images, adjusting the zoom ratio then manually adjusting the mount by guesswork, taking another single image and repeating until the polar alignment was completed.

The observatory monitor was just too far away to be seen easily from the mount and the image scale too small to accurately adjust the mount alignment without a large zoom factor applied, and that was not possible under Expose N looped exposures.

The camera used was a QHY268M and the QHY ASCOM driver, 100mm, f/5.8 quadruplet refractor of 580mm focal length at 2.6 arc sec/pixel binned 2x2, Windows 11.

The mount is now permanently pier aligned in the observatory and a sky model in place (10u 2000 HPS 11 Combi) with a PA inaccuracy of ~35 arc sec, so this is not urgent, but I would appreciate any hints on how to keep the chosen zoom ratio maintained when using Expose N continuous looped exposures for the next time I build a new model and make any adjustments to the polar alignment.

Kind regards.
William.

mworion, 2024-04-16:
Hi William,
the function you described should work since version 3.2.0 ongoing.

https://github.com/mworion/MountWizzard4/assets/6632980/b999b3a6-3a08-40f6-b4c8-7ad3a8e176ab

Michel

WillB-2024, 2024-04-17:
Thank you for the quick reply Michel.

I did not know that I was running the standard distribution of MW4, v3.1.0.

Updated MW4 today using the automatic updater to v3.2.25 and can now hold the zoom ratio during Expose N sequence so I should be good to go the next time I carry out a polar alignment.

Mit freundlichen Grüßen

William.

Closed 2024-04-17.

Thread 361 (2024-07-31):

Platesolve with ASTAP, missing mount point coordinates in FITS

stefanZbinden, 2024-07-31:
MW4 latest version 3.2.6

A long time ago, when NINA still was in 2.x version, I was using the camera with NINA (in server mode)
At that time I never had a problem with plate solving because NINA was putting the mount RA/DEC into the FITS header and ASTAP was very fast. MW4 was really fast building a mount model.

Since NINA version 3.x I am no longer able to use the camera with NINA (no server mode???) therefore I have to use the mw4 internal imaging stuff.
Unfortunately mw4 is not putting the mount point coordinates into the FITS header. Therefore a blind solve takes a long time and sometimes fails.

What is the reason not writing the mount point coordinates into the header? Yes, it can be completely wrong but in all other cases it helps for plate solving.

Maybe that I am missing a configuration step ....

Many thanks and my best regards
Stefan

stefanZbinden, 2024-07-31:
Uups, it may be not a bug. Sorry! It's my first time opening an issue ....

mworion, 2024-08-01:
Hi Stefan,
The server mode is a separate plugin you could install in NINA. This might be the simple solution for you. When using the camera directly, MW4 puts the coordinates to the FITS Header itself. To check if there is an error, would you mind to post the log here (just drop it on this webpage) ?
Michel

mworion, 2024-08-01:
Stefan, it's the following Plugin:

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

Michel

stefanZbinden, 2024-08-01:
Perfect! Many thanks!
As soon as there will be a clear night I will provide you with all the necessary info!
For me it is important that your tool is working as expected. It's a great thing!!!!!!!!

My best regards
Stefan

mworion, 2024-08-01:
You’re welcome !

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

stefanZbinden, 2024-08-13:
Hi Michel

Finally I found time to make a test during a perfect night, no moon, no clouds and dark.
Here the description of my test:
1. I built a model with the 10micron NINA plugin. I got a RMS of 4.9 arcsecs and I was able to take 5 minute subs without guiding. So I am pretty sure that I did it right.
2. For the test I was deleting the model -> no model active
3. I started mw4. The camera was attached through NINA. (SGP Plugin). ASTAP has been setup the right way because I did not have problems during plate solving in NINA.
4. I generated a 9 point model program.
5. After completion I got a horrible result. Only 4 positions were plate solved and the RMS was far away from 5 arcsecs. The altitude pointing was about 3 degrees away and the Polar Align Error was 140356 arcsecs off. These results are completely wrong!

I know at least two other colleagues who have similar problems.

I attach the log file and the result of NINA model and a picture of mw4.
The images you may find on my dropbox: https://www.dropbox.com/scl/fo/0yu6mksuspq3zxhthinrl/AF8XBquKGp1wdFr19ygp0lI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
There is absolutely no problem to plate solve these images. ASTAP can do it in less than 0.5s.
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
[mw4-2024-08-10.log](https://github.com/user-attachments/files/16595395/mw4-2024-08-10.log)

My best regards
Stefan

stefanZbinden, 2024-08-13:
Hi Michel

Puhh! Obviously there is a problem. I am happy to hear that. I don't like to file an issue then it can also be a user problem.

English is not my native language but I will try to explain my observations.

I NEVER had a problem with ASTAP. If there is a mount pointing coordinate in the fits header (more or less precise) ASTAP solves in less than a second. Incredible fast! I never had to change any parameters.
I started changing FOV/timeout the first time together with mw4. When I was first using mw4 (an older version) I had plate solving issues when I attached the camera through ASCOM directly to mw4. If I attached the camera through NINA I never observed any issues (older version). One time I had a problem but I forgot to attach the mount to NINA. So I assumed that there was no mount pointing coordinate in the fits header. (After attaching the mount the problem was solved)
When I take pictures through mw4 (manually, latest version) the plate solve takes a very long time. I found out, that there is NO mount pointing coordinate in the fits header. Look at the first Pixinsight picture with the fits header tool. So I was happy that you told me to use the SGP plugin for NINA. If you try to solve the provided images on my dropbox you will see that ASTAP solves VERY fast, but mw4 has a lot of trouble. However the mount pointing coordinate is in the fits header. Therefore I had to assume that the problem could be in mw4.

According to some forums where people had similar problems (also a Swiss and a German colleague) I changed then the FOV/timeout to 180/90s. But this does not really help.

If I set the FOV/timeout to 180/90s and if there are more or less precise mount pointing coordinates inside the fits header ASTAP solves very fast. The FOV does not have any impact. If the coordinate is missing this parameter change is necessary and the solve takes a long time... (it can also fail).

These are my observations. I hope you under stand my way of trying to find out what's going wrong. Do you have access to my email address? If yes, we can also communicate in German which would be easier ... Just an idea!

Many thanks for having an eye to my problems ...

My best regards
Stefan

stefanZbinden, 2024-08-13:
Hi Michel

Sorry I forgot to answer the first question: Right now the FOV is set to 180 degrees (because of suggestions out of the community). At the beginning the parameters were standard but then I never got a successful plate solve... (latest version)

Normally plate solving takes less than a second ... There is no popping up window ...

My best regards
Stefan

stefanZbinden, 2024-08-13:
I told you some rubbish .... I just tried to plate solve one of the 9 images through mw4. Load file and press solve.
If I set FOV to 30 it solves without a problem if the FOV is set to 180 it takes a long time ... 30s but the plate solve was successful.

Hmmmm I will try it again with FOV set to 30.

Maybe that I was hunting a ghost ....???? As soon as there are clear skies I will try it again ...

My best regards
Stefan

mworion, 2024-08-14:
Hi Stefan,wir können hier auch gerne mal etwas in Deutsch besprechen. Ich bleibe normalerweise auf englisch, um alle in der Diskussion zu beteiligen.Aber zu Deiner Einschätzung:- Es gab einmal das Thema, dass NINA keine Header geschrieben hatte, da wurde von mir der All Sky nachgerüstet.- Prinzipiell braucht MW4 keine Koordinaten, wenn es selbst Bilder macht, weil die Koordinaten der Montierung ohne hinbekannt sind -> Mittlerweile sollte ich die reinschreiben, muß aber nochmal nachschauen.- Ich werde All Sky auch wieder herausnehmen, nachdem NINA die Koordinaten schreibt. Wenn das notwendig wäre, ist ein anderes Problem vorher zu lösen. Ich hatte noch nie in einem Erstsetup mehr wie 10 Grad FOV benötigt, um mit ASTAP zu lösen.- Bei MW4 gibt es noch ein Problem, wenn die Solving Zeit mehr als 2x die Aufnahme und Slewing Zeit ist -> da bekomme ich einen Überlauf und verwerfe Bilder -> das macht so keinen Sinn. Das ist aber mit dem Verzicht auf ALL Sky ohnehin extrem unwahrscheinlich.- …und da gab es noch Unterschiede zwischen NINA 2.x und 3.xIn Summe aus meiner Sicht:- MW4 mit Kamera direkt sollte funktionieren mit FOV <=30 Grad- MW4 mit NINA ebenso.- Die Modell mit NINA und MW4 unterscheiden sich nicht wirklich.Danke für’s testen!MichelPS: Es wird hoffentlich bald eine 4.0 beta geben, wo MW4 die neue Firmware 3.1.15 ff unterstützt. Dort werde ich den Ablauf zu NINA nochmal überarbeiten.Am 13.08.2024 um 19:36 schrieb stefanZbinden ***@***.***>:
I told you some rubbish .... I just tried to plate solve one of the 9 images through mw4. Load file and press solve.
If I set FOV to 30 it solves without a problem if the FOV is set to 180 it takes a long time ... 30s but the plate solve was successful.
Hmmmm I will try it again with FOV set to 30.
Maybe that I was hunting a ghost ....???? As soon as there are clear skies I will try it again ...
My best regards
Stefan

—Reply to this email directly, view it on GitHub, or unsubscribe.You are receiving this because you commented.Message ID: ***@***.***>

stefanZbinden, 2024-08-27:
Hi Michel
Last week I had the possibility to test mw4 together with SGP plugin and NINA.
It worked after I changed the FOV of ASTAP back to 30 degrees. There were no timeouts or bad plate solves.
I generated a 30 point model.
As a next step I will try again to connect the camera via ASCOM directly to mw4. Sorry these tests need time. If we have a clear night I like to take images ...

My best regards
Stefan

mworion, 2024-08-27:
Hi Stefan,
great to hear. I will add an quick patch for manual imaging (through MW4) in 3.2.7b2
Michel

stefanZbinden, 2024-09-30:
Hi Michel
Are you waiting for any response?

mworion, 2024-10-05:
Hi Stefan,
the bot is automatically. I would close the issue if you did not have any further uses with it after the patch.
Michel

stefanZbinden, 2024-10-09:
Hi Michel
Ok, no problem! At the moment I am using the camera together with NINA and it works perfect also with the latest 3.2.6 version. However as soon as you provide the new beta version I will also try to use the camera directly attached to MW. Thanks for the great communication!
Stefan

Closed 2024-10-09.

Thread 365 (2024-08-17):

MW4 does not get images from SGPro

Cent74, 2024-08-17:
Hi there,

My camera is controlled via SGPro. When I take a "Expose 1" image in MW4, SGpro successfully takes the image and writes it to the MW4 folder.

However, the image does not appear in the MW4 "Imaging" window. The last error I see in the trace log is:

_Verification reported errors:
HDU 0:
    Card 34:
        Card keyword 'STRSZ1x1' is not upper case._

It worked for me in the past, but not anymore even though I'm not aware of any changes to my system (except an update of SGpro to the latest version).

Many thanks in advance for any advice!
[mw4-2024-08-17.log](https://github.com/user-attachments/files/16644109/mw4-2024-08-17.log)

Uli

mworion, 2024-08-17:
Hi Uli,
sorry to hear. It might be that SGPro did add some Header info in the FITS file and the used library does a hard compliance check.
To find out and to do a workaround on MW4 side, could you ZIP and post this Image from SGPro here ?
All attempts to provoke this header entry fails.
Many thanks.
Michel

Cent74, 2024-08-17:
Hi Michel,

I tried loading another image taken with the new SGpro version, and it worked. The image was displayed immediately.

However, when I then click "Expose 1", SPpro takes another picture, and the status windows above "Camera" in MW4 says "exposing" -> "download" - "saving" and stays there. The load button in Image is grayed out and the image window is not updated. If I then close the image window and reopen it, the new image appears. But I don't see image statistics under "statistics and formulae", nor does modelling work - it just hangs at the first image.

I'll attach one of the .fit files.

Many thanks for your support and best wishes,
Uli

[2024-08-17-09-00-46-exposure.zip](https://github.com/user-attachments/files/16644183/2024-08-17-09-00-46-exposure.zip)

mworion, 2024-08-17:
Hi Uli,

I made a beta build for you: 3.7.0b0 (could be installed through mw4 when enabling beta or any other method). This will bring you relaxed header checking. From what I can see is that many of the astronomy community sees header entries with lower cases as "wrong". The new entry is defined and by SGPro only. So from my point of view, they should correct this.
I did now a warn only and silent fix for that (going for upper case change).

Please report back if that works now.
(my old SGPro license - 3.x - does not write this entry)

Michel

Cent74, 2024-08-17:
Thanks Michel for the fast reply. Just to double check, I don't see a 3.7 beta, only a 3.2.7 beta. Is this the one you mean?
Uli

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

mworion, 2024-08-17:
Sorry it will be a 3.2.7b0

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

Cent74, 2024-08-17:
Yes, it works!!
So many thanks for your great support and the fantastic software you're writing!
Best wishes, Uli

mworion, 2024-08-17:
Closing it. solved with next release.

Closed 2024-08-17.

Thread 367 (2024-08-18):

Updates are not working

mworion, 2024-08-18:
### Discussed in https://github.com/mworion/MountWizzard4/discussions/366

<div type='discussions-op-text'>

<sup>Originally posted by **Jojo1703** August 17, 2024</sup>
Hello,
I have the problem that no more updates are being sent to the mount (GM3000). Satellites, comets, asteroids are not working. The earth rotation data cannot be updated either, see attachement. Version MW4 is the latest 3.2.7b0, mount is 3.1.10.
Everything was working properly a few months ago.
Is there a solution?
Regards
Jurgen
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
</div>

Jojo1703, 2024-08-18:
[mw4-2024-08-18.log](https://github.com/user-attachments/files/16649029/mw4-2024-08-18.log)
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

Hello Michel,

thank you very much for your help.
The Earth Rotation Update now works again, I don't know why but OK.
What doesn't work are the other updates for satellites, asteroids and comets. For example, if I select satellite, the update window for asteroids suddenly appears, but it gets stuck. For example, if I select update for asteroids, the window for comets appears and then hangs, see pictures.
Regarding your further question about the firmware: do you mean the mount update? I still have 3.1.10. I don't see any other possible version in the 10Micron forum either.

greeting
Jurgen

mworion, 2024-08-18:
Hi Jurgen,

I went back and forth. Still I see now the issue like you (TLE and comets running now). I have no clue what's happening in windows which leads to this way. In my setup (and I will offer a 3.2.7b1 for that later this evening), in asteroids it's opening the file selection, but speed is really, really slow.

What you could do: Interfere manually in the updater by selecting the "minorPlanets.mpc" file and finishing the dialog manually. This let's you update the data as the prep was already done.

With (hopefully) the upcoming firmware 3.1.15 ff (whenever 10micron will use them), I switch from this automation way to a direct communication to the mount. Hopefully from then on, these thing will be much easier (as 10micron offer also the web interface for manually choosing the files).

So from my knowledge there is no way for further improvements possible.
Michel

Jojo1703, 2024-08-19:
Hi Michel,
I was able to update my mount to 3.1.15 and now the updates for satellites, comets and asteroids seem to work, some of them run automatically.
But what surprises me is that, for example, a very old Epoch appears at ISS, see picture. However, a current file can be seen in the work/data directory.

greeting
Jurgen

    Am Sonntag, 18. August 2024 um 19:01:02 MESZ hat Michael ***@***.***> Folgendes geschrieben:

Hi Jurgen,

I went back and forth. Still I see now the issue like you (TLE and comets running now). I have no clue what's happening in windows which leads to this way. In my setup (and I will offer a 3.2.7b1 for that later this evening), in asteroids it's opening the file selection, but speed is really, really slow.

What you could do: Interfere manually in the updater by selecting the "minorPlanets.mpc" file and finishing the dialog manually. This let's you update the data as the prep was already done.

With (hopefully) the upcoming firmware 3.1.15 ff (whenever 10micron will use them), I switch from this automation way to a direct communication to the mount. Hopefully from then on, these thing will be much easier (as 10micron offer also the web interface for manually choosing the files).

So from my knowledge there is no way for further improvements possible.
Michel

—
Reply to this email directly, view it on GitHub, or unsubscribe.
You are receiving this because you commented.Message ID: ***@***.***>

|  | Virenfrei.www.avast.com |

mworion, 2024-08-19:
Hi Jurgen,
attachments of Email with reply are not included in the issue thread. You have to drop them on the web page. So I cannot see the image.
Michel

Jojo1703, 2024-08-19:
Hi Michel,
I was able to update my mount to 3.1.15 and now the updates for satellites, comets and asteroids seem to work, some of them run automatically.
But what surprises me is that, for example, a very old Epoch appears at ISS, see picture. However, a current file can be seen in the work/data directory.

greeting
Jurgen
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

mworion, 2024-08-20:
Jurgen,
strange.
Please close MW4, delete the file "stations.txt" in your work/data folder and restart MW4 again.
Michel

PS: Could you post the log file? You set MW4 to online, does it have also internet connection ?

Jojo1703, 2024-08-20:
Hi Michel,

success with Satellite Stations but e.g. 100 brightest doesn´t work. Only old datas are shown, see picture

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

and Yes I have always internet connection.

[mw4-2024-08-20.log](https://github.com/user-attachments/files/16679127/mw4-2024-08-20.log)

Bye
Jurgen

mworion, 2024-08-20:
Hi Jurgen,
it seems that the file entries in work/data went somehow corrupt. Please all "*.txt" files in this data folder as they will be newly generated then.
Michel

Jojo1703, 2024-08-21:
Hi Michel,

I have deleted all *.TXT files but without success with updates.
I have installed your new version 3.2.7b1 and then everything is OK. All updates were good.
Thanks again,

Jurgen

mworion, 2024-08-21:
Jurgen,
happy to hear. I do not know why. I leave it at this point. If anything happens again, please reopen the issue.
Michel

Jojo1703, 2024-08-22:
Hi Michel,

for your information, the updates don't always work, only sometimes, strange.
Something else, see picture: do you know which serial number has to be entered here?

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

greeting
Jurgen

mworion, 2024-08-22:
Jurgen I do not enter or see any serial number.
As you are on 3.1.15, would you mind to give an early v4.x a chance ?
You have to be on python 3.10 or later. If you would like to stay also with 3.2.7 this is the right way.
Please give me a hint. v4x handles the updates directly without any use of updater if you could see the web interface (please open a browser and enter the ip of the mount)
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
You might have to enable in the keypad the web services:
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

Michel

Jojo1703, 2024-08-22:
Hi Michel,

I have already used the update via the web interface but it behaved the same as with MW4.
Unfortunately I don't understand what you mean by version v4.x

greeting
Jurgen

mworion, 2024-08-23:
Hi Jurgen,
interesting. If you are saying it behaved like MW4, what do you mean.

My experience is that the 10micron updater (exe for windows, which you get if you install a new firmware) works, but automation of this process through MW4 sometimes sucks due to the “old way” of doing automation.

On the Web interface I saw sometimes glitches that the service went down after some time and you have to reboot the mount computer to restart the webservice for these updates again.
Both ways in firmware 3.1.15 are completely different ways to upload datan to the mount.

Different topic: actual MW4 version uses the first way of automating things to the mount, the next version of MW4 will make heavy use of the web interface. This means MW4 will download select and filter files from various sources and transfers them directly to the mount. You won’t see the web interface nor you need any other browser window. And downloading and transferring a set of asteroid data to the mount will take only a few seconds. But this way relies on a good working web interface on the mount side. Question would be if you are willing to test this.

Michel

Jojo1703, 2024-08-23:
Hi Michel,

what I meant by the same behavior on the web interface/MW4 is that the updates sometimes work for both, sometimes not.
The web interface doesn't always work for me either; it can't be started after entering the IP.
Of course I'm willing to do further tests if you tell me exactly what to do.

greeting
Jurgen

mworion, 2024-08-24:
Hi Jurgen,
thanks for the willingness to test (it is still an alpha !!!).
Prerequisite is python 3.9 - 3.12 on the computer (if you are willing to keep 3.x, please use python 3.10)
Choose a new workdir.
Copy the startup.pyz into the new work folder
Install alpha with
```
python startup.pyz --version 4.0.0a19
```
to install the alpha.
After that you could copy the config folder in your new working dir to avoid typing all data.
Starting is the same like old version, just
```
python startup.pyz
```
There will be still many thing to be changed, but it should hopefully work out of the box. Interesting will be the test for satellite, asteroids, comets and IERS deltaT data.

Michel

Jojo1703, 2024-08-26:
Hi Michel,

I tested it, all updates work as expected, excellent work.

 I noticed 2 things:

1. I miss an update option to see the well-known asteroids again, such as Ceres, Vesta, Pallas etc. How can they be restored? They were originally stored in the mount.

2. the virtual keypad doesn't look as nice as before, see picture.

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

greeting
Jurgen

mworion, 2024-08-26:
Jurgen,
yes, thats not finally worked through. the keypad i will check, should be not altered.
Michel

Jojo1703, 2024-08-26:
Michel,

I just see that the Keypad is like before

Jurgen

Jojo1703, 2024-08-31:
Michel,

I looked for asteroids again and found that the known brighter asteroids are not included in the Searching Asteroids lists, see the current visibility from today in the picture. I can't find these, for example IRIS or PALLAS, in any of the asteroid data lists offered by MW4.

Are there other lists?

Jurgen

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

mworion, 2024-09-02:
Hi Jurgen,I try to add an online search as well to MW4. So hopefully this makes the difference.Stay tuned.MichelAm 31.08.2024 um 21:03 schrieb Jojo1703 ***@***.***>:
Michel,
I looked for asteroids again and found that the known brighter asteroids are not included in the Searching Asteroids lists, see the current visibility from today in the picture. I can't find these, for example IRIS or PALLAS, in any of the asteroid data lists offered by MW4.
Are there other lists?
Jurgen
ast.JPG (view on web)

—Reply to this email directly, view it on GitHub, or unsubscribe.You are receiving this because you modified the open/close state.Message ID: ***@***.***>

Closed 2024-08-21.

Thread 369 (2024-09-06):

camera exposure is not finite

michael-jon, 2024-09-06:
**Describe the bug**
When using MW4, I try to take either a single exposure image or looping exposures.  The image doesn't change, and I am finding in the main screen the "exposing" message is constantly on.

**To Reproduce**
Steps to reproduce the behavior:
1. Start up MW4. Mount (GM2000 Combi) and Camera (QHY294M) turn green (camera is controlled by NINA).
2. Start modeling and bring up image tab, set exposure for both single and exposure N to 5.000 s
3. Push Exposure N, Main screen shows "exposing" and image does not change even if I manually move mount to determine if it is taking multiple images.
4. See error

**Expected behavior**
I expected a new image every 5 seconds so I could use control pad to move stars into "bullseye"

**Screenshots**
If applicable, add screenshots to help explain your problem.

**Desktop (please complete the following information):**
 - OS: Windows 11
 - Browser [e.g. chrome, safari]
 - Version [e.g. 22]

mworion, 2024-09-07:
Hi michael-jon,
could you paste the log file as well in this thread. Many thanks.
Michel

michael-jon, 2024-09-15:
[mw4-2024-09-06.log](https://github.com/user-attachments/files/17006500/mw4-2024-09-06.log)
[mw4-2024-09-09.log](https://github.com/user-attachments/files/17006501/mw4-2024-09-09.log)
[mw4-2024-09-10.log](https://github.com/user-attachments/files/17006502/mw4-2024-09-10.log)
[mw4-2024-09-13.log](https://github.com/user-attachments/files/17006503/mw4-2024-09-13.log)

Thank you for responding to my post/question. It took me a couple of days to figure out where the logs were saved and how to post them to this forum, so I am sorry for taking a few days to respond.  Thank you for any help you can offer me.
Best, mj

mworion, 2024-09-15:
Hi Michael-Jon,
no worries and sorry from my side as I did not say anything where to find the logs.
I had a first look to the log (still need some more time as I came back from vacation the evening)
- I see some timeouts in the communication to NINA. I guess you are running now v3 actual build correct (for checking the setup)
- I also recognized that you chose a setup to solve the image after the download. Did you intend this ?
-> Please uncheck this option in case or config a valid plate solver e.g. ASTAP as you might not have configured one already.
- In some cases NINA reports camera busy. I currently do not know why. This I have to evaluate why NINA sends this.

Michel

Closed 2024-10-21.

Thread 370 (2024-11-12):

Camera never completes exposure

nickym998, 2024-11-12:
Hi,

I am running Mount wizzard 4 3.2.6 on a windows 11 PC. I have used this for a long time but have recently switched to a new PC from a windows 10 machine. My camera is an ASI 1600 MM-cool which works fine but not under mount wizzard.  The camera connects via ASCOM 6.2 in the settings tab without issue.  When I start a modelling run, the camera begins exposure but never finishes the shot and I have to cancel the modelling run.  The camera also does not work if I use the imaging tab and try to take a single exposure. I then open NINA and connect to the same ASCOM driver and the camera functions perfectly.

Any ideas?

kind regards

Nick

mworion, 2024-11-14:
Hi Nick,

sorry to hear. Would you mind to post a log file and switch to the actual beta version which is 3.2.7b2. For updating check show beta in the updater tab.

Michel

nickym998, 2024-11-15:
Thanks Michel,

The update to beta seems to have solved the problem.  I will also attach logs.

many thanks

Nick
[mw4-2024-11-11.log](https://github.com/user-attachments/files/17775567/mw4-2024-11-11.log)
[mw4-2024-11-12.log](https://github.com/user-attachments/files/17775572/mw4-2024-11-12.log)

mworion, 2024-11-17:
Hi Nick,
thanks for the logs. It seems (out of the logs) you had a similar problem, for which I made the beta. Please let me know whenever you run into problems again and reopen the issue again. I will release this beta if there is no further problem upcoming.
Michel

Closed 2024-11-17.

Thread 371 (2024-11-27):

Unable to update MW4 from 3.2.6 to 3.2.7

WillB-2024, 2024-11-27:
Hi Michael.

This is non-urgent as I can work around by deleting the MW4 program folder and manually downloading the latest version when necessary and I have no pressing need to update MW4 at this time but is a mystery why I can't update MW4 from inside MW4 itself.

**Describe the bug**
On the observatory PC it is not possible to update MW4 except by deleting the startup folder and manually installing the latest version.

**To Reproduce**
Steps to reproduce the behavior:
1. Open MW4.
2. Click on Settings tab.
3. Click on Update, Logging tab.
4. Click "Enable download data and program files".
5. Check Updater display, Actual version = 3.2.6, Available version = 3.2.7.
6. Click "Start Updater" button.
7. MountWizard4 Updater window appears with "Update to version: [3.2.7]" displayed.
8. Click "Start Update" button.
9. MountWizard4 Updater window immediately closes and MW4 launches back to the "Update, Logging" tab with the original version 3.2.6 still installed as the actual version.
10. See attached error log created with Trace enabled.

**Expected behaviour**
On my other non-observatory PC MW4 Update works as expected.

**Desktop (please complete the following information):**
 - OS: Windows 11 PRO 24H2.
 - OS Build: 26100.2314.
 - OS Experience pack: 1000.26100.32.0.
 - OS Region: English UK.
 - Browser: Edge.
 - Browser version: 131.0.2903.70.

Hardware: OnLogic Helix 511 Industrial PC.
CPU: Intel Core i5-12600HL (Alder Lake) 2.7-4.5Ghz 12 Core Processor.
RAM: 32Gb DDR5 4800.
Primary Hard Drive: Transcend 1TB PCIe M.2 2280 NVMe.
Secondary Hard Drive: Transcend 1TB M.2 SATA SSD.

**Python version current: 3.9.13.

**Other Python versions tried: 3.10.11.

**Additional context**

The only AntiVirus and Firewall on this machine is Windows Defender and I have tried running the MW4 Updater with Windows Defender disabled and Windows UAC switched off but no change to the behaviour.

Kind regards.

William.

[mw4-2024-11-27.log](https://github.com/user-attachments/files/17935979/mw4-2024-11-27.log)

mworion, 2024-11-28:
Hi Will,
everything is OK. If you have actually no other application using python so far, you could try

```
python startup.pyz --clean
```

and try updating or downgrading again. It looks like a case that MW4 is also installed as system package a not only as user package in the virtual environment residing in "venv" folder. If you are updating MMW4 in this case, it updates correctly the user package, but still the system package has priority and throws an error. The command above cleans up the system package. Therefore I asked if you have some other python apps installed (beside MW4 any version), because their system packages would be deinstalled as well.

Hope this helps.

Michel

WillB-2024, 2024-11-29:
Hi Michael.

Thanks for the quick reply.

I ran the python "startup.pyz --clean" command from the MW4 directory but after that MW4 would not start at all.

I suspect that this problem may have been caused by installing Python and MW4 over a Microsoft Remote Desktop link and not while logged in as the local user of the observatory PC so last night I went out to the observatory and logged in locally, after backing up the MW4 config folder I deleted the installed Python platform, deleted the MW4 folder, removed the environmental path registry entries for Python and carried out a fresh install of Python 3.10.11 and MW4 v3.2.7.

After that I copied back the backup MW4 Config folder and started up MW4 again, this time I could roll back to MW4 v3.2.6 via the Updates and Logging tab and then after a reboot could update to v3.2.7 again, after which I ran a small "Golden Spiral" model of 25 points and polar aligned, followed by a full 96 point "Golden Spiral" model that resulted in a reported 23 arc-second Polar alignment error and 5 arc-second Otho align error, which is excellent for my needs.

So please mark this issue report as closed and if the problem reappears when you release MW4 v3.2.8 I'll get back in touch.

Thanks again Michael...

William.

Closed 2024-11-29.

Thread 373 (2024-11-30):

Clean Install

Tom-H3, 2024-11-30:
Here is the log (I hope) from my latest attempt to install MW4. When trying to rum MW, the icon popped up and then went away. The window showing DEC and AZ did not appear.
Tom

[mw4-2024-11-30.log](https://github.com/user-attachments/files/17967235/mw4-2024-11-30.log)

mworion, 2024-12-01:
That's a difficult one. It's the same crash of python as we had before. Give me some time.
Michel

WillB-2024, 2024-12-11:
Tom.

While Michel is thinking about how to diagnose the problem it might be worth just running a couple of Windows self-tests to ensure that your Windows environment is still sound after multiple attempts to install Python and MW4.

Open a command prompt with administrator rights, to do this type "**CMD**" (without the quotes) in the Windows desktop task bar search-box and in the pop-up search results pane mouse-right-click on "Command Prompt - System" and select from the context menu "**Run as administrator**".

If Windows UAC control is active you will be asked "Do you want to allow this app to make changes to your device?" answer with "**Yes**".

The Command Prompt window will open on the desktop, at the top frame of the CMD window it should state "**Administrator: Command Prompt**" if it just says "Command Prompt" without the preceding "Administrator" then the Command Prompt did not start with admin rights, if this is the case then at the prompt inside the window, **C:\Windows\System32>** type "**exit**" (without the quotes), hit enter to close the CMD window and try again to open the CMD window with Administrator rights.

Assuming you have managed to start the Command Prompt with Administrator rights then at the prompt **C:\Windows\System32>** type **sfc /scannow** (that is, "sfc" -space- -forward-stroke- "scannow", without the quotes) and hit enter to start the built in Windows file system check and repair tool.

On a system that has lots of files and apps the scan could take a while to complete, up to an hour or more, while the scan is running do not interact with PC, just watch the messages that appear in the CMD window and be aware that the process may appear to stall and not respond for long periods of time, just be patient and eventually you'll see a message saying scan complete.

At this stage there will be one of three messages similar to those below:

Scan complete, no errors found.
Scan complete, errors found and successfully repaired.
Scan complete, errors found that could not be repaired.

For the last message, "Scan complete, errors found that could not be repaired", you'll need to get further help from a Microsoft Windows technician, or do a clean install of Windows and your Apps.

For either of the first two messages, "Scan complete, no errors found" and "Scan complete, errors found and successfully repaired" you can run the second built-in Windows command to verify that the Windows O.S. itself is ok.

At the Command Prompt **C:\Windows\System32>** type the following string and hit enter to run the tool:

**dism /online /cleanup-image /restorehealth**

(that is "dism"-space- -forward-stroke-"online" -space- -forward-stroke- "cleanup-image" -space- -forward-stroke-"restorehealth", again, no quotes, those I only added for clarity of the text)

The DISM tool will check that all the Windows O.S. files are the correct versions and undamaged, any that it finds are damaged or the wrong versions will be automatically repaired.

When the DISM tool completes it scan (after quite some time) it will either display:

DISM completed successfully.
DISM completed successfully, repairs carried out, please reboot the computer.
DISM completed, errors found that could not be repaired.

For either of the first two messages, type at the Command Prompt **C:\Windows\System32>** "**exit**" (without the quotes) and hit enter to exit and close the Command Prompt Window then reboot the PC and try to start MW4.

For the last DISM message "DISM completed, errors found that could not be repaired" again indicates corruption of the hard drive and you would need help from a Microsoft technician, or as before, carry out a clean install of Windows and your Apps.

Both of the Windows command line tools, "sfc /scannow" and "dism /online /cleanup-image /restorehealth" are well documented on the web and if you do a google search for those commands you'll find loads of web pages and YouTube videos demonstrating them.

Even if the above tools do not resolve the MW4 startup problems by running them you can at least validate the Windows OS and the basic file system are both OK before looking elsewhere for the problems with MW4 startup.

HTH

Will.

Tom-H3, 2024-12-11:
Hi Will,
If I right-click in the cmd window I don't see an option to run as
administrator.
Regards,
Tom

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

--
Tom

Tom-H3, 2024-12-11:
I got it done:
Scans the integrity of all protected system files and replaces incorrect versions with
correct Microsoft versions.

SFC [/SCANNOW] [/VERIFYONLY] [/SCANFILE=<file>] [/VERIFYFILE=<file>]
    [/OFFWINDIR=<offline windows directory> /OFFBOOTDIR=<offline boot directory> [/OFFLOGFILE=<log file path>]]

/SCANNOW        Scans integrity of all protected system files and repairs files with
                problems when possible.
/VERIFYONLY     Scans integrity of all protected system files. No repair operation is
                performed.
/SCANFILE       Scans integrity of the referenced file, repairs file if problems are
                identified. Specify full path <file>
/VERIFYFILE     Verifies the integrity of the file with full path <file>.  No repair
                operation is performed.
/OFFBOOTDIR     For offline repair, specify the location of the offline boot directory
/OFFWINDIR      For offline repair, specify the location of the offline windows directory
/OFFLOGFILE     For offline repair, optionally enable logging by specifying a log file path

e.g.

        sfc /SCANNOW
        sfc /VERIFYFILE=c:\windows\system32\kernel32.dll
        sfc /SCANFILE=d:\windows\system32\kernel32.dll /OFFBOOTDIR=d:\ /OFFWINDIR=d:\windows
        sfc /SCANFILE=d:\windows\system32\kernel32.dll /OFFBOOTDIR=d:\ /OFFWINDIR=d:\windows /OFFLOGFILE=c:\log.txt
        sfc /VERIFYONLY

C:\Windows\System32>

_

Tom-H3, 2024-12-11:
I have no idea what all of the info means.
Regards,
Tom

Tom-H3, 2024-12-11:
I think I did not let the scan run long enough. I will do it again.
Tom

Tom-H3, 2024-12-11:
After about 30 minutes system32 has blinking underscore and scanning seems to have stopped.
Tom

WillB-2024, 2024-12-11:
Hi Tom

The list you are showing is just a list of possible options for the scannow tool, to run the tool in global test and repair you just type: **sfc /scannow** and hit enter and the tool will run with all options enabled.

If you just wanted to verify the Windows file system but not carry out any repairs you would type: **sfc /verifyonly**, etc.

For your case just use the full command **sfc /scannow** and then wait, it might take an hour or more to compete, when you start the scan you should see the message "Beginning system scan. This process will take some time"

If you don't see that message after typing sfc /scannow but just a flashing cursor at the prompt then the command you typed was not recognised and the prompt its waiting for you to enter the correct command.

Will.

Tom-H3, 2024-12-11:
Hi again Will,
I typed sfc/scannow at the blinking underscore and it now looks like the full scan is running.
Regards,
Tom

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

Tom-H3, 2024-12-11:
Hi Will,
This what I got from the scan:

C:\Windows\System32>sfc/scannow

Beginning system scan.  This process will take some time.

Beginning verification phase of system scan.
Verification 100% complete.

Windows Resource Protection found corrupt files and successfully repaired
them.
For online repairs, details are included in the CBS log file located at
windir\Logs\CBS\CBS.log. For example C:\Windows\Logs\CBS\CBS.log. For
offline
repairs, details are included in the log file provided by the /OFFLOGFILE
flag.

C:\Windows\System32>

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

--
Tom

Tom-H3, 2024-12-11:
I report a file repaired; does that mean I can get MountWizzard going now?
Tom

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

--
Tom

WillB-2024, 2024-12-11:
Hi Tom.

Go back for a review of the third post in this topic, the next thing to do after SFC completes successfully is to run the command from the administrator command prompt:

dism /online /cleanup-image /restorehealth

The dism command will now check that Windows itself is ok and that scan is usually just ten minutes or so.

When the dism tool completes ok then type "exit" to close the Command Prompt window and then reboot the PC, after the PC has rebooted you can try the MW4 startup again knowing that your Windows installation and C: drive file structure is ok and if MW4 still won't start then it's not a Windows corruption problem that is causing it.

Will.

mworion, 2024-12-12:
Hi Tom,

after all that hassle you had, if you are still willing to try more out, I would be happy to do some special builds for you by exchanging different libraries on python. My suspicion is that it is code from the QT library which might cause the topic. I do not know, why this happens on your computer, but that‘s an idea.
Michel

Tom-H3, 2024-12-12:
Here is what I got with the dism/online/cleanup-image/restorehealth

Error: 87

The online/cleanup-image/restorehealth option is unknown.
For more information, refer to the help by running DISM.exe /?.

The DISM log file can be found at C:\Windows\Logs\DISM\dism.log

C:\Windows\System32>

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

--
Tom

WillB-2024, 2024-12-12:
Hi Tom.

When typing the command string at the prompt watch that the spaces are entered correctly between the dism command and the command options otherwise the entire string won’t be recognised.

DISM is the command.
Online, Cleanup-Image and Restorehealth are the command options and the entire string must have only single spaces and forward-strokes used to separate the command from each of the additional options.

**dism /online /cleanup-image /restorehealth**

dism(space)/online(space)/cleanup-image(space)/restorehealth

Will.

Tom-H3, 2024-12-12:
I will try again with spaces; I know a command line is very sensitive'

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

Tom-H3, 2024-12-12:
Putting in the spaces worked and it reported the restoreheath was done.

Tom

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

Tom-H3, 2024-12-12:
Hi Michael,
Now that I have done the command line items I may be okay to try to get MounWizzard going, but first I need to get my focuser working properly. If I still can’t get Mountwizzard working I will get back to you. Thanks for the offer of extra help.
Regards,
Tom

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

Tom-H3, 2024-12-12:
Hi Will,
Things worked well after I put spaced into the command line and I rebooted. Now I need to sort out issues with my focuser and then I will be ready to try MounWizzard again.
Regards.
Tom

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

Tom-H3, 2024-12-15:
Hi Michael,
I am working on MountWizzard again and at the part that shows a folder with
PSTools,python and startup package.zip. I don't know where to get PSTools.
Regards,
Tom

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

--
Tom

mworion, 2024-12-15:
Hi Tom,

please go to https://github.com/mworion/InstallerMW4/releases and download the startup_package.zip file.

- put it in you new work folder (please make a new one)
- unzip it's content
- you only need startup.pyz to be kept in you work folder.
- there should be nothing in beside this file.
- I assume you had python 3.10 already installed
- on windows you should see in the file manager that startup.pyz is a file which is already linked to python (symbol).
- if so, please double click to install.

If you are at the point to install python first, please let me know.

Michel

mworion, 2024-12-15:
PS: No PSTools needed !

Tom-H3, 2024-12-16:
Hi Michael,
I followed your directions and MountWizzard still did not start.
Regards,
Tom

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

--
Tom

Tom-H3, 2024-12-16:
Hello again Michael,
Here is a screenshot of my directory structure, Maybe that will help.
Regards,
Tom

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

Thread 374 (2024-12-16):

ASTAP Wont Solve

FreeMeWat, 2024-12-16:
Title says it all. It was working, and for no good reason whatsoever, MW4 froze  up and would not work again. I can take an image, it shows up in the image tab, but it will not solve. ASTAP is installed. ASTAP works. But it will not solve. froze up several times.

mworion, 2024-12-16:
Hi,
would you mind to drop the log file of MW4 in this thread. Much appreciated
!
You find it in you work folder under /log
Michel

Gesendet mit der Telekom Mail App
<http://www.t-online.de/service/redir/emailmobilapp_ios_smartphone_footerlink.htm>

-----Original-Nachricht-----
Von: FreeMeWat ***@***.*** ***@***.***>
>
Betreff: [mworion/MountWizzard4] ASTAP Wont Solve (Issue #374)
Datum: 16.12.2024, 10:25 Uhr
An: mworion/MountWizzard4 ***@***.***
***@***.***> >
CC: Subscribed ***@***.***
***@***.***> >

Title says it all. It was working, and for no good reason whatsoever, MW4
froze up and would not work again. I can take an image, it shows up in the
image tab, but it will not solve. ASTAP is installed. ASTAP works. But it
will not solve. froze up several times.

—
Reply to this email directly, view it on GitHub
<https://github.com/mworion/MountWizzard4/issues/374> , or unsubscribe
<https://github.com/notifications/unsubscribe-auth/ABSTMFGPLZ5LGYBTA5ORQF32F2L7HAVCNFSM6AAAAABTVV7W3KVHI2DSMVQWIX3LMV43ASLTON2WKOZSG42DCOBRGYYTCMY>
.
You are receiving this because you are subscribed to this thread.Message
ID: ***@***.***>

FreeMeWat, 2024-12-16:
Hey Michal thank you for getting back to me! Ive had the mount for 4 days
and its been really a frustrating experience truly. I have not even been
able to use the mount one time. So my apologies, I'm just really at this
point quite annoyed as I really want to enjoy my new mount, but I can't
even make a model or polar align. :(

How do I get the logs? Thanks

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

FreeMeWat, 2024-12-16:
I do not see a work folder anywhere.

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

WillB-2024, 2024-12-16:
If it helps….

The “Work” folder that Michel refers to is the main MountWizzard4 program folder that you downloaded and unzipped to run MW4, if you look in the folder where the startup.pyz file is found then you’ll see the Log folder and inside that you’ll see dated logs files for each time you run MW4.

Find the log file for the most recent attempt when plate solve failed and attach it to your reply by clicking the “paper clip” symbol at the top of the reply window where you type your text.

HTH

Will.

FreeMeWat, 2024-12-16:
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

Sorry, it did not work. I looked and searched all through the directories and don't see a log folder anywhere. Perhaps its not saving them?

FreeMeWat, 2024-12-16:
Since you told me that folder wasn't there, and it should have been, this
led to me to think maybe something happened with the installation or
something. I'm not sure. I reinstalled it and now I have a LOG folder, so I
will try again tonight. As it was working for about 20 minutes before it
failed, so assuming it was just a glitch, I should be able to figure it
out. We shall see! Thanks

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

FreeMeWat, 2024-12-16:
I have everythign in the new install connected and saved, so just waiting for tonight. The picture taking and everything was working, just ASTAP stopped working halfway through PA.

Should I be using NINA to control the imaging? Is there a guide on this? Would it fix my issue if I ran into it again? Since NINA can platesolve. I couldn't find anything on the NINA implementation so I just went direct to ASCOM driver. Is this appropriate?

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

FreeMeWat, 2024-12-17:
My friends, it is working. Thank you kindly for pointing me in the right direction. For some reason. I think there was a problem with the install the first time, or when it crashed, something corrupted, because its working now!!! Thank you! I've had such a rough few days, this is such a welcomed development. <3
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

FreeMeWat, 2024-12-17:
Closing. Sorry for the extra comment, I dont know how else to do it. But thank you for this awesome tool.

Closed 2024-12-17.

Thread 377 (2025-02-19):

MW4 3.2.7 crashers on log rotation with Python Stack Trace

Ruediger3, 2025-02-19:
Hello Michl,

after a few hours MW4 crashes on log rotation 102 MB with a Python 3.8.6 Stack Trace. Please find the logs attached.
This problem is reproducible.

Regards
Rüdiger

[MW4-Log.zip](https://github.com/user-attachments/files/18875262/MW4-Log.zip)

mworion, 2025-02-22:
Hi Rüdiger,
I tried to reproduce this issue in my setup. Unfortunately I was not successful. I read some threads about logging issues in python 3.8, but I cannot state that there is any link to your observation.
So in any case if you run again in this issue, the recommendation would by to move to e newer python version as 3.8 is not more supported at all.
If you plan to change, 3.10 would be the actual way to install 3.2.7 as well as the upcoming 4.0 version (which starts from 3.10). If you could wait for 4.0 (still take some time), then I would update to python 3.12 and MW4 4.0.
Hope this helps,
Michel

Ruediger3, 2025-02-22:
Hello Michl,

Thanks for the reply. MW crashed in all sessions after running many hours. It happened always and I observed it now for more than 8 sessions.

I will upgrade python to 3.10. I have always a bit trouble to identify which version is currently compatible with MW. 😵‍💫

Looking forward to V4.

Thanks again!

Cheers
Rüdiger

mworion, 2025-02-22:
Hi Rüdiger,
Thanks for the hint. I'll try to make this more clear in the documentation.
Michel

Ruediger3, 2025-02-26:
Hi Michel,

I updated to 3.10.11 but MW wont start anymore.
install.log:

install script version 2.4
checking environment and start script
variable T has value of Python 3.10.11
variable P_VER has value of
no valid python version installed

Ruediger3, 2025-02-26:
Hi Michel,

I have done a fresh install and that fixed it. No further help needed :)

Cheers
Rüdiger

mworion, 2025-02-26:
Rüdiger thanks for the feedback !

Closed 2025-02-22.

Thread 380 (2025-04-17):

ASCOM camera connection

tremayne823, 2025-04-17:
Hi Michel,
I recently had a hard drive fail on my laptop so have had to re install mw4 which works fine.
I am however having a problem connecting my Starlight xpress trius 694 camera. The camera works fine with Maxim dl and I have ASCOM platform 7 plus the Brett McKee driver for this camera. I do not use SGT or NINA so previously the connection was made using the ASCOM link but now I am not seeing the camera on the ASCOM properties drop down list for connection. Can you think of anything I am do in wrong please?
Thank you
Richard Wills

mworion, 2025-04-18:
Hi Richard,
I understand, you had this up and running before? If so, please set the log level of MW4 to Trace (Settings Tab) and try to connect the camera. Please drag the log afterwards to this issue.
Ideas:
- ASCOM7 caused in some cases more troubles than ASCOM6, so I heared (not related to MW4) that ASCOM users went back to ASCOM6.
- Please try the ASCOM diagnosis to connect to this camera and check if that works.
- Did you try to do all setting in the ascom chooser (via MW4 devices setup)
- Did you try to manually connect ?

But as I said, please drag the log (you might do the actual as well, perhaps there is already something visible in there.
Michel

tremayne823, 2025-04-18:
Good morning Michel,Thanks for your reply. I had a suspicion the problem might be ASCOM7 related so I will follow your instructions and hopefully get things up and running again.At the moment I am using my C14 edge and in the past have found model building a challenge. Yesterday I downloaded the D80 star database for ASTAP which I hope will improve the success rate with fewer failed points. I do 10 second exposures so I think the failures were due to lack of reference stars. No problems with my TSA 120 as everything works like a dream.Thanks again for all the time and effort you put into helping us with your Mountwizzard program.Richard

Sent from the all-new AOL app for iOS

On Friday, April 18, 2025, 8:05 am, Michael ***@***.***> wrote:

Hi Richard,
I understand, you had this up and running before? If so, please set the log level of MW4 to Trace (Settings Tab) and try to connect the camera. Please drag the log afterwards to this issue.
Ideas:

   - ASCOM7 caused in some cases more troubles than ASCOM6, so I heared (not related to MW4) that ASCOM users went back to ASCOM6.
   - Please try the ASCOM diagnosis to connect to this camera and check if that works.
   - Did you try to do all setting in the ascom chooser (via MW4 devices setup)
   - Did you try to manually connect ?

But as I said, please drag the log (you might do the actual as well, perhaps there is already something visible in there.
Michel

—
Reply to this email directly, view it on GitHub, or unsubscribe.
You are receiving this because you authored the thread.Message ID: ***@***.***>
mworion left a comment (mworion/MountWizzard4#380)
Hi Richard,
I understand, you had this up and running before? If so, please set the log level of MW4 to Trace (Settings Tab) and try to connect the camera. Please drag the log afterwards to this issue.
Ideas:

   - ASCOM7 caused in some cases more troubles than ASCOM6, so I heared (not related to MW4) that ASCOM users went back to ASCOM6.
   - Please try the ASCOM diagnosis to connect to this camera and check if that works.
   - Did you try to do all setting in the ascom chooser (via MW4 devices setup)
   - Did you try to manually connect ?

But as I said, please drag the log (you might do the actual as well, perhaps there is already something visible in there.
Michel

—
Reply to this email directly, view it on GitHub, or unsubscribe.
You are receiving this because you authored the thread.Message ID: ***@***.***>

tremayne823, 2025-04-18:
Hello again Michael,In the ASCOM chooser the camera connects with "JUSTAHUBCAMERA". Prior to this I tried setting log level to trace but made no difference and SX camera did not appear in the ASCOM chooser.I carried out ASCOM diagnosis but that didn't help.I have a Moonlite focuser which connects as OMNISIMFOCUSER in the ASCOM chooser.The Filter connects as SXUFW filter wheel.All devices are now showing green.I can turn camera temperature on or off but I can't alter the setting which goes straight  to -10 degs C.The SX camera works fine in Maxim dl if that is what you mean by manually connect?Before I do anything else I am sending you these results but I am tempted to delete ASCOM 7 and revert back to version 6.
I am not clear about dragging the log and actual into ISSUE but if you could elaborate I will do so.Happy EasterKind regardsRichard 
    On Friday 18 April 2025 at 08:05:46 BST, Michael ***@***.***> wrote:

Hi Richard,
I understand, you had this up and running before? If so, please set the log level of MW4 to Trace (Settings Tab) and try to connect the camera. Please drag the log afterwards to this issue.
Ideas:

   - ASCOM7 caused in some cases more troubles than ASCOM6, so I heared (not related to MW4) that ASCOM users went back to ASCOM6.
   - Please try the ASCOM diagnosis to connect to this camera and check if that works.
   - Did you try to do all setting in the ascom chooser (via MW4 devices setup)
   - Did you try to manually connect ?

But as I said, please drag the log (you might do the actual as well, perhaps there is already something visible in there.
Michel

—
Reply to this email directly, view it on GitHub, or unsubscribe.
You are receiving this because you authored the thread.Message ID: ***@***.***>
mworion left a comment (mworion/MountWizzard4#380)
Hi Richard,
I understand, you had this up and running before? If so, please set the log level of MW4 to Trace (Settings Tab) and try to connect the camera. Please drag the log afterwards to this issue.
Ideas:

   - ASCOM7 caused in some cases more troubles than ASCOM6, so I heared (not related to MW4) that ASCOM users went back to ASCOM6.
   - Please try the ASCOM diagnosis to connect to this camera and check if that works.
   - Did you try to do all setting in the ascom chooser (via MW4 devices setup)
   - Did you try to manually connect ?

But as I said, please drag the log (you might do the actual as well, perhaps there is already something visible in there.
Michel

—
Reply to this email directly, view it on GitHub, or unsubscribe.
You are receiving this because you authored the thread.Message ID: ***@***.***>

tremayne823, 2025-04-20:
Michael,
I have dragged some logs into the add files clip below.
I hope you can see them.
Richard

mworion, 2025-04-20:
Hi Richard, unfortunately it did not work.

tremayne823, 2025-04-22:
Hi Michel
Can you look again in files for my trace log?
Thanks
Richard

mworion, 2025-04-23:
Hi Richard,
still no logs here. When opening this issue in a browser, please drag them into the editor window of your response.
You also might put them to a cloud storage of your choice and send me the link for it. Then I will download it.
Michel

mworion, 2025-04-24:
Richard,
I found the issue: The name of the camera is for some reason wrong. Therefore some questions:

ASCOM devices show up with a naming:
```
ASCOM.MoonliteDRO.Focuser
```
like it did with your focuser.
The starlight camera shows up in this style:
```
Starlight xpress
```
which does not match the ASCOM namespace. MW4 could not find a device with this name in the interfaces.

- So how did you select the name of the camera (chooser ?)
- How does the name of the camera show up if you are using the ASCOM Diagnosis ?

I will try an check if ASCOM7 chooser changed the name handling and if I have to adopt somehow. What makes me scratching the head is that all other ASCOM devices show up quite normally.

- Do you know if somebody could install and the Starlight Express driver without having a camera attached ?
- Could you provide the driver to countercheck it's behavior on this case ?

Michel

tremayne823, 2025-04-24:
I will check all these things and get back to you Michel.ThanksRichard

Sent from the all-new AOL app for iOS

On Thursday, April 24, 2025, 9:43 am, Michael ***@***.***> wrote:

mworion left a comment (mworion/MountWizzard4#380)
Richard,
I found the issue: The name of the camera is for some reason wrong. Therefore some questions:

ASCOM devices show up with a naming:
ASCOM.MoonliteDRO.Focuser

like it did with your focuser.
The starlight camera shows up in this style:
Starlight xpress

which does not match the ASCOM namespace. MW4 could not find a device with this name in the interfaces.

   - So how did you select the name of the camera (chooser ?)
   - How does the name of the camera show up if you are using the ASCOM Diagnosis ?

I will try an check if ASCOM7 chooser changed the name handling and if I have to adopt somehow. What makes me scratching the head is that all other ASCOM devices show up quite normally.

   - Do you know if somebody could install and the Starlight Express driver without having a camera attached ?
   - Could you provide the driver to countercheck it's behavior on this case ?

Michel

—
Reply to this email directly, view it on GitHub, or unsubscribe.
You are receiving this because you authored the thread.Message ID: ***@***.***>

tremayne823, 2025-04-24:
Michel,
I have finally managed to connect my StarlightXpressH694 camera to MW4.
I deleted all camera hardware and drivers and re-installed everything.
The correct SX camera driver is 1.3.8.3 which came with the camera on a memory stick.
The crucial ascom driver is 6.3.1.23042 by Bret McKee which is found in ascom drivers and downloads under Starlight Xpress.
I am very grateful for your help and sorry for all the confusion sending logs.
I will try to send you the actual log now that everything is running correctly
Richard

tremayne823, 2025-04-25:
Hi Michel,Good advice, I will set to debug. I have learned a lot about MW since having to reinstall everything. Nice to start with a clean slate on the computer too.Thanks again.Richard

Sent from the all-new AOL app for iOS

On Thursday, April 24, 2025, 3:48 pm, Michael ***@***.***> wrote:

mworion left a comment (mworion/MountWizzard4#380)
Richard,
great to hear that you made the connection! You're welcome. My expectation is no surprise in the logs after your reinstall.
If everything works, please set the log level back to debug. Otherwise you will have a really heavy logging, which might cause unneccessary memory and performance load.
Michel

—
Reply to this email directly, view it on GitHub, or unsubscribe.
You are receiving this because you authored the thread.Message ID: ***@***.***>

mworion, 2025-04-25:
Richard,
closing it, if anything comes up again, please reopen. Have fun!
Michel

Closed 2025-04-25.

Thread 384 (2025-07-19):

Update for Satellite not working

mworion, 2025-07-19:
### Discussed in https://github.com/mworion/MountWizzard4/discussions/383

<div type='discussions-op-text'>

<sup>Originally posted by **Jojo1703** July 13, 2025</sup>
Hi all,
I've updated the satellites several times, and it seemed to run automatically, but the data isn't updated, see image. The data here is about two years old.

What's going wrong?

Regards

Jurgen

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

[mw4-2025-07-13.log](https://github.com/user-attachments/files/21205581/mw4-2025-07-13.log)
</div>

mworion, 2025-07-19:
Hi Jürgen,
I created an issue out of this case. Many thanks for the log. For some reasons data can't be processed by the underlying library. I check how I could make a release with a workaround to this topic.

Michel

mworion, 2025-07-19:
First other check and please give a try:
Stop MW4
The download timeout is set to 3 seconds, which could be in some cases too short. To test this an remove all old data, please delete any *.txt file in your <workdir>/data folder. Then start MW4 again and check if the data is updated.

Michel

mworion, 2025-07-19:
Hi Jürgen,

that‘s exactly what should happen. But to clearify: you get the aged data
displayed despite the fact, that visuals.txt was updated ?

Michel

Gesendet mit der Telekom Mail App
<http://www.t-online.de/service/redir/emailmobilapp_ios_smartphone_footerlink.htm>

-----Original-Nachricht-----
Von: Jojo1703 ***@***.*** ***@***.***>
>
Betreff: Re: [mworion/MountWizzard4] Update for Satellite not working
(Issue #384)
Datum: 19.07.2025, 15:22 Uhr
An: mworion/MountWizzard4 ***@***.***
***@***.***> >
CC: Michael ***@***.***
***@***.***> >, Author <
***@***.*** ***@***.***> >

Jojo1703 left a comment (mworion/MountWizzard4#384)
<https://github.com/mworion/MountWizzard4/issues/384#issuecomment-3092349894>

Hi Michel,

I've updated the satellites and only visual.txt and CDFLeapseconds.txt are
updated in /data folder, nothing else.

Bye

Jurgen

—
Reply to this email directly, view it on GitHub
<https://github.com/mworion/MountWizzard4/issues/384#issuecomment-3092349894>
, or unsubscribe
<https://github.com/notifications/unsubscribe-auth/ABSTMFDAW5DIC3M47GYIYJL3JJBCFAVCNFSM6AAAAACB4QZHT6VHI2DSMVQWIX3LMV43OSLTON2WKQ3PNVWWK3TUHMZTAOJSGM2DSOBZGQ>
.
You are receiving this because you authored the thread.Message ID:
***@***.***>

Jojo1703, 2025-07-21:
Hi Michel,

now the datas are updated for Satellite Stations right after the start MW4 automatically.
But when I make other updates e.g. 100 brightest Satellites I will see old datas.

Bye

Jurgen

mworion, 2025-07-22:
Hi Jürgen,

I‘ll try to build a test version for you with extended timeout and special
logging to understand the issue you have. Once build, I‘m coming back how
to use it.

Michel

Gesendet mit der Telekom Mail App
<http://www.t-online.de/service/redir/emailmobilapp_ios_smartphone_footerlink.htm>

-----Original-Nachricht-----
Von: Jojo1703 ***@***.*** ***@***.***>
>
Betreff: Re: [mworion/MountWizzard4] Update for Satellite not working
(Issue #384)
Datum: 21.07.2025, 23:37 Uhr
An: mworion/MountWizzard4 ***@***.***
***@***.***> >
CC: Michael ***@***.***
***@***.***> >, Author <
***@***.*** ***@***.***> >

Jojo1703 left a comment (mworion/MountWizzard4#384)
<https://github.com/mworion/MountWizzard4/issues/384#issuecomment-3099223941>

Hi Michel,

now the datas are updated for Satellite Stations right after the start MW4
automatically.
But when I make other updates e.g. 100 brightest Satellites I will see old
datas.

Bye

Jurgen

—
Reply to this email directly, view it on GitHub
<https://github.com/mworion/MountWizzard4/issues/384#issuecomment-3099223941>
, or unsubscribe
<https://github.com/notifications/unsubscribe-auth/ABSTMFHNICGRLLFHBD3ZBDL3JVMQFAVCNFSM6AAAAACB4QZHT6VHI2DSMVQWIX3LMV43OSLTON2WKQ3PNVWWK3TUHMZTAOJZGIZDGOJUGE>
.
You are receiving this because you authored the thread.Message ID:
***@***.***>

Closed 2025-08-28.
