mworion/MountWizzard4/(commit log)

2021-10-05 update wheels
2021-10-08 refactor mount tab and enable LOC setting with mount off
2021-10-10 remove explicit button press and added stylesheet
2021-10-10 accept stdout for print in logger
2021-10-16 added sort AZ feature as threaded version
2021-10-21 refactor camera exposure
2021-10-30 adding color change to device popup as well
2021-11-04 added mount host change detection
2021-11-09 correct wheels build
2021-11-13 correcting script as prebuild wheels are linux not manylinux
2021-11-13 fix keypad button press events
2021-11-20 avoid double logging for release mouse button
2021-11-20 refactor indi camera
2021-12-02 added trace to threaded class
2021-12-02 avoid changing header dict in thread
2021-12-03 adding camera temp to measure
2021-12-03 test wheels
2021-12-03 [automated commit] add wheels generated by GitHub workflow
2021-12-04 check wheels
2022-01-02 added test for cameraSGPro
2022-01-03 added N.I.N.A. camera
2022-01-05 update naming app controleed device
2022-01-05 driver fix
2022-01-05 implement abort image when camera disconnects
2022-01-06 optimise filter settings for sats
2022-01-09 add docs for app camera
2022-01-12 making a quick fix for App controlled camera
2022-01-14 update tests and styles for controlled camera
2022-01-22 fix activating the right tab in devicepopup
2022-01-23 shift telecopt driver to optic data into acessories
2022-01-23 naming ASTROMETRY -> PLateSolver
2022-01-30 switch test
2022-02-01 switch from line edit to qspinbox
2022-02-01 disable park pos buttons if no text is set
2022-02-01 show max number of threads
2022-02-05 write voltage and current with two digits
2022-02-06 refactor coordinate mount to image
2022-03-05 switched almanac
2022-03-12 added option UTC / Local time for sat track
2022-04-01 adding sound for mount up
2022-04-01 adding sound for sat start track
2022-04-22 fix mount in southern hemisphere #235
2022-04-24 make radio button look round
2022-05-01 fix device selection error
2022-05-19 reduce trace load
2022-05-21 fix model stall in normal mode
2022-05-25 optimize flow
2022-05-26 check alert message in indi camera
2022-05-28 add status to on / off buttons
2022-05-29 switch park to xyab
2022-06-01 move clock sync gui from misc to mount
2022-06-04 refactor imaging mount and stas settings
2022-06-05 update wheels generation
2022-06-05 add correct wheel
2022-06-05 cleaned up wheels
2022-06-05 added frame rate and source selection
2022-06-09 refactor onlineWeather as prototype for meteoblue driver
2022-06-14 remove print
2022-06-15 fix online device states
2022-06-17 improved logging in threads
2022-06-25 correcting solve button logic
2022-07-08 changed presence of virtual stop to real buttons
2022-07-08 added enable / disable dome with device connect
2022-07-26 refactor and clean online thread status
2022-08-02 adding arm
2022-08-08 remove unused HID devices
2022-08-14 adjust not loading the driver
2022-08-15 fix for alpaca devices
2022-08-15 add light frame on splash screen
2022-08-15 added driver for direct weather
2022-08-16 change clock sync to radio buttons
2022-08-17 added writing filter name in fits header
2022-08-17 refactor drivers data as separate dict
2022-08-18 improved color and disabled radio button
2022-08-19 improved gui all input fields should hav a frame
2022-08-19 removed need of defining rtsp:// for video and restart after new framerate
2022-08-20 refactor profile GUI, move TUC to mount tab
2022-08-23 split relay and made it context sensitive
2022-09-01 start mount simulator
2022-09-04 removed push to mount manually,
2022-09-12 adding test case
2022-09-13 update FOV to 30 and add running state to platesolvesync
2022-10-01 fix issue with start timer
2022-10-07 refactor move to mount and fix tests
2023-01-06 add debug log for camera props
2023-01-22 remove wheel ci
2023-01-27 update frameworks
2023-01-29 adjust toggle of radio button correct
2023-02-11 rename Flip Flat to cover Calibrator
2023-02-24 refactor and address #301 for large image sensors
2023-03-11 improve startup speed for indi if no device is present
2023-08-25 adding doc for mount settle
2023-08-28 cleanup internal devices and remote server
2023-08-28 improve device handling for robustness
2023-08-28 cleanup driver stop starting when changing profile
2023-08-29 fix test devices
2023-08-29 simplify drivers and remove deepdiff
2023-08-29 minor UI changes in mount settings and video windows
2023-09-06 improve check platesolver
2023-10-15 improve ascom / alpaca state for tuptek drivers
2023-10-22 correct order of video buttons (1-4)
2023-12-14 rollback ASCOm driver changes
2023-12-23 correct polling_period in indi environment drivers
2023-12-28 fix parameter in program to mount
2023-12-28 fix missing bracket in log
2023-12-28 add missing bracket
2023-12-28 pin pyqt5-sip to avoid depreciation message
2024-01-03 adding Uranus also to sensor weather and add tests
2024-01-05 change loopback device from localhost to 127.0.0.1
2024-01-07 add test and remove event filter for tooltips
2024-05-10 adding upload to mount popup
2024-05-12 extending enable / disable programming related to mount status
2024-05-28 update 3d world
    [dome-base.stl, dome-environ.stl]
2024-05-29 adjust materials
2024-06-11 updates materials #1
2024-06-13 remove setup material
2024-06-16 added icon und bugfix
2024-06-30 remove unnecessary print
2024-07-03 enable mountcontrol
2024-07-06 refactor direct weather to driver only
2024-08-21 refactor mountcontrol
2024-08-22 optimize startup mount
2024-08-27 correct starting of ascom and alpaca devices
2024-08-28 moved more to skyfield Angle for all data relating the mount
2024-09-09 update import class camera
2024-09-09 checked device popup
2024-09-12 first iteration refactoring plateSolve
2024-09-15 cleanup improvements camera and platesolve
2024-09-16 cleanup improvements tes camera
2024-09-18 fix function call missing brackets
2024-09-29 added mount status check
2024-12-01 activated some warnign filters
2024-12-07 added check for traceroute
2024-12-07 update tests for platesolve
2024-12-07 correct mountcontrol
2024-12-20 extend wait threading end
2024-12-27 cleanup devicePopup
2024-12-27 cleanup platesolve
2024-12-27 implemented sync mount to image center
2024-12-29 adding 4. theme and adding 3d efect to buttons
2025-02-08 fix mount stat and gui elements
2025-03-01 cleanup filter
2025-04-16 update to python 3.13 und update docs
2025-05-09 start driver after change
2025-05-10 cleanup device popup
2025-05-17 remove frames around QlineEdit
2025-05-17 cleanup frames
2025-05-18 cleanup with mutex on threadpool
2025-08-04 rework interfaces to driver
2025-08-04 cleanup test for new driver interface
2025-08-04 correct devicePopup interface to transport device class for reference
2025-08-04 adding device type
2025-08-30 add missing brackets
2025-10-03 correct import
    [dome-base.stl, dome-column.stl, dome-door1.stl, dome-door2.stl, dome-floor.stl, dome-rose-char.stl, dome-rose.stl, dome-slit1.stl]
2025-10-03 remoce threadpool waiting as it is not there
2025-10-04 change source layout
    [dome-base.stl, dome-column.stl, dome-door1.stl, dome-door2.stl, dome-floor.stl, dome-rose-char.stl, dome-rose.stl, dome-slit1.stl]
2025-10-05 final project layout
    [dome-base.stl, dome-column.stl, dome-door1.stl, dome-door2.stl, dome-floor.stl, dome-rose-char.stl, dome-rose.stl, dome-slit1.stl]
2025-11-02 cleanup pointer, coloring buttons
2025-12-06 fixed waiting time for mount settling
2025-12-09 update mount up behavior and status
2025-12-09 adding boltwood environment
2025-12-14 adding first test for boltwood
2026-01-03 get downloads for data threaded
2026-01-05 cleanup camera and platesolve signals
2026-01-08 optimize sat filter interface
2026-01-09 refactor list generation to ui thread
2026-03-13 adding todo for write camera
2026-04-07 move to internal data structure
    [dome-base.stl, dome-column.stl, dome-door1.stl, dome-door2.stl, dome-floor.stl, dome-rose-char.stl, dome-rose.stl, dome-slit1.stl]
2026-04-07 remove resource system
    [dome-base.stl, dome-column.stl, dome-door1.stl, dome-door2.stl, dome-floor.stl, dome-rose-char.stl, dome-rose.stl, dome-slit1.stl]
2026-04-08 clean point test
    [dome-base.stl, dome-column.stl, dome-door1.stl, dome-door2.stl, dome-floor.stl, dome-rose-char.stl, dome-rose.stl, dome-slit1.stl]
2026-04-08 fix thread for satellite calcs
2026-04-10 Update clean_workflow_logs to keep last 5 runs and add weekly schedule
    Agent-Logs-Url: https://github.com/mworion/MountWizzard4/sessions/e0125efa-efa6-4866-97e0-15071be8da5a
2026-04-12 adding annotation for mountcontrol
2026-04-20 improved indi camera
2026-04-28 change behaviour: stop driver when opening the popup
2026-05-02 added output to message board
2026-05-02 improved architecture with device registry
2026-05-13 revise unit tests for ascomClass and alpacaClass
    Agent-Logs-Url: https://github.com/mworion/MountWizzard4/sessions/c9c97fba-19ef-4d9d-8672-72697481e047
2026-05-18 refactor: extract AlpacaAscomCommon base class
    [astrometry.cfg, measure-2021-12-31-23-58-51.csv, test.csv, test_horizon_2.csv]
2026-05-18 make camera run
2026-05-19 refactor nina / sgpro also for camera
2026-05-21 update tests
    [astrometry.cfg, test.csv]
2026-05-23 implemented exposeN for devices which could not abort
2026-05-23 added alpaca for all other devices
2026-05-26 refactor trace and logging
2026-05-26 fix indi discover show button status
2026-05-28 improve mountcontrol
2026-05-28 rework mountcontrol package
2026-05-29 plate solver astap
2026-06-03 refactor device registry
2026-06-05 remove legacy deviceRegistry parts
2026-06-05 go for shortcuts in deviceRegistry
2026-06-06 remove framework property from shortcut
2026-06-08 refactor deviceRegistry
2026-06-08 next step refactor devices
2026-06-08 move devicePopup further
2026-06-22 Signals inherence from device also for mount
2026-06-22 remove start/stop Devices signals as they are not needed
2026-06-22 removed mount internal dome
2026-06-24 optimise drivers, make hid controller dynamic
2026-06-27 cleanup deviceRegistry
2026-06-28 fix measure device
2026-06-28 make default button visible
2026-07-09 refine mount setting location gui
2026-07-15 cleanup timers
2026-07-15 move from socket to QTcpSocket
2026-07-18 changed order of device start to catch signals deviceConnected
2026-07-22 improve mount move
2026-07-29 Fix ASCOM driver selection crashing in DevicePopup
    DevicePopup.selectAscomDriver constructed AscomClass with `self.parent`
    (Qt's bound QObject.parent method) and referenced `self.deviceType`,
    which DevicePopup does not define. Either raises immediately, so the
    ASCOM chooser never opens and no ASCOM device (camera, focuser, filter
    wheel, weather, dome, ...) can be selected.
    Make AscomClass.selectAscomDriver a classmethod, since it only needs the
    class logger, and call it directly instead of constructing a driver
    instance. Resolve the device type from the device registry, matching the
    existing discoverDevices() code path.
    Fixes #413
2026-08-01 add mising state changes for mount status
2026-08-04 including SGPro camera
2026-08-07 reduced time for sync with mount
2026-08-08 fix camera as we had a missinf inheritence
2026-08-08 fix DEVICE_TYPE in alpaca devices
2026-08-09 cleanup coloring messages and button sizes
2026-08-14 cleanup status mount
2026-08-14 update nina camera config
2026-08-21 improved sat filtering in terms of speed
2026-08-21 fix platesolver issues in path
2026-08-23 cleanup threading concern
2026-09-11 correct mutex only on finished signal which is there in any case
2026-09-11 correct the initialisation 1st step for rpofile switching
2026-09-11 update window behavior during profile switch. I had to cleanup the widget Destroying part
2026-09-12 update to handle worker thread. mutex is now fixed build in.
2026-09-12 update to handle worker thread. next step
2026-09-15 next step thread update
2026-09-15 improve threading
2026-09-15 fix threading
2026-09-16 review threading and tuning
2026-09-22 remove copyConfig as in Alpaca there is a device discovery
2026-09-23 improve interfaces for devicePopup
2026-09-26 role back the threading for device discovery as the AI refactoring went wrong.
2026-09-30 cleanup test hook device registry
2026-10-03 fix camera exposing signals twice
2026-10-03 extend logging for camera
2026-10-05 adding duration logging in case of performace issues
2026-10-08 fix potential device by zero case
2026-10-11 improve WOL computer, startup procedure if mount not available
2026-10-23 update passes when mount constraints are loaded
2026-10-25 remove brackets and add logging for start slewing
2026-10-25 fix brackets and formatting
2026-10-25 cleanup for camera
2026-11-11 Mountcontrol: priority link worker, chunked bulk with progress signals
2026-11-11 Phase 3: merge time-state polling, failure-based mountIsUp, split settings batch
2026-11-11 Poll static mount settings on a slow cycle
2026-11-11 mountcontrol: Phase 4 telemetry cache, cyclic coalescing, link counters
2026-11-11 Record real mount results for Phase 5
2026-11-11 Re-emit mountIsUp while mount is up so GUI status stays in sync
2026-11-11 Mountcontrol: restore Sending/Response trace logging in connection
2026-11-11 Fix pyrefly errors in mountLink and obsSiteCommands
2026-11-14 move from debug to trace
2026-11-14 fix trace
